jeff-engineers/dustgate/docs/tool-sensing-rfc.md

# Tool sensing & collector switching — design doc

**Status:** decided 2026-09-03, **nothing bench-tested.** Sensor plugs ordered;
everything else is reasoning from datasheets and product pages, not from a meter
in this shop. Revised the same day, twice: the collector's switching hardware was
going to be a contactor we built and isn't (§4.2, §13), and the remote's band,
encoder, address and button count are now known rather than assumed (§4.2).
**Covers:** how the firmware learns a tool is running, and how the collector is
switched, now that a smart plug can do neither for a large machine.
**Companion docs:** [`outlet-discovery-provisioning.md`](outlet-discovery-provisioning.md)
(the Shelly discovery/claim path this extends), [`shop-schema-rfc.md`](shop-schema-rfc.md)
§7 (collector health), [`architecture-rfc.md`](architecture-rfc.md) (the node contract).
Any API/model surface added here goes through the canonical-model + conformance
discipline in [`../shared/device-model/README.md`](../shared/device-model/README.md).

---

## 1. Motivation

A 1HP 120V dust collector trips the overpower protection on a Shelly Plus Plug
US. That is not an edge case — it is the *first* real machine this system was
pointed at, and every other large tool in the shop will do the same. The plug
has been the only sensor and the only switch since v1, so a plug that cannot
hold a motor invalidates both halves of the design at once.

## 2. What actually broke

Worth being precise, because the obvious diagnosis leads to the wrong fix.

The Plus Plug US is rated 15A / 1800W. **MEASURED 2026-09-09 with an inrush
clamp meter: 10 A running, ~50 A inrush.** (This section said "roughly 13A" until
then — a guess, and pessimistic.)

So 10 A continuous is comfortably inside the plug's rating, not the marginal
figure the guess implied. What trips it is **inrush**: 50 A is 5× the running
current and **3.3× the plug's entire rating**, for a few hundred milliseconds at
startup. That is locked-rotor current, and it is textbook for an induction
motor.

The overpower protection that catches this exists to protect **the relay
contacts**. Contacts are the fragile part of a smart plug: they arc on make,
they erode, and making into locked-rotor current welds them. The trip is the
device defending its own weakest component.

Two consequences follow, and both are load-bearing for everything below:

- **Disabling the protection in the app is not a fix.** It silences the
  complaint and leaves the contacts making into inrush anyway. It trades a
  visible failure for a slow invisible one.
- **A bigger plug is not the fix either.** Any relay in the sense path has the
  same problem in a larger size. The relay is the problem, not its rating.

## 3. The central decision: sensing is not switching

A tool has its own switch. DustGate never needed to turn a tool on — it only
ever needed to know *"is this drawing power."* The collector is the opposite: it
must actually be commanded, and nobody needs to sense it to decide routing.

**And for a tool, not switching is a SAFETY rule, not a convenience** (added
2026-09-09; the paragraph above was the whole argument until then, and it is the
weak version). A tool switched off at the OUTLET with its own switch left ON is
armed. Energise that outlet — remotely, on a schedule, by tapping the wrong row
in an app — and a table saw spins up with nobody's hand on it, possibly mid
blade-change. No-volt-release switches and magnetic starters exist precisely to
prevent that, and a switchable smart outlet hands it back.

So the preference for a no-relay plug is not only about inrush and cost. **It
structurally cannot start a tool** — not "will not", cannot — and that is the
property worth buying. It also cannot weld its contacts shut on a stalled tool
drawing locked-rotor current continuously, which is the failure inrush ratings
do not cover.

These were fused only because a smart plug happened to do both. Separating them
costs nothing and dissolves the problem:

| Role | Needs | Relay in the load path? |
|---|---|---|
| Tool | sense only | **no** |
| Collector | switch, plus confirmation it started | yes — but not one we own |

The canonical model already anticipated this. A tool carries `sensor.outlet`
and a collector carries `control.outlet`
([`topology.js:325`](../shared/device-model/topology.js), read by `outletFor()`
at `:333`). The split described here needs **no schema change** — only a second
kind of thing that can sit in `sensor`.

## 4. Hardware

### 4.1 Tools

| Tool | Device | ~Cost | Why |
|---|---|---|---|
| Small, corded (<10A) | Shelly Plus Plug US | $25 | Unchanged. Works today, already discovered and claimed. |
| Large, corded 120V | **Athom "No Relay Power Monitoring US Plug", Tasmota build** | **$13** | Pass-through only. 16A, 100–240V, HLW8032 metering, ESP8285. No contacts, so nothing to arc, weld, or trip. |
| 240V, or hardwired | **Split-core CT into our own ESP32, at the tool** | ~$15 | See §5. |

**Take the Tasmota build, not the ESPHome one.** Tasmota answers
`GET /cm?cmnd=Status%208` with plain JSON (`StatusSNS.ENERGY.Power`), which the
firmware can poll with the same machinery it already points at Shelly. ESPHome's
native API is protobuf and would have to be hand-rolled on the ESP32 for no gain.

Known limits of the Athom plug, stated plainly:

- **16A is its global rating; the US body is a NEMA 5-15**, a 15A device. A 13A
  continuous draw is inside spec and will run warm. This is not a licence to
  hang a 3HP collector off one.
- **Cord-connected only** — no help for a hardwired machine.
- **Certification is an open question.** Athom is a small vendor. Fine for this
  shop; a real question if DustGate ever *recommends* hardware to strangers
  running 13A through it continuously.

### 4.2 The collector — the switch already exists

**The contactor build described in the first draft of this document is not
happening, and that is the most valuable outcome of the day.** A commercial dust
collector remote is exactly the object we were about to fabricate: a mains-rated
relay in a listed enclosure, with a wireless input and someone else owning the
liability. There is already one in the shop.

[Rockler Dust Collector Remote Switch](https://www.rockler.com/rockler-dust-collector-remote-switch):

| | |
|---|---|
| Rating | **15A, 110V, up to 1.5HP** — measured collector: 10 A running, 50 A inrush, so it fits with room |
| Install | Plug-in pass-through, 6' grounded cord |
| Remote | 12V "23A" battery, ~50 ft, through walls |
| Pairing | **8-position DIP switch** in both fob and receiver |

This deletes roughly $105 of parts and an afternoon of mains wiring.

**It is RF, not IR.** Shop dust collector remotes are near-universally
315/433MHz; the IR assumption that opened this line of thinking was wrong.
Convenient, since RF needs no line of sight to a receiver bolted behind a
collector.

#### Driving it

Eight DIP positions in *both* halves means a fixed-code encoder. Read off the
hardware 2026-09-03, so none of this is inference any more:

| | |
|---|---|
| Band | **315 MHz** — FCC ID `VFWPD5T`, JYH CHENG ELECTRONICS, Part 15.231, grant reads 315.0–315.0 |
| Encoder | **HT12E** — 12 bits, 8 address (A0–A7) + 4 data (AD8–AD11) |
| Address DIP | rockers **1, 6, 8 on**, rest off |
| Buttons | **one** |

**KEYED ON THE BENCH 2026-09-06 — the first verified thing in this document.**
An HT12E of our own, address strapped to match, switched a lamp through the
Rockler receiver. What that settles, and the two things that were not obvious:

| | |
|---|---|
| Rosc | **1.0 MΩ at 3.3 V → ~3.5 kHz measured**, and it works. Holtek's ~3 kHz is a *reference point*, not a requirement — the HT12D's capture window is wider than the datasheet's example implies. An earlier draft of this section treated 2.4–3.6 kHz as pass/fail; it is not. |
| Data word | **`data 14`** (`0b1110`) — **AD8 low; AD9, AD10 and AD11 are all don't-cares.** A full 16-value sweep keys on every EVEN value (0,2,4,6,8,10,12,14) and nothing odd, which is exactly "bit 0 clear". One button, one pin. 14 leaves the other three open, so it is what the fob actually sends. <br><br>One guess died here properly: that the receiver toggled on VT and ignored the data bits entirely. `data 15` does nothing, so it does not. (An intermediate reading suggested AD8 **and** AD9 were both needed; the operator thinks that was a mistype, and the full sweep does not support it. Recorded only so the number is not re-derived from a half-remembered result.) |
| **TE hold** | **≥ ~500 ms. This is the one that bites.** 120 ms keyed the receiver only intermittently while the fob was rock solid. Four words is the HT12E's documented *minimum* transmission because the decoder validates by seeing the same frame more than once — so a truncated group produces **no output rather than a wrong one**, which is indistinguishable from a range problem. Default is now 400 ms; 500 is proven. |
| Antenna | **Not needed at bench range** — an unfitted module radiates plenty across a bench, which is its own trap in the other direction. Fit the 23.8 cm quarter-wave at install. |

### 4.2a How we press the button: a servo, not electronics (2026-09-10)

**Preferred, not exclusive. HT12E injection below stays a LIVE option.** For a
shipped product the collector's fob gets pressed by a **servo arm on a printed
fixture** — the same PWM servo this project already drives for every gate.

The argument that settles it is not elegance, and not cost. It is that **every
electronic option ends at "open the fob and solder across the button"**, and
**woodworkers are not likely to know how to solder.** That is true of the HT12E
injection path, and equally true of the tidy $11.83 alternative
([Athom 1CH Inching/Self-lock Relay](https://www.athom.tech/blank-1/1ch-inching-self-lock-relay)
— dry contact, Tasmota pre-flashed, sold for exactly this job). A servo ends at
*clip the fob into the holder, plug the servo into the labelled port*.

**This is the same constraint that already killed panel-side CTs (§5), and it
should be stated once rather than rediscovered per subsystem:**

> **An install step the owner cannot perform is not a cheaper option, it is a
> different product.** Panel work fails it because it needs an electrician and
> voids insurance; soldering inside a fob fails it because most woodworkers do
> not solder. Cost and elegance are ranked BELOW this, not against it.

What the servo buys beyond that:

- **No new device.** A tapper is one more channel on hardware already shipping.
  The relay would be another Tasmota to discover, claim, power and keep on WiFi
  — the whole §12 apparatus, for one button.
- **The fob is untouched.** Not opened, not modified, fully reversible, and it
  stays a certified transmitter operated exactly as designed. That also retires
  the 315 MHz emissions problem §11 raises for shipping a product with our own
  transmitter, rather than working around it.
- **It is legible.** You can watch it press the button. A user can diagnose it by
  looking, which nothing else on the control path offers.

**Where it lives: the collector node, and it has to.** `SERVO_COUNT` is 4, so a
tapper consumes a gate channel — and a slider board has NO PWM channels at all,
because PWM and the serial bus never share a board (CLAUDE.md). So it cannot go
on whichever board happens to be nearest. It belongs on the board already beside
the collector: the one carrying the bin sensor, which CLAUDE.md already frames as
*a capability, not a node type*. The fob-tapper is a second capability on that
same board.

**What it does NOT fix, and must not be read as fixing:**

- **A press is still a TOGGLE.** Mechanically pressing a button is exactly as
  stateless as transmitting a frame. The firmware still cannot know the
  collector's state from what it sent, so **feedback remains mandatory** — this
  changes the sending end only.
- **The fob battery becomes a system dependency.** True of the relay too, but now
  a dead battery presents as a dead servo. The collector's own wattage feedback
  is what tells them apart, which is another thing the loop buys.

**New failure mode:** an arm that drifts, or a fob that shifts in its fixture,
misses the press — and a missed press on a toggle inverts our belief
permanently. Wants a printed fixture holding fob and servo rigidly against each
other, which this project already builds parts of that kind. Feedback catches
the inversion; the fixture is what stops it happening.

**Why HT12E stays live (Jeff, 2026-09-10).** The no-soldering rule is about what
a CUSTOMER must do, and it does not rule the electronics out — it rules out
making the customer do the work:

- **Jeff's own shop is not the product.** Soldering is no obstacle here, and the
  RF path is already proven end to end — address, data word, hold, oscillator,
  range, all measured in `firmware/bench/ht12e_bench.cpp`. Holding back a working
  path on a constraint that binds someone else would be a strange trade.
- **A factory can solder.** Shipping a pre-modified fob, or a small harness that
  plugs into one, satisfies §4.2a's rule completely — the install step becomes
  "plug this in". That converts the whole objection into a BOM decision rather
  than a design one.
- **Some collectors have no fob to press.** A servo needs a button and a place to
  clamp. RF needs neither, and a collector whose receiver we can address but
  whose remote is lost, integrated or absent has no mechanical option at all.
- **The two fail differently.** A servo misses a press when its arm drifts or the
  fob shifts; an RF frame misses when it is out of range or stepped on. Neither
  failure implies the other, so having both is genuine redundancy rather than
  duplication.

So: build the servo path first because it is what ships, and keep the RF driver
(§8) on the list rather than striking it. Both drive the same seam — whatever
sends the toggle is behind one interface — and the feedback loop is identical
either way, since both are stateless.

### 4.2c Skip the remote: actuate the collector's OWN switch (2026-09-11)

Jeff's, and it is better than the fob for the case that matters — a servo on the
dust collector's own paddle or toggle, instead of on a handheld remote.

**It is allowed.** §3's hard line is *never a tool's own power switch*. The
collector is the one thing DustGate is permitted to command, so its switch is
fair game in a way a table saw's never is. (That distinction is the whole reason
the line is drawn where it is; see §4.2b's "where it does NOT go".)

**Where it wins outright is a MAINTAINED switch** — a paddle, a toggle, a rocker.
That is the best row in §4.2b's table: a servo sets a POSITION, not an edge. It
is idempotent, a missed command self-corrects, and the switch's own physical
position becomes a truthful, human-readable display of what the system believes.

And it removes three dependencies at once that the fob path carries:

- **No fob battery.** §4.2a records that the battery becomes a system
  dependency, and that a flat one presents as a dead servo. Gone.
- **No RF at all** — no address, no DIP-matching screen (`docs/mockups/
  rf-address.html`), and none of §11's 315 MHz certification question.
- **No Rockler box.** Which is the sharpest consequence, so state it plainly:
  **a servo on the collector's switch and a receiver in the cord are mutually
  exclusive.** If the receiver is plugged between wall and machine, the
  collector's own switch has to stay ON for the receiver to control anything. It
  is one or the other, never both — and choosing this one deletes a $40 device
  from the chain.

#### What decides whether it works on a given machine

**FORCE, and this breaks an assumption made yesterday.** §6.2 and the collector
board's pin notes assume **9 g servos** for the fob-presser, on the reasoning
that a fob button is a light spring and a press is not a stall. A collector's
paddle is not a fob button: it is a real mechanical switch with a detent, and a
magnetic starter's button is deliberately firm. **That is metal-gear territory,
the same servo class the gates use** — which changes the current budget in
`firmware/WIRING.md#9-bin-sensor` §6 and may change which isolated converter
that section recommends. **Unmeasured.** Measure the switch before choosing a
servo, not after.

**SWITCH TYPE.** Three cases, and they are not equally good:

| | |
|---|---|
| **Paddle / toggle** (maintained) | The good case. Absolute, self-correcting, legible |
| **Magnetic starter, momentary start/stop** | Two servos, discrete buttons — still idempotent, still good (§4.2b) |
| **A single momentary toggle** | Same stateless problem as the fob. No better than RF |

**NO-VOLT RELEASE.** An NVR switch is designed so the machine stays off after a
power cut until a person presses start. A servo pressing it defeats that by
design. Arguably we already do — automatic collector start IS the product, and
the Rockler receiver defeats it the same way — but it should be recorded rather
than discovered. A collector is a far milder hazard than the tools NVR was
invented for, which is the reason this is acceptable here and would not be on a
saw. It is also a reason the STOP button matters: whatever presses start must be
able to press stop.

**REACH.** Plenty of collectors put the switch under the motor or around the
back, where a bracket cannot easily bolt to anything rigid. §4.2b's warning
applies doubly: fixture and switch must be rigid *relative to each other*, and a
shop vibrates.

#### Where this leaves the three paths

Nothing is retired. They answer different machines:

| Path | Best for |
|---|---|
| **Servo on the collector's own switch** | A maintained paddle or toggle within reach. The best case available |
| **Servo on the fob** (§4.2a) | A switch that cannot be reached or moved, but a remote that can |
| **RF injection** (§4.2) | No fob to press, no switch to reach, or a shop where the receiver is already the install |

The first is now the one to aim at, and the one that needs a torque measurement
before anything else.

### 4.2b Mechanical actuation, as a general technique (2026-09-10)

The fob-tapper is one instance of something broader, and it is worth stating on
its own because the next "how do we command a device we did not build" question
should start here rather than at a soldering iron.

**When you need to operate equipment you do not own the electronics of, moving
its existing control is often better than interfacing with its circuitry.**

#### Why it keeps winning

- **Nothing is modified.** No opening, no soldering, no cut traces. The device
  stays certified, stays under warranty, stays insurable, and the whole
  installation is reversible by unclipping a bracket. Every electrical approach
  gives up all four.
- **No reverse engineering.** The HT12E path needed the encoder identified, the
  address rockers read, the data word found by sweep, the hold time measured and
  the oscillator characterised — and got the data word wrong twice on the way.
  A servo needs to know where the button is.
- **It works on the inaccessible.** Potted assemblies, proprietary boards, sealed
  remotes, anything with no exposed contact to reach. A physical control is
  exposed by definition — that is what makes it a control.
- **The install is mechanical, and so is the audience.** A woodworker cannot
  reasonably be asked to solder (§4.2a) but can absolutely be asked to bolt a
  bracket square to a switch. This project already ships printed mechanical
  parts and a rack-and-pinion drive; brackets are the house competency, not a
  new one.
- **It is inspectable.** You can watch it work, and see afterwards whether it
  did. Nothing on an electrical control path offers that.
- **It costs a servo channel**, on boards that already drive servos.

#### The property that actually matters: maintained vs momentary

**This is the part that generalises furthest, and it is easy to miss.**

A servo can only be as stateful as the control it moves:

| The control | What a servo gives you | State |
|---|---|---|
| **Momentary TOGGLE** — one button that alternates | A press | **Stateless, and the worst case.** Same as an RF frame: you know what you sent, never what resulted. A missed or doubled press inverts our belief permanently, so feedback is mandatory |
| **Momentary DISCRETE** — separate ON and OFF buttons | A press, to a **known destination** | **Idempotent.** Pressing ON twice leaves it on. Stateless to SEND, absolute in MEANING — a missed press is self-correcting on the next one |
| **Maintained** — a paddle, rocker, lever | A POSITION | **Absolute, and legible.** Same idempotence, plus the control's own position is a truthful display of what the system believes |

**The Rockler fob is the worst row.** One button, alternating — which is why the
collector's loop needs feedback at all. That is a property of the fob, not of
this technique, and the other two rows escape it.

Rows 2 and 3 reach a better position than any electrical option available to us.
A collector with a paddle switch, or a remote with separate on/off buttons, has
**no toggle problem**: the firmware commands a state rather than an edge, and a
missed or doubled command corrects itself. Feedback becomes confirmation rather
than the only source of truth.

So when there is a choice of control to actuate, **prefer a discrete or
maintained one**, even if the toggle is easier to reach.

#### Multi-button fobs, and what they open up

Jeff, 2026-09-10: plenty of shop equipment ships a remote with **separate on/off
and several power settings** — a
[WEN 3410 air filtration system](https://wenproducts.com/collections/dust-management/products/air-filtration-system-item-3410)
has power, three fan speeds (300/350/400 CFM) and a timer, all from one fob.

That is row 2, and it changes what mechanical actuation is FOR. It stops being
"a way to press the button we already press by hand" and becomes **a general
control surface for shop equipment DustGate does not otherwise speak to.**

Costs and shapes, unresolved:

- **A button per servo, or a servo that travels.** One servo per button is
  simple and eats channels fast — `SERVO_COUNT` is 4, and power + three speeds is
  already four. A single arm that moves between buttons is one channel and a
  harder mechanism, and it has to know where it is (the same datum problem the
  slider has, at a much smaller scale).
- **An air cleaner is not a dust collector**, and the model has no room for it.
  It belongs to no gate, routes no air we switch, and its useful behaviour is
  different in kind: run while anything is cutting, and **keep running long
  after** — airborne dust settles over tens of minutes, where a duct clears in
  seconds. That is a coast measured against a different clock than
  `offDelayMs`.
- **Speeds are a policy question we have not asked.** Low while one tool runs,
  high after a sanding session? Nothing in the shop model expresses "how dirty
  is the air", and the honest first version is probably one speed, chosen once.

**Not scoped, and not blocking anything.** Recorded because it is the first
sign that the fob-tapper is a platform rather than a fix, and because the
discrete-button property in row 2 is worth having found before designing around
the Rockler's toggle.

#### Where it does NOT go, and this is a hard line

**Never on a tool's own power switch.** §3's safety rule is about the hazard of a
tool being energised with nobody's hand on it, and a servo that can throw a table
saw's start switch IS that hazard, built deliberately. The fact that it is
mechanical rather than electrical makes it worse, not better: it defeats the
no-volt-release behaviour a switch may have been chosen to provide.

Mechanical actuation is scoped to **the collector, and equipment of that kind** —
things DustGate is allowed to command at all. It is not a loophole in "sensing is
not switching"; it is another way of doing the one bit of switching that was
always permitted.

#### The honest costs

- **A bracket is per-device.** A fob holder does not fit a paddle switch, and one
  brand's remote does not fit another's. This does not produce one SKU; it
  produces a family, or a parametric model and a printer.
- **Force.** A hobby servo has limited torque, and an industrial paddle switch or
  a stiff magnetic starter may exceed it. Measure before committing to a servo
  class.
- **Alignment is now a failure mode.** An arm that drifts, or a device that shifts
  under vibration — and a woodworking shop vibrates — misses the actuation. On a
  momentary control that inverts the system's belief; on a maintained one it just
  fails to arrive, which is another argument for the maintained kind.
- **It is visible and reachable, which means it is also bumpable.** A human can
  move a maintained switch the servo is holding. That is a feature (manual
  override with no UI at all) and a hazard (the system's model goes stale), and
  it is a third reason the collector's state must be sensed rather than assumed.

### The encoder comes out (2026-09-06)

**An RMT-generated frame keys the receiver, with no HT12E in the circuit.** The
ESP32 clocks the waveform out of hardware straight into the transmitter's data
pin. That drops the encoder, the address DIP and the oscillator resistor from the
BOM, and — the actual prize — **makes the address a software value**, so one
board works with any receiver without a jumper to set or document.

RMT is what makes it viable. Option B was rejected earlier because bit-banging
270 µs pulses on a primary running WiFi means FreeRTOS stretches one and the
command is silently lost. RMT clocks the train out in hardware; nothing the CPU
does afterwards can disturb it.

**The tick turns out to be nearly a free parameter, and that was a surprise.** A
sweep found **85 µs to at least 400 µs all work** — a 5:1 window. The reason is
that an HT12D does *ratio* detection: each bit is 1:2 or 2:1 within itself, so
the decoder compares the two halves of a symbol and never needs to know the rate.
The 50:1 fOSC rule is an oversampling requirement, not a matched-frequency one.

That retires a whole thread of anxiety. It is why 1.0 MΩ giving 3.5 kHz instead
of Holtek's nominal 3.0 never caused trouble, and why copying the fob's resistor
would have been solving a non-problem.

**Settled values: tick 270 µs, 24 repeats.** 270 is the middle of the proven
range and is what real HT12E parts produce; 24 repeats is ~473 ms of airtime,
which lands on the 500 ms that was independently proven with the encoder. Those
two numbers agreeing from opposite directions is the useful part — **reliability
is about total airtime, not tick length.** The decoder needs to see the same code
several times, and that is the only timing constraint that ever mattered.

The receiver is genuinely decoding, not detecting carrier: `data 15` and every
odd value still fail. A receiver that toggled on any 315 MHz energy would be a
hazard, and this one is not.

**Range is solved, and more cheaply than expected (2026-09-06).** ~40 ft through
several interior walls, at **3.3 V, with nothing in the ANT pad** — near the
50 ft Rockler claims for the fob, which runs at 12 V.

So the 12 V supply and the quarter-wave wire recommended earlier are **headroom,
not requirements**, and this document previously said otherwise. The breakout
drops to **three pins: 3.3 V, GND, DATA** — one rail, no level shifting, no
antenna.

There is a case for leaving it that way rather than banking the headroom. At
315 MHz with an 8-bit fixed code, extra range is extra opportunity to key a
neighbour's gear or be keyed by theirs, and 40 ft already covers the shop.

**Still to check:** a house is a kinder RF environment than a shop. The receiver
will sit beside a large grounded steel collector, and a universal motor's brushes
are a broadband noise source. The test that counts is at the install location
with the collector running.

**Design consequence: do not block for 500 ms.** `setSwitch()` on a primary
cannot sit in a busy wait that long — it would stall the web server and the
servo update pass for half a second on every collector change. Assert TE, record
the time, release it on a later loop pass. The hold is a duration to *schedule*,
not to *wait out*, and that is a nicer shape anyway: it composes with the
read-compare-pulse loop the toggle already forces on us.

No rolling code, no pairing handshake — the fob sends the same word every time.
Two paths:

- **A — tap the fob.** Two wires across the button, driven from a GPIO through
  an optocoupler. No RF knowledge required; guaranteed to work. Leaves a coin
  cell in the control loop forever.
- **B — transmit the code ourselves.** A ~$2 315MHz module on the primary plus
  `RCSwitch`; capture the code once with the matching receiver. No fob, no
  battery, nothing soldered into a thing we might destroy.

  **HT12E is `RCSwitch` protocol 11** — `{ 270, { 36, 1 }, { 1, 2 }, { 2, 1 },
  true }`. So `setProtocol(11)` and both capture and transmit are library calls;
  this is not a reverse-engineering project. HT12E emits a 4-word burst while TE
  is held low, so keep the default repeat rather than sending once.

  **The DIP setting is a free correctness check.** The DIP grounds an address
  pin to set it, and Holtek's documented usage is "set to VSS or left open", so
  ON = 0 and rockers 1/6/8 should decode as `0,1,1,1,1,0,1,0`. A capture whose top 8 bits disagree was decoded with the
  wrong protocol, whatever else it looks like. That check is worth more than the
  capture.

  **Brute force is a real fallback, not a threat.** A word is ~20 ms and a burst
  ~80 ms, so the entire 12-bit space is 4096 x 80 ms — **under six minutes** of
  listening for the relay to click. Knowing the address cuts it to ~64 tries.
  There is no way to get stuck here.

- **C — use the same chip.** An HT12E of our own ($1, DIP-18) driving a 315MHz
  module, with its address pins strapped to match the fob. The ESP32 then does
  nothing but pull TE low for ~100 ms.

**C is preferred.** B looked best while the argument was "RCSwitch makes it
trivial", and it does — but two things outweigh that:

- **Timing.** RCSwitch bit-bangs 270µs pulses with `delayMicroseconds()`, and
  the transmitter would be **the primary** — running WiFi, the web server,
  NodeLink and Shelly polling. The WiFi stack and FreeRTOS will preempt that
  loop, and a stretched pulse is a dropped command: a well-known ESP32 failure
  mode, and an intermittent one, which is the expensive kind. With a real HT12E
  the entire timing obligation is holding a pin low, which nothing can jitter.
- **It deletes a whole unknown.** §10 lists "does protocol 11 match *this*
  HT12E's timing" as unverified. Using the same part makes the question
  meaningless. We are not reimplementing the protocol; we are using the chip
  that defines it. There is no capture step either — the receiver module drops
  to optional debugging kit.

Two things C needs that B does not:

- **The oscillator resistor.** HT12E sets its data rate from an external R
  across OSC1/OSC2, and the HT12D in the receiver has its own; the datasheet's
  recommendation is `fOSC(D) ≈ 50 × fOSC(E)`. Wrong value, silent failure.
  **Target the frequency, not the fob's resistor** — the fob runs on a 12V cell
  and fOSC depends on VDD, so copying its resistor while running at 5V lands
  ~15–20% low (see the Oscillator Frequency vs. Supply Voltage curve, datasheet
  p9). Holtek's reference point is **ROSC = 1.1 MΩ at VDD = 5V → 3 kHz**,
  which with the 50× rule is the standard 3k/150k pairing the receiver was
  almost certainly designed around. **But run the chip at 3.3V, not 5V** (next
  bullet), where the curve puts **1.0 MΩ** at roughly that same 3 kHz — and
  1.0 M is E12, so it is in any kit. That is an eyeball off a small graph;
  measure fOSC on OSC2 and adjust, which is what the bench meter's frequency
  counter is for. The part is spec'd to need "only a 5% resistor", so the window
  is forgiving. Datasheet at `~/code/Datasheets/ht12e-holtek.pdf`; p9 carries
  both the curve and Holtek's HT12E application circuit, which is this build
  drawn out.
- **Supply voltage, and why it is 3.3V.** At 5V the HT12E's VIH is 0.8 × VDD =
  **4.0V**, so a C5 GPIO driving TE high at 3.3V is not a valid logic high. The
  failure looks like intermittent or continuous transmission, and the RF gets
  blamed for it. At 3.3V, VIH is 2.64V and nothing needs level shifting.
  (Open-drain works too — drive low to send, set the pin to input and let the
  internal 1.5 MΩ pull-up idle it high — but 3.3V is simpler.) The chip is rated
  2.4–12V. Power the **TX module** at 5V for range and feed it 3.3V data;
  standard wiring, and it works. The fob itself runs at 12V, which is the other
  half of why its resistor is not ours.
- **Which data pin.** One button means the fob asserts one of AD8–AD11. Trace it
  on the fob, or try all four.

Address straps want an **8-position SPST DIP switch** (DIP-16 body, 2.54 mm
pitch — the same part the fob uses), one side commoned to GND. **Closed = VSS =
0, open = 1** — note that on the HT12E these pins have *no* internal pull-up
(that is the HT12A; on the HT12E, A0–A7 and AD8–AD11 are transmission gates with
protection diodes only), but "set to VSS or left open" is Holtek's own documented
usage, so floating is by design and not sloppiness. `TE` *does* have a pull-high
(~1.5 MΩ), so it idles high and needs no external resistor — the ESP32 only ever
pulls it down. A 4-position DIP for the data pins is worth having beside it.

Keep A alive rather than treating it as a fallback: it is the only variant that
transmits from a **certified** device, which matters if this is ever more than
one shop (§11). Note the Rockler replacement fob is $29.99, so sacrificing a
spare is not the cheap move it sounds like.

If it ever needs to be one board with no through-hole part, the middle path is
the ESP32's **RMT peripheral** — hardware-generated pulse trains, immune to
preemption, no extra chip, at the cost of reimplementing HT12E's encoding after
all. That is the productised version; C is the right answer for the bench.

The collector's switching hardware is then **about $4 of parts on a board we
already have.**

#### The feedback is no longer optional

**Confirmed: one button.** Absolute state cannot be commanded, only flipped, and
drift is not cosmetic here. Under the never-dead-head rule, gates move on the
assumption that the collector is in a known state. Believing it is off while it
runs is a real hazard.

An Athom no-relay plug **upstream of the receiver box** closes the loop:

```
want ON → read watts → already running? done. → not running? pulse.
```

Toggle-only plus feedback gives absolute control. Toggle-only alone is
unusable. So the monitor moves from "nice to have" to **required**, and it is
the only thing that has to be bought for the collector.

**And that makes the sense plug load-bearing for the control path, not just for
health reporting.** With the plug offline, the firmware cannot know which way a
pulse will flip the collector, so it cannot safely send one — a fault case that
deserves handling deliberately rather than discovering. Contrast the Shelly
collector plug, where an unreachable plug degrades reporting to `'unknown'` but
leaves commanding intact.

**Upstream, not on the load side.** `COLLECTOR_SPINUP_GRACE_MS` is 4000 ms; a
plug downstream of the receiver only gets power when the collector is commanded
on, and would spend 2–5 s of that budget booting and joining WiFi before it
could report anything. Upstream it is permanently powered and still reads the
motor, because it is in series with everything below it. The receiver's own
draw plus the plug's is well under `COLLECTOR_RUNNING_W` (50 W), so idle reads
as off.

#### The ceiling

15A / 1.5HP. That covers the current collector with margin. **Above 1.5HP this
box is out and the contactor build comes back** — it is preserved in §13 rather
than deleted for exactly that reason.

### 4.3 Direction: Shelly for collectors, Tasmota for tools (2026-09-09)

Jeff, leaning: **stop allowing Shelly on tools entirely**, keep it for collectors
where switching is the job — a small or medium collector with a relay big enough
for its inrush is a legitimate use, and §3's safety argument does not apply to a
blower the way it applies to a table saw.

The schema already encodes half of this: a `tasmota` under a collector's
`control.outlet` is a validation error, because a plug with no relay cannot
switch. **The mirror rule is `shelly` under a tool's `sensor.outlet`**, and it
can become a hard error the same way — but not yet, because every layout written
so far has Shellys on tools and there is no migration path. Deprecate first,
enforce after.

**Not before Tasmota is proven.** Jeff has one plug and wants confidence before
buying a shop's worth. What "proven" means, concretely:

| | |
|---|---|
| **Polling load** | **The one to watch.** See below — it is the risk this whole direction rests on |
| A real session | Drives a real tool for a full session without dropping out or missing a start |
| Threshold behaviour | No false trips on standby, no missed starts. The measured plug reports 26 W idle on a massager — a real tool's standby is what matters |
| Power cycle | Survives one, and reconnects to WiFi without help |
| The claim persists | `Mem1` still holds our hostname afterwards |
| Thermal | Warm, not hot, at the tool's actual current over a long cut |

#### The polling load, which §6 did not account for

**A Shelly pushes. A Tasmota cannot.** `Ws.SetConfig` points a Shelly at us and it
reports itself — that is why `readPushConfig()` is the ownership authority in the
first place. Tasmota has no equivalent, so every Tasmota is **polled at
`OUTLET_POLL_INTERVAL_MS` (500 ms), permanently**.

At `SMART_OUTLET_COUNT` = 7 that is **14 requests/second** leaving the ESP32, and
**2 req/s arriving at each ESP8285**, forever, for the life of the shop.

§6 argued for one driver rather than two and that argument still holds — but it
was about the DRIVER, and losing push changes the TRAFFIC PROFILE, which is a
different thing entirely. Unmeasured. If it does not hold up, the fix is a
slower cadence for `kind: tasmota` specifically: a tool starting is not a
500 ms-latency event, and the collector's own spin-up grace is already 4 s.

That would make the poll interval kind-dependent, which is a small change and an
honest one — the two device types have genuinely different economics.

## 5. The 240V / hardwired sensor

240V single-phase in the US is two hots and no neutral, with the motor in series
between them — so the same current flows in both legs and **one CT on one leg
reads the whole machine.** No summing, no second channel.

**At the tool, never at the panel.** Panel-side CTs are cheaper per circuit
(an Emporia Vue at ~$12/circuit, ESPHome-flashable for local operation) and were
considered and rejected: touching the panel at all, even non-intrusively, is an
insurance question this project will not create for its users. That is settled,
and it is not a cost decision. Clamp inside the tool's own motor wiring
compartment, or the receptacle box behind it — premises wiring stays untouched.

### 5.1 Keep the enclosure low-voltage

A NEMA 6-20/6-30 has no neutral, so there is no 120V at the tool. The tempting
move is an AC-DC module (HLK-PM01 takes 100–265VAC) inside the box. **Don't.**

Power the ESP32 from a USB brick in a nearby 120V outlet instead. A CT is
galvanically isolated by design, so the enclosure then holds a sensor lead, an
ESP32, and 5V — **nothing we build touches mains at all.** That is a materially
different object, for certification, for insurance, and for a user opening it.

This stays the PRODUCT rule, and **§5.6 knowingly departs from it** for the bench
build in Jeff's own shop — tapping the tool's own supply buys properties a USB
brick cannot, and it is a listed supply doing what it is listed for. Read §5.6
before citing this paragraph as settled for every case. One correction to the
reasoning above, though, which stands on its own: the "no neutral" part is a
non-problem. It constrains non-isolated droppers, which reference N; an isolated
module wants two points 240 V apart, and L1–L2 is two points 240 V apart.

### 5.2 Parts

- **SCT-013-030 specifically, not the SCT-013-000.** The -030 has its burden
  resistor and a TVS built in, so an accidentally unplugged connector cannot
  develop dangerous voltage on the secondary. The -000 can. That safety margin
  is worth more than the convenience of choosing our own burden. 30A covers up
  to roughly a 5HP 240V tool.
- Confirm the listing says **30A/1V** — the 30A/1A variants are the
  burden-less ones and defeat the point above.
- The jaw is 13 mm. Fine for a 12AWG conductor or a 14/3 cord, not for anything
  fatter.
- It ships with a 3.5 mm plug. Cut it off and use the bare leads.
- Bias network: **2× 1k** from 3.3V/GND for a midpoint, a bulk cap to ground, a
  **100nF ceramic at the ADC pin**, CT across the midpoint and the ADC pin.

  **1k, not the 10k this said until 2026-09-14**, and that is §5.5's own
  diagnosis finally applied: 10k/10k presents 5 kΩ at the pin, the SAR's
  sampling capacitor does not settle against it, and that is the floor. 1k/1k
  drops the source impedance to 500 Ω for 3.3 mA, which is nothing on a
  mains-powered node. Still unvalidated — §5.6's node is the board to prove it
  on, since it has no screen and so removes the other variable at the same time.

  **The bulk value is not critical, but the SETTLING TIME is.** R_thev = R/2,
  tau = R_thev x C, and the midpoint needs ~5 tau before any reading means
  anything:

  | | 10 µF | 100 µF |
  |---|---|---|
  | **10k/10k** (5 kΩ) | 250 ms | **2.5 s** |
  | **1k/1k** (500 Ω) | 25 ms | 250 ms |

  Nothing about 60 Hz cares — both caps are far above the corner, and more
  capacitance holds the midpoint stiffer if anything. What cares is §5.4b, which
  makes the board's own floor the thing a tool is judged against and learns it at
  boot: a floor measured mid-charge is wrong for the whole session, and wrong
  HIGH, so a running tool reads as idle. `CtSensor::kBiasSettleMs` is 3 s, sized
  for the slowest combination anyone might build rather than the one in front of
  us — and `isRailed()` cannot catch it, because a midpoint on its way up passes
  straight through the healthy band.

  A large Class II ceramic also derates hard with DC bias — a 100 µF X5R at 1.65 V
  may deliver 40–60% of its marking — so treat the number on the part as an upper
  bound, and remember those dielectrics are piezoelectric, which is a real
  consideration for a board bolted near a running machine.

### 5.3 Do not fight the clipping

The C3/C5 ADC tops out near 2.5V and a 1V-RMS CT on a mid-rail bias will clip
its peaks. **It does not matter.** `DEFAULT_THRESHOLD_W` is 5 — the question is
"is this a hundred times the noise floor", not "how many watts". Sample RMS over
a couple of line cycles, learn the idle baseline at boot, trip on a multiple. No
calibration constant, no user-facing amps, no accuracy claim to defend. A
clipped waveform still reads as unambiguously on.

### 5.4 CLOSED — clamping the whole cord does NOT work (2026-09-09)

Everything above assumes the CT goes around exactly one conductor, because hot
and neutral in an intact cord carry equal and opposite current and their fields
cancel. **That is true for measuring current and may be false for detecting
one.**

iVAC's Pro Tool Plus is a shipping product that determines whether a tool is on
"by sensing the magnetic field surrounding the cord," clamped onto an intact
cord. The residual field of an imperfectly balanced pair is evidently enough for
a threshold decision — which is all this system has ever needed.

If it held, the whole §5 install story would have collapsed to *clip it onto the
cord and open nothing*, and the 240V and hardwired cases would have stopped being
the awkward ones. That was a large enough prize to test before committing to the
split-core path.

**It does not hold. Tested 2026-09-09 (jeff): nothing discernible above noise on
an intact cord, and NOT ONLY with our rig — a bench multimeter could not see it
either.** That second half is what makes this an answer rather than another
noise-floor complaint: our own board's floor is under suspicion (§5.5), so a
null result from it alone would have proved nothing. An instrument we trust
failing the same way moves the cause from our electronics to the physics.

The residual field of a balanced pair is evidently smaller than iVAC's product
implies, or they are doing something other than a plain clamp — a specific
geometry, a much more sensitive front end, or a sensor that is not a CT at all.
Worth knowing if a cheap clip-on ever matters again; not worth chasing now.

**So the split-core path stands, and §5's install story stays as written**: a
line splitter, or one conductor exposed. The 240V and hardwired cases stay the
awkward ones.

### 5.4a What the CT actually has to achieve (2026-09-09)

Sharpened by Jeff, and it is a smaller target than §5.3 and §5.5 have been
aiming at: **"this tool is running, beyond standby" is the entire question.**
Not watts, not amps, not accuracy — one bit.

That matters because it moves the CT off the hook for the thing it is worst at.
A CT measures CURRENT; watts need voltage and power factor, which it cannot
give (the Athom reports all three, which is exactly what makes it the better
reference — see the note at the top of TasmotaOutlet.h). Absolute calibration
against an unresolved noise floor is a hard problem. **Separating a running
motor from standby is not**: even the noisy screen-on measurement had ~80×
between the two.

The consequence for the model, which §5.5 raised and this answers:
**`DEFAULT_THRESHOLD_W` is the wrong shape for a CT-sensed tool.** It is in
watts, typed by a user, and a CT cannot honour either half. The likely answer is
a **learned per-tool baseline** — measure standby once at pairing, trip at some
multiple of it — which sidesteps calibration entirely, because a ratio against
the tool's own quiet state does not care what the absolute numbers mean or what
the board's floor is.

**Jeff is gathering the data that decides it**: every tool in the shop, standby
vs running. Until that exists, the multiple is a guess, and no threshold shape
should be committed to the schema.

Note this does NOT excuse the noise in §5.5. A floor that moves with whether the
screen is drawing makes even a ratio unreliable, because the baseline learned at
pairing may be measured under different conditions than the trip.

**Superseded by §5.4b (2026-09-14)** — the survey above was never run, because
the premise it rests on turned out to be false. Read §5.4b for the answer; this
section is kept for the reasoning that got there.

### 5.4b CLOSED — there is nothing to measure at standby (2026-09-14)

§5.4a proposed a learned per-tool baseline: measure standby once at pairing,
trip at some multiple of it. **That is dead, and the survey it was waiting on is
not worth running.**

**Jeff's result: on the only tool in the shop that HAS a standby mode, standby
sits below the noise ceiling — and the same is expected of comparable tools.**
A woodworking machine's standby is a contactor coil or a DRO, and it is not a
motor. There is no ratio to learn against a quantity the instrument cannot see.

That sounds like a loss and is the opposite. It means the baseline was never the
tool's standby draw — it is **the board's own floor**, and the trip is "current,
meaningfully above that floor". One number, in firmware, the same for every tool.

The consequence for the schema is that there is no consequence: a CT-sensed tool
carries **no threshold field at all**.

> **⚠️ NARROWED BY §5.4d (2026-09-16).** True for every tool measured, and NOT
> general: a CNC router idles at stall current with a PC attached, so its "off"
> is a substantial continuous draw rather than something under the floor. The
> field comes back as an OPTIONAL `thresholdA` — absent keeping everything
> below — rather than the mandatory `thresholdW` this section rightly killed. `thresholdW` stays exactly as it is for
plug-sensed tools, where a metering plug reports genuine watts and a user-typed
number means something. §5.4a's open question does not get answered in the
schema, it gets DELETED from it. If some future tool's standby ever does poke
above the floor, that tool earns a per-tool override at that point and not
before — speculative fields are how `thresholdW` came to be the wrong shape here
in the first place.

#### 5.4c The scale REGRESSION passed, and power factor makes the case (2026-09-16)

Re-measured on the rebuilt divider, same collector, same Tasmota:

| | 2026-09-13 | 2026-09-16 |
|---|---|---|
| This CT | 10.71 A | **11.310 A** (mean of 20) |
| Tasmota | 10.610 A | **11.143 A** |
| CT reads high by | +0.94% | **+1.50%** |

**The rebuild did not move the scale.** Same direction, half a percent apart,
comfortably inside two ~1% instruments disagreeing. The collector genuinely drew
more that day — the TASMOTA moved +5% too — which is exactly why a reference
reading beside it was worth insisting on.

`rms/amps` also held at **33.7 across all twenty reads**, and amps varied only
±0.7%. That retires the one-sample scale bug ("13.100 A falling to 8.889 A on a
steady load") as a live concern: it cannot hide behind a stable rms any more.

**And the Tasmota handed over the strongest argument §5.4a has.** On that same
running collector:

    115 V · 11.143 A · 852 W active · 1286 VA apparent · PF 0.66

11.143 A x 115 V is 1281 VA, and the real power is 852 W. **A threshold in watts
against a CT-sensed motor would be 34% out on this load alone** — not as a
matter of principle but as a measured fact on the shop's own collector. A CT
reports current; watts need a voltage and a power factor it cannot give.

### 5.4d REOPENED — a tool that idles LOUDLY needs a threshold (2026-09-16)

§5.4b found that a woodworking tool's standby sits under the noise floor, so
there is nothing to threshold and the trip is "current, above the board's own
floor". **That holds for every tool measured and does not generalise.**

The counterexample, from a friend of jeff's: **a CNC router.** It holds servos at
stall current and may be powering a PC, so it draws real, continuous current
while doing nothing at all. That is not standby beneath a noise floor — it is a
substantial steady load, and a gate that opens for it leaves the collector
running all day. **The interesting signal is the step UP when it starts cutting**,
not the difference from zero.

So the shape §5.4b deleted has to come back, in a narrower form:

- **OPTIONAL, and absent stays the default.** Most tools are off or on, and the
  floor-relative trip is right for them. A threshold that every tool must carry
  would be the `thresholdW` mistake again.
- **IN AMPS, never watts** — §5.4c measured why. `sensor.ct.thresholdA`.
- **It rides CONFIG to the node**, because the node owns the decision and cannot
  see the document. That does NOT breach the invariant in `nodelink.js`: a trip
  current is a resolved NUMBER, the same kind of thing a SET's angle is, and the
  node compares rather than interprets. What would breach it is sending a state
  name or a rule.

Two things this does not settle. A per-tool figure has to come from somewhere,
and asking a woodworker for amps is a poor screen — a **learn-while-idling**
button that records the current draw and sets the trip above it is the likelier
answer. And the CNC case wants hysteresis, since a cut is not continuous;
whatever coast-down already exists on the collector may cover it, or may not.

**Not built, and DEFERRED 2026-09-16** — jeff's call, the same day it was raised:
no tool in this shop idles loudly, so nothing here blocks getting the shop
running, and a threshold is better built against a real machine than imagined.
Recorded so the next person does not read §5.4b as settled when it is settled
only for the tools in this shop.

Two things about the planer node (§5.6) make its floor better than anything
§5.5 measured, and both are accidents of the wiring rather than design:

- **Its PSU sits upstream of the tool's own switch and its clamp downstream**, so
  the board always boots with the motor off BY CONSTRUCTION. What it learns at
  boot is its own floor, in place, at temperature, in the RF environment it will
  actually trip in — which is the exact objection §5.4a raised against a baseline
  learned at pairing. Re-learning on every power-up is a feature here.
- **It has no screen**, so the one thing §5.5 observed moving the floor is not
  present on the board that most needs a stable one.

Neither of those retires §5.5. A primary with a screen still has the problem,
and this section only says the CT-sensed TOOL path stopped depending on it.

### 5.5b CLOSED — the floor is the ADC, and 1k/1k was never the problem (2026-09-16)

**§5.5 is answered, and the answer inverts how it looked at the start of the
session.** Measured on the rebuilt soldered perfboard (1k/1k + 100uF + 100nF),
collector build, laptop on battery throughout:

| Condition | Floor, rmsCounts | Floor, A |
|---|---|---|
| Primary build, screen ON | 6.68 | 0.195 |
| Primary build, screen OFF | 6.03 | 0.179 |
| Bench build — **no WiFi at all** | 5.80 | 0.173 |
| **CT shorted out** (jumper midpoint -> D0) | no discernible change | |

**Every external suspect is excluded by measurement, not argument:**

- **Mains earth** — the laptop had been on battery the whole time, so no reading
  today ever had a mains reference in the chain.
- **The radio** — the bench build has no WiFi, no web server, no mDNS, and
  measures the same floor as the full primary.
- **The screen** — 11%, where it used to be ~80% of the floor. **1k/1k DID fix
  the charge-pump coupling**, which was §5.5's other prediction.
- **The clamp, its cable and the braid** — shorting the CT out with a jumper,
  leaving D0 biased from the midpoint directly, changed nothing.

With the CT shorted, D0 sits on a hard-bypassed 500-ohm node. There is nothing
left for ~6 counts to be but **the C5's SAR ADC measuring its own noise**, which
is ordinary: effective resolution on these parts is 9-10 bits, so 4-8 LSB of RMS
noise is what the datasheet's ENOB implies.

**The 6.5 kHz "frequency" was an artifact and cost an hour of suspicion.** It
tracked the SAMPLE RATE, not the room:

| Build | Reported Hz | kSPS | Ratio |
|---|---|---|---|
| Primary, screen off | ~7250 | 29.0 | **0.250** |
| Bench | ~6450 | 25.5 | **0.253** |

A zero-crossing counter fed BROADBAND NOISE reports a fraction of Fs, not a
tone — and Fs/4 rather than Fs/2 says adjacent samples are mildly correlated,
exactly what wideband noise through the input RC looks like. There was never a
switcher to find. **Anyone reading a suspicious `Hz` on this console should
divide it by the sample rate before believing it.**

**So the old 1.8-count floor was probably the artifact, not this one.** §5.5
already half-suspected it, calling that reading "quantization-limited rather
than measured". 1k/1k did not make anything worse — it removed the screen
coupling and exposed the floor that was underneath all along.

#### What this means for the product

**No wiring change improves this**, so stop spending bench time on it. The
remaining lever is signal processing: the signal is one frequency and the noise
is spread over 12.75 kHz, so demodulating at 60 Hz (multiply by sin and cos,
average, take the magnitude) with a ~5 Hz effective bandwidth is a theoretical
50x and a realistic 10-20x after windowing and mains drift.

**Deliberately NOT built (jeff, 2026-09-16): "if we can sense a desk fan we can
sense anything cutting wood."** The numbers back that. A running 1 HP collector
measured 380.7 counts against a 6.0 floor — **63x** — and §5.4b only ever needed
one bit. The demodulator buys margin and small loads, not basic function, and it
can be written the day something needs it.

One consequence worth carrying: **a 0.5 A load is 17 counts, only 2.6x this
floor**, which is under the 4x trip ratio. A desk fan as a standing bench load
therefore needs its lead looped 3 turns through the jaw (N turns = N x apparent
current) — which needs a separated conductor, since a molded cord's fields
cancel (§5.4).

### 5.5a The SCALE is confirmed — the clamp was never the problem (2026-09-13)

**Three instruments on a running 1 HP collector, same moment:** a handheld clamp
meter at 10–11 A, a Tasmota metering plug at **10.610 A**, and this CT at
**10.71 A**. Within ~1%. `kAmpsPerVolt = 30.0f`, the bias network and the
rectifier-free RMS are all correct.

What was wrong was software: `CtSensor::read()` derived its mV-per-count from a
**single** ADC sample, which scales every amp figure linearly. On a steady load
it printed 13.100 A falling to 8.889 A while the raw `rmsCounts` held 371–375.
Fixed by averaging 64 samples, and `rmsCounts` is now a printed column so a
scale fault is visibly distinct from a changing load. **Log that column.**

Two results that bear directly on the sections around this one:

- **The noise floor is ELECTRONIC.** The `Hz` column added on 2026-09-07 to
  settle exactly this had never been read; with the load off it reads **~1055 Hz**,
  and the rule already written down says >500 Hz is electronics, not ambient
  magnetic pickup. So §5.5's line of attack is the right one and shielding is
  not. **It is NOT the screen**, which was briefly assumed and is wrong: every
  reading was taken with no OLED connected. A bench with no OLED measured under
  0.03 A on 2026-09-06 and this is ~2.2 A, so the difference came with the
  location or the setup. ~1 kHz is a **switching supply's** signature — too high
  for 60 Hz magnetic pickup, too low for RF. The laptop feeding USB is on
  battery, so there is no mains path through the ground; what is left is the
  laptop's own rails, the 12 V supply sitting beside the CT, or our front end.
- **The floor is a fixed pedestal** — ~76 counts RMS, ~2.2 A at this location —
  which is why the on-reading is stable to 1%, and RMS adds in quadrature so it
  subtracts. 2.2 A against 10.4 A is ~13 dB: enough for §5.4a's *running beyond
  standby*, not enough to tell standby from idle. **§5.4a's threshold question
  stays open**, and §5.5's complaint stands undiminished.

**Measured loads, 2026-09-13.** A 1.75 HP SawStop draws 0.043 A in standby —
**invisible to the CT, which is the right answer**, since the hazard is a false
POSITIVE and a standby 50x under the floor cannot produce one — and 4.99 A
running, ~2.3x the best floor. The collector sits at 4.6x. A **2 HP 220 V
planer, the one tool here that actually needs a CT, draws 7 A no-load: 3.1x.**

That last number briefly looked like ~2.5 A, from scaling the saw's current by
voltage at equal horsepower, which would have put it at 1:1 with the floor and
made the noise work blocking. It is a different motor, and no-load current is
magnetizing current — **it does not scale with supply voltage.** Measure, do not
extrapolate. The floor is headroom, not a blocker.

**Inrush is 4.5x to 15.6x run current** — 90 A on both the jointer and the
planer, 78 A on the saw, 45–50 A on the collector — so every tool here passes a
30 A clamp by 1.5x to 3x. **Sizing decided: protect the 30 A clamp, do not
upsize to 100 A.** A 100 A clamp gives 25 mV for a 2.5 A load where the 30 A
gives 83 mV, spending resolution at the low end to buy headroom in a region
where the reading is worthless anyway — nothing measures current during inrush,
it only has to survive it. Series R plus a Schottky clamp to the rails.

**And inrush saturates the clamp.** The collector draws **45–50 A** starting,
through a 30 A CT — clipping both ends and putting ~4 V on a 3.6 V-max pin.
`isRailed()` tests the DC mean and clipping is symmetric, so **a saturated
reading passes as healthy**; the only guard there is blind to the one failure a
motor start produces. It also supplies the missing mechanism for the Shelly Plus
Plug US trip on 2026-09-03: a 16 A relay meeting 45–50 A.

Full write-up, including the line-splitter dead end and why today's numbers came
off a hardwired install rather than a shippable one:
[`firmware/WIRING.md#8-ct-clamp`](../firmware/WIRING.md#8-ct-clamp).

### 5.5 The screen is a noise source, and every board has one

> **⚠️ ANSWERED BY §5.5b (2026-09-16), and the answer is half a vindication.**
> The 1k/1k fix below was right about the SCREEN — its share of the floor fell
> from ~80% to 11%. It was wrong that the divider was the floor: underneath sits
> the C5 ADC's own noise at ~6 counts, unchanged by shorting the CT out
> entirely. Read §5.5b before acting on anything here.

**Measured 2026-09-06, on the bench rig in `firmware/bench/ct_bench.cpp`:**

| | Apparent current on a DEAD wire |
|---|---|
| OLED connected | **~0.4 A** (≈13 mV RMS) |
| OLED unplugged | **under 1 mV RMS**, i.e. below 0.03 A — under the instrument's resolution |

`SSD1306_SWITCHCAPVCC` means the panel generates its own ~7–9 V from 3.3 V with a
switching charge pump, sharing the rail with the ADC's bias divider. `DISPLAYOFF`
stops the pump, not just the pixels, so the bench console has a `screen` toggle
and `zero` now warns when it is measuring with the panel live.

**This is structural, not a bench artifact.** Every DustGate env assumes a screen
(CLAUDE.md), the panel sits on D4/D5, and the CT's analog pad is D0 on the same
board and the same rail. A shipping board that senses current AND has a display
hits this by construction. It is the same shape of problem as the strapping-pin
error in §7.5 of the schema RFC: a pad that looked free, and was not.

**The divider I specified made it worse.** 10 kΩ/10 kΩ presents **5 kΩ** to the
ADC pin — high enough that the sampling capacitor does not fully settle, and a
fine antenna besides. The fix, unvalidated:

- **1 kΩ / 1 kΩ**, dropping the source impedance to 500 Ω. Costs 3.3 mA, which is
  nothing on USB power.
- **100 nF ceramic** at the pin alongside the bulk cap. A big bulk cap does
  nothing above a few kHz, which is exactly where a charge pump lives.

**Both are now written into §5.2 as the build, and §5.6's node is where they get
validated (2026-09-14).** That board is the right place: it has no screen, so it
removes the other half of the variable in the same change. Note that the bulk cap
is NOT the lever here — swapping 10 µF for 100 µF changes neither the source
impedance nor the floor, only the settling time (§5.2's table). The resistors are
the fix.

**Validate with the screen ON.** That is the condition that breaks it, so a quiet
reading with the panel unplugged proves nothing about a shipping board.

#### What this does to the threshold question

Unsettled, and the direction moved twice. The first measurement — screen on —
gave a 0.053 A floor and the tool declared `DEFAULT_THRESHOLD_W` (5 W = 0.042 A)
unreachable. Screen off it is under 0.03 A and 5 W is back in play, but the
number is quantization-limited rather than measured: `analogReadMilliVolts()`
returns whole millivolts, so a genuinely quiet input reads *exactly* zero and
hides everything below 0.03 A. The console now samples raw counts (~0.61 mV/LSB)
to see past that.

So the honest state: **a running tool is never in doubt** — the peak against the
floor was ~80× even on the noisy measurement — and **the low-end threshold is
still unknown**. What it settles into decides whether a CT-sensed tool can share
`DEFAULT_THRESHOLD_W` with a plug-sensed one or needs its own, which is a model
question, not just a tuning one.

### 5.6 The planer node — the first CT-sensed tool (2026-09-14; software BUILT 2026-09-15, hardware unproven)

The concrete build §5 has been circling. **Nothing here has run.**

A board at the planer with no actuators at all: a C5, one SCT-013-030 on one hot,
an indicator LED, and a Mean Well **RS-25-5** (88–264 VAC, isolated, listed).
The supply is tapped **upstream of the planer's own switch** and the clamp sits
**downstream** of it, which is the whole design in one sentence and buys three
things at once:

- **Conductor separation for free.** §5.4 killed clamping an intact cord, so the
  CT has to go where the conductors are already apart — and inside the switch
  compartment they are. No line splitter, no adapter box.
- **The node's presence tracks the tool's power.** The planer is not energised
  all the time, so the board comes and goes with it. See below.
- **A guaranteed-valid floor at boot** — §5.4b.

No neutral is needed and never was: that only constrains non-isolated droppers,
which reference N. An isolated module wants two points 240 V apart, and L1–L2 is
two points 240 V apart.

**This knowingly departs from §5.1, and §5.1 still stands as the PRODUCT rule.**
§5.1 says keep mains out of the enclosure entirely and feed the board from a USB
brick in a nearby 120 V outlet, because an object that does not touch mains is a
materially different object for certification and insurance. That is still the
right answer for anything shipped. This build takes the other road deliberately,
in Jeff's own shop, with a listed supply doing exactly what it is listed for —
and in exchange gets the tool-tracking and boot-floor properties above, which the
USB-brick version cannot have at any price. A shipped version would either find a
120 V outlet or pay for the certification; it would not pretend this is the same
object.

**One physical gotcha: RF.** A C5 inside a grounded steel switch enclosure bolted
to a cast-iron planer is a Faraday cage. The board goes in a plastic box away
from the motor, with mains and the CT lead run into it.

Inrush is not readable — it saturates the 30 A clamp and `isRailed()` cannot see
it. Irrelevant to a one-bit answer; do not build anything on starting current.

#### 5.6a Absent means off

The planer loses power regularly, so **a node that is not reporting means the
tool is off.** That is the correct default because of which way it fails: a tool
wrongly believed off means the gate does not open and the shop gets dusty, where
the opposite default runs the collector forever. Nothing about it can dead-head
anything either — idle leaves the gate where it is, so a vanished node simply
stops participating in most-recent-tool-wins.

The cost is that absent-is-off is **also what a crashed board, a dead PSU, a WiFi
dropout and a router reboot look like**, and the symptom is the tool running with
no collection and nothing saying why. The fix is not to change the default but to
make the expectation explicit: a per-controller "comes and goes" flag in the
topology. A board carrying it going quiet is normal and silent; a board without
it going quiet is still a fault the UI shows. Without that flag the existing
node-offline treatment fires every time the planer is switched off at the wall,
which is how a real fault gets trained away.

The one genuine edge: flipping the planer's switch within a couple of seconds of
energising the circuit, before the node has joined, loses the first moments of
collection. Known, accepted.

#### 5.6c BUILT, and what is still not proven (2026-09-15)

**Everything in §5.6b now exists**, on both sides, in software. What has NOT
happened is any of it running on a board.

Built and covered by tests:

- **`CONFIG` (P->S) and `SENSE` (S->P)** in `nodelink.js` and
  `control/NodeLink.h`, with no `NODELINK_VERSION` bump — both ends ignore a
  frame type they do not know, so every old/new combination degrades safely and
  a bump would force a flash of every board in the shop to buy nothing.
- **`sensor.ct` on a tool** in topology.js, validated. It is a SIBLING of
  `sensor.outlet` rather than a field on it, because a clamp is addressed by
  `controllerId` and a plug by IP. §5.4b is enforced by SHAPE here:
  `thresholdW` lives on `sensor.outlet`, so a CT-sensed tool has nowhere to put
  one.
- **The primary pushes and consumes.** `TopologyRuntime` builds a CONFIG per
  board on adopt, and turns each reported bit into a SYNTHETIC WATTAGE — exactly
  as `setMachineManual()` does, so the routing brain keeps one notion of
  "active" and CT tools take part in most-recent-wins, coast-down and the
  dead-head rule without any of it being taught twice.
- **`RemoteActuatorBus` caches the CONFIG** and re-sends it on every accepted
  WELCOME. Load-bearing for this board specifically: it is powered from the tool
  it watches, so it reboots every time the planer is switched off at the wall,
  and a config sent once at adopt would be forgotten on the first power cut.
- **The node decides the bit** — floor learnt once the bias has settled, trip at
  `max(floor x 4, 8 counts)`, reported on change and every `kSenseRepeatMs`.
- **`mock-node.js` speaks both frames**, and the NodeLink conformance suite
  drives a real socket through configure -> report -> clear -> refuse-a-non-owner.

**THE SENSOR ID IS THE ELEMENT ID**, which is why there is no lookup table
anywhere: CONFIG carries it out, SENSE echoes it back, and what comes home is
already the machine id to act on.

Two bugs the tests caught, both of the silent-failure kind this whole design is
trying to avoid:

- A board answers to BOTH `""` and its own controllerId, so the config push
  configured the local bus twice and the empty second push erased the first.
- `syncControllerAliases()` runs AFTER `adopt()`, so the first push could not
  resolve a remote board. A CT on the primary would have worked and a CT on a
  node would have been silent forever — exactly the asymmetry that reads as a
  flaky board rather than a bug.

**Not proven, and none of it is small:**

- **Nothing has run on hardware.** No board has ever sent a SENSE.
- **`kTripRatio` (4x) and `kMinTripCounts` (8) are guesses.** The clamp's SCALE
  is confirmed to ~1% (§5.5a); its FLOOR is not, and the perfboard rigs were
  just rebuilt from 10k/10k to 1k/1k with nothing re-measured on them. Re-derive
  both before trusting this on a tool that matters.
- **Stale is treated as off.** A board still answering PINGs but no longer
  reporting is a FAULT, and there is nowhere to show it yet — see §5.6a.
- **`intermittent` is validated and unused.** Nothing reads it, so a node
  powered from its tool still raises the ordinary offline warning every time the
  planer is switched off.

One thing that did NOT happen, and is worth recording because the variant count
is a live worry: **this added no build target.** `PIN_CT` is in the C5 board
header, so the plain `xiao_c5` node compiles the sensing path too — which
incidentally makes the "single-servo + CT board" in the TODO a layout choice
rather than a tenth env.

#### 5.6b What this needs that does not exist

The hardware is the easy half. Three gaps, in the protocol and the model:

1. **NodeLink has no inbound sensor direction.** The frames are HELLO / WELCOME /
   SET / ACK / STATE / PING / PONG, and `STATE` means "a selector reached a
   state". Nothing carries a reading or an event from node to primary. Bin
   sensing never exposed this because it runs on the primary.
2. **A node is given no topology, by design** (the header of `nodelink.js`), so
   it has nowhere to be told it has a CT, on which pad, or what to do about it.
   `WELCOME` needs a small **node-scoped config block** — explicitly not
   topology: no elements, no routing, no vocabulary the primary could change
   underneath it. That one addition absorbs this node, a bin sensor on a node,
   and whatever the next sensor is, instead of each inventing a bespoke frame.
3. **A tool's `sensor` is `{ outlet }` only**, IP-addressed and HTTP-polled. A CT
   is addressed by `controllerId`, not an IP. The shape to copy already exists
   and is already validated: `bin.sensor: { kind, controllerId, invert }`, where
   an absent `controllerId` means "this board".

(1) and (2) are one change and should be designed together, with the §5.6a flag
folded in. Both sides get pairs — `nodelink.test.js` ↔ `test_nodebus.cpp`.

A controller with zero selectors should already validate, since controllers are
only referenced *by* selectors and the per-host limits are counts. Worth a spec
case to pin it down rather than assuming it.

**Where the decision happens matters.** If the node ships raw RMS, the primary
pays a round trip per sample for a question that is one bit. If the node trips
and sends an edge, the wire is cheap and the latency is good. Take the second —
and note that this makes the CT node the **second node with a brain**, for the
slider's reason at a different time constant. That is the rule in `nodelink.js`'s
header working as intended, not an erosion of it.

## 6. One seam, not two: emulate Tasmota

### 6.0 …or don't build the sensor at all (2026-09-10)

**This section was written assuming we build a CT sensor board that impersonates
a Tasmota. Athom already sells one, and it inverts the argument.**

[Athom 2CH Energy Meter (EM2)](https://www.athom.tech/blank-1/2-ch-energy-meter-made-for-tasmota),
**$29.40** (list $42), pre-flashed with Tasmota:

| | |
|---|---|
| Chip | ESP32-C3, 4 MB — the same family as our own boards |
| Input | **100–250 V** 50/60 Hz, so 240 V is native rather than a special case |
| Channels | 1 voltage + **2 current**, 0.1–97 A, split-core clamps on 100 cm leads |
| Also | A 6CH version, if a bank of 240 V tools is ever worth ganging |

**It is already the thing §6 argued we should emulate**, so `TasmotaOutlet`
drives it with no new driver, no new protocol, and no new node type. It turns up
in the sweep like any other Tasmota, claims through `Mem1`, and pairs in the UI
that already exists.

Three things make this better than the board we were going to build, not merely
cheaper:

- **It measures VOLTAGE and POWER FACTOR.** Our CT measures current and cannot
  convert to watts without them (see the note at the top of TasmotaOutlet.h).
  That means it reports real watts and can share `DEFAULT_THRESHOLD_W` with a
  plug-sensed tool — which retires the learned-baseline problem of §5.4a for
  this path entirely.
- **It is powered from the same mains it measures.** The standalone-CT-node plan
  existed to avoid USB and 12 V cables running from wall-mounted gates to mobile
  tools; this needs no separate supply at all. It also sidesteps a hazard that
  plan had and had not yet noticed — **a node powered off the tool must tap
  UPSTREAM of the tool's own switch**, or it dies exactly when the tool is off,
  and a sensor that is unreachable whenever the answer is "not running" cannot
  be told from a dead board.
- **It confirms §5.4 independently.** Athom's own manual: *"CT clamps can only be
  clipped onto single-phase wires (L line or N line)."* A shipping product with
  the same restriction we measured for ourselves.

At ~$15 per monitored channel it also undercuts the $13 plug per tool when both
channels are used, while covering the 240 V case the plug cannot. **There is no
1CH version** — 2CH is the floor.

#### The gap this opens, and it is a real one

**A multi-channel meter is ONE IP serving N sensors, and nothing in the model
allows that.** `machineForOutlet(host, ip)` maps an address to exactly one
machine, and `sensor.outlet` carries an `ip` and no channel. Two 240 V tools on
one EM2 cannot be expressed.

Worse, it fails silently. On a multi-channel device Tasmota reports
`StatusSNS.ENERGY.Power` as an **array**, and `TasmotaOutlet::doPoll()` does
`p.as<float>()` on it — which yields **0.0** for a JSON array. That is a
confident "zero watts" for a working meter: a tool that is never on, forever,
which is the precise failure the ENERGY-absent guard beside it was written to
prevent. The guard checks for a MISSING value and an array is present.

So the minimum before an EM2 is usable at all:

1. `doPoll()` must detect an array and either take a configured index or refuse
   loudly. **Refusing loudly is the right first step** — a wrong channel silently
   watching the wrong tool is worse than a plug that says it cannot cope.
2. `sensor.outlet` needs an optional `channel`, defaulting to absent = scalar,
   so every layout written before this keeps meaning what it meant.
3. Claiming needs thought: `Mem1` holds one owner for the whole device, but two
   channels may belong to two machines under the same brain. Fine for us today
   (same owner either way); not fine if two DustGate primaries ever share a
   meter, which is already outside what `decideMarker()` can express.

**Buy one and confirm it answers `Status 8` with an ENERGY block first.** If it
does, the DIY sensor below stops being the plan and becomes the fallback, and
the CT branch of the `PowerSensor` seam may never need an implementation of
ours.

### 6.1 The original argument, for a sensor we build

The homemade 240V sensor **serves the same endpoint as the Athom plug** —
`GET /cm?cmnd=Status%208`, same JSON, same `StatusSNS.ENERGY.Power` field.

This is the most valuable decision in the document, because of what it avoids:

- **One new driver in the firmware, not two.**
- **No new NodeLink frame**, and specifically no new *direction* of travel in a
  protocol where nodes have only ever received already-resolved numbers.
- **No new JS↔C++ constant pair** to register in the anti-drift table.
- The DIY sensor and the $13 plug are indistinguishable to the primary,
  discovered the same way, and exercised by the same conformance path.

Cost on the sensor board: a few hundred bytes of `WebServer` handler on top of
the ADC loop.

### 6.2 The collector gets its own hardware (2026-09-10)

**Decided.** A collector board is a board at the collector, doing only collector
things: bin level, a CT clamp, the RF transmitter, lamps. It does not drive
gates, and gate-driving boards do not do these jobs.

The alternative — hang each capability off whichever node is nearest — was the
working assumption until a pin budget killed it. **On a four-gate primary with a
screen there is exactly ONE ordinary pad left.** D3 is a strapping pin and D0 is
the only analog pad on the edge (spoken for by a CT), which leaves D6, and the
bin sensor already had it. So bin-level and RF-transmit could not coexist —
while wanting, obviously, to be in the same corner of the shop, because the bin
and the collector's receiver are three feet apart.

A board that drives no gates has the whole D7..D10 PWM block free, and the
question evaporates. Nothing is being squeezed.

**It is not a new firmware target.** Same node build, same NodeLink, same
`BOARD_NAME`. What differs is what the LAYOUT asks of it — `bin.sensor.
controllerId`, `control.rf` — which is a topology fact, exactly as CLAUDE.md
already says of the bin sensor ("a CAPABILITY not a node type"). The refinement
is that the capabilities cluster: they are all *collector* capabilities, they
all want the same location, and together they need more pads than a gate board
can spare. So they get a board, and it stays a plain node.

Consequences worth stating:

- **Range stops being a worry for the transmitter.** It sits beside the receiver
  rather than wherever the routing brain happens to live.
- **A CT at the collector is now easy**, and it is the one place a CT is
  clearly worth having even with §5.4 closed and §5.4a's threshold question
  open: a blower is a single large motor with an unambiguous running draw, which
  is the easiest possible signal to separate from noise.
- **It is the natural home for the servo fob-presser too** (§4.2a), which needs
  a PWM channel — and now there are four spare ones.
- **It costs a board per collector.** That is the honest price, and it buys a
  clean pin budget and a sane install: one box at the collector, one cable run
  to it, rather than three capabilities threaded back to boards chosen for
  where the gates are.

## 7. One node per tool?

Since the CT already forces a powered, WiFi-connected box at each tool, the gate
servo is one more GPIO and a ~$2 increment. **The marginal cost runs backwards
from the intuition:** we are paying for the sensor and getting the actuator
nearly free.

It also serves an existing goal. [`architecture-rfc.md`](architecture-rfc.md) §1
wants gates "spread over multiple ESP32 nodes (no long cable runs)"; four servos
on one shared node means four three-conductor runs across the shop, against one
short servo lead per tool. And the failure mode is more coherent — a dead node
takes out one tool's gate *and* its sensing together, rather than four unrelated
tools' gates.

**But it is a deployment shape, not a schema.** Two standing counterexamples:

- **The slider.** One ST3215 node drives 4 gates on a rack serving 4 different
  tools. One node, many tools, and it is a shipping configuration.
- **A trunk gate belongs to no tool at all.**

So actuator addressing and sensor addressing stay **independent host+channel
pairs**. "One node per tool" is then simply the case where both channels land on
the same host, and nothing in the model needs to know that happened.

**It does add a direction to NodeLink** — a node pushing a reading upstream,
which none has done. That is a real protocol addition, but not a violation of
the node contract: the node ships a raw number and the **primary** judges it
against `thresholdW`. "Already-resolved numbers, never state names" survives
intact, and this is a smaller departure than the slider's local homing loop
already was.

**The cost is fleet management.** Fifteen boards to flash, provision and OTA
instead of four, which lands directly on the open question in
`productizing-open-questions` about telling boards apart as a non-technical
user. That question gets harder here, not easier.

## 8. Firmware work

| Work | Notes |
|---|---|
| `TasmotaOutlet : SmartOutlet` | `poll()` hits `/cm?cmnd=Status%208`; `setSwitch()` unsupported; new `generation()` value. Structurally simpler than `ShellyGen2Outlet`. |
| Discovery | **Built 2026-09-09, and it will usually find nothing.** The ownership half is solved (`Mem1`, §11). The mDNS half is worse than this row assumed: Tasmota does not advertise a service of its own, so discovery asks `_http._tcp` — every HTTP responder on the LAN — and keeps only hits carrying a `devicetype=tasmota` TXT key. That key makes a hit unambiguous, which is the job `_shelly._tcp` does for Shelly. **But Tasmota's mDNS needs `USE_DISCOVERY` compiled in and is not in the precompiled builds**, upstream having left it out because "mDNS generates more problems than it solves". A stock Athom plug is very likely silent. Zero hits means *none advertised*, never *none present*, and the fallback — a hand-entered IP — works today. A subnet sweep would find them regardless; it is 254 blocking HTTP requests and wants chunking across `loop()` passes, so it is not built. |
| RF collector control | A `SmartOutlet` whose `setSwitch()` **pulses a GPIO** (HT12E `TE`) rather than making an HTTP call, and whose `poll()` is **not its own** — the reading comes from the upstream Athom plug. The driver is nearly nothing; the interesting part is the pairing, which is new: a control device and a sense device describing the same collector. |
| Toggle reconciliation | The fob is a single toggle, so `setSwitch(on)` is **not idempotent** and must be *read, compare, pulse if different*. The collector's sense plug is therefore a hard dependency of its control path: **plug unreachable → refuse to command**, because the direction of a pulse is unknowable. Needs a distinct fault state; `'unknown'` currently means "we can't report", not "we can't act". |
| Sense-only capability | `setToolManual()` — and its `* 3` / `manualWattsFor()` constant pair — cannot turn on a tool with no relay. Manual override for such a tool must mean "open the gate, run the collector", not "run the tool". |
| Model | No `sensor`/`control` schema change (§3). A `generation`-like discriminator on the outlet is enough. |

## 9. Bench plan

Ordered so each test unblocks the next. The C5s and the Rockler receiver are
already on hand; the Athom plugs are ordered.

| # | Test | Needs | Answers |
|---|---|---|---|
| 1 | ~~Read the fob~~ | — | **Done 2026-09-03.** One button; HT12E; 315 MHz per FCC ID `VFWPD5T`; address DIP 1/6/8. |
| 2 | Athom holds the collector | nothing | Does a pass-through plug survive what a relay plug wouldn't? Watch case temperature after 20 min. |
| 3 | Collector ground truth | clamp meter | Actual FLA and actual inrush — the numbers §2 and §4.1 are currently guessing at. |
| 4 | RF replay | 315MHz TX/RX kit | Can the primary drive the receiver with a $2 module, on protocol 11, with the address cross-check passing? |
| 5 | Fob tap | optocoupler | Fallback if 4 is fiddly. |
| 6 | CT threshold | SCT-013-030 | Is baseline-and-multiple solid with no calibration? |
| ~~7~~ | ~~Whole cord vs one conductor~~ | — | **DONE 2026-09-09 — it does not work.** §5.4. Nothing above noise on an intact cord, on our rig or a bench multimeter. |
| 8 | Closed loop | 2 + 4 | Toggle remote + Athom feedback → absolute state. |

Parts for the above, beyond what is on hand: an **HT12E** (~$1), a **315MHz** TX
module (~$3), an 8-position and a 4-position DIP switch (~$8 as an assortment),
a 315MHz RX module (~$2, optional now that option C needs no capture),
2× SCT-013-030 (~$14), an AC line splitter with **1X and 10X** loops (~$25 — the
1X loop is the one test 7 needs), a clamp meter with a true **INRUSH** mode
(~$50), 4N35 optocouplers (~$8). **Do not buy the RXB6** that an earlier draft
of this section hedged on: it is 433-only and the band is now known.

Run the RF receiver module at **3.3V**: its data pin outputs at VCC and 5V into
a C5 GPIO costs a pin. The transmitter is the reverse — feed it 5V for range,
its data input takes 3.3V logic happily. Quarter-wave antenna at 315 MHz is
**23.8 cm** of solid core wire (not the 17.3 cm that 433 wants).

## 10. What is unverified

Everything. Specifically:

- No Athom plug has held the collector's 10 A continuously. One has been talked
  to over HTTP (§4.1) but nothing has been plugged into it.
- §5.4 is ANSWERED as of 2026-09-09 and the answer is no. What follows was
  written while it was still open:
- No CT has been clamped on anything, and §5.4 is a hypothesis with one piece of
  commercial evidence behind it.
- Nothing has been transmitted to the Rockler receiver. Band, encoder, address
  and button count are now **known** (§4.2); what remains unproven is that a $4
  transmitter actually keys it — which under option C reduces to matching the
  fob's oscillator resistor and picking the right data pin.
- The claim that a pass-through plug solves the trip is **reasoning from why the
  protection exists**, not an observation.
- Thermal behaviour of a 15A-body plug at **10 A** continuous in a dusty shop is
  exactly the kind of thing that looks fine on a bench and fails in year two.
  Less marginal than the 13 A guess made it, but still the failure that would
  take two years to find.

## 11. Open questions

- ~~**Ownership without `Ws.SetConfig`.**~~ **ANSWERED 2026-09-09: Tasmota's
  `Mem1`.** It is free text, persists across reboot, and is read and written over
  the same `/cm?cmnd=` endpoint as everything else — so it is the same shape of
  thing a Shelly's push target is: device state we set and can verify, rather
  than a name a user might edit. We write our hostname into it.

  The claim model gained the "second, weaker mode" this bullet anticipated:
  `claimOfMarker()` / `plugclaim::decideMarker()`, same four states, paired
  across both engines. **It is weaker in two specific ways and both are
  load-bearing:**

  1. **It is advisory, not enforced.** A Shelly can push to exactly one place, so
     writing that config *is* the claim; Mem1 is a note we agree to read. Two
     brains can poll the same Tasmota plug and neither will notice.
  2. **There is no `foreign` state, and cannot be.** `foreign` is visible on a
     Shelly only because Home Assistant had to write the push config to receive
     anything. HA *polling* a Tasmota writes nothing, so a plug reading
     `unclaimed` may well be in use and we cannot tell.

  The compensation: the marker is a hostname rather than a dialable address, so
  it does not go stale when DHCP moves us, and the whole `stale`/repair branch
  `claimOf()` needs has no counterpart.

  This unblocks discovery, which is still not built — the mDNS half (Tasmota
  advertises differently from Shelly) is untouched.
- **A collector described by two devices.** Control is an RF code; sense is a
  plug at a different address. The model has never had a system whose
  `control.outlet` and health reading come from different places. §8 lists it as
  work; the schema question is whether that is a `control` variant or something
  new.
- **Certification**, if hardware is ever recommended rather than merely
  supported (§4.1). The RF path adds a second flavour of this: the fob is
  certified under Part 15.231 and a bare $2 module on our board is not. A brief
  burst that replays an existing remote's word is squarely what 15.231
  contemplates and is a non-issue for one shop, but *shipping* a product with an
  uncertified 315MHz transmitter is not — that would want a pre-certified
  module, or option A (tapping a fob that is already certified), which is one
  more reason to keep A alive rather than treat it as a mere fallback.
- **Whether the DIY sensor should ever be a real NodeLink node** rather than a
  Tasmota impersonator (§6). Emulation is right for now; it may stop being right
  if sensors need anything push-shaped or anything the Tasmota JSON cannot say.
- **Whether DustGate should bring its own network** rather than live on the
  user's (raised 2026-09-09, deliberately not pursued yet). It would dissolve
  §12 rather than work around it: on a network we own, nothing is blocked, DHCP
  is ours, and mDNS either works or is unnecessary. The C5 can run AP and
  station at once, so it is not obviously infeasible. The costs are the reason
  it needs real thought rather than a paragraph — a plug on our AP has no route
  to the internet (which is fine for a sense-only plug and fatal for one wanting
  OTA updates), and the woodworker's phone would have to leave the house WiFi to
  reach the UI, which is a worse daily experience than any of the problems §12
  describes. Routing between the two interfaces is the thing that would decide
  it, and none of it is understood yet.

  The adjacent question is **whether the radio should be WiFi at all**. ESP-NOW
  is the interesting one for our own hardware, because it is the same radio with
  no AP, no DHCP and no addresses to go stale — every §12 problem gone by
  construction. It only reaches devices we build (§6's CT board), never a
  Tasmota, so it is a second path rather than a replacement. Zigbee and
  Thread/Matter are the standards-shaped answers and each want a coordinator and
  a certification story. **Explicitly parked**: the near-term job is working
  reliably on one shop's guest network, and none of this helps with that.

## 12. Staying reachable

Three questions asked together on 2026-09-09 — how a paired plug survives an IP
change, whether to push instead of poll, and whether to write our own Tasmota
firmware — turn out to be one question with one governing rule.

**The rule, and it is now a design constraint: never make a working shop depend
on something a network is allowed to block.** Multicast is the specific hazard.
mDNS is off by default on plenty of guest networks, most IoT VLANs, and a fair
number of mesh routers, and the woodworker whose shop stops working has no way
to know that is why. A feature may *use* mDNS as a fast path; nothing may
*require* it.

### 12.1 Where we lean on mDNS today

| Path | What mDNS does | If multicast is blocked |
|---|---|---|
| Shelly discovery (`_shelly._tcp`) | the only way to find them | wizard finds nothing → hand-typed IP |
| Tasmota discovery (`_http._tcp` + `devicetype`) | known to usually fail anyway | covered — the IP sweep finds them |
| Node discovery (`_dustgate._tcp`) | the only way to find nodes | hand-typed IP |
| `RemoteActuatorBus::resolveAndDial()` | **runtime**, on every reconnect | a node paired by *hostname* never comes back; one paired by IP is fine (`_hostIsIp`) |
| `ShellyGen2Outlet::reresolve()` | DHCP-change recovery | stale IP is unreachable, permanently |

Every *discovery* path degrades to a hand-typed IP, which is tedious but not
broken. Both *recovery* paths degrade to nothing — and recovery is the one that
fails months later, in a shop nobody is watching, on a router reboot.

**SETTLED ON HARDWARE, 2026-09-09.** Two questions that had been reasoned about
rather than tested, both answered against the Athom plug and the shop network:

- **Tasmota's mDNS is genuinely absent, not merely switched off.**
  `SetOption55 1` answers `{"SetOption55":"ON"}` — which looks like success and
  is not. Tasmota stores and echoes any SetOption in the valid range whether or
  not compiled code reads it, so **a set bit is not a feature**. After a
  confirmed restart (`UptimeSec` 131) the plug appears in neither
  `dns-sd -B _http._tcp local.` nor `_arduino._tcp`. `USE_DISCOVERY` is not in
  the build, there is no command that adds it, and the subnet sweep is therefore
  the only first-contact route. This is also why `TasmotaOutlet::reresolve()`
  stays deleted: there is no name to resolve.

- **Multicast is NOT blocked on this network.** The same browse showed
  `dustgate` immediately. Shelly discovery and `ShellyGen2Outlet::reresolve()`
  are on solid ground here — which is the opposite of what the contaminated test
  below suggested, and the reason it is kept as a warning.

**A NETWORK TEST THAT PROVED NOTHING, recorded so it is not repeated.** On
2026-09-09 `dustgate.local` failed to resolve from the Mac, and that was read as
evidence multicast was blocked on the shop network. The board was simply powered
off. There is still **no evidence either way** about mDNS on that network; the
valid test is `mdnsprobe` on a running ESP32, which asks the querier that
actually matters rather than the Mac's.

### 12.2 Tasmota recovery: re-sweep, identify by Mem1

> **BUILT 2026-10-03, with one change to the plan below: the identifier is the
> plug's MAC, not Mem1.** `Mem1` holds OUR name, so it says "ours" and cannot say
> *which* plug — two plugs of ours look identical. The MAC is unique, survives a
> new lease, is on the label, and Status 5 reports it. It is stored as
> `sensor.outlet.mac` when a plug is paired, and backfilled by the brain for plugs
> paired before that. A plug silent for 5 minutes triggers one background sweep
> (at most every 15 minutes), matched by MAC, and the layout's address is rewritten
> and logged `[RELOCATE]`. With no MAC on file a plug is paired by ELIMINATION only
> when exactly one unclaimed plug and one lost plug exist; anything less certain is
> left alone. `firmware/control/OutletRelocate.h` has the rules and the tests.
> **Not built: the mDNS tier.** If Tasmotas are flashed to advertise, resolving the
> plug's own name becomes the fast path and the sweep the fallback; the MAC check
> stays, to confirm the answer. Limits: the sweep covers the brain's own /24 only.

`TasmotaOutlet::reresolve()` was a verbatim copy of the Shelly one and could
never have worked: Tasmota does not advertise over mDNS in a stock build, and
`_host` is never populated for a Tasmota because the sweep finds these by
address. It returned false on its first line every time. **Removed 2026-09-09** —
a dead branch that reads like recovery is worse than no recovery, because it
answers "what happens when the address changes?" wrongly and stops anyone
asking again.

The replacement uses what pairing already writes. **`Mem1` is a durable
identifier**: it holds our hostname, it survives reboots and lease changes, and
it is exactly the thing an IP is not. So a plug that goes missing is found again
by sweeping the subnet and reading `Mem1` for the one that says it is ours.

This is a strictly better answer than the alternatives, and it is better
*because of* §12's rule:

| Option | Why not |
|---|---|
| DHCP reservation | Router-side, per-user, and not something the product can do. The right advice for an advanced user; not a mechanism. |
| Static IP on the plug at pairing (`IPAddress1`) | We would be choosing an address on someone else's subnet with no way to know what is free. A collision is worse than a lease change, and harder to explain. |
| mDNS | The thing this section exists to stop relying on. |

Shape of the work, none of it built:

- It is **~60s of blocking HTTP over 254 addresses**, so it must never run from
  the poll task on a failed read. That is why `poll()` now simply fails.
- It is a **deliberate, user-visible action** with a progress report — the same
  machinery the layout-page discovery sweep needs (see the two-phase scan
  mockup), which is the argument for building that first and getting this second
  nearly free.
- A sweep may find a plug whose `Mem1` names a *different* brain. That is
  `plugclaim::decideMarker()`'s existing job and it needs no new policy.
- **Unresolved:** two plugs claiming the same owner name, after a plug is
  swapped without being released. The claim identifies the *brain*, not the
  *tool*, so it cannot tell two of our own plugs apart. Writing `Mem2` with the
  tool id at pairing time would fix it and costs nothing — worth doing when this
  is built.

### 12.3 Push instead of poll — yes, and as configuration

The polling load recorded in §4.3 is real: every Tasmota is polled at
`OUTLET_POLL_INTERVAL_MS` (500 ms), permanently, and at seven plugs that is 14
requests/second the primary is making forever.

Tasmota can push, with no custom firmware, via a rule:

```
Rule1 ON Energy#Power DO WebSend [<primary-ip>] /push?w=%value% ENDON
Rule1 1
```

`WebSend` sends a Tasmota *command* by default and does a raw HTTP GET when the
argument starts with `/`. **`WebQuery` is the better fit** — same idea, shaped
for non-Tasmota targets, which is what we are. Either way this is *setup*, not
code: it is written once at pairing over the same `/cm?cmnd=` endpoint that
already writes `Mem1`, `PowerOnState` and `PowerLock`.

**Push the wattage, not the verdict.** The tempting alternative is to put the
threshold in the plug so it only calls when a tool actually starts. Rejected:
`thresholdW` is a topology value the user edits, so every edit would mean
rewriting a device's rule, and the judgement would move out of the primary.
`TopologyRuntime`'s contract is that a plug *reports* and never *judges*, and
that is what makes one brain possible. The plug sends a number; we decide.

(`PowerLow`/`PowerHigh` looked like the elegant version of this and are not:
they emit **MQTT telemetry only** and raise no rule trigger, so with no broker
they do nothing. Corrected here because the first version of this section said
otherwise.)

What it costs:

- **Latency.** `Energy#Power` fires roughly every 2s, against a 500ms poll.
  Acceptable — a gate takes ~2s to move and the collector's spin-up grace is 4s,
  so the sensing is no longer the slow part of the chain.
- **Reliability.** Tasmota's own docs are blunt that `WebSend` error handling is
  poor and MQTT is the reliable transport. A dropped push is a tool that looks
  idle while it runs, which is the wrong way to fail.

So push does not *replace* polling — it lowers its rate. Keep a slow poll as the
floor (a few seconds), let push carry the fast path, and the 14 req/s becomes a
fraction of that without inventing a new failure mode. **And it changes the IP
problem's shape:** a plug that calls us does not need us to know where it is, so
a push arriving from an unexpected address is itself a re-resolve — free, if the
handler reads `Mem1` to confirm who it is before believing it.

### 12.4 Custom Tasmota firmware — no, and the reason is not difficulty

It is entirely possible. Athom's plugs are not locked down: they are documented
as compatible with the official Tasmota OTA server, people have flashed custom
builds (mensi.ch documents the process), and the constraints are ordinary —
`tasmota-minimal.bin` first if flash space is tight, DOUT flash mode on the
ESP8285.

Rejected anyway. The two things custom firmware would buy are **mDNS**
(`USE_DISCOVERY`, confirmed absent from the Athom build on 2026-09-09 — see
§12.1) and **push** — and push is available above as configuration. That leaves mDNS, which §12's own rule says we
must not depend on, so building our own way to depend on it is backwards.

Against that: it trades Tasmota's mature OTA, WiFi reconnection, energy
calibration and setup UI for a maintenance burden on a **mains device that has
to be opened to be recovered** if a bad flash bricks it. That is a bad trade for
a feature we have decided not to rely on.

**What would reopen it:** needing something the Tasmota JSON genuinely cannot
say. §6 already contemplates the reverse direction — our own CT board
*impersonating* Tasmota — and the day emulation stops being expressive enough is
the day both questions get asked again together.

## 13. Rejected

| Option | Why not |
|---|---|
| Disable the plug's overpower protection | Hides the failure, keeps making into inrush. §2. |
| A larger smart plug / the [Ogemray 25A relay](https://us.shelly.com/products/ogemray-25a-smart-relay) | 25A/6000W is a **general-use** rating with no published motor or HP rating and no inrush spec. Probably fine at 1HP; not *rated*. And it still puts a relay we own in the load path. |
| **Building the contactor box** — Shelly 1 Mini dry contact driving a 30A definite-purpose contactor (120V coil), snubber across the coil, manual bypass toggle in parallel, in a NEMA 1 enclosure | Correct engineering, ~$105 and an afternoon of mains wiring, and **entirely redundant with a $40 listed appliance already in the shop** (§4.2). **Kept here deliberately:** it is the answer again above 1.5HP, where the Rockler box runs out. If it ever gets built, note that a contactor is not overload protection — a motor without an internal thermal cutout wants a magnetic starter instead — and that this is licensed-electrician territory in many jurisdictions. |
| Converting the collector to 240V | Halves the current and would make everything easier, but needs a 240V circuit run — panel work, which §5 rules out on the same grounds. |
| Shelly EM Gen3 + CT per tool | Works, and its contactor-control output was genuinely well-matched to the build above. But ~$30/tool, and it buys nothing the $13 Athom plug does not for the common corded case. |
| Panel-side CTs (Emporia Vue, IoTaWatt) | Cheapest per circuit and the only thing that covers hardwired tools — but it means panel work. Rejected on insurance grounds; see §5. Also ambiguous when two tools share a circuit. |
| Stick-on accelerometer / vibration sensing | The genuinely cheap idea: ~$5, no mains contact, no enclosure, no electrician, works on hardwired and 240V tools, installs by peeling a sticker. Rejected **for now** only because of cross-talk: once the collector runs the whole shop shakes, and the tool's own gate and duct are physically coupled to it. Very likely separable by magnitude and spectrum; entirely unproven. **§5.4 did not pan out (2026-09-09)**, so this is no longer moot — a clip-on CT needs the cord opened, which is the cost this idea avoids entirely. It is now the cheapest route to a 240V or hardwired tool, and the strongest reason to revisit it. |
| HLK-PM01 mains supply inside the DIY sensor | Turns a low-voltage gadget into a homemade mains device for the sake of avoiding a USB brick. §5.1. |
