jeff-engineers/dustgate/docs/carrier-wiring.html

# DustGate carrier wiring

The one PWM board — gate, CT-sensing node or collector by what's fitted — drawn twice: the perfboard as it runs in the shop today, CT network included, and the PCB, V1, with the sourced parts. Both tabs use the V1 board's reference designators (R6, D3, J2 …), so a part here is the part on the board. Pad numbers come from firmware/boards/xiao_c5.h; the old reasoning (history) in docs/archive/WIRING.md, the part numbers in docs/BOM.md.

Perfboard PCB

## Before soldering — check these on the bench

#### The jack and the clamp

- Nothing inserted: tip contact (Left / pin 2) to the switch (LSw / pin 10) beeps; insert a plug and it opens.
- SCT-013-030 plug: tip to sleeve reads tens of ohms. If tip to ring reads it instead, move the bias wire to Ring / pin 3.
- Diode mode, XIAO out: red on D0, black on 3V3 reads ~0.2–0.4 V (D3 forward); red on GND, black on D0 the same (D4). The other way round both read open. A backwards one holds D0 near ground and drags 3V3 down (two boards, 2026-10-11).

#### The rails

- Trim the servo buck to ~6 V before a servo is plugged in. Check each servo's maximum before going higher.
- USB unplugged, 12 V on: the USB-C connector's VBUS reads 0 V (the Schottky is doing its job).
- CT bias node to GND reads ~1.65 V.

#### The modules

- OLED: VCC/GND order differs between modules — read yours. It runs from 3V3; at 5 V its pull-ups put 5 V on D4/D5.
- The MPM3610 breakout's pins follow the LM1117 TO-220 order plus EN — go by the silkscreen.

#### After it's built

- Read the CT floor on the Boards page with servos idle and moving: the cyclone board reads 0.04 A with the network fitted.
- Unplug the clamp: the board should report "No clamp plugged in" (the jack switch pulls D0 to 3V3), not read zero.

Drawn 2026-10-08; the PCB tab redrawn for V1 and both tabs given V1's designators on 2026-10-29. Not to scale: the XIAO's pads are spaced to fit what hangs off them. The perfboard column is the reference — it works, CT network included — and nothing in the PCB column has been on a board yet.
