jeff-engineers/dustgate/docs/images/actuator-assembly.png

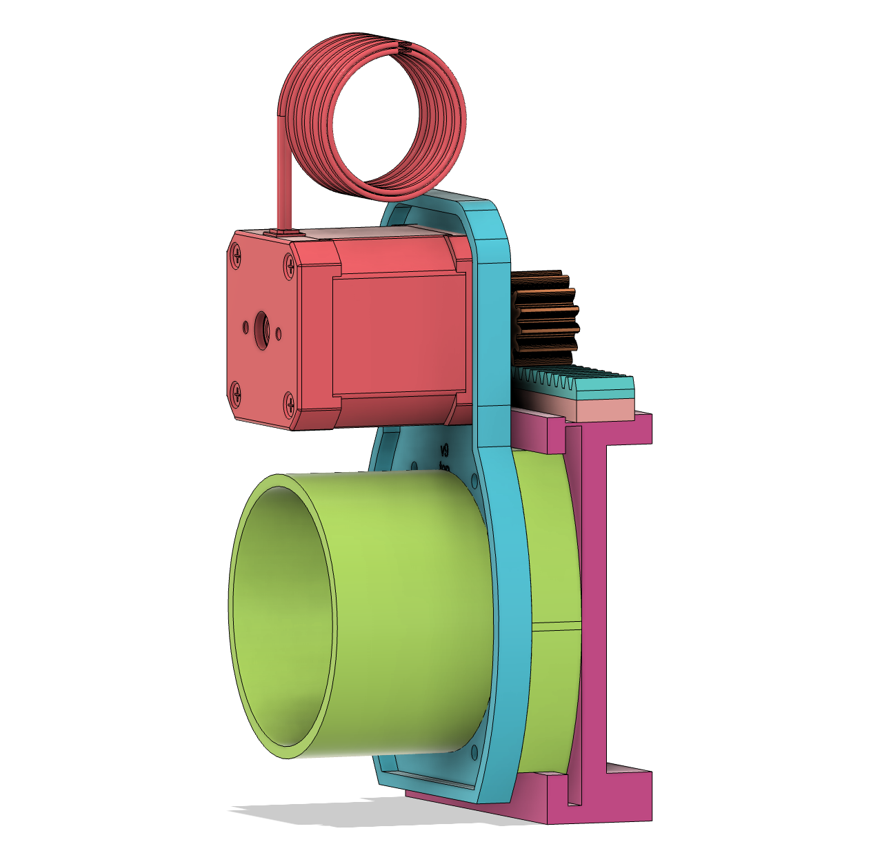
docs/images/actuator-assembly.png
