jeff-engineers/dustgate/TODO/TODO.md

# TODO

Jeff's parking lot. Add anything here rather than derailing whatever is in
flight — a line is enough, context can come later.

Anything with a plan behind it lives in `docs/` and is linked from here rather
than restated. When an item lands, either delete it — the git history is the
record — or move it to [`DONE.md`](DONE.md), which is for the ones whose
reasoning was contested, or that a still-open item above leans on.

**Finished items go to `DONE.md`, not to the bottom of this file.** They lived
here until 2026-09-17 and had grown to 144 lines — longer than most of the
active sections above them, which is how a parked item stops being read.

## Pi bring-up (started 2026-10-06; the Pi runs the shop since 2026-10-11)

Goal for now: **run the shop without the Mac**, with no fixed address anywhere. **Steps 1-4 done 2026-10-06** (Pi Zero 2 W, Trixie, `dustgate.local`): the brain runs on the Pi with the shop's layout and plugs, and all six nodes found it by beacon with nobody touching them. Steps 5-7 need someone in the shop. Steps, in order; each says
what to report back. Full commands are in [`native/pi/README.md`](../native/pi/README.md).

1. **Flash the Pi** (Pi Zero 2 W, or any 64-bit Pi) with Raspberry Pi OS Lite (64-bit) in the Imager: hostname (not `dustgate` while an
   ESP32 brain with that name is on), your user, SSH with your Mac's public key, the shop WiFi and country. **No DHCP reservation.**
   Report: can you `ssh <user>@<hostname>.local`? If not, what address does the router show?
2. **Run `setup.sh` on it** (compiler, Boost, the `dustgate` service user, WiFi power-save off, hardware watchdog, persistent journal,
   the systemd unit). Report: any step that fails, and its output.
3. **Deploy from the Mac** with `deploy.sh`. **A Zero 2 W cannot compile `main.cpp`** (cc1plus killed at 415 MB, and a swapfile on the SD card thrashed it until the watchdog rebooted the Pi), so the brain is CROSS-BUILT on the Mac with zig (`brew install zig`, `make -C native arm64`, ~1 min, 4 MB stripped) and only the binary is installed. `--on-pi` still builds there. Done.
4. **Stop the Mac brain, bring the state over** (`--state`), start the Pi's. Report: do the nodes find it (Boards screen) without anyone
   touching them? They should, by the beacon.
5. **Move the address.** Force the Pi onto a different address (`sudo ip addr`, or restart its WiFi/router lease) with a tool running.
   Pass: the log shows `[NET] address changed`, the nodes relink, and the plugs read again (by polling for a few seconds, then pushing).
6. **Pull the power** on the Pi mid-save and boot it. Pass: it comes back with its layout (the state files are written atomically).
7. **Run a normal shop day on it**; keep the journal (`journalctl -u dustgate-brain`).

Open design work behind this, in the order it will be needed: mDNS advertising from the brain itself (the Pi relies on avahi today),
first-boot WiFi setup for a customer, a read-only root, and the `--git` update path. None of it blocks the steps above.

## Next: failure states and status lights (decided 2026-10-19, D-85 and D-86)

- **Fail closed (D-85).** The plan, one piece at a time, each with its matched JS/C++ test where the model has a twin:
  1. **BUILT 2026-10-20 — the delay, a shop setting.** `failsafe.closeAfterMs` in the layout (shop.js `failsafeCloseMs`,
     `TopologyRuntime::failsafeCloseMs`), bounds 10 s–10 min, a field in Settings ("If a board loses the brain").
  2. **BUILT 2026-10-20 — the node closes.** CONFIG carries `failsafe` (the delay and each gate's resolved close command,
     `parseFailsafe`/`FailsafeTimer` in NodeLink.h, matched tests F1–F13); the node closes once after `closeAfterMs` with no
     frame from its brain, a link back sooner cancels it, an unhomed slider is left where it is. Host-tested and compiled
     only. **Do not flash nodes with it until piece 4 lands:** with the brain itself gone, every node closes its gates
     and nothing yet stops the collector — a dead-head. (Before this, a dead brain left the gates open.)
  3. **BUILT 2026-10-20 — the brain's half.** `TopologyRuntime::trackLostBoards` / `keepAVisiblePath`: a lost board's
     gates stop counting as visible at once and are believed closed `kPongTimeoutMs` before the node closes them; a
     running or wanted blower with no visible gate gets one opened on a live board; the last visible gate of a running
     system is never closed; a failed make no longer holds the blower off when a visible gate is open; nothing starts
     into a sealed system and a running blower with no open gate stops; a board that comes back has its gates re-sent;
     the status shows where such gates really are. Host-tested (test_nodebus.cpp FC0–FC15) and end to end on the native
     brain with fake nodes (`native/test/e2e_failclosed.sh`). Not mirrored in topology-device.js: the JS simulation has
     no board links to lose.
  4. **BUILT 2026-10-20 — the collector stops with the brain gone.** The collector's board (its transmitter and the
     blower's clamp both on it) is sent `failsafe.stopCollector` in CONFIG; when its timer fires it presses the remote
     OFF if the clamp says the blower runs, re-checks after `kPressCooldownOffMs` and tries up to `kMaxPressAttempts`
     (CollectorPress.h, the brain's own numbers), and never presses without a clamp reading (control/FailsafeStop.h,
     test_failsafestop.cpp; F14–F20 matched). A plug-switched collector: every ON carries a dead-man
     (`outletDeadmanSec()`: the gates' delay less 10 s, never under 5 s — 20 s for the 30 s default, so the blower stops
     before any gate closes; it was a fixed 60 s, up to 30 s of a blower against closed gates), renewed three times a period
     by the native poller (`native/test/e2e_deadman.sh`). Not covered: an RF collector whose running reading comes from a plug the brain
     polls (the board cannot judge its own press) — it gets no stop; and the frozen ESP32 brain sends no dead-man.
  5. **BUILT 2026-10-20 — the problem says what happens.** board-offline now reads "its gates close on their own after
     N s … the rest of the shop keeps collecting".
- **The Shelly dead-man renews: tried 2026-10-20 (jeff).** On a Shelly Plug US Gen4, `toggle_after=30` sent twice ~20 s
  apart switched off ~50 s in, 30 s after the second call — a renewal restarts the countdown, as the brain assumes. Still to
  bench after flashing the nodes: unplug a node mid-cut, and stop the brain with the collector running.

- **Status lights (D-86) — BUILT 2026-10-20, NOT YET RUN ON HARDWARE.** ALERT carries `bin`, `suction` and the shop
  light's resolved colour + blink (matched tests); `TopologyRuntime::boardLight()` decides (L0–L8), the native brain sends
  it on change, the node shows it. Every board drives a 12-pixel RGBW ring (Adafruit 2851) behind its own pixel, always (jeff: on a board
  with no strip the data clocks into nothing), as one RMT chain written only on a change (StatusLed.h `_writeChain`).
  **Ran 2026-10-22:** the board pixel (dim white idle) and the cyclone's ring (solid amber) through it — the ring is 12
  RGBW (Adafruit 2851), and RGB data for 16 had scrambled it. Still to see: green suction, the blinking forms, bin red.
  The screen (jeff, 2026-10-20): BIN FULL "Empty the dust bin"; NO BRAIN "WiFi ok, brain silent", "gates close in Ns" then
  "gates closed" (and on the collector's board what it did about the blower); SUCTION "gate open", "collector running";
  READY "waiting for a tool". No WiFi is blue blinking. Fault, then a full bin, outrank motion on pixel and screen. The
  frozen ESP32 brain's own pixel now reads dim white when ready.

## Bugs

- **A slider's endstops both read triggered after a jam, until the whole slider is power-cycled (jeff, 2026-10-07).** A latched
  supply on the driver side is the guess, unconfirmed. Seen once in the shop; the failure itself now reaches the brain
  (DONE.md, 2026-10-16), so the next time it happens the slider page will say "finding home, the datum endstop reads
  TRIGGERED and will not clear". Meter the endstop supply when it does.

### Left from the bug search of 2026-10-06

Everything else that search found is fixed (DONE.md). These two remain, found by reading, not seen to fail:

- **SECURITY: DNS rebinding reaches both brains.** `GET /api/info` hands out the API key unauthenticated, by design (the app
  bootstraps from it). The CORS header that let ANY page read it is gone (fixed 2026-10-06), but a hostile page can still
  re-point its own name at 192.168.x.x and then be same-origin with the brain. A `Host` check closes it: accept an IP
  literal, a single-label name and the local suffixes (`.local`, `.lan`, `.home.arpa`...), refuse a public domain. Needs a
  decision on which local names a router may hand out (Google Wifi gives `.lan`), so not done blind. Matters little in
  Jeff's shop today; it is a must before anyone else runs one.

- **Smaller ones still open:**
  - The native beacon goes to `x.y.z.255` (it assumes a /24, as the sweep does), and `guessIp()` needs a default route (it
    "connects" to 8.8.8.8): a shop network with no gateway leaves the brain announcing 127.0.0.1.

### Earlier

- **"Update all" on the Boards page (jeff, 2026-10-10).** One button that updates every board whose firmware differs
  from the staged image, ONE AT A TIME (each waits for the previous board to come back on the new build, ~25 s), and
  stops on the first failure. `POST /api/nodes/update` already does one board; the loop is what
  a one-off script did by hand on 2026-10-08 and 2026-10-10. The brain refuses while a tool runs, so the
  button should say "with the shop quiet" and show which board it is on.

- **A smart contactor for the collector (jeff, 2026-10-10, planned hardware).** One box, one cord in, one outlet out: a
  contactor carries the motor current, so no plug or relay of ours ever does (the 1HP blower tripped a Shelly Plus Plug
  on 2026-09-03). Switching the collector is the one thing DustGate is allowed to do, so it does not touch "never switch a
  tool". The contactor is level-driven (coil on = blower on), which retires the RF toggle's inverted-belief problem, and
  it drops out on a power cut, so it behaves like a magnetic starter (no-volt release). Check the contactor's **AC-3
  (motor)** rating, not its resistive one.

  **v1 — a Shelly 1 Gen4 switches the coil. No firmware.** Mains in → Shelly 1 (on L/N; dry contacts) → the contactor's
  110 V coil; the contactor switches the outlet. The collector's board sits in the same box on a 120 V → 12 V supply
  (e.g. Mean Well IRM-10-12), doing the bin beam, the lamps and a CT around ONE motor conductor. Layout: the collector's
  `control.outlet` is the Shelly and its `sensor.ct` is the board's clamp — **checked 2026-10-10: that pair validates**
  (topology.js only refuses `sensor.outlet` + `sensor.ct`), and both brains switch the outlet while the clamp's reading
  stands as the feedback (native `feedPlugs()`), so a start the clamp never sees is `collector-no-start`. A plain Shelly 1
  reports no `apower` (reads 0 W); that is fine, because the clamp wins. Set on the Shelly: **power-on default OFF** (it
  stays off after a power cut) and optionally an **auto-off** backstop, because a Shelly holds its last state if the
  brain dies (the board-driven relay below would drop out instead). The cost is one more WiFi device in the control path.

  **v2 — the collector's board drives the coil directly (notes, not built).** Reuse the radio header: **5 V, GND and
  D10** (`PIN_RF_TX`); a contactor box has no remote to transmit to, so the pad is free and the pin map does not change.
  **Not D3**: it is GPIO7, a C5 strap, and a relay input on it can change how the chip boots.
  - **Driver:** Jeff has a HiLetgo 5 V relay module (hiletgo.com/ProductDetail/1958599.html). It does not switch
    reliably from 3.3 V, because its opto LED is fed from 5 V, so a 3.3 V high leaves ~1.7 V across it and the relay may
    never fully release. Put an NPN in front of it: D10 → 1 kΩ → base of a **2N3904** (or PN2222A/2N2222), emitter to GND,
    collector to IN, the module jumpered to **low-level trigger**, and **10 kΩ base → GND** so it stays off through reset
    and while flashing. A **2N7000** works the same way (100 Ω to the gate, 10 kΩ pull-down). The pin then never sees
    5 V. Do NOT drive IN open-drain straight from the pin: floating, it sits near 4 V, above the C5's limit.
  - **Not an SSR:** a triac SSR leaks a few mA when off, which can make a small contactor coil hum or hold in, and the
    cheap "Fotek" ones are often counterfeit.
  - **Relay contact rating:** at least 3 A at 120 VAC. The coil pulls ~0.5–1 A for a moment at pull-in, and ~0.1 A holding.
  - **An RC snubber across the coil** (0.1 µF X2 + 100 Ω "Quencharc", or the contactor's own plug-in suppressor), or
    the coil's kickback arcs the relay contacts every time it opens.
  - **A 1 A slow-blow fuse** on the branch that feeds the supply and the coil.
  - **An alternative:** a contactor with a 12 VDC coil keeps mains off the low-voltage side entirely (logic-level MOSFET
    plus a flyback diode, and no relay or snubber).
  - **Firmware:** a `control.contactor` kind on the collector (topology.js ↔ Shop.h), a cap in the WELCOME (from the pin
    map), and a level frame rather than PRESS: held while the brain wants the blower on, and dropped when the link or the
    brain goes away. That makes a reboot or an OTA mid-cut stop the blower, which is the intended failure. Firmware drives
    the pin LOW first thing at boot. The CT stays the feedback; an aux contact on a GPIO would be a stronger one if the
    contactor has one.
  - **Mains build:** a grounded enclosure, strain reliefs, and low voltage physically separated from mains. For anyone
    but Jeff this ships as a finished box, under the "an install step the owner cannot perform" rule.

- **The Live screen has no way to switch the collector by hand (found 2026-10-06, bench test 16).** `POST /api/collector` works
  (both brains, `ApiService.setCollectorManual()`), but nothing in the app calls it: the collector card shows state and has no
  button, so the only way to start a blower from the app is to switch a tool on. My test list said "tap the collector" and
  there is nothing to tap. A control on the card ("Run it" / "Stop it"), with the wording a hand-started blower needs, wants
  a mockup first (docs/mockups, the standing UI rule) — and it should say plainly when the brain will NOT turn it off for you
  (a blower started by hand stays on).

- **Collector slow to start for a tool used for seconds (jeff, 2026-10-06, bench test 10).** The miter saw was "a bit slow" to
  bring the collector on, which matters: a miter saw runs for a few seconds at a time, so a collector that arrives late
  never helps. Find where the time goes before changing anything — add timestamps for the whole chain and read them off a
  run: plug reading crosses the threshold (a Tasmota is POLLED every 500 ms, no push; a Shelly pushes) -> the tool is
  active -> the 1 s ON debounce -> the make-before-break move (a servo on a 1 W adapter is slow) -> the PRESS goes out ->
  the RF transmit (several frames) -> the receiver relay -> the plug sees the draw. Candidates: Tasmota polling and its slow
  power reading, the debounce, the gate move, and a first-switch-on re-assert of all five gates running ahead of the
  collector's press (it should not: the blower waits only for MAKES, but confirm). Also decide whether a short tool
  should leave the collector running for its coast-down so the next cut finds it already on.
  **Software part measured 2026-10-06** (native brain, two fake nodes, `/api/dev/power` standing in for the plug): power in ->
  the gate's SET reaches its node in ~0.12 s, and the collector's PRESS in ~0.32 s. So the brain's own share is a third of a
  second; the "bit slow" is everything outside it. Known contributions, in the order the chain meets them: the plug reading
  (Tasmota polled every 500 ms, ~1.5 s to show a rising draw; a Shelly pushes), `OUTLET_ON_DEBOUNCE_MS` = 1000 on the ESP32
  (the native brain applies none), the servo move on a weak supply, the RF transmit, the receiver's relay and the plug seeing
  the blower draw. Not yet measured: the hardware half. A timestamped run on the bench (plug sample -> SET -> STATE -> PRESS ->
  plug confirms) would say which of those is the big one.
  **2026-10-08 (branch `servo-range`, host-tested, not seen in the shop):** the biggest software wait is gone — the blower used
  to wait for the new gate to LAND (a 90° sweep is 2 s, then a 1 s hold before the board reports arrival); it now starts at once
  when its system already has an open gate, and every system settles with one gate open at boot so it usually does. Gates on
  different boards now move together. And a `[TOOL] <name> on (812 W)` line marks the start of the chain in the brain's log, so
  one miter-saw cut on the Pi now times the rest: `[TOOL]` → `[NODE→] … SET` → `[NODE←] PRESS ok`. Next: read one off the shop.
- **Bench test 20: rename a plug and release it (jeff, 2026-10-06).** Rename a Shelly from the app and confirm the new name in the
  Shelly app; release one and confirm it stops pushing and the previous push target comes back. Not run yet.
- **Bench: the collector's CT option (jeff, 2026-10-06).** The collector can be sensed by a current clamp on the cyclone board
  instead of the Tasmota (`sensor.ct` on the collector). Wire one, point the layout at it, and check that a blower started by
  the RF remote reads as running from the clamp alone, and that the press policy sees the same Running/Off the plug gave it.
  Compare its response time with the Tasmota's, which lags ~13 s falling to zero on a small load.
- **Bench: a dedicated optional node for the planer's sensor (jeff, 2026-10-06).** A board whose only job is to sense the planer
  (its clamp, or a plug the board polls) with no gates, optional in the layout. Check it pairs, reports SENSE, drives the planer's
  gate on another board, and that the layout needs no gate on it. The extra unpaired `dustgate-sensor` (192.168.86.60) may be this.
- **Bench: the slider node (jeff, 2026-10-06).** Out of 12 V supplies tonight, so it was not tested with the shop. Run it:
  boot, join, home (on the first SET or the one-second button hold), take a SET, move to each stop. Through the Pi brain it has
  now homed, swept and moved (2026-10-17/18); left: the one-second button hold, DEFERRED until a
  slider board has a button (the prototype has none).

- **PUT THE COLLECTOR "RUNNING" THRESHOLD BACK TO 50 W (jeff, 2026-10-06 — TEMPORARY).** **HELD 2026-10-16 (jeff): leaning towards making it
  user-configurable again (per collector) rather than restoring a fixed 50 W.** The bench collector is a desk fan
  that draws ~38 W, so `kCollectorRunningW` (control/CollectorPlugState.h) and `COLLECTOR_RUNNING_W`
  (topology-device.js) are 25 for now. Restore both to 50, and the literal in `test_collector_plug.cpp` ("kCollectorRunningW is
  ..."), and REBUILD THE APP (`npm run build` in dustgate-ui) — the Live screen judges the draw itself from the same constant, compiled in, so a brain-only change leaves it saying "Not starting" (found 2026-10-06) — the moment a real blower is on that plug — at 25 W a blower that is merely plugged in and idling could read as running.

- **Nodes find the brain, so a link stops costing the brain a task (jeff, 2026-10-04 —
  scoped, not started).** The full-shop test put nine paired nodes at 22 KB free internal
  RAM and a UI that refused to load; the nine link tasks alone are ~45 KB of stacks. The
  design (jeff's shape): pair from the brain as now, the steady-state link is
  node-initiated (an inbound socket on the brain, measured at 2.4–2.8 KB), and when a link
  drops both ends seek, with the brain's seeker limited to two attempts in flight. No router
  settings asked of anyone. Headroom estimate: ~9 nodes with the app on the brain, ~14–15 with
  it hosted off-board; `SMART_OUTLET_COUNT` (7) must rise to ~16 before the shop can pair.
  Full plan, memory table and open questions:
  [`docs/archive/nodes-dial-the-brain-plan.md`](../docs/archive/nodes-dial-the-brain-plan.md).

- **Native brain: what is left before a Pi is a product (2026-10-05).** Built and tested against fakes (`make -C native test`): node links, layout routing, the collector press loop, plug polling with the ESP32's own drivers, the app, and — since the API step — manual tool/collector switches, servo jog, pairing/pausing/discovery (a board nobody paired announces itself with a JOIN), node image staging and `/api/nodes/update` (images live on disk, so the full-filesystem problem does not exist here), the console and link log, the plug screens (ping, rename, release, sweep) and the board/plug problems. The app loads against it and its Boards and Shop screens render a real layout. **Not done:** (1) DONE 2026-10-05 against the five real nodes (no servos attached): gate moves (SET → ACK → STATE moving/arrived), the RF press and a bin sensor all work from the Mac brain; a firmware update pulled from the Mac brain's own disk installed on a real node (needs the brain on port 80); 10 restarts of the Mac brain brought all five nodes back in 1–20 s with no flaps; (2) DONE 2026-10-06: Shelly push (`/shelly-rpc`), claim/provisioning and takeover (`outlets/Provision.h`, `e2e_push.sh`) — against a fake Shelly only; not yet against a real plug, and the ESP32 still has its own copy of the provisioning loop; (3) the brain must listen on port 80 for node OTA (the node builds `http://<ip><path>`, no port) — done and verified; the Mac brain also holds idle sleep off with `caffeinate`; (4) mDNS advertising — on a Pi, set the hostname to `dustgate` and avahi does it; on a Mac use `dns-sd -P`; (5) packaging — image, first-boot WiFi, read-only root, watchdog; (6) the ESP32 still has its own copies of the routes in `api/ApiCore.h` — parked with the frozen ESP32 brain (below).

- **A node-owned plug's on/off threshold is compared twice.** The node polls the plug, compares
  watts to the `thresholdW` it was sent and sets SENSE `on`; the brain ignores that bit and
  compares the watts itself (`TopologyRuntime::pollSensors` → `setMachinePower`). Harmless, but two
  copies of one rule. Fix: drop `thresholdW` from the `plug` sensor in CONFIG (and `on` from plug
  SENSE) so the node only reports watts — a protocol change, so `nodelink.js` ↔ `NodeLink.h` ↔
  `test_nodebus.cpp` and the CLAUDE.md pair-table row move together, and it needs a node flash.
  Deferred 2026-10-04 so it does not ride along with the native build.

- **Bench the collector's jobs on a node — only (4), no replay, is left (2026-10-17).** (1)–(3) ran: PRESS from a node 2026-10-05, a real receiver keyed from a node 2026-10-06, the beam seen FULL from a node with the shop-wide alert 2026-10-11 (CLAUDE.md has each). The original list follows.
  node can now key the RF transmitter (a `PRESS` frame) and watch the dust-bin beam (a
  `bin` sensor in CONFIG, reported as a SENSE bit); the retry policy stays on the primary.
  Host-tested only. To do on a bench with a collector board flashed as a NODE: (1) pair it,
  point the layout's `control.rf.controllerId` and `bin.sensor.controllerId` at it, and
  check the board's WELCOME says `caps.rf`/`caps.bin`; (2) `[RF] press ... sent` on the
  node's console when the brain presses, and the real Rockler receiver actually keyed from
  a node (the timing is the same RMT code, but it has never run beside NodeLink's tasks);
  (3) cover the beam and check `[BIN] FULL` after ~2 s and `systems[].bin.full` in
  `/api/status`, then uncover it; (4) pull the node's power mid-press and check no press
  is replayed on reconnect (a PRESS is an edge against a toggle — the bus drops a queued
  one on a link drop, and a test says so, but nobody has watched it); (5) DONE 2026-10-05: the collector sheet now offers a board for the transmitter (the bin and clamp already had one).

- **Prove node-owned plug polling under a real load (jeff, 2026-10-04 — deferred).**
  Verified on the bench so far: a Tasmota paired to a tool whose gate is on
  dustgate-node-1 is handed to that node once the layout is SAVED (the node logs
  `[PLUG] polling 1 plug(s) for the primary`; before the save its CONFIG said
  "nothing to watch"), the plug answers (`Power 0`, 117 V), and the brain reads the
  tool as `watts 0, active false` with no problem raised. NOT yet seen: a load.
  To do: plug something over the tool's threshold (50 W) into the Tasmota — a
  hair dryer or heater — and check the node logs `[PLUG] <tool> ON <W>`, the brain's
  `/api/status` shows the watts and `active: true` (and the node's servo opens the
  gate), and it goes back to off when the load goes. Then pull the plug from the
  wall: `plug-unreachable` should reach "Needs attention" after about a minute and
  the node should log `UNREACHABLE`. Also still to watch: the node's poll cadence
  with 3-4 plugs and whether the CT's sampling suffers (see the entry below).

- **A tool switched on and then off by hand stays green for several seconds
  (jeff, 2026-10-04).** Suspected to be the collector's coast-down (the blower is
  held on for `offDelayMs` after the last tool stops, so the system treats it as
  still running), but the screen says nothing about it — the tool just looks
  stuck on. It should be reflected to the user: the tool's own state goes off
  immediately, and what is still running (the collector, coasting for N more
  seconds) is shown as such. Check first that it IS coast-down and not a status
  push or poll lag: `collectorCoasting` / `coastUntilMs` are already in the status
  document, so the data may be there and only the Live view missing it.

- **A plug that changes address is lost for good (jeff, 2026-10-03).** The layout
  stores an IP and nothing else; Tasmota has no mDNS. Plan: store the plug's MAC
  at pairing (Mem2 holds the tool id), and have the brain re-find an unreachable
  plug by MAC in a background sweep, update the layout IP, and say so in the log.
  The app now SAYS a plug is unreachable (`plug-unreachable` in `problems`), which
  is the half that was missing. The sweep only covers the brain's own /24, so a
  plug on another network is not found. Also: an outlet saved with no `kind`
  defaults to Shelly and polls a Tasmota wrongly forever — the sweep should set it.
- **ESP-NOW for primary↔node? (jeff, 2026-09-27 — THINKING, not decided.)**
  Every link failure so far is the same shape: two boards talking TCP *through
  the AP*, and the AP being allowed to break that — band split (09-18), flaky
  mDNS, and on 09-27 the primary cut off from the node (probe: `TCP :80 NO ROUTE
  (3002ms)` while a laptop reached the node in 10 ms), cleared only by the
  primary rejoining WiFi, and starting the moment a 254-address plug sweep ran
  (suspected: the guest network penalising a scanning client — UNCONFIRMED).
  That is CLAUDE.md's "never require anything a network is allowed to block",
  broken by the node link itself. ESP-NOW goes radio to radio; the AP only sets
  the channel.
  - Fits the existing seams: `link.transport: "esp-now"` is already valid in the
    schema, and routing only sees `ActuatorBus` — a new bus beside
    `RemoteActuatorBus`, not a rewrite. NodeLink's seq/ACK/STATE/PING carry over.
  - Costs: one shared channel (keep nodes associated to the AP so they follow its
    channel changes — also keeps HTTP OTA); 250-byte ESP-NOW v1 frames vs a
    ~420-byte CONFIG (ESP-NOW v2, ~1470 B, should be on IDF 5.5 — CHECK on the
    C5); discovery by broadcast beacon instead of mDNS (a gain).
  - Plugs stay on WiFi for now: custom ESP-NOW firmware via Tasmota's OTA is
    possible, but means per-model metering calibration and an unrecoverable
    brick on a sealed mains plug if an OTA goes wrong. CT-sensed tools are
    already on our boards and would ride ESP-NOW for free.
  - First step if we go: a one-day spike on two C5s on GenericGuest — v2 frames,
    channel follow, an hour's delivery count, one deliberate sweep. Keep
    `wifi-ws` as the fallback transport.

- **The first servo move after every boot snaps; everything else is already
  ramped. (jeff, 2026-09-30; corrected 2026-10-02.)** This entry first asked for
  a ramp, which `ServoActuator` has had since Phase 2: an eased (smoothstep)
  sweep at `SERVO_MS_PER_DEG` = 22 ms/° (~45°/s, far below the servo's native
  speed), clamped to 80 ms–2 s, with the detach timer started after the LAST
  step. The one unramped move is the first of each boot: the start angle is
  unknown (`_curAngle = -1`), so it writes the target at once. That is the
  worst-placed spike there is — a board that just reset on a power dip snaps on
  its next move, which is exactly the move most likely to dip it again.
  Candidate fix: persist the last settled angle (NVS, once per move, a few
  writes a day) and ramp from it. It is only as good as the gate not being
  turned by hand while de-energised, which is still better than a guaranteed
  snap. Context: the drum-sander board reset with `nodeRst: pwr_glitch` under a
  FORCED stall on 2026-09-30 — a 6 V/2 A rail feeding the servo and an
  MPM3610, which needs ~5.9–6.25 V in for 5 V out. No ramp fixes a stall or a
  sticky gate's breakaway; that is the supply, being rebuilt as 12 V in with a
  separate servo buck.

- **Router-table/jointer board: fix the bulk cap at the servo connector (jeff,
  2026-10-16).** Its 470 µF cap is installed with both legs on the positive rail,
  so it does nothing. The board resets (`nodeRst:
  poweron`) on rapid 0↔180 swings of an UNLOADED servo, a few seconds into a
  full swing, on the 12 V / two-regulator rig. Move its negative leg (the
  striped side) to ground, across the servo connector, first; if it still resets, test with the servo on a
  separate bench supply. The other suspect is the shared ground: the board is an
  ElectroCookie breadboard-layout perfboard with 22 AWG jumpers and every ground
  on the one rail strip back to the DC jack. If that is it, run the servo's
  ground on its own wire to the jack and/or solder 18 AWG along the rail.

- **Manual control at the machine — "give me suction here and turn it on".
  (jeff, 2026-09-17. Designed, not built.)** The BEHAVIOUR already exists:
  `setMachineManual(machineId, on)` synthesises watts, joins most-recent-wins,
  opens the path before starting the blower and obeys never-dead-head. It is only
  reachable from the Live view. This is a control-surface question.

  **Not a switch**, and jeff's reason is the right one: a switch's position is a
  claim about the world that the world can contradict — manual tool A, then go use
  tool B, and the switch still says A. A button has the opposite problem, no state
  at all, and what resolves that is the WS2812 already on every board: the
  indicator sits on the same object as the control, which is what a wall switch
  structurally cannot do.

  **One rule, not two.** The button cycles through what this board can offer, plus
  off — one gate is two presses, a two-way manifold is three (left / right / off),
  an eight-stop slider is nine, which is absurd. So it is one rule with a cap, and
  "sliders just don't have that" falls out rather than being a special case.

  **The node must report the EVENT, not the meaning.** A `BUTTON` frame carrying
  *pressed* or *held* and nothing else; the primary owns the cycle, because only
  the primary knows what that board drives. That keeps a node free of document
  interpretation — the invariant — and makes the slider opt-out a primary-side
  decision with no node code at all.

  ⚠️ **The real gap is the OFF-RAMP, and it is there today whatever the control
  surface.** `_manual` is a set that nothing clears except an explicit off, and a
  manually-run machine ignores its plug while it is in there. So manual claims
  accumulate silently: tool B takes the gate on most-recent-wins, but A never
  releases. Needs a timeout or an auto-clear. **Fix this before adding any new way
  to set it.**

  **D9 is free for a second button as of 2026-09-17** (see the pin table). Jeff:
  "I'm not convinced we need a second button, but it's trivial to add on
  perfboard, so we can try it and see." The wake button's gestures are already
  full — short press works the screen, one-second hold runs the servo self-test —
  and `oled-status.html`'s log records that the SECOND gesture was already
  contentious. A dedicated button also survives gloves and sawdust.

  Precedent worth copying: that existing hold **refuses outright while the
  collector is running**, because sweeping gates shut against a pulling collector
  is the dead-head. A manual gesture wants the same kind of refusal.

- **UI AUDIT 2026-09-17 — the same question is asked by two components, in two
  vocabularies.** Scanned every component for this; the findings are below,
  worst first. The pattern to copy is `selector-config`, which the canvas AND
  gate-list both open — one sheet, two entry points, no second copy.

  1. **A TOOL'S SENSING IS CONFIGURED IN TWO SHEETS, and only one of them knows
     clamps exist.** `tool-setup.component.ts` (Tools screen) asks it properly as
     a three-way — Metering plug / Current clamp / Nothing — with a board picker.
     `element-outlet-config.component.ts` (from the build canvas) asks Yes/No and
     can only ever write a plug. Both write the same `machine.sensor`. That is
     the root of the unanswerable-question bug above: the canvas sheet was
     reworded to cover clamps it structurally cannot offer. Merging these two is
     the single highest-value cleanup in the UI.

  2. **HALF OF `element-outlet-config` IS UNREACHABLE.** Its `mode` input takes
     'sensor' | 'switch', but build.component.html routes `outletMode ===
     'switch'` to `app-collector-setup` — so `isSwitch` is permanently false and
     every collector branch in that component is dead, the broken label
     included. Deleting the switch role would shrink it by roughly half before
     anyone tries to merge it with anything.

  3. **`tool-setup` REIMPLEMENTS the outlet picker** instead of using
     `app-outlet-picker`, which `element-outlet-config` and `collector-setup`
     both share. Its own scan button, empty state and "Scanning…" strings
     (:401, :406) are a hand-rolled second copy — and it owns a second set of
     scan flags to drive them.

  4. **`thresholdW` is edited in two sheets** (`element-outlet-config`,
     `tool-setup`) — the same split as (1), and it disappears with it.

  5. **A clamp can be paired from three surfaces**: dragged on the canvas
     (build.component), the Tools sheet, and the collector sheet. The canvas
     drag is the one the boards-dock rework is expected to retire; worth
     deciding that before adding a fourth.

  Not duplicated, and worth keeping that way: `paired-outlet-row` (shared by
  four), `outlet-picker` (two), `selector-config` (two), `servo-calibration` /
  `linear-calibration` (both owned solely by selector-config).

- **Wake on button push isn't working on nodes**

- **Brains seem to be keeping the screen alive full time.**

- **Dust collector - deadheaded - running with nothing open, stop it** 
  this state shouldn't exist, when the last tool is turned off it's gate should remain open
  there should be no way outside of manual user invervention to dead-head a system                      

- **Can the collector node run on ONE brick? (2026-09-11, decides a purchase.)**

  The collector node is being built as power topology **A** first —
  `docs/archive/WIRING.md#9-bin-sensor` §6 — two supplies, grounds genuinely
  separate. Not because A is better (it is two bricks at one machine, the worse
  install) but because it is the **baseline**: that board already carries three
  unvalidated changes in its CT section, and a shared ground underneath them
  would give any failure four candidate causes and nothing to compare against.

  **The real question is whether B works**, since B is the install anyone would
  want: one 12 V supply, a plain buck to 5 V, grounds common through the
  regulator. Once A gives a CT reading that cleanly separates a running blower
  from a quiet one, try B — same board, same clamp, same firmware, one thing
  different. If it matches, the install gets simpler for free.

  **If B is worse**, that is a real answer about shared grounds and the fix is
  topology C, which keeps one brick: an isolated DC-DC. Traco TMR 6-1211 (6 W,
  5 V/1.2 A) for a build with a fob servo, TMR 3-1211 (3 W, 600 mA) for RF-only;
  Mornsun URB1205S is the cheaper equivalent. Buy REGULATED — the 1–2 W
  unregulated parts sag under load, which is the failure mode a lumpy load
  produces. Acceptance test is one second with a meter: continuity between input
  and output GND reads open on an isolated module, ~0 Ω on a plain buck.

  **Buy nothing until B has actually been tried and failed.** A first, B second,
  C only with evidence.

- **DEFERRED 2026-09-16 (jeff): "we'll deal with CNC stuff when it comes down to
  it. I want to deal with getting my shop online, and my CNC isn't part of that."**
  Not a disagreement with anything below — the analysis stands and the design is
  written. It is a priority call: no tool in THIS shop idles loudly, so nothing
  here blocks a working shop, and it is the kind of feature that is better built
  against a real machine than imagined. Leave §5.4d as the record and come back
  when a CNC exists to test with.

- **A tool that idles LOUDLY needs a threshold, and the schema has nowhere to put
  one (jeff's friend, via jeff, 2026-09-16).** §5.4b concluded there is nothing
  to threshold, because every tool measured has a standby under the noise floor.
  **A CNC router breaks that**: servos at stall current plus a PC, drawing real
  continuous current while cutting nothing. The gate must not open for that, and
  the signal of interest is the step UP when it starts cutting.

  The shape, from §5.4d: **optional** `sensor.ct.thresholdA`, absent keeping
  today's floor-relative trip, **in amps and never watts** (§5.4c measured a PF
  of 0.66 on the collector — a watt threshold would be 34% out). It rides CONFIG
  to the node as a resolved number, which does not breach `nodelink.js`'s
  invariant: the node compares, it does not interpret.

  Two open bits beyond the field itself. **Where the number comes from** — asking
  a woodworker for amps is a poor screen, so a "learn while idling" button that
  records the draw and trips above it is likelier. And **hysteresis**, since a cut
  is not continuous; the collector's coast-down may already cover it.

  The work this displaces: `collector-doc.spec.ts` currently ASSERTS a CT-sensed
  element carries no threshold anywhere, and `test_nodebus.cpp` asserts the CONFIG
  sensor spec is exactly id+kind+channel. Both were right for §5.4b and both have
  to change.

- **Pick a CHANNEL on a multi-channel Tasmota meter (2026-09-10; half done
  2026-09-14).** `TasmotaOutlet::doPoll()` now DETECTS `Power` as an array and
  refuses the plug loudly — unreachable, with a log line naming the EM2/EM6 and
  saying it will not guess a channel — instead of `as<float>()`ing an array to
  0.0 and reporting a working meter as a tool that is never on, forever.

  What is left is the actual feature: `sensor.outlet.channel` (absent = scalar),
  a UI to choose it, and the model/firmware pair to carry it. §6.0 of
  `docs/archive/tool-sensing-rfc.md` lists what else it drags in.

  Still true, and the reason this is not a nice-to-have: **it bites on the FIRST
  EM2, not on the first ganged pair.** The device has two channels in hardware
  whether or not both are clamped, so it answers with an array either way. Until
  the channel work lands, an EM2 is a plug DustGate can see and cannot use — which
  is now at least a visible refusal rather than a silent zero.

- **Documentation: how to set up and use DustGate (jeff, 2026-10-08).** At some point the system needs a guide a woodworker can
  follow — choosing parts, wiring a board, pairing, laying out the shop, calibrating gates, tuning trip points. Start a running
  list of what it must say, as things are learnt. So far:
  - **Choosing a sensor per tool.** A Tasmota (no relay, sense-only) is the slow sensor: it is polled, and its energy chip takes
    over a second to show a rising draw. For a tool used in short bursts (a miter saw), use a Shelly, which pushes its reading on
    change, or a current clamp on the board. Keep Tasmotas for tools that run for minutes (planer, drum sander, table saw).
  - **Servo range is shop-wide** (Settings → Servos): buy the gate servos as one multipack, and recalibrate every gate after
    changing the range.
  - **Optional boards**: a board that only senses a tool can be powered with that tool; the shop does not complain when it is off.

## UI

- **Replace drag-to-branch on a duct with "move this run here" (2026-09-07,
  jeff).** Today, dragging a branch dot tees in a passive leg. The more useful
  gesture is moving the RUN — put it where I want it and keep it there, the way
  moving a tee already works. That is also the honest answer to a run the router
  has drawn somewhere ugly: let the person say where it goes, rather than adding
  another rule to argue with. Needs a story for what "keep it there" means when
  something later moves under it.

- **No way to move a system, so the shop cannot be given breathing room.** Found
  2026-09-07 while rearranging the demo layout by hand: a system owns a contiguous
  row band, and there is no gesture for "push this system down" or for reordering
  two systems. Everything inside the band would have to travel with it. Related to
  the delete-a-system item below — both are missing verbs on a system rather than
  on the pieces in it.

  **Half the machinery now exists** (2026-09-08): `openRows()` in
  build.component.ts does the push, and D-71 drives it from a piece being dropped
  on the seam. What is missing is a way to ASK for it with no piece involved —
  dragging the seam itself, or a menu on the grey ground. Jeff called this
  not critical. It is also the only route to the UPWARD case D-71 deliberately
  left out: a piece dragged up into the seam is itself what closes the gap, so
  reopening one means moving the system above.

- **Move all the setup buttons on the bottom of /shop to a dropdown menu** on the top
  right of the page

- **Moving the whole shop to a new WiFi is a per-board errand nobody is told about**
  aSettings → Forget WiFi resets the PRIMARY only. Each node holds its own
  credentials and has no way to be re-pointed from the app, so a router swap means
  visiting every board in the shop.

  It is not as bad as it looks — a node runs the same `WiFiProvisioner` as the
  primary, so a board that can't join within 12 s **at boot** raises its own
  captive portal and can be re-pointed from a phone. No re-flash needed. Two sharp
  edges make that unusable as-is:

  - **Only at boot.** `maintain()` nudges `WiFi.reconnect()` forever while down and
    never falls back to the portal, so a node that was already running when the AP
    changed sits there retrying a network that no longer exists. You have to know
    to power-cycle it.
  - **Nothing tells you.** The primary can't see a node on a different network, so
    the shop just shows boards "not answering" — the same symptom as a dead board,
    a bad flash, or a hostname collision. Nothing says "these three are on the old
    SSID, go press reset."

  So the cheap version is probably not a fleet-wide push at all: it is `/boards`
  knowing an SSID change just happened and saying which boards haven't reappeared
  and what to do about each. A real push (primary stages new credentials over
  NodeLink before anything moves) is the ambitious version, and has an ordering
  problem — the primary can only reach the nodes on the OLD network, so anything
  that misses the message needs a defined fallback.

- **Finish the collector barrel (2026-08-25).** The glyph itself LANDED — the
  canvas draws a 76x76 violet barrel carrying its own name and its own plug row,
  the impeller is gone, and the router's footprint grew with it
  (`COLLECTOR_HALF`, geometry.ts). Two loose ends:
  - `docs/mockups/canvas.html` was never updated, so the canonical mockup still
    describes the circle. Update it IN PLACE and add a decision-log row. (The
    exploration, `collector-glyph.html`, was archived 2026-10-18.)
  - The collector's live plug row is UNVERIFIED. `systemWatts`/`systemIdOf()` in
    build.component.ts feed it from `status.systems[].plug`, and nothing has ever
    had a plug paired to a collector while the blower drew current — so the green
    "412 W" state has been reasoned about, not seen.

- **Hover tooltips on the canvas glyphs.** Primary vs secondary port, the 1–4
  numbered outlet icons, probably others. Low priority — and hover can't be the
  only way in (see the mockup rules), so whatever this becomes needs a tap path too.

## Parked: the frozen ESP32 brain

**Frozen 2026-10-18 (jeff): the Pi is the brain** — root `CLAUDE.md`. Nothing here is to be worked on unless the ESP32 brain is
revived; if it is, its routes should be rebuilt as a thin shell around `api/ApiCore.h` rather than these copies moved one by
one. `tools/check-brain-parity.js` lists what the frozen brain lacks.

- **Move the ESP32's plug provisioning loop onto `outlets/Provision.h` (2026-10-06).** `SmartOutletControl::provisionPushOutlets()` and
  `outletops::provisionPlug()` are the same rule written twice (probe, read the claim, refuse a plug someone else owns unless a
  takeover was approved, name first, then the push target). The native brain uses the shared one; the ESP still has its own. Move it
  with a bench run (a Shelly paired, a foreign plug left alone, a takeover) because it writes to real plugs.
- **ESP32 routes onto `api/ApiCore.h` (2026-10-18, from the two-brain drift sweep).** The native brain serves ~20 routes through
  `ApiCore.h` (manual switches, jog, pairing, pause, discover, update, the slider-on-a-node routes), tested by
  `test_apicore.cpp`. The ESP32's `HttpApiServer.cpp` still has its own copy of every one, so they can drift with nothing
  failing. `tools/check-brain-parity.js` lists it as KNOWN_DRIFT. Move them a route at a time, each with a bench run on an
  ESP32 brain; or, if the ESP32 brain is retired in favour of the Pi, delete its copies instead. Also from the sweep, ESP32-only
  and fine as long as it is: its subnet sweep has no longer knock or second try for the layout's own plugs (native `Sweep.h` has).
- **The ESP32 primary with the cleanup branch.** Flash it (`./dev.sh flash --fw`, layout backup first) and confirm: the app loads,
  a layout saves and reads back, a **v1 document is refused with a 400**, tool switch-on still opens the gate and starts the
  collector, and the legacy routes are gone without anything the app uses going with them. Only the compile and the host tests have
  seen the firmware changes.
- **Conformance against a real ESP32 primary.** `node shared/device-model/conformance.js http://<primary> <key> --force` and
  `topology-conformance.js http://<primary>`: the cases that drove the deleted legacy routes are gone, and a schemaVersion-1 PUT
  must answer 400.

## Carried debt

- **Two native API e2e checks are timing-sensitive (2026-10-18).** "an unpaired board that dials in is listed by discovery" and
  "telling a node to update sends it the OTA order" (`native/test/e2e_api.sh`) failed once in a full `make -C native test` and
  passed on every rerun. Widen their waits or find what they race.

- **Draw the slider board and the RF transmitter on `docs/carrier-wiring.html` (2026-10-18).** `firmware/WIRING.md` was
  archived as history (`docs/archive/WIRING.md`); the wiring page now covers the PWM carrier only. Two wirings still live
  only in the archive: the slider board (ST3215 half-duplex bus and its logic level, the two NC endstops — archive §7)
  and the 315 MHz HT12E transmitter (archive §10). Draw them with the `wiring-diagram` skill, then nothing current
  points into the archive for a wiring fact.

### Small fixes carried from the 2026-09-08 code review

Moved here 2026-10-18 when the review was archived (`docs/archive/review-2026-09-08.md`, which has the full write-ups
by these numbers). Each was re-checked against the code that day; 1.5, 2.3 and 5.1/7.1 had gone (the link code it named
is gone, the sweep now waits for the release, and the topology backup runs again). Severity as the review gave it.

- **[M] 1.4 — A jog can throw away a routed move.** `NodeSession::jog()` overwrites the single `_txFrame` slot that a
  routed `setState()` may still be holding, so the SET is lost while `_moveOutstanding` stays set and the shop's move
  queue waits out `kMoveTimeoutMs` (210 s). Reachable: jogging a gate in setup while a tool starts elsewhere. Refuse a
  jog while a routed frame is pending, or clear `_moveOutstanding` when its frame is overwritten.
- **[M] 3.2 — Two unpaired constants in the mock.** `tools/mock-api.js` refuses a fourth board with a bare
  `pairedNodes.length >= 3` (the device's is `kMaxPairedNodes`, NodeRegistry.h) and range-checks `/api/servo/jog` with
  `ch >= 4` (the budget is `MAX_SERVOS_PER_HOST` / `SERVO_COUNT`, **2** now). Read both from the model.
- **[M] 5.3 — `spec-runner.js` keeps a hand-maintained suite list.** A new `*.spec.ts` never runs until someone adds it
  (and to `tsconfig.spec.json`). Glob `.spec-test/**/*.spec.js` instead.
- **[L] 2.6 — `LimitSwitchDistance::updateHoming()` has a `delay(20)`** inside a state machine that must never block.
- **[L] 2.7 — Two `kMoveTimeoutMs`.** The driver's (120 s, one bus command) shares a name with NodeLink's (210 s, the
  primary giving up on a node). Rename the driver's to `kCommandTimeoutMs`.
- **[L] 7.4 — `LimitSwitchDistance`'s vestigial state.** `_releaseStart` is a "have we started" flag with a dodge for its
  own zero (make it a bool), and `Phase::BACKING_OFF` is never assigned (the parallel `_backingOff` bool is the state).
- **[L] 3.3 — `mock-api.js` wraps some routes in `runModel()` and not others** (`/api/config/*`,
  `/api/dustcollector/switch`): a model throw there is a dead socket, not a 400.
- **[L] 3.4 — Mock tidiness:** `outletPut`/`outletDel` compile the same regex twice; `mock-node.js`'s `holdAtRest` is a
  `let` never reassigned.
- **[L] 4.6 — `separateLanes()` (build/routing/router.ts) judges later lane groups against geometry an earlier group
  already moved.** Order-dependent; no repro was built.
- **[L] 4.8 — Repeated work in hot paths:** `outletTakenByAnotherMachine()` calls `machineIdOfPort()` per row
  (O(rows² × elements) per keystroke), `healMachineNames()` rebuilds `portsByMachine` per machine, Live calls
  `collectorChip(g)` twice in a row, and Live's `refresh()` has no in-flight guard, so two slow status replies can land
  out of order.
- **[L] 5.4 — The conformance CI scripts clean up three ways:** two use a bare `kill $MOCK_PID`, one
  `kill $NODE_PID 2>/dev/null`.
- **[L] 5.5 — `.gitignore` still lists `.pio/`**; builds live in `.pio.nosync/`.

- **Take NodeLink off the customer's network entirely (jeff, 2026-09-18). "Do we
  need to look at bluetooth or something else that we control, isolated from the
  user's network? this is getting absurd."**

  **THE EVIDENCE IS IN AND IT IS NOT OUR FIRMWARE.** `probe` from the primary to
  the same two node addresses, minutes apart:

  ```
  1. TCP :80   NO ROUTE / refused  (3002ms)
  1. TCP :80   connected  (10ms)     ← then HTTP 404, which is CORRECT:
                                        a node serves only /nodelink
  ```

  Two boards that are up, listening, at -30 dBm, on one subnet. A TCP connect
  cannot become intermittently unroutable because of anything we wrote.

  **THIS IS CLAUDE.md's OWN RULE COLLECTING ITS DEBT.** "Never require anything a
  network is allowed to block." That was written about mDNS and applied to
  DISCOVERY, which degrades to a typed IP. NodeLink itself was never held to it —
  and NodeLink is the part that must work for a gate to open. A guest network is
  allowed to block client-to-client unicast, and this one apparently does so
  sometimes.

  **NOT BLUETOOTH.** BLE is connection-oriented (the same class of state that
  gave us client slots and reconnect storms), short-range in a shop full of
  metal, and coexisting BLE with WiFi on one C5 radio is a known headache. It
  solves the ownership problem and keeps every other problem.

  **ESP-NOW is the candidate.** Connectionless, MAC-addressed, no IP, no DHCP, no
  mDNS, no AP in the path, no client slots to exhaust, no reconnect storm
  possible. NodeLink frames are ~100 bytes of JSON a few times a minute, which is
  exactly what it is for. Everything that failed tonight is a consequence of
  running a connection-oriented IP stack over someone else's network to deliver a
  command smaller than this paragraph.

  What it buys beyond reliability, and this is the part that makes it worth the
  work: **nodes stop joining WiFi at all.** No credentials on a node, no
  provisioning chicken-and-egg, no hostname collisions, no DHCP lease that moves,
  no `_lastIp` cache to go stale, no per-node mDNS resolve taking a shop-wide
  lock. Only the primary is on the customer's network, which is where jeff wanted
  to end up anyway: "I only have to maintain the primary once this is in the real
  shop."

  ⚠️ **The catch, and it is real:** ESP-NOW peers must share a WiFi CHANNEL, and a
  primary joined to an AP has its channel chosen by that AP. So the primary has
  to tell its nodes which channel it is on, and they have to follow when the AP
  moves. That is the whole design problem — everything else is plumbing.

  ⚠️ **And it makes node OTA worse, not better.** 250-byte frames is the wrong
  shape for a 1.35 MB image. Either node OTA stays a WiFi/USB operation, or a
  node briefly joins WiFi to take an update. Decide this BEFORE building, because
  "flash once, maintain the primary" is the other half of the same goal.

  **THE ALTERNATIVE THAT KEEPS THE PROTOCOL: the primary runs softAP+STA and the
  nodes join the PRIMARY's access point.** NodeLink is unchanged — still
  WebSocket, still TCP, still the same frames and tests — and the network is ours
  end to end. Cost is one radio doing two jobs on one channel, which halves
  throughput and puts the UI and the nodes on the same airtime. Cheaper to build,
  more load on the primary, and it keeps the connection-oriented failure modes we
  just spent a night on.

  ⚠️ **BEFORE ANY OF THIS, ONE CHEAP TEST.** Both boards log `channel` and `BSSID`
  at boot as of 2026-09-18. If the primary and a node are on DIFFERENT BSSIDs —
  different bands on a dual-band board, or different mesh radios — then "same
  SSID" was never "same network path", and forcing one band may fix the whole
  thing for the cost of a config line. Isolation normally blocks CONSISTENTLY;
  intermittent points at a path that changes.

- **Stop making serial the primary way to see what a board is doing (jeff,
  2026-09-18).** "It's clunky." It is worse than clunky: roles are pinned one per
  name, so a bench with two nodes cannot even address the second one, and
  watching a primary and a node at once needs two terminals and two USB cables to
  boards that are supposed to be mounted on machinery. A shop board will have no
  cable at all.

  **THE ONE HOOK IS ALREADY THERE.** `DEBUG_PRINT`/`DEBUG_PRINTLN` in config.h are
  macros that currently expand to `Serial.print`. Everything in the tree logs
  through them, so a ring buffer costs one macro change rather than an audit of
  every call site.

  Shape, and the order matters because each step is useful alone:

  1. **A ring buffer on every board**, fed by the macros. Even with no transport
     this is worth having — it is the difference between "what did it say before
     it rebooted" and nothing.
  2. **The primary serves its own** at `/api/logs`, rendered in the app. That
     alone removes the cable for the board that is hardest to reach.
  3. **Nodes ship theirs to the primary**, as an opaque LOG frame on NodeLink.
     Strings only, never interpreted — the node/primary boundary is untouched,
     the same way `sensorId` rides SENSE without meaning anything to the node.
     **Flushed on RECONNECT, not just live**, which is the part that makes it
     replace serial rather than supplement it.

  ⚠️ **THE CASE IT CANNOT COVER IS THE ONE THAT COST AN ENTIRE NIGHT.** When the
  link is down is exactly when a node's log matters, and exactly when it cannot
  reach the primary to send it. 2026-09-17/18 was precisely that bug. So:

  - the ring buffer + flush-on-reconnect is not a nicety, it is the whole point:
    you get the history of WHY the link dropped once it comes back
  - and a second, connectionless path is worth considering — a UDP syslog
    broadcast has no connection state, no client slots to exhaust, and keeps
    working while the WebSocket does not. It is also the only thing that would
    have helped while the node was refusing connections.

  **SERIAL DOES NOT GO AWAY, and pretending otherwise is how this gets built
  wrong.** Provisioning is the chicken-and-egg: a board with no WiFi credentials
  cannot be reached over WiFi, so `pollSerialProvision()` stays permanently. The
  goal is that serial becomes the BOOTSTRAP path and the last resort, not the
  daily one.

  Related and already done: `dev.sh monitor --port /dev/cu.X` (2026-09-18) works
  around the two-role ceiling for now.

- **Should a node stream RAW clamp readings and let the primary decide?
  (jeff asked 2026-09-17 — answered NO for now, with the reasoning, because it
  will be asked again.)** *"Can we have the nodes send raw data back to the
  primary, and let it figure out the threshold? Or is that too much
  communication?"*

  **Bandwidth was never the objection, and it is worth saying so plainly so the
  idea is not dismissed for the wrong reason.** One float at the 4 Hz sample
  cadence is ~100 bytes of JSON per clamp per report: ~400 B/s per sensor, ~4 KB/s
  for a ten-board shop with a clamp on every one. That is nothing on WiFi, and it
  is nowhere near the PING traffic already flowing.

  The real reasons it stayed on the node:

  - **The 60 Hz RMS window cannot move.** It is a busy-wait over ~3.5 mains
    cycles and it is the part that genuinely cannot round-trip — CLAUDE.md's node
    rule ("any control loop faster than a WiFi round trip") puts it on the board
    and that does not change under any of these designs.
  - **So the only thing actually in question is the COMPARISON**, which runs at
    4 Hz — slower than a WiFi round trip, and therefore legitimately the
    primary's by that same rule. The idea is *sound*; it is just that sending the
    three numbers DOWN buys most of the same benefit for a fraction of the
    change, and that is what landed instead.
  - What raw streaming buys over that is real but narrower: the primary could
    change the RULE, not just the numbers — add a debounce, go adaptive — without
    touching a node. Worth revisiting **if the trip rule itself turns out to be
    wrong**, as opposed to its constants.
  - What it costs: the SENSE frame stops being "one bit decided on the node"
    (RFC §5.4b), the floor-learning still has to stay on the board anyway, and
    the primary grows per-sensor state it does not have today.

  **A cheap middle step exists and is probably the right next move if this comes
  back:** SENSE already carries `level` (the reading as a multiple of the trip
  point, diagnostic only). Surfacing that in the GUI gives a live number to tune
  against — which is what was actually missing on 2026-09-16, when there was no
  way to see how close the back massager came — without changing the protocol at
  all.

- **OTA for nodes, so the shop is flashed once — and the numbers say it is nearly
  free. (jeff's goal, 2026-09-17.)** "I'd love to get to a point where the nodes
  can all be flashed, and I only have to maintain the primary once this is in the
  real shop." Measured today rather than estimated:

  | | image | slot it has | what OTA needs |
  |---|---|---|---|
  | node (`huge_app.csv`) | 1.35 MB | ONE 3 MB `app0`, plus 896 KB of spiffs it never mounts | two 1.6 MB slots — **fits the same 4 MB with room to spare** |
  | primary (`partitions-xiao-c5-primary.csv`) | 1.88 MB | one 2.62 MB `app0` + 1.44 MB `ffat` | 2×2.62 + 1.44 = 6.7 MB — needs the flash size raised to **8 MB, which the chip already has** |

  So a NODE can have dual-slot OTA today for the cost of a partition CSV. The
  table it has now spends its whole budget on one oversized slot and a filesystem
  nothing mounts. The primary needs `board_upload.flash_size = 8MB` as well —
  also free: `partitions-xiao-c5-primary.csv` fills 4 MB exactly and the board
  reports 8.

  `otadata` is already in BOTH tables, which is the rollback half and the reason
  a bad push does not brick a board.

  Delivery, in the order that costs least:
  1. New partition tables. Nothing else changes; boards keep working.
  2. The node PULLS over HTTP (`HTTPUpdate`) from the primary, rather than the
     primary pushing over NodeLink. A pull is a plain GET the ESP32 core already
     implements and can verify; a push means chunking a 1.35 MB image through a
     WebSocket we would have to write and get right.
  3. The primary serves it from its filesystem partition — the node image ships
     alongside the Angular bundle, so `dev.sh flash` updates both.
  4. Trigger over NodeLink, and only when it is needed: a node already reports
     its `fw` in WELCOME, so the primary compares and stays quiet when they
     match. That is what makes it "flashed once" rather than "reflashed on every
     boot".

  ⚠️ The node image must be built by the SAME commit as the primary serving it,
  or a shop drifts into two firmwares that disagree about NodeLink. Whatever
  ships the image should stamp it with the git sha the UI already reports.

  **BUILT 2026-10-03. NODE UPDATES ARE PROVEN** (from the Mac brain 2026-10-05, and from the Pi brain for the whole shop
  since 2026-10-11, the slider included on 2026-10-17). The ESP32 primary's own OTA and the rollback paths are not. What exists: both partition tables
  with a second slot (primary 2×2.25 MiB + 3.44 MiB ffat on the 8 MB the chip has;
  node 2×1.9 MiB inside 4 MB); `POST /api/ota` + `dev.sh ota` for the primary,
  with probation/rollback (`utils/OtaGuard`: valid after 30 s healthy, rolled back
  at 3 min if never healthy); `POST /api/node-image` stages node images in ffat;
  the OTA / OTASTATE NodeLink frames (paired, tested); the node pulls with
  `HTTPClient`+`Update` (not `HTTPUpdate`, so the MD5 comes from the frame, not a
  header the static file handler would never set); `POST /api/nodes/update` and an
  Update button on the Boards screen. Manual and one node at a time by decision —
  refused while any collector runs.
  **To prove on hardware:** the one cable pass per board (new partition tables —
  the primary's layout is lost with it, restore from a saved copy); an OTA of the
  primary; a node update; and the unproven rollback paths — flash a deliberately
  bad image and confirm the primary AND a node come back. **Known gap:** an image
  that boots, reaches the primary and then misbehaves is not rolled back (needs the
  cable). Automatic update-when-idle is deliberately not built.

- **Delete the three bench envs? (jeff, 2026-09-17 — deferred, not rejected.)**
  `xiao_c5_bus_bench`, `xiao_c5_ht12e_bench`, `xiao_c5_ct_bench`. Jeff's point,
  and it is the decisive one: **they run the same physical hardware as the
  normal builds.** They are not a different rig — they are a different *program*
  on the same board, and the thing that justified them was that the ordinary
  build could not reach the pad. That stopped being true on 2026-09-16: one pin
  map means every build has `PIN_CT` and `PIN_RF_TX`, and the serial console
  already carries `ct`, `press`, `rfscan`, `stroke` and `servo`.

  So the remaining argument for keeping them is narrow but real: `ct_bench` runs
  with **no WiFi**, which is how the noise floor was measured on 2026-09-15
  (5.80 counts against 6.03 with the radio up — see docs/archive/WIRING.md §8). A bench build
  that removes a known noise source is a measuring instrument, not a duplicate.
  `st3215_bench` sets servo IDs on a new ST3215, which is a real setup task with
  no other home.

  Deferred rather than done because the shop is half-commissioned and the node
  CT path is still unproven; deleting the instrument you would use to debug it
  is the wrong order. Revisit once a clamp has been trusted on hardware. Three
  envs, three `bench/*.cpp` files, and nothing else depends on them — the wiring
  docs were already merged (2026-09-17) without touching the code.

- **Six builds and counting — is the primary/node split worth it? (jeff,
  2026-09-11.)** There are now three primaries and three nodes (servo, slider,
  collector), and the pairs differ only by `-DDUSTGATE_SECONDARY` plus a
  `build_src_filter` that compiles a different sketch. Jeff's question: at what
  point is it simpler to make **everything a primary** and let a build flag say
  "this one is really a node"?

  It is a good question and the answer is not obviously no. The user-facing cost
  is real — six things to pick between, and the difference between them is a
  thing about OUR code rather than about their shop.

  What is actually load-bearing, so a future decision does not rediscover it:

  - **Partitions differ.** A primary carries the Angular bundle in `ffat`
    (`partitions-xiao-c5-primary.csv`); a node uses `huge_app.csv` and has no
    filesystem. Merging means every node ships a web UI it never serves, or the
    partition table stops being a property of the build.
  - **They are different sketches**, not different flags: `firmware.ino` vs
    `node/dustgate_node.cpp`. That was deliberate — see the rationale at the top
    of the node sketch — and a merged build would compile the routing brain,
    topology, plug polling and HTTP server onto boards that use none of it.
  - **8 MB of flash makes the size argument weaker than it was** (see the
    partition item above): the old "a node cannot afford the primary's code" may
    simply not be true any more, and nobody has re-measured it.

  A middle path nobody has costed: keep one BUILD per carrier (servo, slider,
  collector) and make primary-vs-node a **runtime** decision — NVS, or the ID
  resistor below — which would take six envs to three and let a board change
  role without a reflash.

- **Carrier capabilities at runtime — sensed, not tagged (jeff, 2026-09-11; settled 2026-10-29).**
  One firmware, no `-D` flags, no picking the wrong env and chasing a dead servo.
  **No ID resistor, EEPROM or other tag on the board** (jeff, 2026-10-29): a board
  senses what it has or assumes it. The CT by its jack's plug-detect (no plug reads
  railed), the OLED by answering on I²C, and the shop light ring is driven whether
  or not one is plugged in. The one optional part nothing detects is the Banner bin
  sensor, and that stays a setting in the app. (Dropped with it: an ADC ID resistor,
  which D0's CT bias swamps, and a 24C02 or DS2431 tag.)

  **DECIDED 2026-09-15 (jeff): buy nothing, and do this in two stages.**

  The framing that settled it is his: separate **what a board HAS** (servo count,
  bus servo, CT, RF, bin) from **what it IS** (primary or node). Those are
  different questions with different lifetimes and they were tangled together in
  nine `-D` flags.

  - **Stage 1 — capabilities become a RUNTIME STRUCT**, populated from the board
    header exactly as today. Nothing changes behaviourally; every `#if HAS_*`
    consumer stops asking the preprocessor. This is the stage that does the
    collapsing, it is pure software, and **it does not care where the data comes
    from** — which is precisely why no part needs buying to start it.
  - **Stage 2 — change the SOURCE**: from the board header to what the board senses,
    plus the app's bin setting. One function.

  **What collapses and what does not.** `ENABLE_SERVO`, `DUSTGATE_SERVO_BUS` and
  `DUSTGATE_COLLECTOR` are pins and drivers, so they all go runtime.
  `DUSTGATE_SECONDARY` does **not**, and should not: it inverts
  `build_src_filter` into a different program with a different partition table,
  and keeping role at flash time means a board cannot accidentally become a
  second brain. One-brain is an ARBITRATION constraint (CLAUDE.md), not a size
  one. Endgame is **2 shipping builds plus the bench consoles**, from 6 — not the
  1 the "one firmware" phrasing above implies.

  **Do it AFTER the CT path works end to end**, so there is a running system to
  regression-test the refactor against.

- **A single-servo + CT board for 240 V tools (jeff, 2026-09-11).** Jeff has
  already built several single-servo nodes for testing, to save wiring time and
  cost. That is a fourth carrier: one gate, one CT, and the pin budget is easy
  because three PWM channels come back.

  The variant worth thinking about alongside it is **CT-only, no servo** — for a
  240 V tool where the gate is elsewhere. The argument is not cost: it is that a
  CT lead running from the tool to a board that also drives a gate is **a cable
  across the floor**, and a shop floor with a trip hazard on it is a worse
  product than one without. A CT-only board sits at the tool and talks over
  WiFi, so the only wire is its own supply.

  **The CT-only variant is now the live one (2026-09-14).** It has a name and a
  build: §5.6, the planer node — RS-25-5 off the unswitched side of the tool's own
  switch, clamp on the switched side, no actuators. What unblocked it was not the
  noise floor being solved but the question getting smaller: §5.4b closes the
  standby problem by finding there is nothing to measure, so a CT-sensed tool
  carries no threshold field at all and the baseline is the board's own floor.

  What it is waiting on is no longer measurement, it is PROTOCOL — NodeLink has
  no inbound sensor direction and a node is handed no config to describe a CT
  with. §5.6b has the three gaps.

  The single-servo + CT carrier above is unaffected and still undecided.

- **Every C5 partition table assumes 4 MB. The chip is 8 MB (2026-09-09).**
  `esptool flash_id` on the bench primary: `Detected flash size: 8MB`, on an
  ESP32-C5 rev v1.0. Both tables we ship stop at `0x400000` —
  `partitions-xiao-c5-primary.csv` says so in its closing line ("Fills 4 MB
  exactly"), and the nodes' `huge_app.csv` lays out the same 4 MB. **Half the
  flash on every board is unaddressed.**

  Worth more than the free space. That file carries a long comment weighing
  whether the slack should go to the app or to the LittleFS bundle, and reasons
  carefully to "the slack goes to the app" — against a total that was wrong by
  4 MB. The decision is not wrong, but it was never as tight as it reads, and
  the next person to size a partition will trust that comment. Fix the comment
  with the table.

  The bootloader already knows: the board JSON declares `flash_size: 8MB`, so
  only our CSVs are holding the line at 4.

- **OTA updates for our own boards — tabled 2026-09-09, jeff.** (The NODE half
  of this was measured on 2026-09-17 and has its own entry above; this one is
  the PRIMARY's, where the 8 MB claim and the upload UI live. Kept separate
  because the node's is nearly free and the primary's is not.) Feasible and
  roomy once the 8 MB above is claimed: dual OTA slots at the *current* app0
  size (2.62 MB each, 64% used) plus the 1.44 MB bundle is ~6.7 MB of 8, with no
  shrinking and no trimming the Angular bundle.

  Shape, if it gets built: `Update.h` behind a POST on our own `HttpApiServer`
  with an upload control in the UI — the same shape as Tasmota's firmware
  button. **Not `ArduinoOTA`/espota**, which advertises over mDNS and walks
  straight back into the constraint in CLAUDE.md ("never require anything a
  network is allowed to block"); our own HTTP endpoint works anywhere the UI is
  reachable, which is by definition the network it is on.

  Three things that are not incidental:

  - **A partition change cannot be delivered over the air.** Every board needs
    one wired flash to receive the new table. Free today — bench boards, shop
    not in service — and genuinely expensive once a node is mounted in a
    ceiling. That is the argument for doing it *before* the shop goes live, not
    when we happen to want it.
  - **Rollback is not free.** `Update.h` does not validate-and-revert by
    default, and without it a bad image on a node is a board that must come down
    and go on USB. That recovery cost is exactly what argued *against* writing
    custom Tasmota firmware (`docs/archive/tool-sensing-rfc.md` §12.4), so it would be
    dishonest to accept it here without the rollback flag on from the start.
  - **The primary must refuse an update while anything is moving** or the
    collector is running.

- **The C5 has an 802.15.4 radio (2026-09-09).** `esptool` reports `Wi-Fi 6
  (dual-band), BT 5 (LE), IEEE802.15.4` on the board we already ship. Noted
  because the Zigbee/Thread half of the "other smarthome protocols" question in
  `docs/archive/tool-sensing-rfc.md` §11 is not a hardware question — the radio is
  present. Still parked; the near-term job is one shop on one guest network.

- **No right-click menu on a duct.** Every other thing on the canvas has one now.
  A duct would want "add a fitting here" — which the branch dots already do, at the
  same point, so it may be redundant — and "delete this run", which has no
  primitive behind it: removing a duct means deciding what happens to everything
  downstream of it. Left out deliberately until that question has an answer.

- **The outlet picker exists TWICE, and they had already drifted (2026-09-09).**
  `tools/outlet-picker.component.ts` is used by the build canvas (through
  `element-outlet-config`); `tool-setup.component.ts` carries its own inline
  copy for the /tools list. Same interaction — identify-by-power, pick a plug —
  in two implementations, and they don't even agree on the words: "Scan again"
  vs "Rescan", "Which outlet is this one's?" vs "Turn X on — the outlet that
  jumps to green is the one."

  Found the honest way: adding the add-by-address field to the shared component
  changed nothing on /tools, because /tools does not use it. **It had to be
  written twice**, which is the whole argument for collapsing them. The next
  change to either one will hit the same wall, and there is no reason left for
  two — the inline version predates the extracted component.

  **2026-10-06: the /plugs page exists now** and is the intended single home ("Pair to…"); the work left is to replace `tool-setup`'s
  inline picker with a link to it, and then the extracted `OutletPickerComponent` can go too if the canvas tray no longer needs it.
  (Older plan, kept for the wording:) Fold `tool-setup`'s inline picker onto `OutletPickerComponent`. The extracted
  one is the keeper (it already has the `excludeIps`/`excludeReason` inputs);
  what needs porting into it is the plug-row styling and the "already assigned
  to another tool" wording that /tools uses.

- **Hostname collision is guarded in one direction only.** `run_flash_node`
  refuses a node hostname that matches the primary's (`dev.sh`), but a primary
  flash will happily take a name a node is already using, and then the two fight
  over the same mDNS record. The primary flash now confirms the hostname on every
  firmware flash, so this is a prompt away from being catchable.

- **Nothing stops two NODES sharing a hostname either**, which is the harder and
  more valuable half. `next_node_hostname` suggests the next free-looking name,
  but nothing verifies it: flash two boards accepting the default and both answer
  to the same `.local`, the primary reaches exactly one of them, and the symptom
  is a node that "works" while its twin is silently dead. Worth thinking about
  whether an mDNS probe before flashing, a check against the saved topology's
  `link.host` values, or a hostname derived from the chip's MAC is the right
  answer — a MAC-derived default would make collisions structurally impossible,
  at the cost of names nobody can read.

- **Nothing stops two tools or plugs from sharing names.** A tool and a plug may
  share one; two tools or two plugs should not. In general names need to be
  distinct, at least across systems.

  **Wants a brainstorm before code (2026-09-07, jeff).** The questions that have
  to be answered first: is uniqueness per-shop or per-system; which KINDS collide
  (tool vs tool, plug vs plug, gate vs gate, board vs board — and do a tool and a
  gate collide?); what happens to shops already saved with duplicates; and whether
  a duplicate blocks the rename, warns, or auto-suffixes. Names are typed in
  several places (the canvas rename, the tool sheet, the Boards screen), so
  wherever the rule lives it has to be one rule, not four.

## Testing

Nearly all of DustGate compiles and passes host tests without ever having run on
a board. This is the list of what a bench session should actually prove, roughly
cheapest-and-most-unblocking first. Flashing goes through `dev.sh` — see the
`flash` skill for the traps, especially that a filesystem flash erases the saved
shop unless `dev.sh` does the backup for you.

Delete an item once it has genuinely run. "It compiled" is not a pass.

**This list is the critical path now.** Phase 2 merged to `main` on 2026-08-22 —
222 files, and the only things in it proven on hardware are the C5 driving four
servos (bench 1) and the SSD1306 screen. Everything else compiles and passes host
tests, which is not the same claim. The newest arrival is the sharpest example:
running a blower BY HAND (D-59) opens a path through the ordinary move queue
before it starts the collector, so it exercises exactly the code a bench session
would reach first — and no gate has ever moved for it.

### Needs the shop (the real tools, real plugs and the real network)

Things that cannot be settled at a desk: they need the actual machines, the actual plugs on the shop's network, or the whole shop
running at once. Added 2026-10-06 from the cleanup and the features built after the bench session. Delete an item once it has run.

- **Plug identity and relocation on the Pi (2026-10-18).** Deploy the Pi brain, then: (1) the Table Saw's entry still points at
  .64, where the new Tasmota now is — the problems list should say "A different plug has Sawstop's address", the Plugs page show
  the Table Saw row with that note and the Tasmota free under Found, the canvas tray offer it, and the brain log say it is not
  polling or claiming it; (2) every plug paired without a MAC gets one written into the layout within a minute (`[RELOCATE]
  recording the MAC`), Shellys included; (3) switch the Sawstop Shelly on wherever it now is: a sweep finds it and the Table Saw
  is pointed at it by elimination (no MAC on file), and the problem clears; (4) with every plug's MAC recorded, swap two Tasmotas'
  DHCP reservations and reboot them: both are found again by MAC and neither reads the other's tool in between; (5) a sweep from
  the Plugs page lists the Miter Saw's Tasmota every time (the layout's own plugs get a longer knock and a second try).
  Host-tested (`test_relocate.cpp`) and end-to-end against a fake Shelly (`native/test/e2e_identity.sh`) only. The ESP32 brain
  runs the same policy and only compiles (frozen).

- **Set up the slider on its node from the app (2026-10-07).** `/gates` → the slider → pick the manifold → each outlet: the
  first move homes the gate (it runs to the end and back), then jog, capture, Test from the review and from the Gates list.
  Then switch on a tool on that slider and confirm the gate goes to its captured outlet. Host-tested only (`test_slider_setup.cpp`).
- **Save the layout while a tool runs (2026-10-07).** Change a trip point in Tools with the saw going: the blower stays on, no
  gate moves, and when the saw stops the blower coasts and the brain presses it OFF. Host- and e2e-tested only.
- **Pick the second collector's plug by its draw (2026-10-07).** Switch it on, tap Scan again in the collector sheet: its plug's
  watts should rise, and the Pi itself should not be in the list.
- **Clear shop and Delete system release real plugs.** Build a second system with a tool on a real Shelly, delete the system, SAVE,
  and confirm the plug stops pushing to the brain and its old push address is back (D-77). Also that Undo before Save leaves the
  plug alone.
- **The Plugs page against the real network.** `/plugs` with the shop's plugs: live draw matches the plug, a Tasmota that stops
  answering shows "Not answering", **Sweep network** finds a Tasmota on the real /24, add-by-address, rename a Shelly and read the
  new name in the Shelly app (this is also bench test 20), release one, and take over a plug another brain owns.
- **The per-board clamp switch with a real clamp.** Switch a board's clamp on, pair a tool to it, confirm SENSE arrives; switch it
  off with the tool paired (the confirm appears) and confirm the tool stops being sensed and the layout no longer names the clamp.
- **An interrupted gate move is sent again.** Brown out or reset a node mid-move (pull its power while the servo travels), let it
  relink, and confirm the gate is commanded again and ends where the layout says. Host-tested only (`test_deviceproblems.cpp`).
- **The collector sensed by a CT clamp** — still unproven (README's hardware list).
- **Find plugs on a real /24 takes how long, and does a request time out?** The sweep is about a minute; nothing has timed a whole
  run in the app against real hardware.

### Bench Testing (at a desk, USB and a few boards)

**Bench items from the 2026-10-06 cleanup** (before the older list below):
- **A node's move fault edge.** On a node with a servo, reset it mid-move and watch the brain log: one `move-failed` problem, one
  re-send, then it clears. A second reset after it cleared should re-send again.
- **A clamp board with the switch off.** Flash a node with a CT lead, leave the switch off, and confirm no clamp line shows and the
  clamp is not offered to a tool.
- **Pad D3 / D9.** The V1 PCB wires both: J6 puts D3 on a header, and SW2 (with J8 beside it) sits on D9. On the first V1 board, check boot with each line held both ways.

**2. NodeLink — the happy path passes, THE FAIL-SAFE HAS NEVER BEEN TRIED.**

The link itself: ✅ **passed 2026-08-23** on a C5 primary driving a C5 node —
paired, gate assigned to a node channel, and the node moves when the primary
resolves the angle. **Routing from a real tool passes too**: a tool drawing
power opens its gate, the first time the whole chain has run end to end.

**Still open, and it is the half that matters with a tool actually running:**
kill the primary mid-move. Pass = every servo **HOLDS** where it is. No timeout
closing gates, no homing on reconnect, no autonomous behaviour at all. A node
that tidies up after a lost primary can shut a gate under a running tool, which
is the dead-head the whole system exists to prevent.

Two minutes with both boards already on the bench, so there is no good reason
for this to keep waiting behind bigger items.

**3. Certify real firmware against the conformance suite.** This is the one that
tells you whether firmware has drifted from `shared/device-model/` — the whole
point of the suite. DESTRUCTIVE (it homes, moves and wipes), so it refuses a
non-localhost target without `--force`:
```bash
node shared/device-model/conformance.js http://dustgate.local <api-key> --force
```
Should be green. If it isn't, it has found real drift, which is a result, not a
failure of the test.

**4. The three resilience fixes, all compile-only since 2026-07-28.** Each has one
specific thing to try:
- *WiFi auto-recovery* — pull the AP, wait, bring it back. Pass: it rejoins with
  no power cycle (`WiFiProvisioner::maintain()` nudges `WiFi.reconnect()` every
  10 s while down).
- *Own-IP-change recovery* — force a DHCP lease change. Pass: Shelly push
  recovers instead of dialing a dead URL forever
  (`SmartOutletControl::checkLocalIpChange()`).
- *Main-loop watchdog* — induce a hang. Pass: `esp_task_wdt` reboots it inside
  ~10 s.

**4b. The layout backup survives a RENAME.** The backup read the hostname being
flashed TO rather than the one the board answers to, so renaming a board could
never back itself up — it aborted instead (correctly) and the deploy stopped.
Fixed 2026-08-20 by probing the old name first (`backup_candidates()` in
`deploy.sh`), and verified only against a fake HTTP board. Pass: flash a board
under a NEW hostname with a shop saved on it, and confirm the layout comes back
after the reboot.

**5. The multi-system shop on hardware.** Model, firmware and UI all shipped
without a hardware pass. Draw a two-collector shop, save it to a real device,
power-cycle, and confirm it comes back intact and routes per system.

**6. The 4" Rockler profile.** BLOCKED — needs a built 4" slider. `rockler-4`
(pitch 127 mm) is derived by the same method that validated 2.5" and has never
been measured. Also still open: pitch uniformity past 2 gates.

**It is NOT disabled in the UI, and this item said it was until 2026-09-08.** Two
different controls got conflated. What IS disabled is the **port size** dropdown
on /settings — `<option value="4in" disabled>4" (soon)</option>`. What is not is
the **manifold profile** picker in the linear calibrator, where `Rockler 4"
manifold — 127 mm between outlets` is a live, selectable option
(`MANIFOLDS` in gates/linear-calibration.component.ts) that will run a reference
sweep against an unmeasured pitch and place every gate from it. Nothing in the
code gates it. Decide which way that goes — grey it out to match /settings, or
leave it selectable and accept that the sweep is the measurement — but do not
re-read this item as a promise that the UI already refuses.

**8. The wake button — a press on D1 lights the panel.** What that leaves:
- **The toggle's off half.** Press-again-to-blank was written after that test and
  has never been pressed. `statusscreen::toggle()`; the pass is that a second
  press puts the panel out and the next real event still lights it.
- **A held button through reset.** D1 uses the internal pull-up and a plain
  momentary to GND. The pad is safe at reset (the C5's straps are 26/27/28),
  which is why D1 was chosen — worth confirming a held button doesn't stop it
  booting anyway.
- Pass: pressing it lights a blanked screen within a beat, and a button held down
  through reset does **not** light the screen at boot (`begin()` seeds from the
  pin for exactly that).

**9. What the screen work has and hasn't touched hardware.** Proven: the SSD1306
on D4/D5 at 0x3C, and the wake button on D1. Not proven: the toggle's off half,
and the pads nothing has been attached to — D0/D3, and D6 (ST3215 bus).
Everything the build actually drives is confirmed by a working signal.

**10. A XIAO C5 as a PRIMARY — BOOTED on hardware 2026-08-22.** First run of the
primary sketch with `HAS_LINEAR == 0`. What the boot log proved: it comes up,
`NullMotorDriver`/`NullFeedback` report clean (`linear=refused gates=ok
plugs=ok`), LittleFS mounts, the API server listens on port 80, servo bring-up is
ready. Two bugs it found, both fixed the same day — the FAULT indicator latching
on a board with no rack, and the pre-topology outlet→stop machinery running a
full move/arrive round trip against a carriage that doesn't exist.

**It serves the UI, and well** (2026-08-22) — the single-core worry did not
materialise: async web server, Shelly poll task and loop() together, and the page
is responsive. Servos move. That was the gate on retiring the other variants, and
it is passed; see [[c5-everywhere-architecture]] for the env cleanup that unlocks.

**Both scans work** (2026-08-23) — the setup wizard lists real Shelly plugs and
/boards lists the real node. Two bugs stood in the way and both are fixed: the
deferred-reply pattern 501s on the ESP32Async fork the C5 pulls in, and the mDNS
window (400ms plugs / 800ms nodes) was far too short for this network — 3000ms
finds everything first try. Details in the commit messages and MdnsQuery.h.

**NodeLink out to a secondary passes** (2026-08-23), which was the last untested
part of the primary role. See bench item 2.

Still open on this board:
- **The collector refusal on the self-test has not been exercised.** All four
  channels sweep on both a primary and a node (2026-08-22), which also confirms
  the `_deenergize()` fix — repeated moves on one channel is exactly what the
  sweep does. What nobody has tried is holding the button *while the collector
  runs* and confirming it refuses rather than moving anything.
- The API still advertises the linear vocabulary — position, homing, stops — to a
  UI on a board that has none. Now user-visible, since the UI loads.
- Routing a real gate end to end from a topology, rather than servo bring-up.

**11. The collector takes 5-10 seconds to notice a tool (2026-08-23).** Real
complaint from a real bench run, and it is a latency problem, not a correctness
one — the gate opens and the collector starts, just late enough to be annoying.

Our own budget only explains ~1.5s of it: one 500ms reconcile
(`OUTLET_POLL_INTERVAL_MS`) plus the 1000ms `OUTLET_ON_DEBOUNCE_MS`. The wake-on-
push already exists, so a reading is acted on the tick it lands.

The structural suspect is in `SmartOutletControl::doPoll()`:

```cpp
if (!o->isPushConnected()) o->poll();
```

A push-connected plug is **never** HTTP-polled, so once the WebSocket is up the
500ms poll stops and detection latency becomes whatever cadence the plug chooses
to report `apower` at. If a Gen4 plug reports power periodically rather than on
change, push is not a slower path than polling — it is the only path, and the
poll that would have caught it is switched off.

**Measure before touching either number.** `plugtrace` on the primary's console
timestamps every frame a plug sends; the gaps between `[PUSH]` lines are the
plug's cadence, and `[DEBOUNCE] committed after Xms` is our half. Then:
- *Plug slow to report* → poll a plug whose last push is stale, so push
  accelerates detection but never gates it. This is the likely fix.
- *Plug reports promptly* → the time is between `[PUSH]` and `[DEBOUNCE]`, and
  the debounce is the knob. Don't shrink it blind: it is there to stop motor
  inrush from false-triggering a gate.

Board-independent — nothing here is specific to the C5 or blocks it.

### GUI Testing

Everything here has run in the demo (`bash dev.sh demo`) and nowhere else. What
these need is the UI served off the device's LittleFS, against a real saved shop
— the demo can't catch a persistence or round-trip fault.

**1. Boards on the canvas round-trip.** New this session, and it changed the saved
shape: `ui.wiring.boards` went from `Record<id, number>` (a dead rail slot) to
`Record<id, Cell>`. Drag a board to a deliberate cell, Save, power-cycle the
device, reload. Pass: the board is where you put it. Also load a shop saved
BEFORE today — its boards carry numbers, which are dropped on purpose, so they
should land top-right of their system rather than stacking or vanishing.

**2. A board's cell is exclusive.** Try to drop a gate on a board, and a board on
a gate, and a board on a cell a duct runs through. Pass: all three refused, with
the thing in the way named in the guide bar. Then check a duct actually routes
around a board rather than through it.

**3. Gate setup saves each pane on its own.** The bug this fixed was `saved.emit()`
firing only from the calibration widget. Open a gate, change ONLY the board (or
only the name), Save that pane, close. Pass: the change survives — and confirm it
survives a device round-trip, not just the sheet closing.

**4. `pickBoard()` with a second board actually paired.** The defect was the fifth
gate drawn colliding on channel 0 while a second board sat idle. Pair two boards,
draw five gates, and confirm the fifth lands on the second board and the layout
saves. This one genuinely needs two boards paired on the device — the demo's
board list is simulated.

**5. Live view against real hardware.** `bash dev.sh live` (hot reload proxied to
the real device) and confirm the tool list, manual override, and gate state track
what the hardware is doing.

- **Node-owned plug polling: BUILT 2026-10-03, run on a bench node 2026-10-04 with no load** (see "Prove node-owned plug
  polling under a real load" above). Not in use in the shop as of 2026-10-17: no node polls a plug. The board
  that controls a tool polls that tool's plug (rule: `plugOwners`, jeff: "the brain
  polls boards until they're assigned to a tool"). CONFIG sensors gain kind `plug`
  (ip, shelly|tasmota, thresholdW); SENSE gains `watts` and `plug`; WELCOME gains
  `caps.plug`. The node runs a poll task on its own (`TasmotaOutlet` /
  `ShellyGen2Outlet` compiled into the node under `DUSTGATE_NODE_PLUG_POLL`) and
  reports on change + every 5 s; the brain stops polling those outlets, takes the
  watts through the same `setMachinePower`, and a node that is stale or cannot reach
  the plug reads as off + unreachable. Plugs beyond a node's 4 sensor slots, and any
  plug on a node that lacks `caps.plug`, stay brain-polled.
  **Unmeasured / to check on hardware:** the node's HTTP poll cadence with 3-4 plugs
  (one task, sequential, 400 ms timeout each — a dead plug delays the others by that
  much); whether the CT's 60 Hz window suffers (separate task, WiFi on the same
  core); the brain's heap saving; reachability text when the NODE is the one that
  is down (it says the plug is unreachable, and board-offline is raised beside it).
  **Gaps:** Shelly push-provisioning still runs from the brain for node-polled
  Shellys; `RemoteActuatorBus::configureSensors` copies only channel for a clamp
  (the CT tuning ratios are built by the runtime but never reach the wire — worth
  checking before anyone believes retuning from the primary works).
