jeff-engineers/dustgate/firmware/firmware.ino

// =============================================================================
// firmware.ino — the PRIMARY sketch. The routing brain.
//
// Target: XIAO ESP32C5, in either of its two personalities. Which one is a
// property of the BOARD, derived from the pin map, and the sketch is the same
// either way:
//
//   xiao_c5_primary         four PWM ball valves, HAS_LINEAR 0
//   xiao_c5_linear_primary  one ST3215 on a serial bus + two endstops,
//                           HAS_LINEAR 1
//
// Configuration is entirely in config.h; the pin map is boards/xiao_c5.h.
// Libraries come from platformio.ini, not the Arduino Library Manager — and
// AccelStepper/TMCStepper are deliberately ABSENT. Nothing here generates steps
// any more; the rack is a serial bus servo.
//
// (This header named an ESP32-S2 Feather and a TMC2209 breakout until
// 2026-08-28. Neither had been a target since the fleet was retired on
// 2026-08-23, and the stepper itself was deleted the same day.)
//
// State machine:
//   STARTUP → HOMING → IDLE → MOVING → AT_STOP
//                                  ↑___________|
// =============================================================================

#include <EEPROM.h>
#include "utils/OtaGuard.h"  // OTA probation + rollback
#include "utils/Watchdog.h"  // main-loop task watchdog (unattended-hang recovery)
#include "config.h"
#include "utils/MotionMath.h"
#include "utils/StatusLed.h"
#include "utils/StatusScreen.h"   // optional SSD1306; compiles to nothing unfitted
#include "utils/WakeButton.h"    // the button that lights it; ditto
#include "utils/BinSensor.h"     // dust-bin level: debounce + whose bin it is
#include "motor/ServoSelfTest.h"  // and, held for a second, sweeps every servo
#include "motor/MotorDriver.h"
#include "feedback/FeedbackSystem.h"
#include "control/ControlInput.h"
#include "control/OutletSweep.h"
#include "control/OutletRelocate.h"
#include "control/NodeLinkPlan.h"
#include "control/CollectorPress.h"        // the retry policy for a stateless press
#include "control/RfCollectorPresser.h"    // ...the presser that keys THIS board's pad
#include "control/RemoteRfPresser.h"        // ...and the one that asks a NODE to key its own
#include "control/RfAddressGuess.h"        // the four ways a DIP gets copied wrong
// UNCONDITIONAL since 2026-09-17, where these used to sit behind #ifdef PIN_CT.
// A primary with no clamp of its own still has to TELL its nodes what tuning to
// use, and sensing::TripParams is where those numbers live — gating the include
// on this board's pin map would mean a gate brain could not name the constants
// it ships to a collector node. Both are header-only and nothing here
// instantiates a CtSensor without a pad; the clamp itself is still #ifdef'd.
#include "sensing/CtSensor.h"     // `ct` — the clamp on this board's own pad
#include "sensing/CtTrip.h"       // ...and the one shared "is it running?"
#include "sensing/ClampJack.h"    // ...and whether one is plugged in at all
#include <driver/gpio.h>          // gpio_pullup_en, for D0
#include "control/FaultPolicy.h"   // which begin() failure costs which capability
#include "training/CalibrationStore.h"

// WiFi provisioning — included for any mode that needs network access.
// Handles first-boot captive portal and subsequent NVS credential lookup.
#if defined(CONTROL_SMART_OUTLET) || defined(ENABLE_HTTP_API)
  #include "utils/WiFiProvisioner.h"
#endif
// The link log — every node link up/down, WiFi join/drop, rejoin and boot, kept on
// flash so a shop can run for days with no laptop attached. See utils/LinkLog.h.
#include "utils/LinkLog.h"
#include "utils/SerialLog.h"
#include "utils/BuildStamp.h"   // what this board is running — banner, /api/info, link log
#include "esp_heap_caps.h"   // internal DRAM in the hourly link-log line

// HTTP API server — runs alongside any control mode when ENABLE_HTTP_API is set.
#ifdef ENABLE_HTTP_API
  #include "api/HttpApiServer.h"
  HttpApiServer apiServer;
#endif

// =============================================================================
// Runtime stop positions — single source of truth used by all feedback systems.
// Populated at startup from EEPROM (if valid) or STOP_DISTANCES_MM in config.h.
// =============================================================================
float g_stopPositionsMM[NUM_STOPS + 1];

// Highest stop index actually trained/saved — see MotionMath.h for why this
// is tracked separately from g_stopPositionsMM's raw values.
int g_numTrainedStops = 0;

// Runtime gate count — set by setup wizard via set_num_gates API, stored in NVS.
// MUST remain <= NUM_STOPS; array bounds are determined at compile time.
int g_numActiveStops = 0;   // 0 = unconfigured

// g_homeDirection is GONE (2026-08-28) — homing direction is now derived from
// g_homeIsMaxEndstop by homeDirection() in config.h. The auto-detect that used to
// maintain it existed for the stepper, where a swapped coil pair reverses
// rotation; a keyed serial-bus connector cannot be wired backwards. Read the
// HOME_DIRECTION block in config.h before reintroducing anything like it.

bool g_notHomedWarnShown = false; // suppress repeated "not homed" warnings

// Dual-endstop calibration + port roles (declared extern in MotionMath.h).
uint8_t g_stopRoles[NUM_STOPS + 1];
float   g_measuredStepsPerMM = 0.0f;   // 0 = not calibrated → status reports nominal
long    g_measuredSpanSteps  = 0;      // 0 = not calibrated
char    g_manifoldModel[16]  = "custom";
bool    g_homeIsMaxEndstop   = false;  // which endstop is the HOME datum = the user's
                                       // LEFT. false = PIN_ENDSTOP_HOME, true =
                                       // PIN_ENDSTOP_MAX. Chosen during first-home setup
                                       // so the carriage ALWAYS homes to the user's left;
                                       // gates are then numbered 1..N left→right from it.

// Default all roles: home at 0, unassigned elsewhere.
static void resetStopRoles() {
    for (int i = 0; i <= NUM_STOPS; i++) g_stopRoles[i] = (i == 0) ? ROLE_HOME : ROLE_UNASSIGNED;
}


void loadCalibration() {
    CalibrationData cal;
    if (CalibrationStore::load(cal)) {
        for (int i = 0; i <= NUM_STOPS; i++) {
            g_stopPositionsMM[i] = (i <= (int)cal.numStops) ? cal.stopMM[i]
                                                             : cal.stopMM[cal.numStops];
        }
        // Restore active gate count from cal (may be overridden by NVS below in setup)
        if (cal.numStops > 0 && (int)cal.numStops <= NUM_STOPS)
            g_numActiveStops = (int)cal.numStops;
        g_numTrainedStops = (int)cal.numStops;
        // Dual-endstop fields: roles, manifold model, measured span/steps-per-mm.
        for (int i = 0; i <= NUM_STOPS; i++) g_stopRoles[i] = cal.stopRole[i];
        strlcpy(g_manifoldModel, cal.manifoldModel, sizeof(g_manifoldModel));
        g_measuredStepsPerMM = cal.measuredStepsPerMM;
        g_measuredSpanSteps  = (long)(cal.maxTravelMM * cal.measuredStepsPerMM);
        g_homeIsMaxEndstop   = (cal.homeIsMaxEndstop != 0);
        DEBUG_PRINTLN(F("Loaded calibration from EEPROM."));
        CalibrationStore::print(cal);
    } else {
        // No calibration yet — zero all positions. Setup wizard will call
        // save_stop for each gate to populate them via the HTTP API.
        memset(g_stopPositionsMM, 0, sizeof(g_stopPositionsMM));
        g_numTrainedStops = 0;
        resetStopRoles();
        strlcpy(g_manifoldModel, "custom", sizeof(g_manifoldModel));
        g_measuredStepsPerMM = 0.0f;
        g_measuredSpanSteps  = 0;
        // Keep g_homeIsMaxEndstop as-is: the datum side is chosen during first-home
        // setup and persisted independently below.
        DEBUG_PRINTLN(F("No calibration data — awaiting setup wizard."));
    }
}


// Reference-sweep parameters, captured when a /api/calibrate request is consumed
// and used by the STATE_HOMING → STATE_CALIBRATING flow.
char  g_calModel[16] = "custom";
int   g_calGateCount = 0;
bool  g_calibratePending = false;   // calibrate requested → home, then sweep

// Physical gate-to-gate pitch (mm) for a manifold model, or 0 for custom/unknown.
static float manifoldPitchMm(const char* model) {
    if (strcmp(model, "rockler-2.5") == 0) return MANIFOLD_2_5_GATE_PITCH_MM;
    if (strcmp(model, "rockler-4")   == 0) return MANIFOLD_4_GATE_PITCH_MM;
    return 0.0f;
}

// A model string is "recognised" if it names a real profile or the explicit
// 'custom' fallback. Anything else (e.g. a typo like 'rockler2.5') still runs as
// custom — span recorded, no auto-placement — but the caller warns so the typo
// isn't silently swallowed.
static bool isKnownManifoldModel(const char* model) {
    return manifoldPitchMm(model) > 0.0f || strcmp(model, "custom") == 0;
}

// Rockler manifolds ship in 2-gate units → physical gate count is EVEN. Round an
// odd request up (the extra port is a spare the user caps/leaves unused). Gated on
// having a real pitch profile, so 'custom' (no fixed geometry) is left as entered.
// Mirrors shared/device-model physicalGateCount().
static int physicalGateCount(const char* model, int n) {
    if (manifoldPitchMm(model) > 0.0f && (n % 2) != 0) n += 1;
    // No clamp here any more (2026-09-05). Callers already refuse anything above
    // NUM_STOPS before they get here, and the round-up above cannot carry an
    // in-range count out of range because NUM_STOPS is even — asserted in
    // config.h. A clamp would silently hand back a different rack than the one
    // asked for, which is exactly the failure this change was made to remove.
    return n;
}

// Defined below, once `feedback` exists. Declared here because the calibration
// math above it needs the backoff the homing sweep actually used.
long homingBackoffSteps();

// Finish the reference sweep: given the measured far-endstop trigger position (in
// steps, from home datum 0), place all gates and persist. See the placement
// derivation in docs/archive/dual-endstop-calibration.md. Span-based: absorbs per-build
// steps/mm + endstop-location variance; pitch is the fixed manifold property.
static void finishCalibrationSweep(long farTriggerSteps) {
    long farSpanSteps     = farTriggerSteps < 0 ? -farTriggerSteps : farTriggerSteps; // home→far
    // The ACTUAL backoff, not the nominal one. The datum sits however far off the
    // near trigger point the switch needed to release, and homing extends the
    // backoff until it does — so using the HOME_BACKOFF_STEPS constant here would
    // under-measure the span by the extra and shift every gate (2026-08-28).
    long backoff          = homingBackoffSteps();
    long triggerSpanSteps = farSpanSteps + backoff;              // near→far triggers
    float spm = stepsPerMM();                                    // nominal (validated ~0.3%)

    // ── SANITY-CHECK THE SPAN BEFORE ANYTHING IS SAVED ──────────────────────
    //
    // A measured span has to be big enough to hold the gates that were asked
    // for. If it is not, the sweep did not measure the rail — and the numbers it
    // produces are not merely imprecise, they are actively dangerous: on
    // 2026-08-28 a far-trigger position that read as 0 gave span=1.4mm and put
    // gate 1 at -125mm, which was written to EEPROM and then drove the carriage
    // into an endstop on the next commanded move.
    //
    // Refusing here is the difference between a calibration you re-run and a
    // stored table that hurts the machine every time it is used. The board keeps
    // whatever calibration it already had.
    {
        float measuredMm = (float)triggerSpanSteps / spm;
        float pitch      = manifoldPitchMm(g_calModel);
        // The gates alone, with no margin at all — anything at or below this is
        // arithmetically impossible, never mind tight.
        float neededMm   = (pitch > 0.0f) ? (float)(g_calGateCount - 1) * pitch : 10.0f;
        if (measuredMm < neededMm) {
            Serial.println(F("[CAL] ✗ REFUSED — the measured span cannot hold the gates asked for."));
            Serial.print(F("      measured ")); Serial.print(measuredMm, 1);
            Serial.print(F("mm, need at least ")); Serial.print(neededMm, 1);
            Serial.print(F("mm for ")); Serial.print(g_calGateCount);
            Serial.println(F(" gates."));
            Serial.println(F("      The sweep did not measure the rail. Nothing has been saved;"));
            Serial.println(F("      the previous calibration is untouched. Check that both"));
            Serial.println(F("      endstops trigger ('e'), then home and calibrate again."));
            g_calibratePending = false;
            return;
        }
    }

    g_measuredSpanSteps  = triggerSpanSteps;
    g_measuredStepsPerMM = spm;
    g_numActiveStops     = g_calGateCount;
    strlcpy(g_manifoldModel, g_calModel, sizeof(g_manifoldModel));
    resetStopRoles();
    for (int i = 1; i <= NUM_STOPS; i++) g_stopPositionsMM[i] = 0.0f;

    float pitchMm = manifoldPitchMm(g_calModel);
    if (pitchMm > 0.0f) {
        // Center the (N-1)*pitch gate array in the measured trigger-to-trigger span.
        // Work in mm-from-home (positive = away from home). Near trigger sits
        // backoffMm toward home from the datum (negative); gate1 is slack/2 past it.
        float backoffMm = (float)backoff / spm;
        float slackMm   = ((float)triggerSpanSteps / spm) - (float)(g_calGateCount - 1) * pitchMm;
        float gate1Mm   = -backoffMm + slackMm / 2.0f;
        for (int i = 1; i <= g_calGateCount && i <= NUM_STOPS; i++) {
            g_stopPositionsMM[i] = gate1Mm + (float)(i - 1) * pitchMm;
        }
        g_numTrainedStops = g_calGateCount;
        // Gates are numbered from the home datum outward. Because home is always the
        // user's LEFT endstop, Gate 1 is always the leftmost gate — no reversal.
        DEBUG_PRINT(F("[CAL] placed gates: gate1=")); Serial.print(gate1Mm, 2);
        DEBUG_PRINT(F("mm pitch=")); Serial.print(pitchMm, 1);
        DEBUG_PRINT(F("mm span=")); Serial.print((float)triggerSpanSteps / spm, 1);
        DEBUG_PRINTLN(F("mm"));
    } else {
        // Custom manifold — record the span but leave gate positions for manual jog.
        g_numTrainedStops = 0;
        DEBUG_PRINTLN(F("[CAL] custom manifold — span recorded, gates via manual jog."));
    }

    CalibrationData cal;
    cal.magic   = CALIB_MAGIC;
    cal.version = CALIB_VERSION;
    cal.numStops = (uint8_t)g_calGateCount;
    cal.maxTravelMM = (float)triggerSpanSteps / spm;
    cal.measuredStepsPerMM = spm;
    for (int i = 0; i <= NUM_STOPS; i++) cal.stopMM[i]   = g_stopPositionsMM[i];
    for (int i = 0; i <= NUM_STOPS; i++) cal.stopRole[i] = g_stopRoles[i];
    cal.stopMM[0] = 0.0f;
    cal.homeIsMaxEndstop = g_homeIsMaxEndstop ? 1 : 0;
    strlcpy(cal.manifoldModel, g_calModel, sizeof(cal.manifoldModel));
    CalibrationStore::save(cal);
}

// Persist g_homeIsMaxEndstop (which endstop is the home datum) into CalibrationData,
// creating a minimal record if none exists yet so the choice survives a reboot even
// before calibration has run.
static void persistHomeDatum() {
    CalibrationData cal;
    if (!CalibrationStore::load(cal)) {
        cal.magic              = CALIB_MAGIC;
        cal.version            = CALIB_VERSION;
        cal.numStops           = (uint8_t)g_numActiveStops;
        cal.maxTravelMM        = 0.0f;
        cal.measuredStepsPerMM = stepsPerMM();
        memset(cal.stopMM, 0, sizeof(cal.stopMM));
        for (int i = 0; i <= NUM_STOPS; i++) cal.stopRole[i] = (i == 0) ? ROLE_HOME : ROLE_UNASSIGNED;
        strlcpy(cal.manifoldModel, g_manifoldModel, sizeof(cal.manifoldModel));
        for (int i = 0; i <= NUM_STOPS; i++) cal.stopMM[i] = g_stopPositionsMM[i];
        cal.stopMM[0] = 0.0f;
    }
    cal.homeIsMaxEndstop = g_homeIsMaxEndstop ? 1 : 0;
    CalibrationStore::save(cal);
}

// The two raw endstop pins, and the ONLY place they are read. Everything above
// them — the datum/far mapping, the debounced logging, the status JSON — goes
// through these, so a board with no endstop pins needs no #if of its own.
//
// A board without a rack reads both as FALSE, not "triggered". That is the
// opposite of the fail-safe convention on a real switch (NC, so open reads as
// triggered and a broken wire stops the motor) and deliberately so: there is no
// wire to break and no motor to stop, and "triggered" would put an unfitted
// board into the over-travel branch on its first pass of loop().
#if HAS_LINEAR
static inline bool readEndstopHome() { return digitalRead(PIN_ENDSTOP_HOME) == HIGH; }
static inline bool readEndstopMax()  { return digitalRead(PIN_ENDSTOP_MAX)  == HIGH; }
#else
static inline bool readEndstopHome() { return false; }
static inline bool readEndstopMax()  { return false; }
#endif

// Physical read of the endstop currently serving as the HOME datum (the user's left).
static inline bool datumSwitchTriggered() {
    return g_homeIsMaxEndstop ? readEndstopMax() : readEndstopHome();
}
// Physical read of the far endstop (opposite the datum).
static inline bool farSwitchTriggered() {
    return g_homeIsMaxEndstop ? readEndstopHome() : readEndstopMax();
}

// -- Motor driver --
// Which one is a property of the BOARD, not of the env: HAS_LINEAR comes from
// whether the pin map wires the serial-servo bus. See motor/NullMotorDriver.h.
#if HAS_LINEAR
  #include "motor/st3215/ST3215LinearDriver.h"
  ST3215LinearDriver motor;
#else
  #include "motor/NullMotorDriver.h"
  NullMotorDriver motor;
#endif

// -- servo bring-up (ball-valve gates) --
// Four positional servos on the reserved PWM pins (25/26/27/14 on DevKitC).
// Signal only — servos powered from an EXTERNAL 5–6V rail, grounds common.
#include "motor/ServoActuator.h"
#if defined(ENABLE_SERVO) && defined(SERVO_PWM_PIN_1)
ServoActuator g_servos[SERVO_COUNT];
static const int SERVO_PINS[SERVO_COUNT] = { SERVO_PWM_PIN_LIST };
#endif

// -- Feedback system --
// Same seam as the motor above, and the same board property decides it: a rack
// means two endstops, and no rack means nothing to home. The #error this used to
// carry is gone for good — "no feedback type" is a legitimate board, not a
// misconfiguration.
#if HAS_LINEAR
  #include "feedback/LimitSwitchDistance.h"
  LimitSwitchDistance feedback;
#else
  #include "feedback/NullFeedback.h"
  NullFeedback feedback;
#endif

// How far the last homing sweep backed off the datum switch. Wrapped rather than
// reached for directly so the calibration math above can be written before the
// feedback object exists.
long homingBackoffSteps() { return feedback.backoffSteps(); }

// -- Control input --
#ifdef CONTROL_SMART_OUTLET
  #include "control/SmartOutletControl.h"
  SmartOutletControl control;

  // Outlet discovery — used by the /api/outlets/discover handling in loop()
  // below. Must run on this (the main loop) task; see HttpApiServer.cpp's
  // /api/outlets/discover route comment for why.
  #include "utils/MdnsQuery.h"
  #include "outlets/ShellyGen2Outlet.h"
  #include "outlets/OutletFactory.h"  // kind -> driver, and the wire spelling
  #include "outlets/ShellyDeviceName.h"
  #include "outlets/PlugClaim.h"        // RFC §8 — who owns a plug (discovery reports it)
#elif defined(CONTROL_SERIAL_DEBUG)
  #include "control/SerialDebugControl.h"
  SerialDebugControl control;
#else
  #error "No control type defined in config.h"
#endif

// Supplemental serial command processor — active alongside any primary control
// mode when ENABLE_SERIAL_COMMANDS is set.  When CONTROL_SERIAL_DEBUG is the
// active mode the primary `control` object already handles serial input; no
// second instance is needed.
#if defined(ENABLE_SERIAL_COMMANDS) && !defined(CONTROL_SERIAL_DEBUG)
  #include "control/SerialDebugControl.h"
  SerialDebugControl _serialCmds;
#endif

// =============================================================================
// E-stop
// Software-only: set via the 'estop' serial command or HTTP API. No physical
// e-stop button — this hardware isn't powerful enough to need one.
// =============================================================================
volatile bool g_eStopTriggered = false;

// ── Faults are PER CAPABILITY ──────────────────────────────────────────────
//
// Three independent things can fail in begin(), and they disable different
// amounts of the shop. Collapsing them into one latch meant a board whose WiFi
// mutex failed to allocate also refused to home the rack — two subsystems that
// share no wire.
//
//   g_faultMotor     the drive itself failed to come up. On a slider board that
//                    is ST3215LinearDriver::begin() — the UART, the servo's
//                    answer to a ping, or the stepping-mode write. It prints the
//                    specific one on its own [ST3215] lines just above.
//   g_faultEndstops  limit switches. There IS a motor, but homing it without a
//                    reference is how you drive a carriage into its own end.
//   g_faultOutlets   WiFi / Shelly plugs. Nothing mechanical about it, and
//                    unlike the other two it can come back on its own —
//                    WiFiProvisioner::maintain() reconnects unattended.
//
// What each blocks:
//
//   linear motion (home, jog, move, calibrate)  motor OR endstops
//   servo gates + routing                        NEITHER — see below
//   the FAULT indicator                          motor OR endstops
//
// SERVO GATES ARE DELIBERATELY UNGATED BY ALL OF THIS. They are on their own
// rail with their own driver, and a shop whose stepper died still opens and
// closes every ball valve it has. Nothing in LocalActuatorBus / TopologyRuntime
// / NodeBus consults these flags, and nothing should start: on a bench board,
// stepper power comes and goes far more often than the shop is actually broken,
// and taking the gates down with it is the failure that costs an afternoon.
bool g_faultMotor    = false;
bool g_faultEndstops = false;
bool g_faultOutlets  = false;

// Derived: "do not command the stepper". Latched for the boot like the facts it
// is built from. Kept as its own variable rather than a function because every
// linear-motion entry point already reads it by this name, and the point of the
// split is to change WHICH failures set it — not to churn twenty call sites.
bool          g_hardwareFault  = false;

// Re-attempt whatever failed at boot, and clear what can be cleared.
//
// THE FAULT FLAGS ARE LATCHED FOR THE BOOT ON PURPOSE — the one-shot [INIT] line
// scrolls away long before anyone notices motion is refused, so a refusal has to
// be able to say why. But "latched for the boot" was the wrong lifetime for a
// SERIAL BUS SERVO, which is a device on a cable, not a chip soldered next to
// the MCU. Plugging USB into the board first and the servo lead in second is the
// ordinary bench order, and it left the board dead until someone power-cycled
// it and lost the log they were reading.
//
// So the latch stays, and this is the deliberate way out of it. Called by the
// `reset` command and automatically by `home`, because homing is the one
// operation that cannot proceed without a working drive and is always something
// a person asked for.
//
// Declared here, defined after the motor object exists.
bool retryDrive(const char* why);

// Which begin() stage failed, latched for the life of the boot. The one-shot
// [INIT] line at startup scrolls away long before anyone notices motion is
// refused, so every refusal repeats it: "motor" is the drive failing to start
// (the ST3215 bus on a slider board), "endstops" the limit switches, "outlets"
// WiFi/Shelly.
char          g_faultStages[40] = "";

// =============================================================================
// State machine
// =============================================================================
enum State {
    STATE_STARTUP,
    STATE_HOMING,
    STATE_IDLE,
    STATE_MOVING,
    STATE_AT_STOP,
    STATE_CALIBRATING,   // dual-endstop reference sweep (home already done)
    STATE_DISABLED,
    STATE_ERROR
};

State currentState = STATE_STARTUP;
int   currentStop  = -1;

// Defined here rather than at the declaration above so it sits below `motor`,
// `feedback` and the fault globals it touches.
bool retryDrive(const char* why) {
    Serial.print(F("[RETRY] re-attempting the drive ("));
    Serial.print(why);
    Serial.println(F(")..."));

    faults::Stages stages;
    stages.outlets = g_faultOutlets;   // WiFi recovers on its own; don't disturb it

    // The drive first: on a bus board this re-opens the UART, re-pings the
    // servo, re-asserts stepping mode and cycles torque (which is what clears a
    // latched overload after a carriage has been driven into a hard stop).
    const bool okMotor = motor.reconnect();
    stages.motor = !okMotor;

    // Then the endstops. Cheap, and a loom reseated at the same time as the
    // servo lead is exactly the case worth re-reading.
    const bool okFeedback = feedback.begin(&motor);
    stages.endstops = !okFeedback;

#if !HAS_LINEAR
    const bool kRackFitted = false;
    stages.motor = false;
#else
    const bool kRackFitted = true;
#endif
    const faults::Policy policy = faults::decide(stages, kRackFitted);

    g_faultMotor    = stages.motor;
    g_faultEndstops = stages.endstops;
    g_hardwareFault = policy.linearMotion;

    g_faultStages[0] = '\0';
    if (stages.motor || stages.endstops || stages.outlets) {
        snprintf(g_faultStages, sizeof(g_faultStages), "%s%s%s",
                 stages.motor    ? (HAS_LINEAR ? "motor(ST3215 bus) " : "motor ") : "",
                 stages.endstops ? "endstops " : "",
                 stages.outlets  ? "outlets(WiFi/Shelly) " : "");
    }

    // The position is gone either way — reconnect() drops it, because a servo
    // that was unplugged or overloaded is a servo whose count stopped being true
    // at a moment nobody observed. Say so, and put the state machine back where
    // an unhomed board belongs so nothing moves on a stale datum.
    currentStop      = -1;
    g_eStopTriggered = false;
    feedback.resetHoming();
    if (currentState != STATE_HOMING) currentState = STATE_STARTUP;

    if (!g_hardwareFault) {
        Serial.println(F("[RETRY] drive is up. NOT HOMED — type 'home' to find the datum."));
    } else {
        Serial.print(F("[RETRY] still faulted: "));
        Serial.println(g_faultStages);
    }
    return !g_hardwareFault;
}

int   targetStop   = 0;

// =============================================================================
// Idle power-off — see HttpApiServer::idleTimeoutSec(). Reset on every real
// move/home command; if it goes unrefreshed past the configured timeout while
// otherwise idle, the driver is fully disabled and the position marked
// unknown, forcing a rehome (reuses the existing "not homed" gating below)
// before the next move rather than sitting energized indefinitely.
// =============================================================================
unsigned long g_lastActivityMs = 0;
bool          g_driverAsleep   = false;

// Forward declarations
void issueMove(int stop);

// Whether this board has a carriage to move at all. A compile-time constant
// rather than #if at each site, for the same reason NullMotorDriver is a null
// object: the state machine stays readable and the compiler folds the branches
// away. HAS_LINEAR comes from the pin map — see config.h.
//
// NullMotorDriver already makes the MOVE harmless; this is about the STATE
// machine around it. Without it a rackless board announces "Moving to stop 0",
// drops into STATE_MOVING, is told by NullFeedback that it has arrived, and logs
// "Arrived at stop 0" — a complete round trip through machinery for hardware it
// hasn't got, once per outlet event. Seen on a XIAO C5 primary, 2026-08-22.
static const bool kRackPresent = (HAS_LINEAR != 0);
void startHoming();
#ifdef ENABLE_HTTP_API
static void startNodeUpdate(const char* id);
static void resetEverything();
#endif
void setHomedLeft(bool homedLeft);

// Was the FAR switch already triggered when this sweep began?
//
// A carriage parked at the far end of the rail — where the last session left it —
// starts homing with that switch already made, and calling that a fault would
// fail a home that is about to work perfectly well. Until the switch has RELEASED
// at least once, a far reading is just where we started.
static bool g_farMadeAtHomeStart = false;

// How long the far switch has read triggered, IN MILLISECONDS.
//
// It was a count of consecutive loops, which is not a debounce at all: loop()
// runs thousands of times a second, so "3 loops" is under a millisecond. A
// carriage sweeping 0.7mm off a switch it was parked on chattered once at the
// release edge and that was enough to trip the check (2026-08-28). Time is the
// unit that means something here; 40ms matches the endstop transition logger.
static uint32_t g_farSinceMs = 0;
static const uint32_t kFarConfirmMs = 40;

// Where the sweep started, and how far the carriage must get from there before a
// far-switch reading is believed.
//
// The parked-on-the-switch flag alone is not enough, because it clears the
// instant the contact opens — and a switch sitting at its release edge on a rig
// with a millimetre of slop opens and closes repeatedly. Distance is the honest
// discriminator: a sweep genuinely running the wrong way reaches the far switch
// after real travel, while a release-edge chatter happens within a millimetre of
// where it started.
static long g_homeSweepStartPos = 0;
static const float kFarConfirmMinTravelMm = 10.0f;


// =============================================================================
// Topology runtime — the routing brain wired to actual hardware.
//
// Until now the routing engine (TopologyRouter/Sequencer/Controller) existed
// only for the host conformance tests: nothing in the sketch included it, and
// GET /api/status served an idle stub. This is the wiring that makes a
// stored topology actually move valves.
//
//   SmartOutletControl (plug watts)
//        → TopologyRuntime (brain + move queue)
//            → NodeBus (which board drives this selector?)
//                → LocalActuatorBus → g_servos[] / the rack
//
// NodeBus registers no remotes yet, so every selector resolves to the local bus.
// Adding a secondary board later registers a RemoteActuatorBus and changes
// nothing above this line — that's the whole point of the seam.
// =============================================================================
#include "control/LocalActuatorBus.h"
#include "control/SenseReport.h"   // addSenseArray() — why it is not in this file is in that one
#include "control/NodeBus.h"
#include "control/RemoteActuatorBus.h"
#include "control/NodeStatus.h"
#include "control/DeviceProblems.h"
#include "control/CollectorDriver.h"
#include "outlets/OutletOps.h"
#include "control/TopologyRuntime.h"
#include "control/NodeRegistry.h"
#include "control/TopologyStore.h"

// The rack, as LocalActuatorBus needs to see it. Deliberately does NOT reuse
// issueMove()/STATE_MOVING: those are the stop-index path, and a topology
// linear state is an absolute mm position with no stop index behind it. The
// always-on endstop over-travel supervisor at the top of loop() still protects
// this move, and stop-following is suppressed while a topology is loaded
// (see STATE_IDLE / STATE_AT_STOP) so the two can never fight over the motor.
class SketchLinearDrive : public topo::LinearDrive {
public:
    bool moveToMm(float mm) override {
        if (g_hardwareFault || g_eStopTriggered) return false;
        if (currentStop == -1) return false;      // not homed — mm has no datum yet
        g_lastActivityMs = millis();
        g_driverAsleep   = false;
        motor.moveTo((long)(mm * stepsPerMM() * -HOME_DIRECTION));
        return true;
    }
    bool isMoving() const override { return motor.isMoving(); }
};

static SketchLinearDrive      g_linearDrive;
static topo::LocalActuatorBus g_localBus;
static topo::NodeBus          g_nodeBus;
#if HAS_BIN
// One bin per board, because it is one pin. A shop with two collectors and one
// board between them is a wiring problem before it is a schema one.
static topo::BinDebounce       g_binDebounce;
#endif
#ifdef PIN_CT
// File scope, not a function-local static in the console handler, and the reason
// is the settle clock: CtSensor::begin() has to run at BOOT so the 3 s bias
// window is measured from power-up. A static inside the `ct` command would start
// it at the first time a human typed `ct`, which is always long after the bias
// has arrived — the clock would be permanently, invisibly correct and would
// never do its job on the path that needs it.
static CtSensor g_ct(PIN_CT);

// The decision on top of that measurement, and the SAME copy the node runs —
// see sensing/CtTrip.h for why this is not a second implementation. A clamp on
// the primary's own board is the ordinary collector case: the board at the
// cyclone watches the blower it also commands.
static sensing::CtTrip g_ctTrip;
// Is a clamp plugged into THIS board's jack (sensing/ClampJack.h) — the brain's own row on the Boards screen, and the
// clamp-unplugged problem when the layout uses it. Probed whether or not a clamp is configured, as a node does.
static sensing::ClampJack g_jack;
#endif
static topo::TopologyRuntime  g_topoRuntime;
static topo::TopologyStore    g_topoStoreSketch;   // read-only view; the API server owns writes

// Secondary links. A fixed pool rather than dynamic allocation: each one owns a
// FreeRTOS task and a socket.
//
// TEN since 2026-09-16, up from three. Three came from the RFC's "2–4 nodes",
// which assumed a board per WALL driving four gates each. The shop that actually
// got drawn puts a board on each MACHINE — six secondaries plus a sense-only
// board on the planer — and the old cap did not complain: syncPairedNodes just
// stopped at three and the rest of the shop reported un-commandable gates.
// Whatever the ceiling is, it must be a number a real layout cannot quietly
// exceed. Ten costs ~40 KB of task stack if every slot is filled
// (kNodeLinkTaskStack, RemoteActuatorBus.cpp) plus a socket each; only slots
// that DIAL cost anything, so an empty slot is the array entry alone.
#define MAX_SECONDARY_NODES 10
// The pool is ALLOCATED, in PSRAM, on first use — it was a static array of ten, 18.8 KB
// of the board's scarce internal RAM held whether or not ten nodes exist. A link task
// reaches its bus only by pointer, and the object holds a mutex handle and a socket
// client, nothing a task needs in internal RAM (its stack still is). Falls back to
// internal RAM if there is no PSRAM; if even that fails there are simply no links.
static topo::RemoteActuatorBus* g_remoteBuses = nullptr;
static bool ensureRemotePool() {
    if (g_remoteBuses) return true;
    const size_t bytes = sizeof(topo::RemoteActuatorBus) * MAX_SECONDARY_NODES;
    void* mem = heap_caps_aligned_alloc(16, bytes, MALLOC_CAP_SPIRAM | MALLOC_CAP_8BIT);
    if (!mem) mem = heap_caps_aligned_alloc(16, bytes, MALLOC_CAP_INTERNAL | MALLOC_CAP_8BIT);
    if (!mem) { DEBUG_PRINTLN(F("[NODE] No memory for the link pool — no node will link.")); return false; }
    g_remoteBuses = static_cast<topo::RemoteActuatorBus*>(mem);
    for (int i = 0; i < MAX_SECONDARY_NODES; i++) new (&g_remoteBuses[i]) topo::RemoteActuatorBus();
    return true;
}
// HIGH-WATER MARK of the pool, not a count: a node removed from the middle leaves a
// free slot (see syncPairedNodes). Anything walking the pool asks remoteLive(i).
static int                     g_remoteCount = 0;
static inline bool remoteLive(int i) { return g_remoteBuses[i].live(); }
static int remoteLiveCount() { int n = 0; for (int i = 0; i < g_remoteCount; i++) if (remoteLive(i)) n++; return n; }

// Which boards this primary is paired with. Persisted in NVS, independent of any
// topology — see NodeRegistry.h.
static topo::NodeRegistry      g_nodeRegistry;

// Dial every PAIRED node. Driven by NodeRegistry (NVS), not by the topology —
// see NodeRegistry.h for why the two were separated. Called once at boot and
// again whenever the pairing set changes, NOT on topology adopt: a layout edit
// must never tear down a healthy link.
//
// Keyed by host throughout. The link neither knows nor cares what a layout calls
// this board; NodeBus maps controllerId → host when a topology is adopted.
// Host with a user-confirmed takeover waiting to be sent, or "" for none.
// Consumed by syncPairedNodes BEFORE the bus dials, because the HELLO that
// carries the claim goes out on connect — arming after begin() would be a race
// against the socket, and losing it would silently drop the one thing the user
// explicitly asked for.
static String g_pendingTakeoverHost;
// Links paused from the API (POST /api/nodes/pause): syncPairedNodes() then wants NO
// links, so every one is stopped while the pairings stay in the registry. Resets on boot.
static bool g_linksPaused = false;


static void syncPairedNodes() {
    const String ownId = WiFiProvisioner::getHostname();   // the brain's own id: what every node is paired to
    const char* primaryId = ownId.c_str();
    if (!ensureRemotePool()) return;
    // INCREMENTAL, since 2026-10-03. This used to stop every link and dial them all
    // again on any change to pairing: adding a 3rd and 4th node dropped every linked
    // node each time, took the heap to ~2 KB while tasks and sockets were rebuilt,
    // and left no gate commandable meanwhile. Now only the link that changed moves
    // (control/NodeLinkPlan.h). A link task is never moved in memory — it holds a
    // pointer to its bus — so removal leaves a FREE SLOT that the next pairing reuses.
    std::vector<std::string> live, wanted;
    for (int i = 0; i < g_remoteCount; i++) if (remoteLive(i)) live.push_back(g_remoteBuses[i].host());
    for (int i = 0; i < g_nodeRegistry.count(); i++) {
        const char* host = g_nodeRegistry.host(i);
        if (host && *host) wanted.push_back(host);
    }
    if (g_linksPaused) wanted.clear();
    const nodelinks::Plan plan = nodelinks::plan(live, wanted, std::string(g_pendingTakeoverHost.c_str()));

    // ASK ALL, THEN WAIT FOR EACH. end() waits for its link task to leave on its
    // own, which can be seconds for a node that is dark; asking every task first
    // means those seconds overlap instead of adding up.
    std::vector<int> stopping;
    for (int i = 0; i < g_remoteCount; i++) {
        if (!remoteLive(i) || !nodelinks::has(plan.stop, g_remoteBuses[i].host())) continue;
        g_remoteBuses[i].requestStop();
        stopping.push_back(i);
    }
    for (int i : stopping) {
        DEBUG_PRINT(F("[NODE] Unlinking ")); DEBUG_PRINTLN(g_remoteBuses[i].host());
        g_remoteBuses[i].end();
    }

    uint32_t startOffsetMs = 0;
    for (const std::string& host : plan.start) {
        int slot = -1;
        for (int j = 0; j < MAX_SECONDARY_NODES; j++) if (!remoteLive(j)) { slot = j; break; }
        if (slot < 0) { DEBUG_PRINT(F("[NODE] No free link slot for ")); DEBUG_PRINTLN(host.c_str()); continue; }
        if (slot >= g_remoteCount) g_remoteCount = slot + 1;
        topo::RemoteActuatorBus* bus = &g_remoteBuses[slot];
        if (g_pendingTakeoverHost.length() && g_pendingTakeoverHost == host.c_str()) {
            bus->requestTakeover();          // one-shot; cleared as the HELLO is built
            g_pendingTakeoverHost = "";
            DEBUG_PRINT(F("[NODE] TAKEOVER armed for ")); DEBUG_PRINTLN(host.c_str());
        }
        // Seed the fallback BEFORE begin(): the link task's first resolve reads
        // it, and at boot, with a querier that has often only just come up, the
        // cached address is frequently the only thing that answers.
        for (int i = 0; i < g_nodeRegistry.count(); i++)
            if (host == g_nodeRegistry.host(i)) { bus->setLastIp(g_nodeRegistry.lastIp(i)); break; }
        // One link every 1.2 s: all of them at once peaked the heap at 3.7 KB.
        bus->setStartDelay(startOffsetMs);
        startOffsetMs += 1200;
        // Just after boot, give every node 10 s to dial in before dialling it ourselves — see
        // setBootGrace. A board the user pairs later is dialled at once.
        if (millis() < 30000UL) bus->setBootGrace(10000);
        bus->begin(host.c_str(), primaryId, host.c_str(), 80);
    }

    // The NodeBus map is rebuilt from the live set: plain bookkeeping, no link is
    // touched by it.
    g_nodeBus.clearRemotes();
    for (int i = 0; i < g_remoteCount; i++)
        if (remoteLive(i)) g_nodeBus.registerRemote(std::string(g_remoteBuses[i].host()), &g_remoteBuses[i]);

    DEBUG_PRINT(F("[NODE] Paired nodes: ")); DEBUG_PRINT(remoteLiveCount());
    DEBUG_PRINT(F(" linked-or-dialling (kept ")); DEBUG_PRINT((int)plan.keep.size());
    DEBUG_PRINT(F(", started ")); DEBUG_PRINT((int)plan.start.size());
    DEBUG_PRINT(F(", stopped ")); DEBUG_PRINT((int)plan.stop.size()); DEBUG_PRINTLN(F(")"));
}

// ── NODE-INITIATED LINKS (2026-10-04) ───────────────────────────────────────
// A node that has lost us dials this primary's /nodelink listener, says JOIN, and
// is bound to the bus that pairs it. No task and no per-node address on this side:
// it is one socket on the async_tcp task. See RemoteActuatorBus::attachInbound and
// docs/archive/nodes-dial-the-brain-plan.md.
// Below this much free INTERNAL RAM a JOIN is answered 'busy'. The app floor is 28 KB (the page guard);
// a node costs ~3.5 KB, so leave room for that plus the page.
static const size_t kJoinMinFreeBytes = 24000;

static topo::RemoteActuatorBus* busForNode(const char* nodeId) {
    if (!g_remoteBuses || !nodeId || !*nodeId) return nullptr;
    const std::string want = topo::bareHost(nodeId);
    for (int i = 0; i < g_remoteCount; i++)
        if (remoteLive(i) && topo::bareHost(g_remoteBuses[i].host()) == want) return &g_remoteBuses[i];
    return nullptr;
}

static void sendRefuse(AsyncWebSocketClient* c, const char* reason) {
    StaticJsonDocument<64> d;
    topo::nodelink::buildRefuse(d.to<JsonObject>(), reason);
    String s; serializeJson(d, s);
    c->text(s);
    c->close();
}

static bool nodeEventHook(AsyncWebSocketClient* c, AwsEventType type, void* arg, uint8_t* data, size_t len) {
    if (!g_remoteBuses || !c) return false;
    if (type == WS_EVT_DISCONNECT || type == WS_EVT_ERROR) {
        for (int i = 0; i < g_remoteCount; i++)
            if (g_remoteBuses[i].ownsInbound(c->id())) { g_remoteBuses[i].detachInbound(c->id()); return true; }
        return false;
    }
    if (type == WS_EVT_PONG) {
        for (int i = 0; i < g_remoteCount; i++)
            if (g_remoteBuses[i].ownsInbound(c->id())) { g_remoteBuses[i].onInboundPong(); return true; }
        return false;
    }
    if (type != WS_EVT_DATA) return false;

    // Already a node's socket: every frame on it belongs to its bus.
    for (int i = 0; i < g_remoteCount; i++) {
        if (!g_remoteBuses[i].ownsInbound(c->id())) continue;
        AwsFrameInfo* info = (AwsFrameInfo*)arg;
        if (info->final && info->index == 0 && info->len == len && info->opcode == WS_TEXT)
            g_remoteBuses[i].onInboundFrame(reinterpret_cast<const char*>(data), len);
        return true;
    }

    // Not yet: is this a JOIN?
    AwsFrameInfo* info = (AwsFrameInfo*)arg;
    if (!(info->final && info->index == 0 && info->len == len) || info->opcode != WS_TEXT) return false;
    StaticJsonDocument<192> d;
    if (deserializeJson(d, data, len)) return false;
    if (strcmp(d["t"] | "", "JOIN") != 0) return false;
    if ((d["v"] | 0) != topo::nodelink::kVersion) { sendRefuse(c, "busy"); return true; }
    // A CAP ON HANDSHAKES WE WILL TAKE WHEN MEMORY IS SHORT. After a primary reboot every
    // node redials within a second or two; if the heap is already thin, taking the whole
    // herd at once is what turns a reboot into a 503 page. Turning one away costs it
    // nothing — it backs off and tries again — and "busy" says why.
    if (heap_caps_get_free_size(MALLOC_CAP_INTERNAL) < kJoinMinFreeBytes) {
        DEBUG_PRINT(F("[NODE] JOIN from ")); DEBUG_PRINT(d["nodeId"] | "?"); DEBUG_PRINTLN(F(" — low on memory, told to retry"));
        sendRefuse(c, "busy");
        return true;
    }
    topo::RemoteActuatorBus* bus = busForNode(d["nodeId"] | "");
    if (!bus) {
        DEBUG_PRINT(F("[NODE] JOIN from ")); DEBUG_PRINT(d["nodeId"] | "?"); DEBUG_PRINTLN(F(" — not paired, refused"));
        sendRefuse(c, "not-paired");
        return true;
    }
    String hello;
    if (!bus->attachInbound(c, hello)) {
        DEBUG_PRINT(F("[NODE] JOIN from ")); DEBUG_PRINT(bus->nodeId()); DEBUG_PRINTLN(F(" — already linked, refused as a duplicate"));
        sendRefuse(c, "duplicate");
        return true;
    }
    c->text(hello);
    return true;
}

// The beacon: "DGB1|<primaryId>|<ip>|<port>" to the subnet's broadcast address, so a
// node that has lost us can find us without mDNS, a cached address, or anyone's
// router settings. Quick while any paired node is down, a slow heartbeat otherwise
// (a node that joins the network later, or reboots, still learns where we are).
static WiFiUDP  g_beaconUdp;
static uint32_t g_beaconAtMs = 0;
static void tickBeacon() {
    if (!g_remoteBuses || WiFi.status() != WL_CONNECTED) return;
    bool any = false, anyDown = false;
    for (int i = 0; i < g_remoteCount; i++) {
        if (!remoteLive(i)) continue;
        any = true;
        // Only a REQUIRED board hurries the beacon: an optional one (a planer's sensor board, powered with the planer) is
        // off for days at a time, and would otherwise keep it at 5 s forever (docs/archive/optional-nodes-plan.md).
        if (!g_remoteBuses[i].health().linked &&
            !(g_topoRuntime.loaded() &&
              topo::isOptionalBoard(g_topoRuntime.topology(), topo::controllerIdForHost(g_topoRuntime.topology(), g_remoteBuses[i].host()))))
            anyDown = true;
    }
    if (!any) return;
    const uint32_t now = millis();
    if (now - g_beaconAtMs < (anyDown ? 5000UL : 60000UL)) return;
    g_beaconAtMs = now;
    char buf[96];
    const IPAddress ip = WiFi.localIP();
    snprintf(buf, sizeof(buf), "DGB1|%s|%u.%u.%u.%u|80", WiFiProvisioner::getHostname().c_str(), ip[0], ip[1], ip[2], ip[3]);
    if (g_beaconUdp.beginPacket(WiFi.broadcastIP(), topo::nodelink::kBeaconPort)) {
        g_beaconUdp.write((const uint8_t*)buf, strlen(buf));
        g_beaconUdp.endPacket();
    }
}

// ── REJOIN WIFI WHEN THE NETWORK, NOT THE NODE, IS THE PROBLEM ──────────────
//
// A STOPGAP FOR A NETWORK WE DO NOT CONTROL, added 2026-09-27 and not yet seen
// firing on hardware. Twice that evening the shop's guest network stopped
// forwarding from the primary to a node that was plainly alive (a laptop reached
// it in 10 ms; the primary's TCP timed out), and only a RESET — the primary
// rejoining WiFi — cleared it. This does the rejoin without the RESET.
//
// Only when the node is EVIDENTLY ALIVE (RemoteActuatorBus::LinkHealth): down a
// full minute, and either its mDNS name answered in that minute or sockets to it
// keep opening and dying before the upgrade. A node that is merely switched off
// with its tool shows neither, and is left alone — rejoining for it would drop
// every plug's connection for nothing, every few minutes, all day.
//
// Rate-limited shop-wide, because a rejoin is a few seconds with no network for
// ANYTHING on this board, and because if it does not help, doing it faster will
// not either. If a rejoin turns out not to clear it, the next step is a restart
// — deliberately not taken here: a restart drops routing state mid-run, and
// nobody has yet seen whether the cheaper fix works.
static const uint32_t kRejoinAfterDownMs   = 60000;
static const uint32_t kRejoinMdnsFreshMs   = 60000;
static const uint16_t kRejoinHollowDrops   = 3;
static const uint32_t kRejoinMinIntervalMs = 300000;

static void rejoinWifiIfNetworkBlocksNodes() {
    static uint32_t lastRejoinMs = 0;
    static uint32_t rejoins      = 0;
    static uint32_t lastCheckMs  = 0;
    const uint32_t now = millis();
    if (now - lastCheckMs < 2000) return;          // cheap, but no need every pass
    lastCheckMs = now;
    if (WiFi.status() != WL_CONNECTED) return;     // maintain() owns a real outage
    if (lastRejoinMs && (now - lastRejoinMs) < kRejoinMinIntervalMs) return;

    // A LINKED NODE IS PROOF THE NETWORK PATH WORKS. This rule exists for a network
    // that stops forwarding between boards — and such a network stops forwarding to
    // EVERY board, so one healthy link says the problem is the dark node, not the
    // network. Without this, any shop with a node switched off or flashing on a
    // bench (its cached address answering as "alive" through hollow connections)
    // rejoined WiFi every minute and tore down every healthy link with it —
    // seen 2026-10-04 with nine nodes paired and three linked (wifi_down reason 8
    // at 63 s, then link_down on all three). Only when NOTHING is linked is "the
    // network is isolating us" a live hypothesis.
    for (int i = 0; i < g_remoteCount; i++) {
        if (remoteLive(i) && g_remoteBuses[i].health().linked) return;
    }

    for (int i = 0; i < g_remoteCount; i++) {
        if (!remoteLive(i)) continue;
        const topo::RemoteActuatorBus::LinkHealth h = g_remoteBuses[i].health();
        if (h.linked || h.refused || h.downForMs < kRejoinAfterDownMs) continue;
        const bool mdnsAlive   = h.mdnsAgeMs  <= kRejoinMdnsFreshMs;
        const bool hollowAlive = h.hollowDrops >= kRejoinHollowDrops;
        if (!mdnsAlive && !hollowAlive) continue;  // most likely just switched off

        lastRejoinMs = now;
        rejoins++;
        DEBUG_PRINT(F("[WiFi] REJOINING (#")); DEBUG_PRINT(rejoins);
        DEBUG_PRINT(F(") — ")); DEBUG_PRINT(g_remoteBuses[i].host());
        DEBUG_PRINT(F(" has been unreachable ")); DEBUG_PRINT(h.downForMs / 1000);
        DEBUG_PRINT(F("s but is alive ("));
        if (mdnsAlive) { DEBUG_PRINT(F("mDNS answered ")); DEBUG_PRINT(h.mdnsAgeMs / 1000); DEBUG_PRINT(F("s ago")); }
        if (mdnsAlive && hollowAlive) DEBUG_PRINT(F(", "));
        if (hollowAlive) { DEBUG_PRINT(h.hollowDrops); DEBUG_PRINT(F(" hollow connections")); }
        DEBUG_PRINTLN(F(") — the network is likely isolating us."));
        {
            char extra[96];
            snprintf(extra, sizeof(extra), "\"n\":%lu,\"downMs\":%lu,\"mdnsAgeMs\":%ld,\"hollow\":%u",
                     (unsigned long)rejoins, (unsigned long)h.downForMs,
                     h.mdnsAgeMs == UINT32_MAX ? -1L : (long)h.mdnsAgeMs, (unsigned)h.hollowDrops);
            linklog::event("rejoin", g_remoteBuses[i].host(), extra);
        }
        WiFi.reconnect();
        return;                                    // one rejoin covers every node
    }
}

// Problems the status reports (control/TopologyRuntime.h raiseProblem). Raised
// every pass and refreshed in place, cleared the moment the cause is gone — a
// problem that outlives its cause is as bad as one that never appeared.
// Boards and plugs only: the RF press raises its own where it happens.

// Memory watch. The internal heap is the board's scarce resource: it ran down to
// 3.5 KB while a browser loaded the app and the board then aborted creating a
// lock (2026-10-03). Sampled fast, because the dip lasts a second or two — the
// 15 s provisioning line saw it only by luck. The LOWEST value since the last
// report is what is logged, with the largest free block, because a heap can be
// 20 KB free and still unable to give 2 KB.
static void watchHeap() {
    static uint32_t lastSample = 0, lastReport = 0;
    static size_t   lowFree = SIZE_MAX, lowBlock = SIZE_MAX;
    const uint32_t now = millis();
    if (now - lastSample < 250) return;
    lastSample = now;
    const size_t f = heap_caps_get_free_size(MALLOC_CAP_INTERNAL);
    const size_t b = heap_caps_get_largest_free_block(MALLOC_CAP_INTERNAL);
    if (f < lowFree)  lowFree  = f;
    if (b < lowBlock) lowBlock = b;
    if (lowFree < 20000 && now - lastReport >= 2000) {
        lastReport = now;
        DEBUG_PRINT(F("[HEAP] LOW — free ")); DEBUG_PRINT((unsigned long)lowFree);
        DEBUG_PRINT(F(" B, largest block ")); DEBUG_PRINT((unsigned long)lowBlock);
        DEBUG_PRINT(F(" B (now ")); DEBUG_PRINT((unsigned long)f); DEBUG_PRINTLN(F(")"));
        lowFree = SIZE_MAX; lowBlock = SIZE_MAX;
    }
}

static void raiseDeviceProblems() {
    static uint32_t lastMs = 0;
    static topo::DeviceProblems problems;     // control/DeviceProblems.h: the rules, shared with the native brain
    const uint32_t now = millis();
    if (now - lastMs < 2000) return;
    lastMs = now;

    std::vector<topo::BoardView> boards;
    for (int i = 0; i < g_remoteCount; i++) {
        if (!remoteLive(i)) continue;
        const topo::RemoteActuatorBus::LinkHealth h = g_remoteBuses[i].health();
        topo::BoardView b;
        b.host = g_remoteBuses[i].host(); b.linked = h.linked; b.refused = h.refused;
        b.downForMs = h.downForMs; b.moveFault = h.moveFault;
        b.optional = g_topoRuntime.loaded() &&
            topo::isOptionalBoard(g_topoRuntime.topology(), topo::controllerIdForHost(g_topoRuntime.topology(), b.host));
        b.clampIn = g_remoteBuses[i].info().clampIn;
        boards.push_back(b);
    }
#ifdef PIN_CT
    {   // this board's own jack: a clamp at the collector is most often on the brain's board
        topo::BoardView self;
        self.host = WiFiProvisioner::getHostname().c_str(); self.linked = true; self.self = true;
        self.clampIn = g_jack.known() ? (g_jack.plugged() ? 1 : 0) : -1;
        boards.push_back(self);
    }
#endif
    std::vector<topo::PlugView> plugs;
#ifdef CONTROL_SMART_OUTLET
    for (int i = 0; i < control.outletCount() && i < SMART_OUTLET_COUNT; i++) {
        SmartOutlet* o = control.outlet(i);
        if (!o) continue;
        topo::PlugView p;
        p.key = "plug:" + std::to_string(i); p.name = o->name() ? o->name() : ""; p.ip = o->ip(); p.reachable = o->isReachable();
        plugs.push_back(p);
    }
#endif
    problems.update(g_topoRuntime, boards, plugs, now);

    // THE BIN ALERT (2026-10-10): every board serving a system whose bin is full blinks red — the nodes by an ALERT frame,
    // this board on its own pixel. Shop.h boardServesSystem() decides who; NodeSession sends only on a change.
    if (g_topoRuntime.loaded()) {
        const auto systems = topo::systemsOf(g_topoRuntime.topology());
        const std::string own = g_nodeBus.ownControllerId();
        auto alerted = [&](const std::string& board) {
            for (const topo::SystemView& sys : systems)
                if (sys.id && g_topoRuntime.binFull(sys.id) && topo::boardServesSystem(sys, board, own)) return true;
            return false;
        };
        for (int i = 0; i < g_remoteCount; i++)
            if (remoteLive(i))
                g_remoteBuses[i].setBinAlert(alerted(topo::controllerIdForHost(g_topoRuntime.topology(), g_remoteBuses[i].host())));
        statusled::setBinAlert(alerted(""));
    } else statusled::setBinAlert(false);
}

// The link log's main-loop half: write what the other tasks queued, and once an
// hour say "still here" with every node's state — so a quiet stretch in the log
// reads as a quiet shop, not as a board that stopped writing.
static void linkLogTick() {
    linklog::flush();
    static uint32_t lastHourlyMs = 0;          // first one an hour after boot
    const uint32_t now = millis();
    if (now - lastHourlyMs < 3600000UL) return;
    lastHourlyMs = now;
    char nodes[120] = "";
    size_t n = 0;
    for (int i = 0; i < g_remoteCount && n < sizeof(nodes) - 24; i++) {
        if (!remoteLive(i)) continue;
        const topo::RemoteActuatorBus::LinkHealth h = g_remoteBuses[i].health();
        n += snprintf(nodes + n, sizeof(nodes) - n, "%s%s:%s", n ? " " : "",
                      g_remoteBuses[i].host(), h.linked ? "up" : "down");
    }
    char extra[200];
    snprintf(extra, sizeof(extra), "\"rssi\":%d,\"bssid\":\"%s\",\"heap\":%u,\"nodes\":\"%s\"",
             (int)WiFi.RSSI(), WiFi.BSSIDstr().c_str(),
             (unsigned)heap_caps_get_free_size(MALLOC_CAP_INTERNAL), nodes);
    linklog::event("hourly", nullptr, extra);
}

// Map the topology's controllerIds onto paired hosts. This is ALL a layout now
// contributes to off-board routing: which board drives which gate. A controller
// naming a host nobody paired stays unresolved, and NodeBus reports its gates as
// un-commandable rather than pretending a move landed.
static void syncControllerAliases() {
    g_nodeBus.clearAliases();
    for (JsonObjectConst c : g_topoRuntime.topology()["controllers"].as<JsonArrayConst>()) {
        if (!topo::_eq(c["role"], "secondary")) continue;
        JsonObjectConst link = c["link"];
        // Only wifi-ws is implemented. An esp-now node is valid in the schema but
        // has no transport yet, so leave it unaliased.
        if (!topo::_eq(link["transport"], "wifi-ws")) continue;
        const char* id   = c["id"].as<const char*>();
        const char* host = link["host"].as<const char*>();
        if (!id || !host || !*host) continue;
        g_nodeBus.setAlias(std::string(id), std::string(host));
        if (!g_nodeRegistry.has(host)) {
            // Worth saying out loud: the layout references a board that was never
            // paired, so its gates won't move and the reason isn't visible on the
            // canvas. Pair it from /boards.
            DEBUG_PRINT(F("[NODE] Topology names an UNPAIRED board: ")); DEBUG_PRINTLN(host);
        }
    }
    // Sensors are addressed by controllerId too, so they can only be pushed
    // once the aliases above exist. adopt() pushes as well, but that runs before
    // this — so without this line a CT on a NODE is configured on nothing and
    // the tool is silent forever, while a CT on the primary works fine. Exactly
    // the kind of asymmetry that reads as a flaky board.
    g_topoRuntime.reconfigureSensors();
}

#ifdef CONTROL_SMART_OUTLET
// Register the layout's plugs with the poller.
//
// The canvas writes plugs into the topology (`tool.sensor.outlet`,
// `collector.control.outlet`), but SmartOutletControl only ever polls the slots
// stored in its own NVS slots — so a tool paired on the canvas was watched by
// nothing, and the blower was still switched by whatever plug happened to be
// stored there. Under a topology, the LAYOUT is the source of truth
// for both; this is what makes that true on the device.
//
// Tool slots are RAM-only on purpose (configureOutlet doesn't touch NVS; only
// saveSlot does). They're rebuilt from the layout on every adopt — including at
// boot — so persisting them would just be a second copy to keep in sync. The
// stopIndex is 0 throughout: it belongs to the stop-index gate mapping, whose
// automation is already inert while a topology is loaded.
// Last state pushed to each collector plug, so loop() only commands one on
// change instead of every pass. Cleared whenever a layout is adopted — slot i
// may then be a different system's blower, and a stale "already asserted" would
// be an answer about the wrong one.
// ── Pressing the collector's own remote ──────────────────────────────────────
//
// A collector with `control.rf` has no switchable plug: we transmit its
// remote's frame instead (docs/archive/tool-sensing-rfc.md §4.2). That is an EDGE
// against a TOGGLE, so it cannot be commanded, only nudged — and whether the
// nudge landed is answered by the collector's sensor plug, not by us.
// control/CollectorPress.h holds the policy; this holds the hardware and the
// per-system bookkeeping it needs.
//
// Rebuilt on every adopt rather than reconfigured: a layout may move the
// transmitter to another pin or name a different fob's address, and there is no
// state in a presser worth preserving across that.
// What the shared collector loop is lent: the serial console and the watchdog.
struct SketchDriverHooks : topo::DriverHooks {
    void say(const std::string& l) override { DEBUG_PRINTLN(l.c_str()); }
    void pet() override { watchdog::pet(); }
};
static topo::CollectorPresser* g_pressers[COLLECTOR_COUNT] = {nullptr};
// The same objects, when they are THIS board's own transmitter — the bench console wants
// pressWithRepeats(), which a presser on a node does not have. Not owning: g_pressers is.
static RfCollectorPresser*     g_localRf[COLLECTOR_COUNT]  = {nullptr};
static topo::PressState    g_pressState[COLLECTOR_COUNT];
// Which blower and which transmitter each slot's press state belongs to ("<system>|<board or pin>|<address>|<data>"), so
// a layout save can keep it for the same remote — see syncTopologyOutlets().
static std::string         g_pressKey[COLLECTOR_COUNT];

static void clearPressers() {
    for (int i = 0; i < COLLECTOR_COUNT; i++) {
        delete g_pressers[i];
        g_pressers[i]   = nullptr;
        g_localRf[i]    = nullptr;
        g_pressState[i] = topo::PressState();
        g_pressKey[i].clear();
    }
}

static bool g_dcAsserted[COLLECTOR_COUNT] = {false};
static bool g_dcHave[COLLECTOR_COUNT]     = {false};

static void syncTopologyOutlets() {
    JsonObjectConst doc = g_topoRuntime.topology();
    for (int i = 0; i < COLLECTOR_COUNT; i++) g_dcHave[i] = false;
    // Pressers are rebuilt below from whatever the new layout names. A SAVE IS NOT A REBOOT (TopologyRuntime::adopt): the
    // press bookkeeping says whether WE started a blower, and a fresh one reads every running blower as started by a
    // person, which nothing then presses off. It is kept for the same system pressed by the same transmitter.
    std::map<std::string, topo::PressState> keptPress;
    for (int i = 0; i < COLLECTOR_COUNT; i++) if (!g_pressKey[i].empty()) keptPress[g_pressKey[i]] = g_pressState[i];
    clearPressers();

    // Walk MACHINES, not tool elements. A machine owns the plug, and a machine
    // with two ports (cabinet + overarm on a table saw) is still one plug — so
    // iterating ports here would try to register the same outlet twice and burn
    // a slot doing it.
    int slot = 0;
    for (const std::string& mid : topo::machineIds(doc)) {
        JsonObjectConst m = topo::machineDoc(doc, mid);
        JsonObjectConst o = m["sensor"]["outlet"];
        const char* ip = o["ip"].as<const char*>();
        if (!ip || !*ip) continue;                       // manual machine — nothing to poll
        if (slot >= SMART_OUTLET_COUNT) {
            DEBUG_PRINTLN(F("[Outlets] More paired machines than outlet slots — extras ignored."));
            break;
        }
        // ABSENT `kind` MEANS SHELLY. Every layout written before 2026-09-09
        // has a Shelly in it and no field to say so, and outletKindFromName()
        // maps an unknown string the same way — a document from a newer UI
        // naming a kind this build has never heard of gets the old behaviour
        // rather than a plug that silently reads nothing.
        control.configureOutlet(slot++,
                                outletKindFromName(o["kind"] | "shelly"),
                                o["gen"] | 2, ip,
                                m["name"] | mid.c_str(),
                                /*stopIndex=*/0,
                                o["thresholdW"] | (float)OUTLET_DEFAULT_THRESHOLD_W,
                                o["host"] | "");
    }
    // Drop any slot the layout no longer names, so an unpaired machine stops
    // being polled without waiting for a reboot.
    for (int i = slot; i < SMART_OUTLET_COUNT; i++) control.removeOutlet(i);
    DEBUG_PRINT(F("[Outlets] Layout plugs registered: ")); DEBUG_PRINTLN(slot);

    // One blower switch per system, in the same order systemIds() reports, so
    // slot i belongs to system i throughout (see the collector assert in loop()).
    //
    // A system with no plug means "I start that collector by hand" — or, now, by
    // RF or a servo on the fob, watched by a clamp. Either way the LAYOUT is the
    // answer, and slot 0 is cleared like every other slot.
    //
    // It used to keep whatever plug slot 0 had stored "rather than silently
    // un-configuring a working blower" — a rule from before layouts, when the
    // stored plug WAS the configuration. Under a layout it is a stale IP with
    // authority: on 2026-10-03 a brain kept polling a collector plug at
    // 192.168.86.57 (a plug that had since moved), fed its "unreachable" into the
    // collector's reading over the top of the clamp the layout actually names,
    // and the press policy — which rightly never presses blind — then refused to
    // press the RF remote at all. The blower simply never started.
    std::vector<std::string> sysIds = g_topoRuntime.systemIds();
    for (size_t i = 0; i < sysIds.size(); i++) {
        if (i >= COLLECTOR_COUNT) {
            DEBUG_PRINTLN(F("[Outlets] More systems than collector slots — extras ignored."));
            break;
        }
        JsonObjectConst o = g_topoRuntime.collectorOutlet(sysIds[i]);
        const char* ip = o["ip"].as<const char*>();
        if (ip && *ip) {
            if (!control.collectorIs((int)i, ip))
                control.configureCollector((int)i, o["gen"] | 2, ip, o["host"] | "");
        } else {
            if (control.collectorConfigured((int)i))
                Serial.printf("[Outlets] Collector %d: the layout names no plug — dropping the stored one.\n", (int)i);
            control.removeCollector((int)i);
        }

        // The transmitter that presses this blower's remote, if it has one.
        JsonObjectConst rf = g_topoRuntime.collectorRf(sysIds[i]);
        if (!rf.isNull()) {
            // AN ABSENT `pin` MEANS THIS BOARD'S OWN PAD, since 2026-09-16, and
            // that is now the normal case — no screen asks for a GPIO, because
            // which pad keys the transmitter is a fact about how the BOARD is
            // built, not about the shop.
            //
            // It used to be required, so the UI had to supply the number and
            // every layout ever written baked it in. That made DEFAULT_RF_PIN
            // (collector-doc.ts) a cross-language pair with PIN_RF_TX and meant
            // moving the pad silently stranded every existing layout on the old
            // GPIO — which is exactly what moving it from D9 to D10 would have
            // done. Falling back here deletes the pair and the migration at once.
            //
            // An EXPLICIT pin still wins, for a board wired by hand.
#if HAS_RF
            const int pin = rf["pin"] | (int)PIN_RF_TX;
#else
            const int pin = rf["pin"] | -1;
#endif
            const uint8_t  rfAddr = (uint8_t)(rf["address"] | (int)topo::rf::kRocklerAddress);
            const uint8_t  rfData = (uint8_t)(rf["data"]    | (int)topo::rf::kRocklerData);
            const uint32_t rfTick = (uint32_t)(rf["tickUs"] | (int)topo::rf::kDefaultTickUs);
            const uint32_t rfReps = (uint32_t)(rf["repeats"]| (int)topo::rf::kDefaultRepeats);
            // WHICH BOARD KEYS THE TRANSMITTER (2026-10-04). Absent, or this board's own id,
            // means this board's pad as it always was. A paired node's id means ask THAT
            // board to key ITS pad (PRESS) — which is what lets the board at the collector be
            // an ordinary node. The policy stays here either way.
            const std::string rfBoard = g_topoRuntime.collectorBoard(sysIds[i]);   // the collector's board
            const std::string tail = "|" + std::to_string((int)rfAddr) + "|" + std::to_string((int)rfData);
            // Said when a layout loads, so it must not read like an event: nothing is pressed here.
            if (!topo::isOwnBoard(rfBoard, g_nodeBus.ownControllerId())) {
                g_pressers[i] = new topo::RemoteRfPresser(&g_nodeBus, rfBoard, rfAddr, rfData, rfTick, rfReps);
                g_pressKey[i] = sysIds[i] + "|" + rfBoard + tail;
                DEBUG_PRINT(F("[RF] Collector ")); DEBUG_PRINT((int)i);
                DEBUG_PRINT(F(": its remote is keyed through board ")); DEBUG_PRINTLN(rfBoard.c_str());
            } else if (pin >= 0) {
                RfCollectorPresser* local = new RfCollectorPresser(pin, rfAddr, rfData, rfTick, (uint16_t)rfReps);
                g_pressers[i] = local;
                g_localRf[i]  = local;
                g_pressKey[i] = sysIds[i] + "|pin" + std::to_string(pin) + tail;
                DEBUG_PRINT(F("[RF] Collector ")); DEBUG_PRINT((int)i);
                DEBUG_PRINT(F(": its remote is keyed on pin ")); DEBUG_PRINTLN(pin);
            }
            auto kept = keptPress.find(g_pressKey[i]);
            if (!g_pressKey[i].empty() && kept != keptPress.end()) g_pressState[i] = kept->second;
        }

        // The SENSE-ONLY plug watching this blower, which is a different device
        // from the one switching it. A collector pressed by a servo or by RF has
        // no switchable plug at all, and every one of those presses is stateless
        // — so this is the only thing that can say whether it landed.
        JsonObjectConst so = g_topoRuntime.collectorSensorOutlet(sysIds[i]);
        const char* sip = so["ip"].as<const char*>();
        if (sip && *sip) {
            if (!control.collectorSensorIs((int)i, sip))
                control.configureCollectorSensor((int)i,
                                                 outletKindFromName(so["kind"] | "shelly"),
                                                 sip, so["host"] | "");
        } else {
            control.removeCollectorSensor((int)i);
        }
    }
    for (size_t i = sysIds.size(); i < COLLECTOR_COUNT; i++) {
        control.removeCollector((int)i);
        control.removeCollectorSensor((int)i);
    }
}
#endif

// WHY THE STORED LAYOUT WAS REFUSED, or empty when it was not.
//
// A rejected topology used to be visible ONLY as one serial line at boot and a
// blue LED afterwards — and blue already meant "no layout drawn yet", which is
// the normal state of a fresh board. So a shop whose saved layout had become
// invalid (a budget lowered under it, an element the validator now refuses) was
// indistinguishable from a shop nobody had drawn yet, to anyone without a USB
// cable. Held here so the LED, the screen and /api/status can all say it.
static std::string g_topoRejectReason;

// THE ONE SENTENCE about why this board cannot do its job, when the cause is a
// startup failure rather than a layout. Surfaced on the screen (Facts::bootFault)
// because a shop board has no serial cable attached and a colour alone cannot
// say which subsystem is missing.
//
// FIRST ONE WINS. A failed drive takes the endstops with it, and a person needs
// the most upstream cause plus a next action, not an inventory — the panel is 21
// columns wide.
//
// ONLY FOR FAILURES THAT WILL NOT RECOVER ON THEIR OWN. WiFi is the counterexample
// and the reason this rule is written down: it drops and returns constantly, it
// already has its own colour and its own screen, and a sticky "wifi failed" note
// from boot would still be there an hour after it came back.
static std::string g_bootFault;
static void noteBootFault(const char* what) {
    if (g_bootFault.empty() && what && *what) g_bootFault = what;
}

static void adoptStoredTopology() {
    // NOTE: no topology no longer means no links. Pairing is persisted separately
    // (NodeRegistry.h) precisely so a wiped or absent layout can't silently
    // un-pair the shop — only the controllerId→host aliases go away, which is all
    // a layout ever owned.
    if (!g_topoStoreSketch.exists()) {
        // NO layout is not a refused layout — leave the reason empty so the
        // board reports "NO SHOP" rather than accusing a document that does not
        // exist.
        g_topoRejectReason.clear();
        g_nodeBus.clearAliases(); g_topoRuntime.clear(); return;
    }
    String raw = g_topoStoreSketch.load();
    std::string err;
    const bool fromNothing = !g_topoRuntime.loaded();   // boot, or a first layout: settle it (TopologyRuntime::settleAtBoot)
    if (g_topoRuntime.adopt(raw.c_str(), raw.length(), err)) {
        g_topoRejectReason.clear();
        if (fromNothing) g_topoRuntime.settleAtBoot();
        // Learn which controller id this board answers to. Stage 1 is
        // single-board, so that's the topology's primary by definition
        // (validateMinimal guarantees exactly one). When secondary builds land,
        // this becomes a build-flag/NVS decision rather than an assumption.
        for (JsonObjectConst c : g_topoRuntime.topology()["controllers"].as<JsonArrayConst>()) {
            if (topo::_eq(c["role"], "primary")) {
                g_nodeBus.setLocal(&g_localBus, c["id"] | "primary");
                break;
            }
        }
        DEBUG_PRINT(F("[V2] Topology adopted — routing is live. This board = "));
        DEBUG_PRINTLN(g_nodeBus.ownControllerId().c_str());
        syncControllerAliases();
#ifdef CONTROL_SMART_OUTLET
        syncTopologyOutlets();
#endif
    } else {
        DEBUG_PRINT(F("[V2] Topology REJECTED: ")); DEBUG_PRINTLN(err.c_str());
        // Kept, not just printed. This is the only description of the fault that
        // exists, and the board is about to sit there showing a colour.
        g_topoRejectReason = err.empty() ? std::string("unreadable layout") : err;
        g_nodeBus.clearAliases();
        g_topoRuntime.clear();
    }
}

// =============================================================================
// setup()
// =============================================================================
// ⚠️ 16 KB, RAISED FROM THE ARDUINO DEFAULT OF 8 KB ON 2026-09-12.
//
// A stack protection fault in loopTask, on a collector board at boot:
//
//   Guru Meditation Error: Core 0 panic'ed (Stack protection fault)
//   Stack pointer: 0x4085d060   bounds: 0x4085d068 - 0x4085f060
//
// SP eight bytes BELOW the lower bound, with the 0xabba1234 canary sitting on
// it. The stack held a half-built status JSON, which is the clue: loop() is ONE
// enormous function, and every StaticJsonDocument declared anywhere inside it
// reserves space in the SAME FRAME whether or not that branch ever runs.
//
// Four of them live in there (2x512, 2x256) and I added two of those in the
// week before the crash — the sweep's row builder and the widened ping reply —
// on top of the deferred-reply handlers that were already there. Nothing was
// individually unreasonable; the frame simply is not a place to keep
// kilobytes.
//
// THE REAL FIX IS SMALLER FUNCTIONS. The sweep block was extracted first, and
// on 2026-09-14 the three deferred-reply handlers followed — ping, rename and
// release, which between them kept a 512 and two 256s permanently on the frame
// to serve requests that arrive a handful of times in a shop's life.
//
// This macro is the belt: loop() will keep growing, nobody notices a frame
// getting bigger, and the failure mode is a reboot loop on a board in a shop
// rather than a compile error. 8 KB more RAM against 320 KB is not a trade
// worth agonising over.
//
// And the HIGH-WATER LINE at the end of setup() is the warning that did not
// exist when this happened: a number that shrinks release over release is the
// only early notice anyone gets.
SET_LOOP_TASK_STACK_SIZE(16 * 1024);

void setup() {
    seriallog::begin();   // before the first print, so GET /api/serial has the whole boot
    Serial.begin(SERIAL_BAUD);
#if BOARD_HAS_NATIVE_USB
    // Native USB-CDC (S2/S3): Serial isn't ready until the host enumerates it —
    // wait for the monitor to connect, up to 5s, so boot logs aren't lost.
    // Open Serial Monitor before or immediately after flashing to catch them.
    unsigned long t0 = millis();
    while (!Serial && (millis() - t0) < 5000) { delay(10); }
#endif
    delay(100); // brief settle after connection
    DEBUG_PRINTLN(F("=== DustGate ==="));
    DEBUG_PRINT(F("Build: ")); DEBUG_PRINTLN(buildstamp::fw());
#ifdef DUSTGATE_EXTMEM_MALLOC_LIMIT
    // EXPERIMENT (dev.sh ota --extmem N): send every ordinary malloc/new above N bytes to
    // PSRAM. The SDK already does it above 4096 (CONFIG_SPIRAM_MALLOC_ALWAYSINTERNAL), so
    // this only moves the small-to-medium buffers: Strings, vectors, JSON documents, the
    // WebSocket client's. WiFi and lwIP ask for internal RAM explicitly and are unaffected.
    // Not a default: PSRAM is slower and stalls while flash is written (OTA, NVS).
    heap_caps_malloc_extmem_enable(DUSTGATE_EXTMEM_MALLOC_LIMIT);
    DEBUG_PRINT(F("[HEAP] extmem malloc limit = ")); DEBUG_PRINTLN((int)DUSTGATE_EXTMEM_MALLOC_LIMIT);
#endif
    // Name the build, not the wiring diagram. This said "ESP32 + TMC2209" on
    // every target — including boards with no stepper — so the first line of
    // every boot log was wrong about what you were looking at.
    DEBUG_PRINT(F("Target: ")); DEBUG_PRINT(F(BOARD_NAME));
#if HAS_LINEAR
    DEBUG_PRINTLN(F(" + slider"));
#else
    DEBUG_PRINTLN(F(" (servo only)"));
#endif

    // ADC: 12-bit (0-4095), 3.3V reference
    analogReadResolution(12);

    // Before WiFi, so the pixel is already saying something during the blocking
    // connect below — the DevKitC has no other sign it got past reset unless a
    // serial monitor happens to be attached.
    statusled::begin();
    statusled::set(statusled::BOOTING);
    statusled::update();

    // The screen, where one is plugged in. Reports itself either way: every
    // build carries the driver now, so "no panel on the bus" is an ordinary
    // outcome and worth one line on serial rather than a dark rectangle.
    if (statusscreen::begin()) {
        DEBUG_PRINTLN(F("[SCREEN] panel answered at 0x3C — drawing"));
    } else {
#if defined(PIN_OLED_SDA) && defined(PIN_OLED_SCL)
        DEBUG_PRINTLN(F("[SCREEN] declared, but nothing answered — run 'i2c' to see what is on the bus; disabled"));
#endif
    }

    // The button that wakes it back up after the two-minute blank. Nothing on a
    // board without one, and it never does anything but light the glass.
    wakebutton::begin();
#if HAS_BIN
    // INPUT_PULLUP so an unwired board reads HIGH, which with the optocoupler's
    // inversion means "bin OK". A board with nothing connected must not scream —
    // and topology gates it anyway, since nothing reports unless a collector
    // names this board (boards/xiao_c5.h, docs/archive/shop-schema-rfc.md §7.5).
    pinMode(PIN_BIN_SENSOR, INPUT_PULLUP);
#endif

    // WiFi provisioning — must run before any WiFi-dependent control mode.
    // If WIFI_STA_SSID is hardcoded in config.h it is used directly.
    // Otherwise stored NVS credentials are tried; if none exist or connection
    // fails, a captive portal AP ("DustGate-Setup") is started and this call
    // blocks until the user provides credentials (then reboots).
#if defined(CONTROL_SMART_OUTLET) || defined(ENABLE_HTTP_API)
    // The portal's loop never returns, so without this tick the pixel would sit
    // frozen on BOOTING for as long as the board waits to be told which WiFi to
    // join — the one state that definitely needs a human to walk over.
    WiFiProvisioner::setPortalTick([]() {
        statusled::set(statusled::PORTAL);
        statusled::update();
        // The portal loop never returns, and this is the one screen a stranger
        // has to follow — "join DustGate-Setup, then open 192.168.4.1". Without
        // a tick here it would sit blank for exactly as long as that matters.
        statusscreen::Facts f;
        f.status   = statusled::PORTAL;
        f.apName   = WIFI_PORTAL_SSID;
        f.portalIp = "192.168.4.1";
        statusscreen::update(f);
    });
    // WiFi joins and drops go in the link log, WITH the access point: on
    // 2026-09-27 which mesh radio each board was on was the first question every
    // time, and the answer existed only on a serial cable. Registered before
    // begin() so the first join is caught; lines queue until the log is ready.
    seriallog::reportCrash();   // [CRASH] lines, if the last boot panicked — readable over WiFi
    linklog::start();   // boot number first, so the lines below are stamped with it
    WiFi.onEvent([](arduino_event_id_t e, arduino_event_info_t info) {
        if (e == ARDUINO_EVENT_WIFI_STA_GOT_IP) {
            char extra[96];
            snprintf(extra, sizeof(extra), "\"bssid\":\"%s\",\"ch\":%d,\"rssi\":%d",
                     WiFi.BSSIDstr().c_str(), (int)WiFi.channel(), (int)WiFi.RSSI());
            linklog::event("wifi_up", nullptr, extra);
        } else if (e == ARDUINO_EVENT_WIFI_STA_DISCONNECTED) {
            char extra[40];
            snprintf(extra, sizeof(extra), "\"reason\":%d",
                     (int)info.wifi_sta_disconnected.reason);
            linklog::event("wifi_down", nullptr, extra);
        }
    });
    WiFiProvisioner::begin();
    WiFiProvisioner::setPortalTick(nullptr);
    // Wall-clock time for the link log, if the network lets NTP out. Harmless if
    // it does not: lines then carry ts:0 and read by boot + uptime instead.
    configTime(0, 0, "pool.ntp.org", "time.google.com");
#endif

    // Load calibration before feedback system initialises
    CalibrationStore::begin(); // Required on ESP32: allocates EEPROM flash region
    loadCalibration();

    // Load runtime config from NVS — takes priority over cal defaults above.
    // Uses the same namespace ("api_cfg") as HttpApiServer to avoid opening
    // multiple Preferences namespaces for the same flash partition.
    {
        Preferences prefs;
        prefs.begin("api_cfg", true);
        // "home_dir" is DELIBERATELY NOT READ any more. Direction is derived from
        // the datum now (config.h), so a value left in NVS by an older build is
        // stale rather than useful — and reading it back would resurrect exactly
        // the state the auto-detect used to corrupt. Left in flash rather than
        // erased: it costs four bytes and deleting it buys nothing.
        int nvsGates     = prefs.getInt("num_gates", 0); // 0 = not saved yet
        prefs.end();
        if (nvsGates >= 1 && nvsGates <= NUM_STOPS) g_numActiveStops = nvsGates;
    }
    DEBUG_PRINT(F("[CFG] homeDirection=")); Serial.print(HOME_DIRECTION);
    DEBUG_PRINT(F(" (from the datum)  numActiveStops="));   Serial.println(g_numActiveStops);

    // Report each stage separately: a bare "INIT FAILED" can't tell a drive
    // problem (the ST3215 bus) from an endstop or a WiFi/outlet one, which are
    // three very different pieces of wiring to go stare at.
    const bool okMotor    = motor.begin();
    const bool okFeedback = feedback.begin(&motor);
    const bool okControl  = control.begin();

    // What each failure COSTS is FaultPolicy.h's decision, not this function's —
    // it is a table with a truth table's worth of cases, and the sketch is the
    // one file that can't be host-tested. Here we only record what happened.
    faults::Stages stages;
    stages.motor    = !okMotor;
    stages.endstops = !okFeedback;
    stages.outlets  = !okControl;
#if !HAS_LINEAR
    // The board's pin map wires no slider, so `motor` is NullMotorDriver and
    // begin() returned true because nothing failed. Clearing the stage before
    // anything reports on it is what keeps a servo-only board from announcing a
    // motor failure that is the build working as designed.
    const bool kRackFitted = false;
    stages.motor = false;
#else
    const bool kRackFitted = true;
#endif
    const faults::Policy policy = faults::decide(stages, kRackFitted);

    g_faultMotor    = stages.motor;
    g_faultEndstops = stages.endstops;
    g_faultOutlets  = stages.outlets;

    // ON THE GLASS, not just the console. These were recorded, weighed by
    // FaultPolicy and used to refuse motion, and then reported to a person as the
    // bare word "FAULT". Outlets are deliberately NOT here: that stage is WiFi
    // and plugs, which recover on their own and have their own indicator.
    if (stages.motor)    noteBootFault("drive did not start");
    if (stages.endstops) noteBootFault("endstops not found");

    const bool ok = !stages.motor && !stages.endstops && !stages.outlets;
    if (!ok) {
        DEBUG_PRINT(F("[INIT] motor="));      Serial.print(okMotor    ? "ok" : "FAIL");
        DEBUG_PRINT(F("  feedback="));        Serial.print(okFeedback ? "ok" : "FAIL");
        DEBUG_PRINT(F("  control="));         Serial.println(okControl ? "ok" : "FAIL");
        // Name the drive this board actually has. This said "TMC2209 UART"
        // until 2026-08-28, which sent anyone reading it to check a stepper
        // driver that was retired on 2026-08-23 and deleted on 2026-08-28 — on a board whose
        // only motor is a servo on a serial bus.
        snprintf(g_faultStages, sizeof(g_faultStages), "%s%s%s",
                 okMotor    ? "" : (HAS_LINEAR ? "motor(ST3215 bus) " : "motor "),
                 okFeedback ? "" : "endstops ",
                 okControl  ? "" : "outlets(WiFi/Shelly) ");
    }
#if defined(ENABLE_SERIAL_COMMANDS) && !defined(CONTROL_SERIAL_DEBUG)
    _serialCmds.begin();   // supplemental serial processor (non-fatal if begin() returns false)
#endif
#if defined(ENABLE_SERVO) && defined(SERVO_PWM_PIN_1)
    for (int i = 0; i < SERVO_COUNT; i++) g_servos[i].begin(SERVO_PINS[i]);  // bind pins; attach on first move
    servoselftest::begin(g_servos, SERVO_COUNT);
    // The button's long press needs to know whether the collector is pulling
    // before it sweeps every gate. A lambda rather than a stored flag: the
    // answer has to be true AT THE MOMENT OF THE HOLD, not whenever setup ran.
    wakebutton::setCollectorQuery([]() { return g_topoRuntime.collectorOn(); });
    DEBUG_PRINTLN(F("[SERVO] Bring-up ready — 'servo <1-4> <angle>' (external 5-6V rail, common GND)."));
    DEBUG_PRINTLN(F("[SERVO] Hold the wake button 1s to sweep every channel."));
#endif

    // A hardware fault disables ONE CAPABILITY, not the whole device. Do NOT
    // return here: loop() unconditionally pumps the API server and the routing
    // runtime, and returning early left HttpApiServer::_mutex uncreated — the
    // first consumeXxx() then asserted inside xQueueSemaphoreTake and the board
    // sat in a reboot loop, which is also what made the serial prompt
    // unreachable for debugging the very wiring that faulted.
    //
    // Continuing is safe because every LINEAR motion entry point checks
    // g_hardwareFault (issueMove(), SketchLinearDrive::moveToMm()). Servos are on
    // an independent rail and check nothing, so a servo topology still routes on
    // a board whose stepper or endstops are broken.
    //
    // The two latches below are SEPARATE FACTS, which is the whole point of the
    // policy: "do not command the stepper" and "something is wrong here" used to
    // be set together, so a rackless board pulsed red forever over hardware it
    // was never built with, and a WiFi failure refused to home a healthy rack.
    g_hardwareFault = policy.linearMotion;
    currentState    = policy.errorState ? STATE_ERROR : STATE_IDLE;

    if (policy.errorState) {
        DEBUG_PRINTLN(F("INIT: linear motion FAILED — check wiring and config.h"));
        DEBUG_PRINTLN(F("Linear moves are disabled. Servo gates and routing still run."));
    } else {
        DEBUG_PRINTLN(F("Init OK. Type 'enable' to home and start."));
    }
    if (g_faultOutlets) {
        // Neither latch. The plugs are a network problem: WiFiProvisioner::
        // maintain() reconnects unattended, so a boot-time latch would outlive
        // the fault it describes. The pixel's NO_WIFI state already says it.
        DEBUG_PRINTLN(F("[INIT] Outlets (WiFi/Shelly) failed — plugs are offline."));
        DEBUG_PRINTLN(F("       Motion and gates are unaffected; the link may recover on its own."));
    }

    // Say what the board can still DO, not just what failed. A stage name tells
    // you where to point a multimeter; this tells you whether the shop works —
    // and it is the line that makes "the stepper is dead but my gates still
    // move" visible at boot instead of something you have to infer.
    DEBUG_PRINT(F("[INIT] capabilities: linear="));
    Serial.print(g_hardwareFault ? "refused" : "ok");
    DEBUG_PRINT(F("  gates=ok  plugs="));
    Serial.println(g_faultOutlets ? "offline" : "ok");

#if !HAS_LINEAR
    // policy.linearMotion is already true here — no rack means every motion
    // entry point must keep refusing, and reusing the existing latch is what
    // keeps that small: issueMove() and SketchLinearDrive::moveToMm() check it
    // by name, so nothing new has to be threaded through the homing, jog,
    // calibration and sweep paths.
    //
    // Several serial/API handlers report the latch as "Hardware fault at boot —
    // failed: <stages>". With nothing genuinely broken that string is empty and
    // the message reads like a bug, so name the real reason. Only when empty:
    // a true failure above owns this field and must not be overwritten.
    if (g_faultStages[0] == '\0')
        snprintf(g_faultStages, sizeof(g_faultStages), "no slider on this board");
    DEBUG_PRINTLN(F("[INIT] No slider on this board — motion disabled by design; "
                    "servos and routing are live."));
#endif

#ifdef ENABLE_HTTP_API
    if (!apiServer.begin()) {
        DEBUG_PRINTLN(F("[API] HTTP server failed to start."));
        // THE SCREEN IS THE ONLY CHANNEL LEFT when this fails — the app, the
        // Boards page and every diagnostic endpoint are served by this server,
        // so its failure is exactly the one that cannot report itself any other
        // way. It does not stop gates routing, so it is a note rather than a
        // FAULT colour.
        noteBootFault("web UI is down");
    } else {
        DEBUG_PRINT(F("[API] Listening on port 80.  Key: "));
        Serial.println(apiServer.apiKey());
    }
    // LittleFS is mounted by apiServer.begin() — the log can write from here on.
    linklog::begin();
    apiServer.setNodeEventHook(nodeEventHook);
#endif

    // -- routing runtime -------------------------------------------
    // After the API server, which mounts LittleFS (where the topology lives).
#if defined(ENABLE_SERVO) && defined(SERVO_PWM_PIN_1)
    for (int i = 0; i < SERVO_COUNT; i++) g_localBus.bindServo(i, &g_servos[i]);
#endif
    g_localBus.bindLinear(&g_linearDrive);
    // This board answers to the topology's primary controller. Selectors with no
    // controllerId (every single-board topology) also land here.
    g_nodeBus.setLocal(&g_localBus, "primary");
    g_topoRuntime.begin(&g_nodeBus);
    g_topoRuntime.setSay([](const std::string& l) { Serial.println(l.c_str()); });   // the [TOOL] line
    g_topoStoreSketch.begin();

    // Pairing FIRST, and independent of whether a layout exists: a paired board
    // should come up linked (green at the node) on a primary that has never been
    // told what the shop looks like. That ordering is the whole point of the
    // split — see NodeRegistry.h.
    g_nodeRegistry.begin();
    syncPairedNodes();

    adoptStoredTopology();

    // Arm the task watchdog on the main loop LAST — after all the blocking init
    // above (WiFi connect can block up to ~12s, calibration load, etc.), so none
    // of it trips a spurious reset. From here loop() must pet it each pass.
    watchdog::begin();   // watches this task (the Arduino loopTask)

#ifdef PIN_CT
    // Start the CT's bias-settle clock. Placed HERE rather than earlier on
    // purpose: it is measured from the moment the board is actually running, and
    // everything above this line blocks (a WiFi connect alone can take ~12 s) —
    // which means on a normal boot the 3 s has already elapsed by the time
    // anything asks, and the check costs nothing. It only bites on the path it
    // exists for: a fast boot that reaches a reading before the rail is up.
    g_ct.begin();
    // D0's own pull-up, so a pad with nothing on it reads as no clamp — see the node's setup() for the reasoning and
    // the one thing a bench must confirm.
    (void)analogReadMilliVolts(PIN_CT);
    gpio_pullup_en((gpio_num_t)PIN_CT);
#endif

    // Hand the runtime this board's CT tuning so every node gets the SAME
    // numbers this board judges its own clamp by. Unconditional — not inside
    // PIN_CT — because a primary with no clamp of its own still configures nodes
    // that have one, and gating it on this board's pin map would make a gate
    // brain silently ship stale numbers while a collector brain shipped fresh
    // ones. Retuning the shop is sensing/CtTrip.h plus a reflash of THIS board.
    {
        const sensing::TripParams p;
        g_topoRuntime.setSensorTuning(p.tripRatio, p.minCounts, p.clearRatio);
    }

    // ── How close did that come to the edge? ─────────────────────────────
    //
    // The stack protection fault that raised this task's size to 16 KB gave no
    // warning at all: it worked, and then a board would not boot. This is the
    // warning. uxTaskGetStackHighWaterMark() reports the SMALLEST amount of
    // free stack this task has ever had. ESP-IDF returns BYTES here, unlike
    // vanilla FreeRTOS which returns words — confirmed on hardware rather than
    // from the docs: the first run reported 8604 against a 16384-byte stack, and
    // 8604 WORDS would be 34 KB of a 16 KB stack. Do not "fix" this by scaling.
    // The number to watch is the one that keeps getting smaller between
    // releases, long before it reaches zero and takes a board in a shop.
    //
    // ONCE, at the end of setup(), and that is the entire point of where it
    // sits. The first cut of this landed at the tail of updateStatusLed() by
    // matching the wrong closing brace, so a board printed it 115,754 times in
    // one bench session — a diagnostic that buries the log it is meant to be
    // found in. If this ever needs to be read again later, that is what a
    // console command is for, not a line in a hot path.
    //
    // setup() is itself among the deepest things this task ever runs, so a
    // figure taken here already accounts for it. It is a floor, not a live
    // gauge: loop()'s own worst pass will push it lower.
    DEBUG_PRINT(F("[STACK] loop task free after setup: "));
    DEBUG_PRINT((unsigned)uxTaskGetStackHighWaterMark(NULL));
    DEBUG_PRINT(F(" bytes of "));
    DEBUG_PRINT((unsigned)(16 * 1024));
    DEBUG_PRINTLN(F(" — watch this SHRINK across releases."));
}

// =============================================================================
// loop()
// =============================================================================
// =============================================================================
// updateStatusLed() — translate the state machine into the shared colour
// vocabulary (utils/StatusLed.h). Called once per loop() pass.
//
// Motion outranks status, matching the node: while something is physically
// moving, THAT is what the person standing at the gate needs to see. Underneath
// it the ranking is worst-first — a fault hides a WiFi problem hides "no layout
// yet" — because the top item is always the one to go deal with.
//
// "Ready" here means routing is live, not merely that the board booted. A
// primary with no topology stored has nothing to route, so it sits on blue: it
// is working, it just has no shop yet. That distinction is exactly what the old
// single LED could not express — it was dark for both.
//
// It also means every PAIRED board is answering — see allNodesLinked() below.
// =============================================================================

// True when every board this primary is paired with is currently linked.
//
// Green is reserved for "everything works" (StatusLed.h), and on a multi-board
// shop this primary working is only half of that: if a node is dark, the gates
// on it will not move, and the failure shows up as a tool that doesn't pull —
// long after you walked away from the board that could have told you.
//
// Keyed on PAIRING, not on the topology. The registry is what this board "knows
// about": a node paired but not yet given any gates is still a board that is
// supposed to be there, and a node that has silently dropped off WiFi is the
// case this exists to catch.
//
// A missing node is BLUE, not red — "on WiFi, not ready to work", the same as
// having no layout yet. It is usually a node still booting or a router
// hiccuping, both of which resolve themselves, and red is reserved for what the
// board cannot fix. The link retries on its own, so the colour comes back.
//
// No nodes paired = trivially true, which keeps a single-board shop on exactly
// the behaviour it had before.
//
// SAMPLED, not polled every pass. info() takes the bus mutex and copies strings,
// and it contends with that node's own NodeLink task; loop() runs thousands of
// times a second and an indicator does not need to. Same cadence as the node
// status publish, which is already the fastest anything reads this.
static bool allNodesLinked() {
    static bool          cached     = true;
    static unsigned long lastCheck  = 0;
    static int           lastDarkId = -1;   // which node we last reported dark

    if (lastCheck != 0 && millis() - lastCheck < V2_STATUS_PUBLISH_MS) return cached;
    lastCheck = millis();

    int dark = -1;
    for (int i = 0; i < g_remoteCount; i++) {
        if (remoteLive(i) && !g_remoteBuses[i].info().connected) { dark = i; break; }
    }

    // Log the TRANSITION, both directions. A node dropping out is otherwise
    // silent on the primary — the only evidence is a gate that stops moving,
    // which sends you looking at the gate.
    if (dark != lastDarkId) {
        if (dark >= 0) {
            DEBUG_PRINT(F("[NODE] dark: "));
            DEBUG_PRINT(g_remoteBuses[dark].host());
            DEBUG_PRINTLN(F(" — indicator holds blue until it answers"));
        } else {
            DEBUG_PRINT(F("[NODE] all paired boards linked ("));
            DEBUG_PRINT(remoteLiveCount());
            DEBUG_PRINTLN(F(")"));
        }
        lastDarkId = dark;
    }

    cached = (dark < 0);
    return cached;
}

// -----------------------------------------------------------------------------
// The optional status screen. Everything it knows comes from here, and it knows
// nothing the pixel doesn't — the state word IS statusled::state(), spelled.
//
// A panel has run on a C5 (D4/D5, CLAUDE.md); what it shows of a full shop on a primary is less exercised. Compiles to
// nothing on a build without one, so this function costs an unfitted board a call to an empty inline.
//
// The gaps, stated rather than faked: the runtime publishes THAT the shop is
// transitioning, not WHICH selector is in flight, so the make-before-break
// screen in docs/mockups/archived/oled-status.html can name the tool but not yet its two
// gates. Naming a plausible gate would be worse than leaving the line out.
// -----------------------------------------------------------------------------
static void updateStatusScreen() {
    if (!statusscreen::present()) return;

    statusscreen::Facts f;
    f.role   = statusscreen::Role::PRIMARY;
    f.selfTestCh      = servoselftest::channel();
    f.selfTestOf      = SERVO_COUNT;
    f.selfTestAngle   = servoselftest::angle();
    if (!servoselftest::active()) f.selfTestRefused = servoselftest::refusal();
    f.status = statusled::state();
    f.motion = statusled::motion();
    if (!g_topoRejectReason.empty()) f.layoutError = g_topoRejectReason.c_str();
    if (!g_bootFault.empty())        f.bootFault  = g_bootFault.c_str();

#if defined(CONTROL_SMART_OUTLET) || defined(ENABLE_HTTP_API)
    static String host;
    if (!host.length()) host = WiFiProvisioner::getHostname();
    f.hostname = host.c_str();
    // A static, not the String WiFi.SSID() returns: that temporary dies at the
    // end of this statement and Facts holds a bare pointer into it.
    static String ssid;
    ssid = WiFi.SSID();
    f.ssid = ssid.length() ? ssid.c_str() : nullptr;
    if (WiFi.status() == WL_CONNECTED) {
        // Four bars from RSSI. The thresholds are the usual ones and not worth
        // agonising over: this glyph answers "is the wifi ok", not "what is my
        // link margin".
        const int rssi = WiFi.RSSI();
        f.wifiBars = rssi >= -60 ? 4 : rssi >= -70 ? 3 : rssi >= -80 ? 2 : rssi >= -90 ? 1 : 0;
    } else {
        // Half of all WiFi faults are the wrong SSID, so the NO_WIFI screen
        // says which network it is looking for — the core keeps the configured
        // one here even while disconnected.
        f.wifiBars = 0;
    }
#endif

    // Gates: how many of the shop's selectors can actually be driven right now.
    // "ready" is onlineFor(), not "configured" — a gate on a node that stopped
    // answering is exactly the one you want counted as missing.
    if (g_topoRuntime.loaded()) {
        int total = 0, ready = 0;
        for (const topo::SystemView& sys : topo::systemsOf(g_topoRuntime.topology())) {
            for (JsonObjectConst el : sys.elements) {
                if (!el["type"].is<const char*>()) continue;
                if (strcmp(el["type"].as<const char*>(), "selector") != 0) continue;
                total++;
                if (g_nodeBus.onlineFor(el)) ready++;
            }
        }
        f.gatesTotal = total;
        f.gatesReady = ready;
        f.collectorOn = g_topoRuntime.collectorOn();

        // The tool by ITS name, never a port or machine id — that is what the
        // woodworker recognises, and it is the same rule the canvas follows.
        static std::string toolName;
        toolName.clear();
        std::vector<std::string> active = g_topoRuntime.activeMachines();
        if (!active.empty()) {
            JsonObjectConst m = topo::machineDoc(g_topoRuntime.topology(), active.front());
            const char* n = m["name"].as<const char*>();
            toolName = (n && *n) ? n : active.front();
            f.toolName = toolName.c_str();
        }
    }

    // Nodes: linked / paired. Zero paired nodes leaves the line off entirely
    // rather than printing "nodes 0/0", which reads like a fault on a shop that
    // simply has one board.
    if (remoteLiveCount() > 0) {
        int linked = 0;
        for (int i = 0; i < g_remoteCount; i++)
            if (remoteLive(i) && g_remoteBuses[i].info().connected) linked++;
        f.nodesTotal  = remoteLiveCount();
        f.nodesLinked = linked;

        // A dark board is the fault worth naming: which one, and for how long.
        static std::string darkHost;
        for (int i = 0; i < g_remoteCount; i++) {
            if (!remoteLive(i)) continue;
            topo::RemoteActuatorBus::NodeInfo n = g_remoteBuses[i].info();
            if (n.connected) continue;
            darkHost = g_remoteBuses[i].host();
            f.darkNode = darkHost.c_str();
            // "last seen 42s ago" is the number that says whether this is a
            // board that just rebooted or one that has been off all morning.
            // Zero means it has never answered since boot, which is a different
            // sentence, so the line is left off rather than reading "0s ago".
            if (n.lastSeenMs) f.darkForSec = (int)((millis() - n.lastSeenMs) / 1000);
            break;
        }
    }

    statusscreen::update(f);
}

static void updateStatusLed() {
    switch (currentState) {
        case STATE_HOMING:      statusled::setMotion(statusled::HOMING);      break;
        case STATE_CALIBRATING: statusled::setMotion(statusled::CALIBRATING); break;
        case STATE_MOVING:      statusled::setMotion(statusled::MOVING);      break;
        default:
            // Servo sweeps don't touch currentState (they're not rack moves), so
            // ask the bank directly or a ball-valve-only shop would never show
            // motion at all.
            {
                bool servoMoving = false;
#if defined(ENABLE_SERVO) && defined(SERVO_PWM_PIN_1)
                for (int i = 0; i < SERVO_COUNT; i++)
                    if (g_servos[i].isMoving()) { servoMoving = true; break; }
#endif
                statusled::setMotion(servoMoving ? statusled::MOVING : statusled::STILL);
            }
            break;
    }

#if !HAS_LINEAR
    // g_hardwareFault is set unconditionally on these builds to keep motion
    // refused (see setup(): FaultPolicy returns linearMotion = true whenever
    // there is no rack, which is the correct answer to "may I move?" and the
    // wrong answer to "is anything broken?"). So it can no longer speak for the
    // indicator — STATE_ERROR does. A real failure of the endstops or the
    // outlets still reaches this branch, because that path sets STATE_ERROR too.
    //
    // The latch answers "may I move?", not "is anything broken?" — and the
    // indicator wants the second question. Getting that wrong sat a rackless
    // board in FAULT from boot over a stepper it was never built with.
    if (currentState == STATE_ERROR) {
#else
    if (g_hardwareFault || currentState == STATE_ERROR) {
#endif
        statusled::set(statusled::FAULT);
    }
#if defined(CONTROL_SMART_OUTLET) || defined(ENABLE_HTTP_API)
    else if (WiFi.status() != WL_CONNECTED) {
        statusled::set(statusled::NO_WIFI);
    }
#endif
    // A REFUSED LAYOUT IS ITS OWN STATE, ahead of ONLINE: the board is healthy
    // and on the network, but it will never start routing on its own, and solid
    // blue would say "nothing drawn yet" about a shop that IS drawn.
    else if (!g_topoRejectReason.empty()) {
        statusled::set(statusled::LAYOUT_BAD);
    }
    else if (!g_topoRuntime.loaded() || !allNodesLinked()) {
        statusled::set(statusled::ONLINE);
    } else {
        statusled::set(statusled::READY);
    }

    statusled::update();
    // Before the screen decides whether to be lit, so a press shows up on this
    // pass rather than the next one.
    wakebutton::update();
    servoselftest::update();   // after the button, so a hold starts on this pass
    updateStatusScreen();

}

#ifdef CONTROL_SMART_OUTLET
static OutletSweep g_sweep;

#if defined(CONTROL_SMART_OUTLET)
// One address of a sweep. EXTRACTED FROM loop() ON 2026-09-12, after a stack
// protection fault: the StaticJsonDocument below reserved space in loop()'s
// single enormous frame even on the passes where no sweep was running. Here it
// costs a frame only while it is actually probing.
// TWO PHASES, BECAUSE ONE TIMEOUT WAS SERVING TWO OPPOSITE JOBS (2026-09-13).
//
// This used to be a single full HTTP GET with a 250 ms budget, and that budget
// is right for exactly one of the two things a sweep does:
//
//   - ~250 addresses have NOTHING at them. Each costs the whole timeout, and
//     that product IS the sweep's runtime. The budget must be small.
//   - ~1 address has the plug we are looking for, and answering takes a TCP
//     handshake, a request, and a CHUNKED response. Tasmota ships with
//     `Sleep 50`, so an ESP8285 can add up to 50 ms of latency PER ROUND TRIP —
//     four to six of them here, which lands at 200-300 ms. Right at or past the
//     budget. The budget must be generous.
//
// One number cannot be both, and the old code resolved it in favour of the 250
// empty addresses — so a healthy, present plug could be missed while the sweep
// reported a clean "found nothing", which is the worst answer available. The
// header comment already named this as the first thing to suspect; it was right.
//
// So: phase 1 asks only "is anything listening on port 80" with the tight
// budget, and phase 2 runs the real probe with a generous one on the handful
// that said yes. Runtime barely moves — the expensive half now runs a few times
// instead of 254 — and a slow plug stops being invisible.
//
// THE COST, stated plainly: every device on the subnet that serves HTTP and is
// NOT a Tasmota (a router, a printer, another DustGate board) now costs the
// phase-2 timeout instead of the phase-1 one. Ten of those adds ~12 s to a ~60 s
// sweep. That is the right trade against silently missing the plug.
static const uint32_t kSweepConnectMs = 250;   // phase 1 — is anything there?
static const uint32_t kSweepProbeMs   = 1200;  // phase 2 — let a slow plug answer

static void sweepProbeOne(const char* ip) {
    // PHASE 1 — a bare TCP connect, opened and dropped. No HTTP, no parse.
    // An empty address fails this in well under the budget, which is what keeps
    // the whole pass near a minute.
    {
        IPAddress addr;
        if (!addr.fromString(ip)) return;      // cannot happen; cheap to prove
        WiFiClient knock;
        if (!knock.connect(addr, 80, kSweepConnectMs)) return;
        knock.stop();
    }

    // PHASE 2 — the real thing, now that we know someone is home. The extra
    // handshake this costs is paid only on addresses that already answered.
    TasmotaOutlet probe(ip, "sweep");
    if (!probe.probe(kSweepProbeMs)) return;

    StaticJsonDocument<768> row;
    JsonObject o = row.to<JsonObject>();
    describeOutletInto(o, ip, nullptr,
                       /*kindKnown=*/true, OUTLET_TASMOTA, /*mdnsGen=*/0);
    String s; serializeJson(row, s);
    g_sweep.record(s);
    DEBUG_PRINT(F("[SWEEP] found ")); DEBUG_PRINTLN(ip);
}
#endif

// -----------------------------------------------------------------------------
// describeOutletInto — probe one plug and write the row the picker reads.
//
// ONE ROUTINE, TWO CALLERS, and that is the point. Discovery fills this from an
// mDNS answer (kind and hostname already known); manual entry fills it from an
// IP a person typed and nothing else. Those used to be separate code — the ping
// endpoint probed Shelly ONLY and reported no claim at all — so a plug added by
// hand arrived at the picker looking unlike the same plug found by scanning,
// and a Tasmota added by hand could not arrive at all.
//
// WHEN THE KIND IS UNKNOWN, TRY BOTH. The two protocols share no endpoint — a
// Shelly answers /rpc/Switch.GetStatus, a Tasmota answers /cm?cmnd=Status%208 —
// so probing with the wrong driver reports a live plug as unreachable, and
// there is nothing in an IP address to say which it is. Shelly first, because
// it is the default kind everywhere else (see outletKindFromName()); a Tasmota
// costs one failed Shelly probe before it is found, which is a timeout nobody
// is waiting on but the person who typed the address.
static void describeOutletInto(JsonObject o, const char* ip, const char* mdnsHost,
                               bool kindKnown, OutletKind knownKind, int mdnsGen) {
    // The probe and the row are outlets/OutletOps.h, shared with the native brain.
    outletops::Self self{control.ourHost() ? control.ourHost() : "", control.ourName() ? control.ourName() : ""};
    outletops::describe(o, ip, mdnsHost, kindKnown, knownKind, mdnsGen, self);
}

#endif  // CONTROL_SMART_OUTLET

// -----------------------------------------------------------------------------
// relocateTasmotas — find a tool's plug again after its address changed.
// The reasoning, and the matching rules, are in control/OutletRelocate.h.
//
// Runs on the main loop, like the sweep it borrows (blocking HTTP, one address
// per pass). Three jobs, in order, one per call at most:
//   1. BACKFILL a plug's MAC into the layout while it is still answering, so a
//      layout paired before MACs were stored can still be found later.
//   2. START a sweep when a plug has been silent long enough and none has run
//      lately. Rate-limited: a sweep is a minute of probing on a network that
//      once seemed to object to it (TODO, ESP-NOW).
//   3. APPLY a finished sweep: rewrite the layout for every plug it located.
// -----------------------------------------------------------------------------
#ifdef CONTROL_SMART_OUTLET
static const uint32_t kRelocateAfterMs    = 300000;    // silent this long before we go looking
static const uint32_t kRelocateMinGapMs   = 900000;    // and never sweep more often than this
static const uint32_t kBackfillGapMs      = 30000;

static void relocateTasmotas() {
    static uint32_t lastTick = 0, lastSweepMs = 0, lastBackfillMs = 0;
    static bool     ownSweep = false;
    static uint32_t downSince[SMART_OUTLET_COUNT] = {0};
    const uint32_t now = millis();
    if (now - lastTick < 5000) return;
    lastTick = now;
    if (WiFi.status() != WL_CONNECTED || !g_topoRuntime.loaded()) return;

    // The plugs the layout names, in the same order syncTopologyOutlets() gave
    // them slots — slot i is the i-th machine with an address.
    struct Slot { std::string id; relocate::Outlet o; bool tasmotaOrUnsaid; bool kindUnsaid; };   // 'worth a sweep'
    std::vector<Slot> slots;
    for (const std::string& mid : topo::machineIds(g_topoRuntime.topology())) {
        JsonObjectConst o = topo::machineDoc(g_topoRuntime.topology(), mid)["sensor"]["outlet"];
        const char* ip = o["ip"].as<const char*>();
        if (!ip || !*ip) continue;
        const char* kind = o["kind"] | "";
        slots.push_back({mid, {mid, ip, relocate::normMac(o["mac"] | "")},
                         // Only a plug KNOWN to be a Tasmota is worth a sweep: an unsaid
                         // kind is a Shelly that may simply be switched off, and
                         // sweeping a network every 15 minutes for it is not free.
                         strcmp(kind, "tasmota") == 0 || !relocate::normMac(o["mac"] | "").empty(),
                         !*kind});
    }
    for (size_t i = 0; i < slots.size() && i < (size_t)SMART_OUTLET_COUNT; i++) {
        SmartOutlet* so = control.outlet((int)i);
        if (!so || so->isReachable()) { downSince[i] = 0; continue; }
        if (!downSince[i]) downSince[i] = now ? now : 1;
    }

    // 3. a finished sweep of ours
    if (ownSweep && !g_sweep.running()) {
        ownSweep = false;
        std::vector<relocate::Outlet> lost, all;
        for (size_t i = 0; i < slots.size(); i++) {
            all.push_back(slots[i].o);
            if (i < (size_t)SMART_OUTLET_COUNT && downSince[i] && now - downSince[i] >= kRelocateAfterMs &&
                slots[i].tasmotaOrUnsaid)
                lost.push_back(slots[i].o);
        }
        std::vector<relocate::Found> found;
        for (const String& row : g_sweep.rows()) {
            StaticJsonDocument<768> d;
            if (deserializeJson(d, row)) continue;
            found.push_back({d["ip"] | "", relocate::normMac(d["mac"] | ""), d["pickable"] | false});
        }
        const std::vector<relocate::Result> res = relocate::match(lost, all, found);
        for (const relocate::Result& r : res) {
            DEBUG_PRINT(F("[RELOCATE] ")); DEBUG_PRINT(r.id.c_str());
            DEBUG_PRINT(F(" found at ")); DEBUG_PRINT(r.ip.c_str());
            DEBUG_PRINT(F(" (MAC ")); DEBUG_PRINT(r.mac.c_str());
            DEBUG_PRINTLN(r.byElimination ? F(") — the only unclaimed plug, so it must be this one; layout updated.")
                                          : F(") — matched by MAC; layout updated."));
            linklog::event("relocate", r.id.c_str(), "");
            apiServer.setMachineOutlet(r.id.c_str(), r.ip.c_str(), "tasmota", r.mac.c_str());
        }
        if (res.empty() && !lost.empty()) {
            DEBUG_PRINT(F("[RELOCATE] swept the subnet, found ")); DEBUG_PRINT((int)found.size());
            DEBUG_PRINTLN(F(" plug(s) and could not tell which is the lost one — leaving the layout alone."));
        }
        return;
    }
    if (g_sweep.running()) return;

    // 0. A plug the layout calls a Shelly (no `kind`) that has not answered for a
    //    minute may be a Tasmota the layout was saved wrong about — three screens
    //    used to drop `kind` (2026-10-03), and a Shelly poll of a Tasmota never
    //    answers. Ask the same address as a Tasmota; if it does, correct the layout.
    if (now - lastBackfillMs >= kBackfillGapMs) {
        for (size_t i = 0; i < slots.size() && i < (size_t)SMART_OUTLET_COUNT; i++) {
            if (!slots[i].kindUnsaid || !downSince[i] || now - downSince[i] < 60000) continue;
            lastBackfillMs = now;
            TasmotaOutlet t(slots[i].o.ip.c_str(), "kind");
            if (!t.probe(1200)) break;
            std::string mac; t.readMac(mac, 1200);
            const std::string n = relocate::normMac(mac.c_str());
            DEBUG_PRINT(F("[RELOCATE] ")); DEBUG_PRINT(slots[i].id.c_str());
            DEBUG_PRINT(F(" at ")); DEBUG_PRINT(slots[i].o.ip.c_str());
            DEBUG_PRINTLN(F(" answers as a Tasmota — the layout had it as a Shelly; correcting it."));
            apiServer.setMachineOutlet(slots[i].id.c_str(), slots[i].o.ip.c_str(), "tasmota", n.c_str());
            return;
        }
    }

    // 1. backfill one MAC
    if (now - lastBackfillMs >= kBackfillGapMs) {
        lastBackfillMs = now;
        for (size_t i = 0; i < slots.size() && i < (size_t)SMART_OUTLET_COUNT; i++) {
            SmartOutlet* so = control.outlet((int)i);
            if (!so || !so->isReachable() || !slots[i].o.mac.empty() || so->kind() != OUTLET_TASMOTA) continue;
            TasmotaOutlet t(so->ip(), "mac");
            std::string mac;
            if (!t.readMac(mac, 1200)) continue;
            const std::string n = relocate::normMac(mac.c_str());
            if (n.empty()) continue;
            DEBUG_PRINT(F("[RELOCATE] recording the MAC of ")); DEBUG_PRINT(slots[i].id.c_str());
            DEBUG_PRINT(F(" (")); DEBUG_PRINT(n.c_str()); DEBUG_PRINTLN(F(") so it can be found if its address changes."));
            apiServer.setMachineOutlet(slots[i].id.c_str(), so->ip(), "", n.c_str());
            return;
        }
    }

    // 2. start a sweep
    if (lastSweepMs && now - lastSweepMs < kRelocateMinGapMs) return;
    for (size_t i = 0; i < slots.size() && i < (size_t)SMART_OUTLET_COUNT; i++) {
        if (!slots[i].tasmotaOrUnsaid || !downSince[i] || now - downSince[i] < kRelocateAfterMs) continue;
        if (g_sweep.begin(WiFi.localIP())) {
            ownSweep = true; lastSweepMs = now;
            DEBUG_PRINT(F("[RELOCATE] ")); DEBUG_PRINT(slots[i].id.c_str());
            DEBUG_PRINT(F(" at ")); DEBUG_PRINT(slots[i].o.ip.c_str());
            DEBUG_PRINTLN(F(" has not answered for 5 min — sweeping the subnet for it."));
        }
        return;
    }
}
#endif
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
