jeff-engineers/dustgate/firmware/motor/ServoActuator.h

// =============================================================================
// ServoActuator.h — positional-servo driver (ball-valve gates).
//
// A thin wrapper over ESP32Servo. Instead of snapping to the target, it SWEEPS
// there smoothly (a gentle eased motion, not a slam) over a duration proportional to
// how far it actually has to travel — a full quarter-turn takes the deliberate
// SERVO_SWEEP_MS, a few degrees land almost at once, which is what makes the setup
// jog control usable. It then
// HOLDS the servo energized for SERVO_HOLD_MS so an analog servo has time to
// catch up to the commanded angle, and finally auto-DETACHES so the coil
// de-energizes — the ball valve holds position by hard-stop friction / optional
// detent (see docs/archive/topology-schema.md). Detaching is essential for ANALOG
// servos (e.g. Power HD 3001HB), which hunt/groan continuously while holding.
// Set holdAtRest(true) only for a build that would back-drive when de-energized.
//
// Non-blocking: moveTo() sets up the sweep; update() (called every loop) steps
// the angle, then performs the deferred detach. This is the muscle behind the
// branch-selector HAL: a servo state is state → angle.
//
// POWER: servos run off an EXTERNAL 5–6V rail, NOT the ESP32 pins — only the PWM
// signal wire goes to the GPIO, and grounds must be common.
//
// DE-ENERGIZING IS NOT DETACHING, on Arduino core 3.x. See _deenergize() below:
// the obvious Servo::detach() is a one-way door on that core and kills the
// channel for the rest of the boot. Everything else here is unchanged.
// =============================================================================

#pragma once
#include <Arduino.h>
#include "../config.h"

#if defined(ENABLE_SERVO) && defined(SERVO_PWM_PIN_1)

#if defined(ESP_ARDUINO_VERSION_MAJOR) && ESP_ARDUINO_VERSION_MAJOR >= 3
#define DG_SERVO_LEDC 1             // core 3.x: the channel is ours, no library (see _attach())
#else
#define DG_SERVO_LEDC 0
#include <ESP32Servo.h>
#endif
#include "../control/NodeLink.h"   // the shop's default pulse range and its bounds (kDefaultServoMinUs)

class ServoActuator {
public:
    // Bind to a GPIO (does not attach/energize yet — attach happens on first move).
    void begin(int pin) { _pin = pin; }

    // Keep the servo energized after moving (default false = move-then-detach).
    void setHoldAtRest(bool hold) { _holdAtRest = hold; }

    // THE PULSE RANGE angle 0..180 maps to, for EVERY servo on this board (2026-10-07). It was a fixed 500–2500 µs, and
    // ESP32Servo clamps to exactly that whatever it is asked, so the MG995s in the shop never reached their full swing.
    // Now the shop sets it (Settings, the layout's `servo` block, kDefaultServoMinUs in NodeLink.h) and the pulse is
    // written to the PWM channel directly — and on core 3.x the channel is attached directly too (_attach()).
    // A range wider than a servo can turn drives it into its own stop on the way to an end: harmless only because
    // calibration finds the ends and nothing afterwards asks for more than it saved.
    static void setPulseRange(int minUs, int maxUs) {
        if (!topo::nodelink::servoRangeOk(minUs, maxUs)) return;
        minRef() = minUs; maxRef() = maxUs;
    }
    static int  pulseMinUs() { return minRef(); }
    static int  pulseMaxUs() { return maxRef(); }

    // Move to an angle (0–180°). Attaches on demand and starts a smooth eased
    // sweep from the current angle over SERVO_SWEEP_MS; update() drives it. The
    // very first move (position unknown) goes directly. Pulse range: setPulseRange().
    void moveTo(int angleDeg) {
        if (_pin < 0) return;
        angleDeg = constrain(angleDeg, 0, 180);
        if (!attached()) _attach();
        if (_curAngle < 0) {                     // first move: unknown start → snap
            _curAngle = angleDeg;
            _write(angleDeg);
            _sweeping    = false;
            _detachAtMs  = millis() + SERVO_HOLD_MS;
            _detachArmed = !_holdAtRest;
            return;
        }
        _fromAngle    = _curAngle;
        _toAngle      = angleDeg;
        _sweepMs      = sweepMsFor(_toAngle - _fromAngle);
        _sweepStartMs = millis();
        _sweeping     = (_fromAngle != _toAngle);
        _detachArmed  = false;                   // re-armed when the sweep finishes
        if (!_sweeping) {                        // no movement → just (re)hold then detach
            _detachAtMs  = millis() + SERVO_HOLD_MS;
            _detachArmed = !_holdAtRest;
        }
    }

    // Call every loop(): advances the eased sweep, then performs the deferred
    // detach once the post-move hold has elapsed.
    void update() {
        const unsigned long now = millis();
        if (_sweeping) {
            const unsigned long el = now - _sweepStartMs;
            if (el >= _sweepMs) {
                _curAngle    = _toAngle;
                _write(_toAngle);
                _sweeping    = false;
                _detachAtMs  = now + SERVO_HOLD_MS;   // hold powered so it can catch up
                _detachArmed = !_holdAtRest;
            } else {
                float t = (float)el / (float)_sweepMs;        // 0..1
                t = t * t * (3.0f - 2.0f * t);                // smoothstep ease-in-out
                _curAngle = _fromAngle + (int)lroundf((_toAngle - _fromAngle) * t);
                _write(_curAngle);
            }
            return;                                  // never detach mid-sweep
        }
        if (_detachArmed && attached() && (long)(now - _detachAtMs) >= 0) {
            _deenergize();
            _detachArmed = false;
        }
    }

    // Immediately de-energize (stop pulses; ball holds by friction/detent).
    void detach() { _deenergize(); _detachArmed = false; _sweeping = false; }

#if DG_SERVO_LEDC
    bool attached() const { return _attached; }
#else
    bool attached() { return _servo.attached(); }
#endif
    int  pin() const { return _pin; }

    // True while this servo is drawing move current: the eased sweep is running,
    // OR the post-move hold is still energizing the coil so an analog servo can
    // catch up. LocalActuatorBus gates on this to guarantee only one servo is
    // ever driven at a time — the 5V rail can't take two (see
    // docs/archive/architecture-rfc.md §7). A holdAtRest servo reports false once the
    // sweep ends: it draws holding current indefinitely, so blocking on it would
    // deadlock the move queue.
    bool isMoving() const {
        if (_sweeping) return true;
        return _detachArmed && (long)(millis() - _detachAtMs) < 0;
    }

private:
    // Take the pin's PWM channel: 50 Hz, 10-bit.
    //
    // ON CORE 3.x THIS NO LONGER GOES THROUGH ESP32Servo (2026-10-08). The library's attachPin(pin, freq, bits) calls
    // setup(), which already does ledcAttachChannel(pin, ...), then attachPin(pin), which does it again — so the core
    // refused the second one and printed, on the first move of every boot,
    //
    //   ledcAttachChannel(): Pin 12 is already attached to LEDC (channel 0, resolution 10)
    //   attachPin(): [ESP32PWM] ERROR PWM channel failed to configure on pin 12!
    //
    // harmlessly (the first attach had worked), but indistinguishable on sight from the real failure below. Once the
    // pulse was being written straight to the channel (_write()), the library was doing nothing but that double attach,
    // so it went. A failure to attach now says so once, in our own words.
    void _attach() {
#if DG_SERVO_LEDC
        _attached = ledcAttach(_pin, 50, kLedcBits);
        if (!_attached) { Serial.print(F("[SERVO] could not take a PWM channel for pin ")); Serial.println(_pin); }
#else
        _servo.setPeriodHertz(50);
        _servo.attach(_pin, 500, 2500);      // the library's own bounds; core 2.x writes through it, clamped
#endif
    }

    // Stop driving the servo, WITHOUT giving up the LEDC channel. (The history below is ESP32Servo's; on core 3.x the
    // library is gone (_attach()), but the rule stands: ledcDetach and re-attach is exactly the path that failed.)
    //
    // What we want physically is "no pulse train", so an analog servo goes limp
    // instead of hunting and groaning against its hard stop. Servo::detach() is
    // the obvious way to get that and it is a trap on Arduino core 3.x:
    //
    //   Servo::detach() -> ESP32PWM::detachPin() -> ledcDetach(pin) + deallocate()
    //
    // On the ESP32-C5 (core 3.x, ESP32Servo 3.2.1) the ledcDetach() half does not
    // clear the core's per-pin binding, while deallocate() clears the library's
    // own bookkeeping regardless. The two then disagree permanently: attached()
    // reports false, so the next moveTo() re-attaches, and the core refuses —
    //
    //   ledcAttachChannel(): Pin 12 is already attached to LEDC (channel 0, ...)
    //   attachPin(): [ESP32PWM] ERROR PWM channel failed to configure on pin 12!
    //
    // — and attachPin() returns WITHOUT setting attachedState, so the channel is
    // gone for the rest of the boot. Symptom: a gate moves exactly once after a
    // reboot and is then dead, silently, while the UI still looks like it is
    // working. Found on a C5 primary 2026-08-22 from the jog slider; the fix is
    // confirmed on hardware the same day, on a primary and a node, by the wake
    // button's self-test sweeping all four channels repeatedly.
    //
    // ⚠️ THE SAME TWO LINES ALSO PRINT, HARMLESSLY, ON THE FIRST MOVE OF EVERY
    // BOOT (seen on a node 2026-09-27). ESP32Servo's attachPin(pin, freq, bits)
    // calls setup(), which on core 3.x already does ledcAttachChannel(pin, ...),
    // and then attachPin(pin), which does it again — the core refuses the second
    // one, but the pin IS attached (channel 0, 10-bit, exactly what the error
    // names) and attachedState was set before the attempt. So the servo moves.
    // Tell the two apart by WHEN: once, on a boot's first move, is this; on a
    // move AFTER the servo has de-energised, with the gate then dead, is the bug.
    //
    // So on core 3.x we attach once and never let go: duty 0 is a constant LOW,
    // which is the same "no pulses" the servo needs, and the next write() picks
    // the channel straight back up. On core 2.0.x — the DevKitC, the QT Py node —
    // detach/attach cycles correctly and there is no reason to change it, so it
    // keeps the behaviour it has been running with.
    void _deenergize() {
        if (_pin < 0) return;
#if DG_SERVO_LEDC
        if (_attached) ledcWrite(_pin, 0);
#else
        _servo.detach();
#endif
    }

    // Sweep duration for a move of this many degrees. Proportional to travel so a
    // full quarter-turn still eases over the deliberate SERVO_SWEEP_MS while a small
    // setup nudge lands immediately — see the SERVO_MS_PER_DEG note in config.h.
    static unsigned long sweepMsFor(int deltaDeg) {
        const unsigned long want = (unsigned long)abs(deltaDeg) * SERVO_MS_PER_DEG;
        if (want < SERVO_SWEEP_MIN_MS) return SERVO_SWEEP_MIN_MS;
        if (want > SERVO_SWEEP_MS)     return SERVO_SWEEP_MS;
        return want;
    }

    // Angle → this board's pulse range → PWM ticks, written straight to the channel: Servo::write() would clamp to
    // 500–2500 µs. Core 2.x (no pin-addressed ledcWrite) keeps the library's clamped write.
    void _write(int angleDeg) {
        if (_pin < 0 || !attached()) return;
        const long us = minRef() + (long)(maxRef() - minRef()) * angleDeg / 180;
#if DG_SERVO_LEDC
        const uint32_t ticks = (uint32_t)((us * (1UL << kLedcBits) + 10000) / 20000);   // 50 Hz frame = 20000 µs
        ledcWrite(_pin, ticks);
#else
        _servo.writeMicroseconds((int)us);
#endif
    }

    // One range per board, shared by every servo on it; the default until a layout or a SET says otherwise.
    static int& minRef() { static int v = topo::nodelink::kDefaultServoMinUs; return v; }
    static int& maxRef() { static int v = topo::nodelink::kDefaultServoMaxUs; return v; }
#if DG_SERVO_LEDC
    static const uint8_t kLedcBits = 10;   // 1024 ticks a frame: ~19.5 µs a tick, ~0.2° on a 2200 µs range
    bool          _attached    = false;
#else
    Servo         _servo;
#endif
    int           _pin         = -1;
    bool          _holdAtRest  = false;   // default: move then detach (analog-friendly)
    int           _curAngle    = -1;      // last commanded angle (-1 = unknown until first move)
    int           _fromAngle   = 0;
    int           _toAngle     = 0;
    bool          _sweeping    = false;
    unsigned long _sweepStartMs = 0;
    unsigned long _sweepMs     = SERVO_SWEEP_MS;   // this move's duration (travel-scaled)
    bool          _detachArmed = false;
    unsigned long _detachAtMs  = 0;
};

#endif // ENABLE_SERVO && SERVO_PWM_PIN_1
