jeff-engineers/dustgate/(commit log)

2026-07-12 Rework wizards and UI
    [HttpApiServer.cpp, HttpApiServer.h, SmartOutletControl.cpp, SmartOutletControl.h, config.h]
2026-07-13 Flashing wizard and firmware fixes
    [HttpApiServer.cpp, MotionMath.h, SerialDebugControl.cpp, SerialDebugControl.h, SmartOutletControl.cpp, SmartOutletControl.h, WiFiProvisioner.h, config.h]
2026-07-22 2 endstop firmware
2026-07-23 auto-calibration wizard
2026-08-22 Phase 2: one brain, N systems, drawn on a canvas (#1)
    * Push based outlet monitoring, not tested on hardware
    * Phase 2 start
    * phase 2 - mock topology
    * Phase 2 - servo control
    * Phase 2 ui
    * GUI routing improvements
    * Routing ducts
    * Fix demo mode
    * Gate configurator
    * Multinode setup
    * A* routing
    * Deprecate v1
    * boards gui cleanup
    * Routing
    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
    [partitions-devkitc-noota.csv]
2026-08-28 Cleanup (#2)
    * Park the two things phase 2 left behind
    Both were noticed while landing the manual blower run and neither belongs
    in that change.
    The dead endpoint is the sharper one: /api/dustcollector/switch still
    answers 200 and still does nothing under a shop, because the loop
    re-asserts the plug from the routing runtime a moment later. An endpoint
    that fails silently while reporting success is worth deleting rather than
    leaving for the next person to debug.
    The bench note is a re-framing, not a new item: with phase 2 on main, the
    testing list stops being a backlog and becomes the only thing standing
    between "compiles" and "works".
    * One board, either role: a XIAO C5 can be the primar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
    [partitions-devkitc-noota.csv, partitions-xiao-c5-primary.csv]
2026-08-28 Serial servo (#3)
    * A console for the first five minutes with a bus servo
    First contact with an ST3215 needs to answer five questions — is anything
    there, at what id and baud, does it move, does it stop, can I turn it by
    hand — and none of them are about DustGate. So this is its own program on
    its own env: no WiFi, no topology, no gate, nothing that has to be set up
    before a shaft turns.
    ST3215Bus is the hand-rolled protocol (FF FF ID LEN INSTR .. CHKSUM), with
    the half-duplex echo drained in software rather than trusting the IDF's
    RS485 mode on this part. Its register map is the piece most likely to be
    wrong for a given servo, so the console can read raw addresses and flip
    16-bit endi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
    [ST3215Bus.cpp, ST3215Bus.h, st3215_bench.cpp, xiao_c5.h]
2026-09-02 St3215 slider (#4)
    * The slider drives a real rack, and a board has four ports or one
    The ST3215 slider works end to end as a primary: a 4-gate rockler-2.5 rack
    homes, releases its datum, runs the reference sweep and moves to every gate.
    Measured span 252.0mm against 250.7mm predicted from the manifold pitch —
    0.53%, and a real check on the geometry, because counts/mm is derived from
    module 1.7592 / 30T and fitted to nothing.
    Getting there found four bugs, each of which had to be seen on hardware:
    - No step command cancels a move in flight. Zero steps does nothing (it
    drove a carriage into its endstop until the servo's overload tripped) and
    neither does a one-step supersede. T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
    [CalibrationStore.cpp, CalibrationStore.h, FaultPolicy.h, FeedbackSystem.h, HttpApiServer.cpp, HttpApiServer.h, LimitSwitchDistance.cpp, LimitSwitchDistance.h]
2026-09-04 Sensing/switching RFC, on-demand slider homing, build stamp (#5)
    Three independent bodies of work that were sharing a working tree.
    1. Tool sensing & collector switching (docs/tool-sensing-rfc.md, new)
    A 1HP collector trips the overpower protection on a Shelly Plus Plug US.
    The protection exists to guard the RELAY CONTACTS, so neither disabling
    it nor buying a bigger plug is a fix — the relay is the problem.
    Sensing and switching separate. Tools are only ever sensed, so they get a
    no-relay pass-through metering plug (Athom/Tasmota, $13) or our own CT;
    the collector is commanded by the RF dust-collector remote already in the
    shop (Rockler, 315MHz, HT12E, FCC ID VFWPD5T), driven by an HT1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
    [WakeButton.h, dustgate_node.cpp]
2026-09-06 Gate cap and homing (#6)
    * Dust-bin sensing on the primary, as a capability
    A bin sensor is one input pin, so it needs no env of its own. RFC §7.5
    supersedes §7.4's "new node type": PIN_BIN_SENSOR in the board header,
    HAS_BIN derived like HAS_LINEAR, and a primary gets it on the same terms
    as a node. That honours §7.2's bin.sensor.controllerId, which always
    pointed at *a* controller rather than a special one.
    NOTHING HAS BEEN WIRED. Every hardware number here is from a datasheet.
    Firmware
    utils/BinSensor.h BinDebounce + localBinSystemId(), pure, host-tested
    TopologyRuntime binKnown/binFull, setBinFull(), binSensorFor(),
    systems[].bin in writeStatus
    fir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
2026-09-07 Two lines never share a lane, and a board can be unpaired where it stands
    Three faults reported from the shop, and two of them are the same rule
    missing in two layers.
    **A splice that would overlap ducts is refused.** Adding a ball valve on a
    branch dot above another one drew runs on top of each other. The router
    already refuses to share a lane — and then gives the rule up rather than
    fail, relaxing in three steps and finally returning the overlapping picture
    anyway. That fallback is right for a shop dragged into a corner: the canvas
    has to draw something. It is wrong as the answer to "add a ball valve here",
    where nothing is lost by declining. So the splice is dry-run and rolled back
    whe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
2026-09-07 Overlap is what you can SEE, not what the lattice recorded
    Jeff dragged the Planer's ball valve up beside the Cyclone and got two runs
    drawn as one line. The splice guard added an hour earlier did not fire, and
    neither did anything else, because the router's idea of "these two share a
    lane" is its own lattice edges — and two shapes reach the screen without ever
    claiming one:
    * A sub-cell stub. Two glyphs in adjacent cells are joined by a line
    shorter than a lattice edge, so the run traverses no edge and claims
    nothing. That is exactly the drag reported.
    * A shared origin. Two ducts off one outlet, both leaving in the same
    direction, are one line until they separate. Not tw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
2026-09-07 Two runs never leave a device by the same port
    Jeff asked whether we used to offset ducts to keep them apart, the way wires
    still do. We did: laneOffset staggered collinear runs by signed column
    distance, and it was deleted in the A* rewrite as one of five local guesses
    that fought each other. The note that introduced it is the interesting part —
    it ends by admitting it left "only a tiny shared stub" near the source, and
    that stub is exactly what has been surviving ever since.
    So this is a port choice rather than a geometry fudge. A junction offers all
    four sides; the leg heading west should leave westward instead of trailing the
    leg going south and turning a moment later. The two cost th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
2026-09-07 Say out loud that the auxiliary run is an ordinary duct
    It already gets the overlap treatment — routePass branches on nothing, so
    PORT_REUSE and the drawn-overlap check apply to a supplemental port's run
    exactly as to a trunk. But that is easy to doubt: the auxiliary run is drawn
    grey, dashed and thinner, and it is the one run allowed to cross a system
    seam, which makes "it is routed differently too" a reasonable thing to assume
    — and it was the run in both of the overlaps reported today.
    R17 asserts it instead, so the day someone special-cases the secondary run,
    this says what that costs. Checked in the browser too: the demo's dashed run
    is one of 22 and shares a lane with nothing.
2026-09-07 shared means "drawn over another run", and the tidiest attempt wins
    Two corrections to this morning's overlap work, both found by moving the demo's
    drum sander down one cell.
    `shared` was the union of two different claims. One is "this duct is drawn over
    another" — the fact worth reporting. The other, from the pass, is "this duct
    could not be routed under the no-shared-lane rule, so the rule was relaxed for
    it", which is weaker: the relaxed route often lands somewhere clean anyway.
    Reporting both named runs that were perfectly fine. The pass still reports the
    weaker fact and the retry still reorders on it — a duct that could not get an
    exclusive lane is the one worth routing first next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
2026-09-07 Route below the collector, nest shared lanes, and tune against several layouts
    Three changes to how a duct is drawn, and one to how the numbers behind them
    get chosen.
    THE CEILING. The router had no opinion about height, and the empty band across
    the top of a board is the cheapest part of the lattice — so it was where every
    squeezed run went, drawn as pipe going up only to come back. The topmost
    collector's outlet is now a wall for the first two routing attempts, with a
    per-step cost behind it for boards where the wall has to yield. It must yield:
    a machine parked above the collector still needs reaching, and a hard filter
    would either strand it or push the search out through the margin t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
2026-09-07 A ceiling per system, and two things that came adrift
    CEILINGS, PLURAL. The global one is the topmost collector's outlet — the top of
    the page, which nothing crosses, an auxiliary run included. Each system below
    the first also gets its own, at its own collector, so its ducting stays inside
    its band instead of climbing into the shop above it. The auxiliary run is
    exempt from that second one and only that one: reaching a machine in the system
    above is the entire job it exists for, and it is already the only run allowed
    to cross the seam. The router had no notion of a system, so SceneNode carries
    systemId now, read for nothing else. R18c asserts both halves.
    MOVING A MACHINE LEFT ITS SECOND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
2026-09-07 Press a piece to trace its run back to the collector
    Following a grey line across three screens with a finger was how you answered
    "where does this actually go", and the canvas knew the answer the whole time.
    Pressing a machine, a valve or a length of pipe now lights every run between it
    and its collector, plus the cable of every gate on the way — a tool has no cable
    of its own, so what drives it is the gate upstream of it.
    TWO LAYERS, the shape a selected box already wears: a brighter line, and the
    ground lifted around it. A duct is already stroked twice (a fat casing in the
    canvas colour, then the pipe), so its lit state is those same two strokes at
    different values and costs no new geo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
2026-09-07 Hold to move a piece, and stop the phone deciding what a press means
    The canvas had been treating a finger like a mouse. A press on a glyph armed a
    drag on contact, which won every ambiguous gesture: scrolling a shop meant
    hunting for a gap between pieces, and missing the gap moved a machine you never
    asked to move. On touch the press now waits ~320ms — travel first and it is a
    scroll (the pan takes the gesture from the first pixel, so nothing stutters),
    lift first and it is a tap, hold still and the piece comes up, with a short buzz
    for the moment the gesture changes meaning. A MOUSE keeps the instant drag: it
    has a cursor and a button, so its press was aimed.
    EVERY canvas gesture takes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
2026-09-07 Solve the trunk first, and stop seating a tee inside a manifold
    Teeing a branch off the demo shop's trunk and dragging it down beside the
    manifold produced a board nobody would build: the trunk drawn as three separate
    lines at three different heights, and the manifold's feed climbing to the
    collector's own line to cross the entire shop and come back down. Reported from
    the shop with screenshots; three faults, all reachable from that one gesture.
    THE SOLVE ORDER WAS ALPHABETICAL BY CHILD ID, which is deterministic and nothing
    else. On this shop that puts every sel* and tool* ahead of every wye*, so the
    MAIN TRUNK was the last thing routed — and until it was, the band along the top
    of the b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
2026-09-07 The decision register has been rendering nothing since D-69
    One apostrophe. `<b>And the platform's own long-press MENU...` sits inside a
    single-quoted JS string in the DECISIONS array, so it closed the string and the
    rest of D-69's `why` parsed as code. The array never evaluated, the page threw
    before it rendered a single card, and the register — the thing CLAUDE.md points
    at as the place decisions live — has shown an empty shell since the commit that
    added it.
    Nothing catches this. The register is a hand-maintained array in a page nobody
    loads in CI, and every entry is a paragraph of prose full of apostrophes, so it
    is a matter of time rather than of care. Worth a parse check on the mo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
2026-09-07 Record the routing-order and branch-dot rules on the canvas page
    Three rules from the routing fix, written where the canvas decisions live rather
    than only in the router's own comments.
    Section 2b gains the two routing rules: the TRUNK IS DRAWN FIRST, because an
    unclaimed lane is free and while the trunk was solved last the empty band along
    the top of the board looked to every other run like open highway; and SHARING A
    LANE IS PRICED, NEVER FORBIDDEN, because a ban cannot weigh two pictures against
    each other and will buy a clean lane at any price at all. It also states, as its
    own rule, that no duct is ever drawn underneath a machine, gate, board or
    collector — and says plainly that the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
2026-09-08 Put the calibrator back on the /gates page
    SelectorConfigComponent grew a second pane — 'board' for the wiring (name,
    board, channel) and 'travel' for the calibration itself — and 'board' is the
    default. The canvas asks for the pane it wants from its two menu rows; /gates
    never did, so every Calibrate / Recalibrate / Run setup again button on that
    screen opened the wiring half, which has nothing to calibrate on it.
    The entry point did not move. The component grew a pane underneath it and this
    caller was not told.
    /gates is the wrench-in-hand errand by its own design note, so it asks for
    'travel'. Picking a board is a layout decision the canvas owns, and every gate
    already gets one at c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
2026-09-08 Sort the TODO into what landed and what did not
    A Done section at the bottom, holding the seven items that have landed and
    whose reasoning is worth not re-deriving — the overlap and lane work, the
    grid pitch, the problem halo, the selection trace, and the first bench item.
    Everything with an open half stayed put: bench 2 and 10 both still carry
    things nobody has tried on a board.
    Three cross-references broke in the move and are repaired rather than left
    dangling: "the trace above", "the prevention work below", and the file header,
    which now says what Done is for instead of only saying to delete landed items.
    Hover-to-trace is deleted, not moved (jeff) — selection is the whole gesture.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
2026-09-08 Stop the gate sheet offering ports no board has
    A one-port slider node advertised "4 of 4 free" to a manifold, and let itself be
    picked. Two faults behind it, both in the same picker:
    boardLabel() asked the GATE what it wanted instead of asking the BOARD what it
    has, so every board was described as a four-channel PWM bank. It now resolves
    each board's `drives` the way the canvas and the Boards list already do — live
    report first, saved cache second, 'servo' last — and a slider board says it
    drives one rack.
    And nothing enforced canHost(), which has existed for this since 2026-09-02 and
    had one caller: the canvas's pickBoard(). A board that cannot run this gate is
    now disabled in the li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
2026-09-08 Say when the shop is out of ports, instead of only when a gate collides
    Running out of somewhere to plug a gate in showed up as a schema failure about
    a duplicated servo channel, which names the collision and not the cause. The
    guide bar now says it plainly, above "still needs setting up" — a gate with no
    port cannot BE set up, so sending someone to tap its orange dot first is sending
    them to finish something with nowhere to finish.
    Counted PER KIND, which is the whole point: a spare servo channel cannot take a
    rack, so a single total would report a shop with three free channels and a
    second sliding gate as having room. Counted off every paired controller rather
    than off boards(), which s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
2026-09-08 Explore what dropping a piece in the seam should do
    Not built, and deliberately not: this changes the "What can stop a drag" table
    in canvas.html, which is the page that arbitrates a new canvas marking, so it
    goes up for review first.
    The bug, in jeff's words: the gap between two systems is a CONSUMABLE. Drop a
    piece into it and the band simply grows to swallow the row, so the second drop
    is refused — the bands now touch — and nothing puts the row back. A shop can
    only ever get tighter. Half of this was already found and fixed in the DRAWING,
    which is why systemSeparators() exists ("a rule can't be dragged shut"); the
    row itself never came back.
    The proposal is that a drop on the seam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
2026-09-08 Dropping a piece on the seam opens a row instead of spending one
    The gap between two systems was a consumable and nobody had noticed it was
    being spent. A piece dropped into the empty row simply grew its own band over
    it — a band is derived from where its pieces stand — so the first drop worked
    and every one after was refused with "that row belongs to Shop Vacuum", because
    the bands now touched. Nothing put the row back, so a shop could only ever get
    tighter (jeff: "the extra row vanishes once you do that, meaning that you can't
    keep moving things down").
    Half of this had already been met in the DRAWING, which is why
    systemSeparators() exists — a labelled rule so the seam survives bei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
2026-09-08 Archive the seam exploration and tick it off the TODO
    D-71 is built and folded into canvas.html, so the exploration goes where every
    superseded mockup goes, with the banner this folder's README insists on: a page
    that still looks current is the trap the archive exists to avoid. Its demo runs
    the real rule rather than illustrating it, so it is still worth clicking — the
    README row says so.
    The TODO item moves to Done keeping the diagnosis, which is the half worth not
    re-deriving: the gap was a consumable and nobody had noticed it was being spent.
    It also keeps what was deliberately NOT built — the push is downward only.
    And the "no way to move a system" item now says half its machinery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
2026-09-09 Reset torque state when the slider's bus servo reconnects
    reconnect() resets everything begin() would have set — online, moving, homing,
    position, target, both chunk bounds — but not _torque. That one omission is the
    difference between a servo that comes back and one that only looks like it did.
    A servo that has been unplugged, power-cycled or overloaded comes back holding
    nothing; the header says so in capitals as fact 3, and it is why begin() enables
    torque explicitly rather than assuming. But enable() is idempotent against
    _torque, and _torque was still true from before the servo went away. So the
    guard fired, the torque write never went out, and begin() returned success on a
    de-ener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
    [ST3215LinearDriver.cpp]
2026-09-09 Scope the slider's zero-travel fault counter to one move
    _zeroTravelRetires counts commands that retired without shifting the carriage,
    and two in a row is treated as a fault — jammed, unpowered, or in the wrong
    mode. That is the right call, but "in a row" was never scoped to anything: the
    counter is cleared only by a retire that DID travel, so it persisted across
    moves and across a whole session.
    A single zero-travel retire is ordinary. It is what happens when a move ends
    with a residual too small to overcome static friction — the case kArrivalSlack's
    own comment describes as normal and expected. So one of those at the tail of a
    move left the tally at 1, and the first such retire of th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
    [ST3215LinearDriver.cpp]
2026-09-09 Record the burndown process in the review, and tick off what has landed
    The three fixes so far — the torque reset, the zero-travel counter, and the
    build artifacts — were made before the tick-off rule existed, so they are
    caught up here in one go. Everything after this ticks off in the same commit as
    its fix, which is what stops the list and the tree disagreeing.
    Headings keep their numbers on purpose. Findings cross-reference each other
    (§5.2 folds into §7.2, §5.1 points at §7.1), so a landed fix keeps its heading
    and gains a FIXED line rather than being deleted and everything renumbered.
2026-09-09 Stop retrying a slider drive that is already answering
    retryDriveIfNeeded() exists to bring back a servo that never came up or went
    away. Its guard read `motor.online() && g_homing == HOME_NEEDED`, which meant a
    HOME_FAILED state with a perfectly healthy servo fell through to the reconnect
    below — every 15 seconds, forever.
    Both things that happened then were bad. reconnect() sets HOME_NEEDED and
    g_homeAsked stays set by design, so loop() started another sweep on the next
    tick: the "reached the FAR endstop" fault, whose own message says it needs a
    person and is explicitly not fixed by driving the other way, drove the carriage
    at the far end four times a minute, unattended. And reconnect()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
    [dustgate_node.cpp]
2026-09-09 Stop a malformed layout from crashing the board on every boot
    TopologyStore::validateMinimal deliberately checks very little — the UI's
    validateShop() is the authority and the device's gate is a cheap structural
    one. So a document whose element has no `id`, or whose duct has no
    `parent`/`child`, reaches the router intact. Ten places then built a
    std::string straight from ArduinoJson's null const char*, which is undefined
    behaviour and on the ESP32 a panic.
    The bad part is the ordering. The document is PERSISTED to LittleFS and only
    then adopted, so the board does not just crash once — it comes up, re-reads the
    stored layout, and crashes again on every boot after that, with nothing to do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
    [TopologyController.h, TopologyRouter.h, TopologyRuntime.h, TopologySequencer.h, test_topology_router.cpp]
2026-09-09 Refuse a duct onto a capped or unknown branch
    routing.js has said `if (!branch || branch.role === 'blocked') return null`
    since it was written. TopologyRouter.h had neither check: a duct naming a branch
    that does not exist walked on with no hop recorded, and a duct on a capped
    branch was walked as though it were a tool branch.
    The capped case is the one with teeth. The selector stays at its closed state
    because nothing committed it, but the tool is reported reachable — so no make
    fails, nothing holds the blower back, and it starts into a sealed system. That
    is the one rule this project says it will not break, and the two engines
    disagreed about the same document.
    Narrower than it first l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
    [TopologyRouter.h, test_topology_router.cpp, topology.test.js]
2026-09-09 Bound positionMm on the wire, as the JS validator already does
    nodelink.js has bounded a linear SET to a real number in -10000..10000 since it
    was written. parseSetFrame() clamped the servo angle to 0..180 and then took
    positionMm entirely on trust — the one field on the wire with no check at all.
    The node multiplies it by counts/mm and casts to long, so a NaN is undefined
    behaviour in the conversion and a wild value becomes a command clamped to
    kMaxStepsPerCommand and re-issued chunk after chunk until the runaway guard
    stops the carriage. A node's whole safety story is that it moves only when told
    exactly where, and an unchecked number is not that.
    Writing the test turned up a worse cas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
    [NodeLink.h, test_nodebus.cpp]
2026-09-09 Report the node's slider position the way every other conversion does
    The status screen divided the raw step count by counts/mm and stopped there,
    but moveTo() multiplies by -HOME_DIRECTION on the way in. So with the node's
    default datum the screen showed the negation of the commanded position: a gate
    at 250mm read -250.
    Display only, but the screen is a node's entire user interface, and this is the
    number someone reads while deciding whether the homing sweep actually worked —
    which is the moment a minus sign is least welcome.
    Every other steps→mm conversion in the tree already divides by -HOME_DIRECTION
    (firmware.ino in two places, HttpApiServer, SerialDebugControl). This was the
    one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
2026-09-09 Give the demo the same manual-wattage floor as the firmware and the mock
    CLAUDE.md's twin-pair table names three implementations of the synthetic
    wattage a hand-switched tool reports: manualWattsFor() in TopologyRuntime.h,
    setToolManual() in mock-api.js, and setToolManual() here. Two of them read
    `trip > 0 ? trip * 3 : 15`. This one read `trip * 3`.
    The floor is the whole point of that expression. toolThreshold() returns an
    explicit thresholdW of 0 as 0 — the default only applies when the field is
    absent — so a machine configured that way multiplied out to zero, and the demo
    showed a tool switched on by hand as drawing nothing. Nothing routed, and the
    canvas drew 0 W on a tool the user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
2026-09-09 Keep the Live view polling when the layout isn't there yet
    ngOnInit wrapped the topology fetch in a try whose catch set an empty tool list
    and returned — before the line that starts the poll. So a single failed fetch
    was permanent: a device still booting, a transient 404, a dropped request, and
    the screen sat empty forever with nothing retrying. The only way back was a
    manual page reload, on the one screen someone is most likely to be standing in
    front of with their hands full.
    The poll now starts whatever happened, and each tick re-reads the layout while
    there still isn't one, so a device that comes up late is picked up on its own.
    build.component.ts has always polled unconditionally; th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
2026-09-09 Bind the status socket's handlers to the socket they belong to
    connectWebSocket() assigned this.ws and then wrote handlers that read the FIELD
    rather than the socket they were installed on. The field moves on every
    reconnect and these handlers outlive their socket, so both of the interesting
    ones acted on the wrong object.
    onerror did `this.ws?.close()`. A late error from a socket we had already
    replaced therefore closed the live connection — which reconnected, and could
    error again. A reconnect loop assembled entirely out of the recovery path.
    onclose scheduled a reconnect unconditionally, so a superseded socket closing
    started a second chain running alongside the first, each with its o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
2026-09-09 Show the gate-overlap message the guard already writes
    checkStopConflict() composes the most useful error in the calibration flow —
    "This looks too close to Gate 3's saved position (125.4 mm) — jog further away
    before saving" — and throws it as a plain Error before any HTTP happens.
    The one caller read `e.error.error`, the shape an HttpErrorResponse has. A
    plain Error has no `.error`, so it fell straight through to the generic
    fallback: "it may be too close to another outlet". The gate number and the
    distance, which are the entire reason the guard bothered to look them up, never
    reached the person holding the carriage.
    Now reads both shapes, device message first.
    Fixed the other hal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
2026-09-09 A board with no id of its own owns no named bin
    localBinSystemId() answers "is this collector's bin sensor wired to THIS
    board", and its comment says the rule is NodeBus's: absent, or equal to our own
    id, means local. The code had a third clause — `own.empty()` — that the comment
    never mentioned and that does not appear in NodeBus.
    It meant a board which does not yet know its own controllerId claimed the FIRST
    bin sensor in the document, whoever it was actually wired to. Not knowing who
    you are is a reason to claim nothing, not a reason to claim everything.
    Low consequence today, since the bin is reporting rather than controlling, but
    it reports as a warning on a system whose bin nobod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
2026-09-09 Delete the v1 aliases nothing calls
    TopologyRuntime kept five "v1 spellings, kept for call sites that predate
    ports". Three of them had no call sites anywhere in the tree: hasTool(),
    toolIsManual(), and activeTools() — the last of those twice, once here and once
    on TopologyController. A comment promising compatibility with nothing.
    setToolPower, setToolManual and toolForOutlet are still called and stay; the
    comment above them now says which three it means, so the next person does not
    have to grep to find out.
    Two others went with them:
    ST3215LinearDriver::lastStopMethod() — the accessor. _lastStopMethod itself is
    live and printDriverRegs() reads it directly, which is why the acces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
2026-09-09 Don't claim nothing was switched when some of it was
    Switching a system off walks its running tools one at a time and then clears the
    hand-run. If the controller stops answering on the third of five, the first two
    are already off — but the catch said "Couldn't reach the controller — nothing
    was switched."
    That is wrong in the worse direction. Someone reading it believes the shop is as
    they left it and walks away; what is actually true is that some of the tools
    stopped and some did not. On the screen whose entire job is to say what is
    running, an error message that misreports the state is worse than no message.
    It now counts what landed and says which case it is.
    Type-checks clean.
    Re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
2026-09-09 Drop two initialisers that were quietly wrong
    Both are the same shape — code that looks deliberate and is not load-bearing in
    the way it appears — so they go together.
    routeAllShared() ended with a fallback routePass() after `if (best) return
    best`. It could never run: the loop returns early on a clean pass and assigns
    `best` on every pass that is not, so `best` is always set by then. Worth
    deleting rather than leaving, because of what it would have done if it ever HAD
    run — it reported `shared: []` unconditionally, so it would have told the
    caller a board with overlapping runs was clean, and the branch-dot menu that
    greys a splice it cannot draw reads exactly that field.
    CollectorSt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
    [TopologyRuntime.h]
2026-09-10 TasmotaOutlet, and the factory the second driver needs
    A no-relay Tasmota plug read as a power SENSOR — the Athom pass-through
    that replaces a Shelly on a big tool, and, by design, the endpoint our
    own CT board will serve so there is one driver rather than two
    (docs/tool-sensing-rfc.md §6).
    GET /cm?cmnd=Status%208 -> StatusSNS.ENERGY.Power. Structurally simpler
    than ShellyGen2Outlet: setSwitch(), configureOutboundWs(), setName(),
    releasePush() and readPushConfig() all stay at SmartOutlet's defaults,
    and that is honest rather than lazy — this driver genuinely cannot
    switch and genuinely cannot claim a device.
    A reachable plug with no ENERGY block is UNREACHABLE
    Tasmota answers Status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
    [HttpApiServer.cpp, HttpApiServer.h, SmartOutletControl.cpp, SmartOutletControl.h]
2026-09-10 Claim a Tasmota plug with Mem1, and say what that does not buy
    Answers §11's first open question, which gated discovery.
    Tasmota has no Ws.SetConfig, but it does have Mem1..Mem16: free-text
    variables that persist across reboot and are read and written over the
    same /cm?cmnd= endpoint we already poll. We write our hostname there and
    read it back — the same shape of thing a Shelly's push target is, which
    is to say device state we set and can verify, rather than a name a user
    might edit.
    The claim model gains the "second, weaker mode" §11 anticipated:
    claimOfMarker() / plugclaim::decideMarker(), same four states, paired
    across both engines with the same cases in the same order.
    WHAT IT D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
    [test_plugclaim.cpp]
2026-09-10 Discover Tasmota plugs, and be honest that it usually won't
    The ownership half was solved by Mem1. This is the mDNS half, and it is
    worse than the RFC assumed.
    There is no _tasmota._tcp to ask for. Tasmota advertises the generic
    _http._tcp — printers, NASes, the router — with a devicetype=tasmota TXT
    key. That key is what makes a hit unambiguous, which is exactly the job
    _shelly._tcp does for Shelly; without it we would be back to guessing
    from hostnames, which broke the moment anyone renamed a device.
    ⚠️ EXPECT IT TO FIND NOTHING, AND THAT IS NOT A BUG
    Tasmota's mDNS needs USE_DISCOVERY compiled in and is NOT in the
    precompiled builds — upstream left it out because "mDNS genera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
    [MdnsQuery.h, firmware.ino]
2026-09-10 Sweep the subnet for plugs that advertise nothing, and verify the driver
    Jeff confirmed the Athom is invisible to mDNS — nothing on _shelly._tcp,
    nothing on _http._tcp, nothing anywhere. That makes the sweep the only
    thing that can find one, so here it is.
    `sweep [from] [to]` on the serial console. Knocks on every address in
    the local /24 with TasmotaOutlet::probe(), skips its own, pets the
    watchdog, aborts on a keypress, prints a dot every 32 addresses. Each
    hit reports its watts and its Mem1 claim.
    SERIAL ONLY, DELIBERATELY. A full pass is about a minute — far past any
    browser's patience — so putting it behind the HTTP discover endpoint
    would mean an async job, a progress endpoint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
    [SerialDebugControl.cpp, SerialDebugControl.h]
2026-09-10 Pair a Tasmota: claim it, then make its Toggle button inert
    Confirmed on the real plug 2026-09-09: the Athom no-relay unit still
    ships firmware for its relay sibling. The web UI has a Toggle button and
    reports a Power state, and pressing it does nothing at all.
    Harmless on this hardware and confusing — the page will cheerfully say
    OFF while the tool it senses runs perfectly. On the relay SKU it is
    worse than confusing.
    So pairing now locks it: PowerOnState 1, then PowerLock 1. ORDER
    MATTERS. Locking first nails down whatever state the plug happens to be
    in, and a plug locked OFF is a tool that silently has no power — which
    is the exact failure the sequence exists to prevent. Both verif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
    [SmartOutletControl.cpp]
2026-09-10 Parse chunked replies, and bound connect — both found on hardware
    The Tasmota path now works end to end on a real plug. Two bugs stood in
    the way and neither was visible without a board.
    CHUNKED TRANSFER ENCODING
    Tasmota answers `Transfer-Encoding: chunked`. doPoll() parsed from
    http.getStream(), which hands back the raw socket WITH the chunk framing
    still in it — hex length lines and CRLFs — so ArduinoJson hit a chunk
    header where it expected `{` and every poll reported "unreachable".
    ShellyGen2Outlet streams the same way and is fine, because a Shelly
    sends Content-Length. The pattern I copied was right for the device it
    was written for and wrong for this one.
    WHY IT SURVIVED VALI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
    [SerialDebugControl.cpp, SerialDebugControl.h]
2026-09-10 Carry outlet kind through the UI, and pair a Tasmota end to end
    PAIRING IS VERIFIED ON HARDWARE. The plug at .43 took the claim and the
    lock, and the primary is polling it:
    [Outlets] Tasmota Mem1 dustgate on 192.168.87.43
    [Outlets] Tasmota 192.168.87.43 locked on — its Toggle button is inert
    [DEBOUNCE] candidate stop 1
    That was the last unproven step in the Tasmota path — provision() writes
    to the device, and nothing had exercised it.
    The UI now carries `kind`
    DiscoveredOutlet gains it, pick() reads it, ngOnInit loads it from the
    document, and save() writes it. Omitted when shelly, on purpose: absent
    already means shelly on both sides, so writing it would add a field to
    every e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
2026-09-10 Record WHY a tool is never switched: it can start unattended
    "Sensing is not switching" was already a design constraint, recorded as
    a convenience — a tool has its own switch, so we never needed to. That
    is the weak version of the reason, and a rule with a weak reason gets
    relitigated the first time someone wants remote tool control.
    The real reason, from Jeff 2026-09-09: A TOOL SWITCHED OFF AT THE OUTLET
    WITH ITS OWN SWITCH LEFT ON IS ARMED. Energise that outlet — remotely,
    on a schedule, by tapping the wrong row in an app — and a table saw
    spins up with nobody's hand on it, possibly mid blade-change. That is
    the exact hazard no-volt-release switches and magnetic starters exist to
    pr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
2026-09-10 Record the Shelly-for-collectors direction, and the load risk under it
    Jeff, leaning: stop allowing Shelly on tools entirely, keep it for
    collectors where switching is the job. §3's safety argument is about a
    table saw starting unattended and does not apply to a blower the same
    way, so a medium collector with a relay sized for its inrush is a
    legitimate use.
    The schema already encodes half of it — a tasmota under a collector's
    control.outlet is a validation error. The mirror rule is shelly under a
    tool's sensor.outlet, and it can become a hard error the same way, but
    NOT YET: every layout written so far has Shellys on tools and there is
    no migration path. Deprecate first, enforce after,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
2026-09-10 Stop deleting a file PlatformIO needs, and park two findings
    firmware.ino.cpp is GENERATED — PlatformIO writes it from firmware.ino on
    every build ("Converting firmware.ino"), into the source tree rather than the
    build dir, so it shows up as untracked and reads like a stray. It is not.
    Deleting it mid-build fails the compile at src/firmware.ino.cpp.o, which is
    exactly what happened today. Ignoring it stops the next person reaching for
    the same rm.
    The two parked items came out of measuring the board rather than reading
    about it:
    esptool: Detected flash size: 8MB, on an ESP32-C5 rev v1.0. Both partition
    tables we ship stop at 0x400000 — half the flash on every board is
    unaddressed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
2026-09-10 Record what mDNS actually does here, tested rather than reasoned
    Three things were being argued about from documentation. All three are now
    answered against the Athom plug and the shop's own network.
    MULTICAST IS NOT BLOCKED on GenericGuest. `dns-sd -B _http._tcp local.` shows
    `dustgate` immediately. This morning's conclusion that it was blocked came
    from `dustgate.local` failing to resolve — which was a POWERED-OFF BOARD, not
    a blocked network, and a whole line of reasoning got built on it before the
    board was checked. Kept as a warning, because the failure mode is a test that
    looks conclusive and measures nothing.
    TASMOTA'S mDNS IS GENUINELY ABSENT, not merely switched off. `SetOption5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
2026-09-10 Find a Tasmota without being told its address
    A no-relay Tasmota is the plug this project now prefers for a tool — it
    structurally cannot switch, which is a safety property rather than a
    preference — and until now the only way to pair one was to already know its
    IP and POST a topology by hand. mDNS finds a Shelly in three seconds and will
    never find a Tasmota (USE_DISCOVERY is absent; see the previous commit), so
    "look it up yourself" was the whole story. Two routes in, neither of which
    needs multicast:
    TYPE THE ADDRESS. /api/outlets/ping already existed and was half-built for
    this: it probed Shelly only and reported no ownership at all, so a Tasmota
    typed into it would have answered "u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
2026-09-10 Prove the collector RF path, and drop the encoder
    Two bench consoles and the findings from using them. Nothing here is
    part of the shipping firmware yet — these are tools, and the numbers
    they produced are the point.
    Everything below is MEASURED on hardware. It is the first end-to-end
    verified path in the project outside the servo work.
    ht12e_bench — keying the Rockler dust collector remote
    Standalone, like the servo bench: no WiFi, no topology, nothing
    transmits until you type a command. What it settled:
    address 0x5E (rockers 1/6/8) — the only per-device value
    data 14 — AD8 low, the other three don't-care. Every EVEN value
    keys it and nothing odd, so one b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
2026-09-10 CT bench: a diagnostic suite, and the check that caught a railed input
    NO CURRENT HAS BEEN MEASURED YET. Every number from this session — a
    0.053 A floor, a 0.020 A floor, the screen's "0.4 A", the ~2s
    excursions — came from an ADC pin sitting at ground, and is void. What
    came out of the session is the tooling that found that out.
    The check that mattered
    Print the DC operating point on every line. A railed input returns the
    same count every sample, so the variance is exactly zero and the meter
    reports a beautiful 0.000 A floor while measuring nothing at all. That
    is indistinguishable from a perfect sensor unless something says what
    the DC level is. It now flags anything outside 300-300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
2026-09-10 CT bench: the rig finally works, and the noise moved
    The wiring fault is fixed — DC sits at 1650mV, mid-rail — so for the first
    time these numbers mean something. Everything measured before 2026-09-07
    came from an ADC pin at ground and is void.
    The sensor works
    A 15 W motor reads 0.208 A of signal, about 25 VA. That is what a small
    motor with a poor power factor should look like, and it measured the same
    before and after the divider change. The CT is fine.
    The noise is no longer the ADC
    Dropping the divider 10k/10k -> 1k/1k took the board's own contribution
    from 0.228 A to 0.158 A (phase C: CT unplugged, input shorted, so
    whatever it reads is the board talking to itself). But the FLO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
    [ct_bench.cpp]
2026-09-10 An intact cord gives nothing, and the CT's real job is one bit
    Two answers from the bench, one closing a question and one shrinking it.
    §5.4 IS CLOSED, AND THE ANSWER IS NO. Clamping a whole cord shows nothing
    above noise. What makes that an answer rather than another noise-floor
    complaint is that a bench MULTIMETER could not see it either: our own board's
    floor is under suspicion (§5.5), so a null result from our rig alone would
    have proved nothing. An instrument we trust failing the same way moves the
    cause from our electronics to the physics.
    iVAC ships a product that claims to do this, so either the residual field of
    a balanced pair is smaller than that implies, or they are doing som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
2026-09-10 Athom already sells the sensor we were going to build
    §6 argued for one seam by having our own CT board impersonate a Tasmota.
    Athom's 2CH Energy Meter is that board, for $29.40 pre-flashed: ESP32-C3,
    100-250V, two split-core CT channels at 0.1-97A. TasmotaOutlet drives it with
    no new driver, no new protocol and no new node type — it turns up in the
    sweep, claims through Mem1, and pairs in the UI that already exists.
    Three things make it better than ours rather than merely cheaper.
    It measures VOLTAGE AND POWER FACTOR, so it reports real watts. Our CT
    measures current and cannot convert without them. That lets a CT-sensed tool
    share DEFAULT_THRESHOLD_W with a plug-sensed one, which reti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
2026-09-10 The array bites on the first EM2, not the first ganged pair
    The note said this was not urgent until a meter was bought and then filed it
    behind ganging two tools. Wrong emphasis: an EM2 has two channels in HARDWARE
    whether or not both carry a clamp, so it reports Power as an array either way.
    There is no single-tool configuration that avoids it — a lone tool on an EM2
    reads 0 W just as thoroughly as two would.
    And one tool per meter is the normal case, not the edge one: the CT leads are
    100 cm, so both channels have to reach from the same box, which two tools
    rarely do. That makes ~$29/tool the real price and the array the default
    reply, not a ganging concern.
2026-09-10 A servo presses the fob, because woodworkers do not solder
    Every electronic way to operate the collector's remote ends at the same step:
    open the fob and solder across its button. That is true of the HT12E injection
    path this branch's bench proved out, and equally true of the tidy $11.83
    alternative — Athom sells a dry-contact Tasmota relay for exactly this job. A
    servo arm on a printed fixture ends at "clip the fob into the holder, plug the
    servo into the labelled port".
    THE RULE UNDER IT is worth more than the decision, and two subsystems hit it
    independently before anyone wrote it down: an install step the owner cannot
    perform is not a cheaper option, it is a different product. Panel-s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
    [PowerSensor.h]
2026-09-10 Mechanical actuation, written up as a technique rather than a fix
    §4.2a decided how the collector's fob gets pressed. This is the general form,
    separated out so the next "how do we command a device we did not build"
    question starts here instead of at a soldering iron.
    The claim: when you need to operate equipment you do not own the electronics
    of, moving its existing control is often better than interfacing with its
    circuitry. Nothing is modified, so the device stays certified, warranted,
    insurable and unclippable. No reverse engineering — the HT12E path needed the
    encoder identified, the address read, the data word found by sweep, the hold
    measured and the oscillator characterised, and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
2026-09-10 A collector can be watched by a plug that doesn't switch it
    PowerSensor, and the first thing that needed it.
    THE SEAM. sensing/PowerSensor.h is the interface between the routing brain and
    however a machine's power happens to be observed. The obvious version carries
    watts and lets TopologyRuntime compare them to a threshold; that is the trap
    DEFAULT_THRESHOLD_W already fell into. A metering plug knows watts. A CT knows
    CURRENT and cannot convert without voltage and power factor, so an interface
    with watts() on it forces a current sensor to lie or return a sentinel — and a
    sentinel meaning "I can't say" is one refactor from being read as zero.
    So each sensor answers the one question every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
    [SmartOutletControl.cpp, SmartOutletControl.h, TopologyRuntime.h, firmware.ino, topology.js, topology.test.js]
2026-09-10 The device decides whether the blower actually started
    topology-device.js carried a note saying collectorPlugState was deliberately
    NOT mirrored in C++ — the firmware reports the plug's facts, the judgement
    lives once in JS — and it named the condition that would change that: "if the
    OLED ever needs to say not starting too, THAT is the moment this becomes a
    matched pair".
    This is that moment, and the real trigger is bigger than the OLED. EVERY WAY
    DUSTGATE NOW COMMANDS A COLLECTOR IS STATELESS. A servo pressing a fob button
    and an HT12E frame both send an edge and learn nothing (§4.2a/§4.2b), so what
    the device SENT proves nothing about what the blower did — only the draw does.
    A br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
2026-09-10 Press the button until the blower agrees, then stop and say so
    The retry half of the closed loop. control/CollectorPress.h is a seam for
    whatever physically sends the edge, plus the pure policy deciding when to send
    one. The policy is the dangerous half and the only half worth testing, so it
    has no hardware in it at all.
    A PRESS IS NOT A SWITCH, and that asymmetry is the whole file. setSwitch(true)
    means "be on" and asking twice is harmless. A servo pressing the Rockler fob,
    or an HT12E frame, sends an EDGE against a TOGGLE — it says "change", never
    "be on" — so nothing can be inferred from what was sent. Only the draw says.
    CollectorPresser therefore has ONE method, deliberately: a pre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
2026-09-10 Transmit the collector's own frame, and retry until it agrees
    The first CollectorPresser, and the reason it is the RF one rather than the
    servo one: RF needs no printed fixture and no mechanical alignment, so it can
    be tested tonight (Jeff, 2026-09-10). The servo path stays the SHIPPING answer
    (§4.2a — woodworkers do not solder, and a fob a servo presses stays certified);
    this is what makes the loop real on a bench first.
    RfCollectorPresser keys a 315 MHz transmitter with the same 12-bit HT12E frame
    the fob sends, so the receiver cannot tell the difference. Every number in it
    was MEASURED on this branch against the real Rockler receiver, and the header
    records which and why, because seve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
    [RfCollectorPresser.h, SerialDebugControl.cpp, SerialDebugControl.h, TopologyRuntime.h, firmware.ino, topology.js, topology.test.js]
2026-09-10 Give the collector its own board, and a way to match its remote
    TWO DECISIONS AND A MOCKUP, all from the same pin budget.
    THE COLLECTOR GETS ITS OWN HARDWARE (Jeff). Bin level, a CT clamp, the RF
    transmitter and lamps live on one board at the collector, rather than hanging
    each capability off whichever gate-driving node is nearest.
    What forced it: on a four-gate primary with a screen there is exactly ONE
    ordinary pad left. D3 is a strapping pin, D0 is the only analog pad on the edge
    and a CT wants it, which leaves D6 — and the bin sensor already had it. So
    bin-level and RF-transmit could not coexist, while obviously wanting to sit
    three feet apart, because the bin and the receiver are th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
2026-09-10 Try the four ways a DIP gets copied wrong, and keep the one that works
    Jeff's idea, and it uses the loop we just built: if the entered address does
    not work, flip it, reverse it, try both, and keep whichever the collector
    answers. We have closed-loop feedback, so a candidate can be TESTED rather than
    reasoned about.
    THE FOUR ARE NOT ARBITRARY. Reading an eight-way DIP upside down does two
    things at once — reverses the rocker order AND swaps which side is ON — so the
    plausible mistakes are exactly: as entered, inverted, reversed, both. There is
    no fifth. A user who miscounts one rocker produces an address none of these
    reach, and that is correctly a failure: guessing further would be sea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
    [RfAddressGuess.h, SerialDebugControl.cpp, SerialDebugControl.h, firmware.ino, test_rf_address.cpp, xiao_c5.h]
2026-09-10 Wire up the collector node, and correct a pad I got wrong today
    firmware/wiring/collector-node.md — the whole board as a build, not a
    schematic: a table of connections per subsystem, each with a mermaid diagram
    beside it. The table is the thing to build from; the diagram is the thing to
    check it against. That order is deliberate — an ASCII schematic in the first
    version of ct-bench.md put D0 at ground and voided a whole bench session, and
    the fix was to write connections as rows.
    ⚠️ PIN_RF_TX MOVED FROM D6 TO D9, hours after being written. It sat on D6 with
    a note claiming the clash with PIN_BIN_SENSOR was fine "because they never
    share a board". That was wrong the moment the collec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
    [firmware.ino, xiao_c5.h]
2026-09-11 Do NOT tie the two grounds — the opto was being shorted out
    Jeff asked whether both sides of the optocoupler ground to the ESP32. They do
    not, and asking exposed an instruction that had been wrong in the board header
    for weeks and which I copied into the new wiring doc yesterday without
    checking it.
    "TIE THE 12 V GROUND TO THE ESP32 GROUND" shorts across the barrier. It throws
    away the only thing an optocoupler does, while keeping every part and every
    step of installing one.
    The justification I wrote alongside it was wrong in its own right — "it does
    not give the two supplies a shared reference, and without one the input
    floats". Nothing floats. The opto module's GND pin IS the ESP32 g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
    [xiao_c5.h]
2026-09-11 A buck ties the grounds anyway, so say which build you are making
    Jeff: "how does the 12 V ground tie to a 12->5 V regulator then?" It ties
    straight through — a plain buck shares its input and output ground by
    definition — so on a single-supply build the two grounds are common UPSTREAM
    and yesterday's barrier is bypassed before the optocoupler ever sees it.
    §2 had assumed a two-brick build without ever saying it was a choice, which
    made an unconditional warning out of something conditional. Three topologies
    now, stated and picked between:
    A two bricks (12 V sensor, USB board) grounds separate opto isolates
    B one 12 V + plain buck grounds COMMON opto level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
2026-09-11 Size the isolated supply, and stop double-counting the servos
    Recommends a part for topology C and records the budget that picks it, plus
    two corrections to what I said an hour ago.
    ONLY ONE FOB SERVO EVER MOVES. Pressing ON and OFF at the same moment is
    meaningless, so a two-button fob budgets for ONE servo, not two. I doubled it
    for no reason and made isolation look twice as expensive as it is.
    AND A BUTTON PRESS IS NOT A STALL (Jeff: 9 g servos, not the metal-gear kind
    the gates need). A gate valve loads a servo continuously; a fob button is a
    short travel against a light spring, and ServoActuator already does
    move-then-detach so nothing holds torque afterwards. An SG90-class servo draw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
2026-09-11 Build B, and write down what would send us to C
    Topology B is the decision (Jeff): one 12 V supply, a plain buck to 5 V,
    grounds common through the regulator. He has the parts, and nothing has yet
    shown the CT needs better. It is also the better install regardless — one
    brick, one cord, at a machine that already has a cord and a remote and a duct.
    B IS THE LEAST FAVOURABLE ARRANGEMENT IN THE DOCUMENT and is being built first
    on purpose. A CT clamp feet from an induction motor, sharing a ground with the
    12 V supply that motor's own sensor runs on, on a board whose ADC noise floor
    was unresolved before any of this — the screen's charge pump alone put ~0.4 A
    of apparent current on a DEAD w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
2026-09-11 Build A first — one fewer variable under an already-shaky CT
    Reversed from yesterday's "build B, upgrade if it fails" (Jeff: reduce the
    number of variables we are testing up front). The old framing sounded thrifty
    and was bad diagnosis.
    A NOISY CT ON B TELLS YOU NOTHING. §3 already carries three unvalidated changes
    — 1 kΩ instead of 10 kΩ, an added 100 nF, and the whole clamp-one-conductor
    arrangement — on a board whose ADC noise floor was unresolved before any of it,
    where the screen's charge pump alone put ~0.4 A of APPARENT current on a dead
    wire. Put a shared ground underneath that and a failure has four candidate
    causes and no reference to compare against.
    A costs a second po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
2026-09-11 Say why there is no rectifier, before someone adds one
    Jeff asked whether the CT output needs rectifying to DC. It does not, and the
    reason was nowhere in the wiring doc — while the circuit as drawn looks exactly
    like half of a rectifier-and-smoother, which makes it the most misreadable part
    of the page.
    A CT puts out AC, 1 V RMS at 30 A on this one, swinging about zero, and an ADC
    cannot read a negative voltage. Two ways out, and the diode one is wrong here:
    a silicon drop is 0.7 V (0.3 V Schottky) against a signal whose FULL SCALE is
    1 V RMS, and below its forward voltage it conducts nothing at all. That deletes
    the small end — which is the entire question, since the job is telling an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
2026-09-11 Actuate the collector's own switch, not its remote
    Jeff's, and it is better than the fob path for the case that matters. A servo
    on the collector's own paddle or toggle is §4.2b's MAINTAINED row: it sets a
    POSITION rather than an edge, so it is idempotent, a missed command
    self-corrects, and the switch's physical position becomes a truthful display of
    what the system believes.
    It is allowed because §3's hard line is a TOOL's own power switch. The
    collector is the one thing DustGate may command, which is exactly why that line
    is drawn where it is.
    It deletes three dependencies the fob path carries: the fob battery (§4.2a
    records that a flat one presents as a dead servo), all of RF — ad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
2026-09-11 The collector node's firmware does not exist yet — say so
    The wiring doc opened by calling this 'an ordinary NODE build, same firmware as
    any other'. That is the intended design and is not true today, which a wiring
    doc must not imply when someone is about to build from it.
    Checked: dustgate_node.cpp has no HAS_BIN block and no presser. Both the bin
    sensor and the RF transmitter live in firmware.ino — PRIMARY ONLY. The fob-servo
    presser has never been written at all, and the CT exists only in the bench
    console.
    So a collector board built today is flashed as a PRIMARY to exercise any of it:
    fine for a bench, wrong for a shop that already has a routing brain elsewhere.
    Moving these onto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
2026-09-11 `stroke` — press a switch repeatably, and find out if a 9g servo can
    §4.2c asks whether a 9 g servo can throw a dust collector's own paddle or
    starter button, and nothing has measured it. `servo <n> <deg>` already moved a
    servo; what was missing is a repeatable PRESS, which is the actual test.
    stroke <1-4> <from> <to> [reps] [dwellMs]
    stroke 1 20 90 5 # five presses, 20 to 90 degrees, channel 1
    A servo has no torque feedback, so there is no number to read — the measurement
    is watching it try, repeatably, with the arm and angles actually intended. Jeff
    has several switch types in the shop and the answer is probably not the same for
    all of them.
    IT ALWAYS DETACHES AT THE END, i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
    [SerialDebugControl.cpp, SerialDebugControl.h, firmware.ino]
2026-09-11 dev.sh --collector, which flashes a primary and says why
    bash dev.sh flash --collector collector
    NOT a new env, and the banner is most of the change. There is no collector
    build to flash to: the bin sensor and the RF presser both live in
    firmware.ino, dustgate_node.cpp has neither, no fob-servo presser exists
    anywhere, and the CT is bench-console only. So a collector board today IS the
    primary build, and the flag exists to name that intent and print what it
    actually means rather than let someone discover it.
    TWO WARNINGS IT PRINTS, both of which cost a bench session if missed.
    What works where — the four capabilities and which build has them, because
    "flash it as a node, it is a node"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
2026-09-11 Collector is its own build, in both roles
    Jeff: "we definitely want a distinction between a primary for 4 servos/a
    slider, and a primary for a collector. likewise for nodes."
    xiao_c5_collector and xiao_c5_collector_node, selected by -DDUSTGATE_COLLECTOR,
    and `dev.sh flash --collector` / `flash-node --collector` pick them. A fourth
    carrier alongside servo and slider, for the same reason the slider is a third:
    it drives different hardware off the same pads.
    A collector board drives NO GATES, which is what frees the PWM block:
    D0 CT clamp D7 fob servo ON D9 315 MHz TX
    D6 bin sensor D8 fob servo OFF D10 spare
    SERVO_COUNT IS 2 THERE, and that is the whole difference. T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
2026-09-11 Explain the STA errors, and let the menu set WiFi
    TWO THINGS, both from watching a collector board boot.
    A) THE STA ERRORS ARE COSMETIC and now say so in the one place someone would
    look:
    [E][STA.cpp:540] disconnect(): STA disconnect failed! 0xffffffff: ESP_FAIL
    [E][STA.cpp:346] connect(): STA config failed
    They come from the Arduino core, not us, printed at ERROR level for something
    that is not one. _runPortal() is reached only after a station connect has
    already failed, so the STA was never associated — and mode(WIFI_AP) tears it
    down regardless. Disconnecting a station that never connected returns ESP_FAIL,
    and reconfiguring one mid-teardown fails for the same reason.
    The proof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
    [WiFiProvisioner.h]
2026-09-12 30s to join, and say WHY when it does not
    A brand-new C5 could not join a guest network inside 12s with correct
    credentials, then joined on a re-provision — so it was slow, not refused. 12s
    was never a deadline anything needed; it was a number.
    The C5 is DUAL BAND and scans 2.4 and 5 GHz before choosing a BSS, where the
    single-band parts that number was first picked against scanned one. Add a busy
    guest AP and a WPA2 handshake and 12s is simply tight.
    The costs are lopsided, which is the actual argument for 30. Too long, and a
    board with genuinely bad credentials takes half a minute to offer its portal.
    Too short, and a board with GOOD credentials gives up and demands the user set
    up WiF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
    [WiFiProvisioner.h]
2026-09-12 TODO: /settings still asks for a gate count
    Jeff: the count is a property of each slider now, set where the slider is, so a
    shop-wide number in Settings is redundant at best and a second answer to the
    same question at worst.
    Noted three things to check first, because it is not only a template edit. The
    input's max="16" is ALREADY WRONG — NUM_STOPS dropped to 8 on 2026-09-05 and
    this never followed, so it currently offers numbers the firmware rejects, which
    is its own argument for removing it. Whether setNumGates() and the set_num_gates
    route retire with the field or are still load-bearing for calibration
    (g_numActiveStops) needs checking before deleting either. And the field's own
    hint ad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
2026-09-12 It was the antenna, not the band scan
    Correcting a cause I asserted without testing it. The comment justifying the
    12s -> 30s change claimed the C5's dual-band scan was why a new board could not
    join in time. That is true of the C5 and was NOT what happened: the board's
    WiFi antenna was not plugged in. It associated at all only because it sat near
    the router, and slowly because it was running on almost no signal.
    The timeout change STANDS — a board with a marginal link is exactly the case a
    short timeout handles worst, whatever made the link marginal, and the lopsided
    costs argument is unaffected. What changes is that the dual-band theory is now
    labelled untested instead of being cited as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
    [WiFiProvisioner.h]
2026-09-12 Put the collector bench commands where they'll be found
    press, rfscan and stroke are new enough that nobody has them in muscle memory,
    and they lived only in the serial console's own help — which you have to
    already be connected to read. They are now in dev.sh's header comment (the
    reference, per CLAUDE.md) with the caveats attached, and abbreviated in the
    interactive menu next to the Monitor entry, which is where someone about to
    connect is looking.
    The caveats travel with them because each has bitten already: press wants a
    LAMP in the receiver's outlet rather than the blower, since a motor cannot spin
    up and coast down fast enough to read; rfscan needs the collector's SENSOR plug
    paired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
2026-09-12 Fix stroke, twice, and log the bin sensor's edges
    STROKE DID NOTHING, and there were two independent bugs in six lines.
    First, it was in the wrong branch of the if-chain — inside
    `#if CONTROL_SMART_OUTLET || ENABLE_HTTP_API`, next to press and rfscan. It is
    a SERVO command and has nothing to do with outlets; it now sits beside `servo`,
    outside that guard.
    Second, and the one that actually produced "no movement with a convincing log":
    ServoActuator is NON-BLOCKING AND EASED. moveTo() sets a target and update() —
    normally called every loop() pass — walks the shaft there. A wait made of bare
    delay() therefore logs a perfect press and moves nothing. `servo <n> <deg>`
    worked throughout, w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
    [SerialDebugControl.cpp, firmware.ino]
2026-09-12 `ct` — read the clamp on the console, screen or no screen
    The CT existed only in bench/ct_bench.cpp, so a collector build could not
    report a current at all. sensing/CtSensor.h lifts the sampler out of that
    console with the reasoning intact, and `ct [n]` prints it.
    SERIAL ONLY, AND THAT IS THE POINT. The screen is a NOISE SOURCE for this exact
    measurement — SSD1306_SWITCHCAPVCC runs a charge pump on the rail the ADC's
    bias divider shares, and it put ~0.4 A of APPARENT current on a dead wire
    (wiring/ct-bench.md §5.5). A reading you can only see by lighting the thing
    that corrupts it is not much of a reading. This one does not care whether a
    panel is fitted.
    IT REFUSES TO LET 0.000 A PAS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
    [CtSensor.h, SerialDebugControl.cpp, SerialDebugControl.h, firmware.ino, xiao_c5.h]
2026-09-12 Stop loop() running off the end of its stack
    Guru Meditation, stack protection fault, on a collector board at boot:
    Stack pointer: 0x4085d060 bounds: 0x4085d068 - 0x4085f060
    SP eight bytes BELOW the lower bound with the 0xabba1234 canary on it, and a
    half-built status JSON in the dump — which is the clue.
    THE MECHANISM, because it will recur: loop() is ONE ENORMOUS FUNCTION, so every
    StaticJsonDocument declared anywhere inside it reserves space in the SAME FRAME
    whether or not that branch ever executes. Four of them live there (2x512,
    2x256). I added two in the week before this — the sweep's row builder and the
    widened ping reply — on top of the deferred-reply handlers already p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
2026-09-12 A discrete 4N35 for the bin sensor, and lamps that stay on 12 V
    The PC817 breakout measured 4 V on its output — above the C5's absolute
    maximum on a GPIO. Those boards commonly pull the output up to the INPUT
    side's supply, which both overvolts the pin and shorts out the isolation
    the part exists to provide. A bare optocoupler has no hidden pull-up: the
    output cannot exceed whatever you pull it up to.
    Both resistors in the new build are load-bearing, and together they
    explain the earlier unusable 2 V reading. 1 kOhm gives ~10.8 mA, the
    4N35's rated test point, so the phototransistor actually saturates
    instead of sagging through its linear region; 10 kOhm from D6 to 3V3
    backs up INPUT_PULL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
    [firmware.ino, xiao_c5.h]
2026-09-13 A console that only offers what the build can actually run
    Every command was listed on every board: `calibrate` and nine stop
    positions on a collector with no rack, `press` and `rfscan` on a slider
    with no transmitter, `gconf` on all of them although the stepper was
    deleted in August and its handler is still pin-guarded. A help list that
    names commands a build cannot run is read as an inventory of the
    hardware, so it sends someone chasing a dead servo, or a silent
    transmitter, that was never fitted.
    Each line is now gated on the same capability macro its handler is gated
    on. Two new ones, HAS_CT and HAS_RF, derived from PIN_CT and PIN_RF_TX
    the way HAS_BIN already was — the pin is the fac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
2026-09-13 The CT's scale was never wrong — the arithmetic was
    Three instruments on a running 1 HP collector at the same moment: a
    handheld clamp meter at 10-11 A, a Tasmota metering plug at 10.610 A, and
    this CT at 10.71 A. Within ~1%. kAmpsPerVolt, the bias network and the
    rectifier-free RMS are all confirmed. The file had been TABLED since
    2026-09-07 with the front end under suspicion; the front end was fine.
    What was wrong was a scale factor, twice.
    First it came from ONE analogReadMilliVolts(), which multiplies every amp
    figure. Ten reads of a steady collector printed 13.100 A falling to
    8.889 A while the raw RMS held 371-375 — a 1% spread. It scaled WITH the
    signal, because a bigger AC swin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
    [CtSensor.h, firmware.ino]
2026-09-13 Every tool in the shop, measured — and one bad extrapolation
    Numbers for the whole shop, against the best floor this rig has produced
    (79.7 rmsCounts): collector 10.6 A = 4.6x, jointer 8.5 A = 3.7x, 2 HP
    220 V planer 7 A = 3.1x, SawStop 5.0 A = 2.3x. SawStop standby draws
    0.043 A and is INVISIBLE to the CT, which is the right answer rather than
    a limitation — the hazard is a false POSITIVE, and a standby 50x under
    the floor cannot produce one.
    Every tool is separable with the floor as it stands. The tightest is the
    saw, and that is a 110 V tool with a metering plug available, so the CT
    never has to carry it.
    The mistake is kept in the file because it is an easy one to make again.
    The 2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
    [RfCollectorPresser.h, SerialDebugControl.cpp, SerialDebugControl.h, firmware.ino]
2026-09-14 A collector is switched and watched by two different things
    The sheet the canvas opened for a collector could only ever say "this plug
    switches the cyclone". That is unanswerable for the collector on the bench,
    which is switched by its remote and watched by a metering plug — and the one
    gesture the canvas offered made it worse: dragging any plug onto the cyclone
    wrote control.outlet unconditionally, so dropping the shop's Tasmota there
    produced a document the model then REJECTS. A no-relay plug named as the
    switch describes a collector that can never start.
    The model has had the right shape since control and sensor were split apart,
    and the firmware has honoured it since: control.rf is ad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
2026-09-14 Knock first, then ask: the sweep's one timeout was two jobs
    The subnet sweep did a full HTTP GET with a 250 ms budget at every address, and
    that number is right for exactly one of the two things a sweep does.
    ~250 addresses have NOTHING at them. Each costs the whole timeout, and that
    product IS the runtime. The budget must be small.
    ~1 address has the plug. Answering takes a TCP handshake, a request and a
    chunked response — and Tasmota ships with `Sleep 50`, so an ESP8285 can add up
    to 50 ms of latency PER ROUND TRIP. Four to six of them lands at 200-300 ms,
    right at or past the budget. The budget must be generous.
    One number cannot be both, and the old code resolved it in f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
    [firmware.ino]
2026-09-14 Refuse a multi-channel meter instead of reading it as 0 W
    TasmotaOutlet::doPoll() filtered to StatusSNS.ENERGY.Power and called
    as<float>() on it. On a multi-channel device — the Athom EM2/EM6 — Tasmota
    reports Power as an ARRAY, and as<float>() on a JSON array yields 0.0. That is
    a working meter reported as a tool that is never on, forever, with nothing
    anywhere saying why.
    It is precisely the failure the guard directly above already exists to prevent,
    arriving through a different door. That guard catches a MISSING ENERGY block
    and says so in its comment — "`| 0.0f` would make a tool never on, forever" —
    and it does not fire here, because ENERGY is present and well-formed. Only the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
2026-09-14 _nodeLinkClients was never atomic, and volatile said otherwise
    The only two warnings in an otherwise clean build were pointing at a real bug:
    264: '++' expression of 'volatile'-qualified type is deprecated [-Wvolatile]
    269: '--' expression of 'volatile'-qualified type is deprecated [-Wvolatile]
    volatile was never a threading primitive. It stops the compiler caching the
    value and does nothing else, so `_nodeLinkClients++` stayed a non-atomic
    read-modify-write. The counter is written from AsyncWebServer's own task, in
    the WS_EVT_CONNECT and WS_EVT_DISCONNECT callbacks, and read from loop() — so
    two events landing together could lose one, leaving the board believing a
    primary is connect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
    [HttpApiServer.cpp, HttpApiServer.h]
2026-09-14 Settings no longer asks how many gates the shop has
    The count is a property of each SLIDER, set where that slider is calibrated —
    so a shop-wide "Number of gates" in Settings was a second answer to a question
    that already had one, and the two were free to disagree.
    Its max was 16. NUM_STOPS dropped to 8 on 2026-09-05 and this input never
    followed, so it cheerfully offered numbers the firmware rejects. That alone
    made it worth removing rather than leaving.
    THE DESTRUCTIVE PROMISE IT CARRIED IS NOT LOST. The hint said "Lowering this
    clears trained positions beyond the new count", and that guarantee matters —
    silently orphaned stops are worse than a redundant field. The calibration sweep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
2026-09-14 Say, on every screen, when it is not anyone's dust collector
    "Oh, am I controlling your shop?" — asked more than once by people shown the
    public deployment. The app is indistinguishable from the real thing by design,
    which is what makes it a good demo and exactly what makes the question
    necessary. Now it answers itself before anyone taps anything.
    Sticky at the top rather than a dismissible toast: someone landing mid-scroll
    on a shared link has to be able to see it, and a banner that can be dismissed
    is one that gets dismissed once and never seen by the next person handed the
    phone. It costs a line of height and is never in the way of a control, because
    every screen's own chrome starts be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
2026-09-14 TODO: four off the list, and one that was already done
    Three landed in this batch — the multi-channel Tasmota refusal, the volatile
    counter, and the gate count in Settings — plus the demo banner.
    The Tasmota item is narrowed rather than deleted: detecting the array and
    refusing loudly is done, and picking a CHANNEL is the actual feature, which
    still needs sensor.outlet.channel, a UI for it, and the model/firmware pair to
    carry it. The line worth keeping is that it bites on the first EM2 rather than
    the first ganged pair, because that is what makes it not a nice-to-have.
    "Expose the /boards page" is deleted as ALREADY DONE, and worth a note because
    the TODO was simply stale: live.compon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
2026-09-14 Take a kilobyte of JSON off loop()'s frame, and start measuring
    loop() is a single function, so every StaticJsonDocument declared anywhere
    inside it reserves space in the SAME frame whether or not that branch ever
    runs. That is what put a half-built status JSON on the stack when a collector
    board panicked at boot on 2026-09-12.
    Raising the task to 16 KB and extracting sweepProbeOne() were the belt. This is
    the fix: ping, rename and release move into their own functions, taking a <512>
    and two <256>s off the frame — documents that were resident on every pass to
    serve requests that arrive a handful of times in a shop's life. loop() now
    declares no StaticJsonDocument at all; the four that re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
    [firmware.ino]
2026-09-17 Say what the parts actually look like, and which divider to build
    Every wiring page named passives by value, which is no help facing a drawer of
    unlabelled components. passives.md now carries the EIA cap codes (101-107) and
    both 4- and 5-band resistor colours for every value this folder uses — ONE page,
    linked from the others, because a colour code restated five times is five places
    to get it wrong.
    Both CT rigs stop calling the bias node "that row". It is CT wire 1, in the
    table, the diagram and the prose, so there is nothing to hold in your head while
    counting holes.
    Three things that were wrong rather than merely unsaid:
    - The pages specify 10k/10k. §5.5 diagnosed that as the noise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
2026-09-17 A node can report what it senses, and a CT can start a collector
    NodeLink only ever spoke outward: HELLO, SET, PING and the replies to them.
    Every frame was the primary commanding a board, and a board that SENSED
    something had no way to say so. Bin sensing never exposed this because it runs
    on the primary. A clamp on a 240 V tool cannot — a NEMA 6-20 has no neutral and
    consumer metering plugs for it barely exist, so the sensor lives where the tool
    is and the brain does not.
    CONFIG (P->S) and SENSE (S->P), added WITHOUT bumping NODELINK_VERSION: both
    ends ignore a frame type they do not know, so all four old/new combinations
    degrade to something safe, and a bump would force a flash of ever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
2026-09-17 A clamp you can drag, on a board you can name
    UNTESTED ON HARDWARE. No board has ever sent a SENSE, kTripRatio (4x) and
    kMinTripCounts (8) are guesses flagged as such in the source, and the drag
    gesture is unproven either way — the browser harness does not produce the
    pointer events this canvas listens for, and dragging an existing PLUG chip
    fails identically. Tap-to-pair and both setup sheets are confirmed on screen.
    A clamp breaks the assumption every sensing device before it satisfied: that it
    sits AT the thing it watches and is FOUND by sweeping the network. It has no
    address and never will — somebody soldered it to a board — so the board is the
    only thing that can say it exists.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
    [HttpApiServer.cpp, NodeLink.h, RemoteActuatorBus.cpp, RemoteActuatorBus.h, TopologyRuntime.h, dustgate_node.cpp, firmware.ino, nodelink.js]
2026-09-17 The noise floor is the ADC, and a CNC router idles too loudly
    Two hours on a bench, and both results invert something written down.
    §5.5 IS CLOSED, and 1k/1k was never the problem it was accused of being. The
    floor on the rebuilt divider came in at 0.195 A against the old rig's 0.053 —
    four times WORSE — and it took four measurements to find out why that reading
    was misleading:
    primary, screen on 6.68 counts
    primary, screen off 6.03 <- the screen is now 11%, was ~80%
    bench build, NO WiFi 5.80 <- the radio is innocent
    CT SHORTED OUT no change <- so are the clamp, the cable, the braid
    The laptop had been on battery throughout, so mains earth was n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
    [ct_bench.cpp]
2026-09-17 Defer the CNC threshold — no tool in this shop idles loudly
    Not a change of mind about §5.4d, which stands as written. A priority call:
    nothing in it blocks a working shop, and a threshold is better built against a
    real machine than imagined.
2026-09-17 The sweep was fine — the canvas never asked
    jeff: the same sweep run from the CLI found the plug the GUI could not. That
    exonerates the entire firmware side, and curling the plug confirms it would have
    parsed: a clean 200, chunked as expected, with a scalar StatusSNS.ENERGY.Power.
    The canvas kicked a sweep only when something was unpaired:
    if (this.unpairedTargets().length) void this.scanOutlets();
    and showTray() hid the tray under the SAME condition — with the "Look for new"
    button inside it. So a shop with nothing unpaired had no way to run a sweep at
    all, and that is exactly the shop where someone has just bought another plug. A
    fully-wired layout is the reason to look for a ne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
2026-09-17 A claimed plug is shown, greyed, with what has it
    Hiding it was the other half of yesterday's sweep mystery. The plug WAS found;
    freeOutlets() filtered it; the tray said "all paired" — so the reasonable next
    move was to sweep again for something that was never lost. Showing it with the
    machine that has it answers the question instead of raising it.
    Greyed, inert, no grip, no pointer events. It is already somewhere, and moving
    it is a re-pairing that belongs on the machine it is on rather than on a chip in
    a tray.
    claimedIps() became claimedBy(): a Map of address -> what claimed it. A Set was
    enough to hide a plug and not enough to explain one.
    AND IT WAS MISSING A COLLECTOR'S SENSE-ONLY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
2026-09-17 One pin map for every PWM board
    There were three pin personalities on the C5 — gate, collector, slider — and
    the collector existed for one reason: a CT, a 315 MHz transmitter and two fob
    servos would not fit beside four servo channels. So it cost an env pair, a
    second carrier, and one genuine hazard: D9 was SERVO_PWM_PIN_3 *and* PIN_RF_TX
    on the same build, defined deliberately so the bench `press` command worked,
    with a comment warning that a board driving four gates would fight channel 3
    and that nothing checked for it.
    Drop to THREE servo channels and the transmitter moves to D10. Every pad then
    has exactly one owner on every build, PIN_CT is fitted everywhere, and the board
    at the c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
    [SerialDebugControl.cpp, config.h, ct_bench.cpp, topology.js, topology.test.js, xiao_c5.h]
2026-09-17 A node has a serial reader, so its hostname can actually be set
    `dev.sh flash-node <name>` prompted for a hostname, printed "Flashing as:
    <name>", and then sent `provision {"ssid":…,"host":"<name>"}` down the cable to
    a program with nothing listening. The node kept whatever NVS it had from
    whenever it was last a primary — SSID and password intact, hostname never
    written — so getHostname() fell through to DEFAULT_HOSTNAME and the board came
    up as `dustgate.local`, fighting the brain for its own name. Navigating to
    dustgate.local then 404s about half the time, from a board with no web UI.
    The reader existed; it was inline inside the captive-portal loop, which only
    runs when there are NO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
2026-09-17 A clamp paired in the app reaches the board it is wired to
    Three separate reasons it could not, and the first one is the whole story.
    A TOOL'S CLAMP LIVES ON ITS MACHINE. TopologyRuntime read element.sensor.ct,
    which is null for every tool the configurator writes — so CONFIG went out empty,
    the node never sampled, and the chain was silent with nothing anywhere reporting
    a fault. `sensor.outlet` has always resolved through machineDoc(); `sensor.ct`
    never did. The conformance suite passed throughout because its fixture uses
    twoGates, a v1 document where a tool element IS its own machine, which is a
    shape the UI cannot produce. There is now a v2 case asserting the CONFIG names
    the MACHINE an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
    [CtTrip.h, LocalActuatorBus.h, NodeLink.h, NodeRegistry.h, RemoteActuatorBus.cpp, RemoteActuatorBus.h, SenseReport.h, Shop.h]
2026-09-17 The app can say whether a clamp is talking, and stops calling clamped tools manual
    Boards screen shows each clamp's live state, which is the answer to "is this
    node talking back?" and was otherwise only visible on a serial cable. Four
    states, three of which look identical if you only render `on`:
    no clamp declared nothing at all
    declared, unassigned the layout has not put a tool on it yet — where a
    bench test lands after pairing and before drawing
    assigned, never heard CONFIG went out, no SENSE came back
    reporting proves the link, whether the tool is on or off
    The `x trip` figure makes a quiet clamp readable — 0.1x is a c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
2026-09-17 Three boards, one mDNS querier — serialise it, and stop losing a node to a quiet one
    A shop that paired perfectly at BOOT and lost its nodes afterwards, recovering
    only on a reboot. The asymmetry is the whole diagnosis and it is not a
    coincidence: syncPairedNodes() calls begin() for each node in a loop, and
    begin() resolves SYNCHRONOUSLY before it creates the task — so the boot-time
    resolves are serialised by construction. Every resolve after that happens on N
    parallel tasks on the same cadence, in lockstep.
    ESP-IDF has ONE mDNS querier. Two searches at once do not queue; the second
    comes back empty, and every caller here reads empty as "nothing answered".
    Three independent things query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
    [MdnsLock.h, MdnsQuery.h, NodeRegistry.h, RemoteActuatorBus.cpp, RemoteActuatorBus.h, firmware.ino]
2026-09-17 Seven wiring files into one
    There was a shop-wide reference plus a file per board personality and one per
    bench rig, and the split made sense while a gate board, a collector board and a
    slider board had three different pin maps. They have had ONE since yesterday, so
    the files had begun describing the same pads three times — and disagreeing:
    - the bin sensor was documented twice with DIFFERENT OPTO PARTS. xiao-c5.md
    still specified the PC817 breakout, which measured 4 V on its output — above
    a C5 GPIO's absolute maximum — while collector-node.md carried the discrete
    4N35 that actually works and is proven on hardware. Two documents, one of
    which tells you to destroy a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
2026-09-17 TODO: the UI is asking one question in two vocabularies, and other bench findings
    Bugs found while commissioning: the outlet sheet asks "How does DustGate know
    it's running?" over a Yes/No control — a question its own control cannot answer,
    because the label was reworded to cover clamps while the control stayed
    plug-only. Plus a doubled "Scanning…" in outlet-picker.
    And a UI audit for the same class of problem, since that one turned out to be a
    symptom. Five findings, worst first:
    - a TOOL's sensing is configured in TWO sheets and only one knows clamps exist
    - half of element-outlet-config is unreachable: build.component routes the
    'switch' mode to app-collector-setup, so isSwi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
2026-09-18 A jog resolves its board the same way a move does
    The gate configurator could not drive a servo on a node. It resolved its own
    board — a literal == against each bus's nodeId(), in the sketch, beside its own
    primary/remote branch — while every gate MOVE went through
    NodeBus::busForController(), which maps the topology's controllerId through the
    ALIAS table and normalises with bareHost() (".local", trailing dot, case).
    The two agree only while a controllerId is spelled exactly like its paired host.
    Rename a board and they diverge: gates keep moving and every jog lands on
    "[UI] Jog for unknown controller". From the shop floor that reads as "the
    configurator is broken on nodes", which sends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
    [ActuatorBus.h, LocalActuatorBus.h, RemoteActuatorBus.cpp, RemoteActuatorBus.h, firmware.ino, test_nodebus.cpp]
2026-09-18 Two more copies of a rule that already had one home
    Both are the shape that keeps costing us days: a second implementation of
    something with an owner, where the copy is subtly weaker and nothing compares
    them.
    **The node resolver stripped ".local" by hand.** RemoteActuatorBus::
    resolveAndDial() had its own suffix strip — a strcasecmp against the last six
    characters — while NodeBus::bareHost() has existed the whole time and does more:
    it drops the trailing dot on a fully-qualified "host.local." and lower-cases the
    result. So a board entered either of those two ways resolved here and then failed
    to match in NodeBus, which normalises properly. Dialled but never routed, which
    looks like a d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
    [RemoteActuatorBus.cpp, ct_bench.cpp]
2026-09-18 Finished work moves to DONE.md
    The Done section at the bottom of TODO.md had reached 144 lines — longer than
    most of the active sections above it, which is how a parked item stops being
    read. Jeff works from that file at the bench; one that is half finished work is
    one he skims.
    TODO.md's header now says finished items go across rather than to the bottom,
    and repeats the rule it already had: most of them can just be DELETED. What
    earns a place in DONE.md is an item whose reasoning was contested, or that a
    still-open item leans on. git log is the record for everything else.
    Carried today's GUI-servo-control bug across with it, since ae5d3e4 closed it.
2026-09-18 TODO: node OTA is nearly free, and here are the measured numbers
    Jeff's goal for the real shop: flash the nodes once and maintain only the
    primary. Measured rather than guessed, because the answer turns on partition
    arithmetic:
    - a NODE's image is 1.35 MB and huge_app.csv gives it ONE 3 MB slot plus
    896 KB of spiffs it never mounts. Two 1.6 MB slots fit the same 4 MB with
    room to spare — dual-slot OTA for the cost of a partition CSV.
    - the PRIMARY is 1.88 MB in a 2.62 MB slot beside a 1.44 MB ffat. Two app
    slots plus the filesystem is 6.7 MB, and the table currently fills 4 MB
    exactly on a chip that reports 8.
    otadata is already in both tables, which is the rollback h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
2026-09-18 The primary owns the CT trip numbers, and the decision grew a release point
    Three changes to one decision — "is the clamped motor running" — and they
    belong together because each one is the reason the next was worth making.
    THE NUMBERS MOVE TO THE PRIMARY. kTripRatio and kMinTripCounts were labelled
    PROVISIONAL, are known to need re-deriving, and lived on whichever board happened
    to hold the clamp. They now ride the CONFIG frame's SensorSpec, with the node's
    compiled-in values as the fallback when a frame is silent — so an older primary
    still works, and retuning a shop is a reflash of the BRAIN rather than a ladder
    at every node. That is the last thing on a node that was policy rather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
2026-09-18 The Boards page says what a clamp actually reads, in amps
    "Nobody but you and I care about counts" — so the wire carries amps and this
    renders them. The firmware keeps working in counts, because the trip is a ratio
    and because the amps scale has been wrong before, but that is a bench concern and
    the bench rule (log rmsCounts, not amps) is about the serial console.
    A clamp line now reads:
    Clamp on the Planer - drawing 4.99 A, 6.0x trip, 3s ago
    baseline 0.20 A - trips above 0.83 A
    The calibration sits on its own muted line because it only changes at boot, and
    putting it beside a number that moves four times a second makes the live reading
    harder to find rather than easier.
    A FIFTH ST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
2026-09-18 A bill of materials, and the measurements that decided what is on it
    BOM.md is new and starts where it became worth having: the power question is
    settled, so there is a stable thing to build on perfboard. Boards, modules,
    sensors and the passives whose VALUE matters, per board — wire and connectors are
    consumables and listing them buries the parts you actually have to choose.
    Two sections earn their keep beyond the shopping list. "Deliberately NOT on this
    list" records the HUSB238, the Traco isolated DC-DC, the CT burden resistor, the
    PC817 breakout, the 100 A clamp, the TMC2209 and the Shelly — each with the
    reason, so none of them get re-bought. And "Open" carries the inrush clamp, wh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
2026-09-18 Two servo channels, and D9 becomes a button pad
    The third PWM channel was the fob servo's OFF arm and was never built — "we
    haven't touched the third servo at all". Giving it up frees the only spare pad on
    the board for a SECOND BUTTON, which manual control at the machine needs and the
    wake button cannot provide: its short press works the screen and its one-second
    hold is already spoken for, and oled-status.html's log records that the second
    gesture was contentious when it landed.
    The cost is a fob presser with an arm per button. A two-button fob now wants one
    arm that travels between them, or the RF path on D10 — which was always the
    alternative, is already proven on the bench, and nee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
    [config.h, dustgate_node.cpp, topology.js, topology.test.js, xiao_c5.h]
2026-09-18 One band for every board, and say which radio each one joined
    "Same SSID" is not the same thing as "same network path". These boards are
    dual-band, and a primary that associates on 5 GHz with nodes on 2.4 shares an
    SSID and a subnet with them and still may not be able to open a TCP connection:
    plenty of consumer APs, and most guest networks, bridge between bands and between
    mesh radios inconsistently or not at all.
    The evidence, from `probe` on the primary to the same node address minutes apart:
    1. TCP :80 NO ROUTE / refused (3002ms)
    1. TCP :80 connected (10ms) ← then HTTP 404, which is CORRECT:
    a node serves only /nodelink
    Two boa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
    [WiFiProvisioner.h]
2026-09-18 A reconnect that backs off, because the storm was ours
    kReconnectMaxMs was declared, documented in nodelink.js as "reconnect backoff for
    a primary that can't reach a secondary", listed in CLAUDE.md's pair table — and
    read by nothing. setReconnectInterval() was called once with the MINIMUM and
    never again, so the library retried every second, forever.
    What that costs is not politeness. ESPAsyncWebServer on a node does not reap dead
    WebSocket clients on its own; a connection per second burns its client slots
    faster than cleanupClients() frees them, and a node with no slots left RESETS
    every incoming connection. Observed on a real board as an endless "Link lost"
    loop with errno 104, recovera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
    [MdnsQuery.h, RemoteActuatorBus.cpp, RemoteActuatorBus.h]
2026-09-18 A board that cannot work says why, on the glass
    An audit asked which failures a person standing at a board can actually SEE. The
    answer was: almost none of them. Everything below was recorded, acted on, and
    then reported as a coloured LED or a line on a serial cable nobody has attached
    in a shop.
    A REFUSED LAYOUT IS ITS OWN STATE. LAYOUT_BAD — blue, BLINKING. Blue because
    nothing is wrong with the hardware; blinking because, unlike ONLINE, it will
    never clear on its own. Solid blue already meant "no layout drawn yet", and the
    two send a person to opposite places: one is normal on a fresh board, the other
    means something already built is broken and the shop will not route until it is
    fixed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
    [StatusLed.h, StatusScreen.h, StatusScreenModel.h, StatusVocab.h, WakeButton.h, firmware.ino]
2026-09-18 Refuse a schemaVersion-1 layout, and stop testing against one
    Nothing has been able to PRODUCE a v1 document for a long time — the configurator
    writes v2 shops with systems[] and machines[]. What kept v1 alive was the test
    fixtures, and they did active harm.
    In a v1 topology a tool element IS its own machine, so `element.sensor.ct` reads
    correctly there and is null for every document the UI writes. That is precisely
    how the conformance suite stayed green on 2026-09-15 while no clamp paired in the
    app ever reached its node. A v1 fixture does not merely test a dead shape: it
    SATISFIES READS THAT NO REAL DOCUMENT CAN, and hides bugs in the live one.
    So twoGates.json is a v2 shop now, and co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
    [TopologyRuntime.h, test_nodebus.cpp, test_topology_router.cpp]
2026-09-18 Stop the bench tooling wasting minutes and losing layouts
    THE ANGULAR BUILD RAN ON EVERY PRIMARY FLASH. It is the slow step — the firmware
    is cached per-env by PlatformIO and rebuilds in 4-17s when untouched — so
    reflashing to change one line of C++ paid for a full UI rebuild producing
    byte-identical output. Skipped now when nothing it depends on has changed,
    fingerprinted in 55ms over dustgate-ui/src, angular.json, the lockfile AND
    shared/device-model, because the app imports the model directly and hashing only
    the obvious directory is how that goes wrong silently. --force-ui overrides.
    THE CORE DIR IS PINNED IN platformio.ini, not only exported by the scripts. A
    bare `pio run` typed i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
2026-09-18 CT to servo, end to end, on real hardware
    THE FIRST TIME THIS SHOP HAS BEEN DRIVEN BY ANYTHING OTHER THAN A SMART PLUG. A
    clamp on a NODE reads a running tool, the node decides the bit from its own 60 Hz
    RMS loop, SENSE reaches the primary, the routing brain treats it as a machine
    drawing power, and the gate moves. Three boards, all green. That is what the CT
    work since 2026-09-13 was for, and it retroactively confirms clampOf() reading
    the clamp off the MACHINE, CONFIG actually reaching a node, the SENSE frame, and
    a gate moving on a node through the alias map — all compile-and-host-tested only
    until now.
    ⚠️ IT TAKES TWO GATES TO OBSERVE, and that is not a bug (jeff: "otherwise the
    s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
2026-10-03 A link task is stopped, not killed, and never re-points a live socket
    Four ways the primary's NodeLink code could lose a node, or the whole board,
    found reading it end to end on 2026-09-27. None is proven on hardware yet; the
    primary now runs this and has linked to a node through it.
    end() gave the link task 500 ms and then vTaskDelete()d it. For a dark node that
    task lives inside an mDNS query holding the shop-wide mdnslock, or a blocking TCP
    connect — and a deleted task never releases either. The lock then stays held for
    good: every later mDNS search on the board waits 8 s and prints "[mDNS] busy —
    skipped". It now asks the task to leave and waits it out (bounded, petting the
    watchdog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
    [MdnsLock.h, RemoteActuatorBus.cpp, RemoteActuatorBus.h, firmware.ino]
2026-10-03 A jog says whether it happened
    POST /api/servo/jog answered {"ok":true} before anything was attempted, so an
    unpaired board, a node that isn't answering and a refused channel all looked,
    from the travel-limits dialog, like a gate that moved — and its "Couldn't reach
    the gate" could never fire for any of them. Which board a controllerId means is
    a question only the main loop can answer, so the route is now a Deferred reply:
    the loop tries the jog and answers {"ok":true} or {"error":"<reason>"}, in words
    for the person at the valve, since the three failures have three fixes.
    ApiService.jogServo() turns a reason into a JogRefusedError, which the dialog
    and the gate list's Test both show. The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
    [HttpApiServer.cpp, HttpApiServer.h, firmware.ino]
2026-10-03 The travel-limits dialog starts mid-travel and never drives to a guess
    An UNCALIBRATED gate opened with its dial at 0° — the model defaults an
    unmeasured referenceAngle to 0 — and the first tap commanded 3° or 15° absolute,
    snapping the valve from wherever it was to the end of its travel: the hard stop
    the dialog's own instruction asks people to avoid. Seen on the planer node on
    2026-09-27 as a first jog to 3°. It now starts at 90° and drives there, so the
    dial and the valve agree from the start.
    Capture then pre-drove the next position to its seed's ABSOLUTE angle, ignoring
    the position just captured (capture Left at 60° and Right went to 161°). An
    uncalibrated gate's next posit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
2026-10-03 The plug sweep runs only when asked for
    Opening the canvas scanned for plugs whenever anything lacked one, and every
    scan chained into the 254-address subnet sweep. On 2026-09-27 the primary lost
    its node the moment a sweep ran — `probe` showed TCP to the node timing out
    while a laptop reached it in 10 ms, and only rejoining WiFi cleared it. The
    suspect is the guest network penalising a client that scans the subnet;
    unproven, but a sweep nobody asked for is not worth the shop.
    Opening the canvas now does the three-second mDNS scan only. The sweep runs from
    "Find plugs" or the tray's "Look for Tasmota plugs", which is now shown before
    any sweep has run, since nothing else would start one.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
2026-10-03 Say which pin-12 LEDC error is harmless
    ESP32Servo attaches a pin twice on the first attach of a boot (setup() then
    attachPin()), and the core logs 'already attached' for the second — the same two
    lines ServoActuator.h quotes as the symptom of the real core-3.x detach bug. Seen
    on the planer node's first move on 2026-09-27, with every later jog clean. Say
    how to tell them apart: once on a boot's first move is this; after a
    de-energise, with the gate then dead, is the bug.
    [ServoActuator.h]
2026-10-03 Watch two boards at once, and never flash under a monitor
    `monitor` and `monitor node` could not run together: a pin naming a board no
    longer attached fell through to "first board enumerated" for BOTH roles, so the
    two monitors fought over one port. A pinned-but-absent role now fails and says
    so, and an unpinned role never takes the board pinned to the other one.
    `dev.sh ports` names each board — `dustgate.local (192.168.87.49)` beside its
    serial — by matching the USB serial (the chip's base MAC) to the MAC behind each
    _dustgate._tcp host. A convenience only: a board off the network is listed
    without a name, and DUSTGATE_PORTS_NO_NET=1 skips the lookup.
    `monitor both` (tools/monitor-bo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
    [monitor-both.py]
2026-10-03 A retried flash offers back the layout the failed one erased
    A filesystem flash that dies part-way has already erased topology.json, having
    backed it up first. The retry then finds the board empty — 404, the ordinary
    "never set up" case — takes no backup, and restores nothing. Both flashes of the
    primary on 2026-09-27 hit this; the layout came back only by hand.
    Each backup now records the host it came from (topology-*.host). On a 404, the
    newest backup of THIS board, if under two hours old, is offered for restore at
    the end — asked, never assumed, since a board wiped on purpose looks the same.
    With no terminal to ask on it is left alone and the manual command is printed.
    Backups olde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
2026-10-03 TODO: close every gate a tool doesn't need, and weigh ESP-NOW
    Two items from 2026-09-27. Routing trusts its belief about which gates are shut,
    so a gate opened by hand is never re-closed — make-before-break, then command
    CLOSED on everything else; and the shop-wide one-servo rule can become per
    board. And ESP-NOW for primary↔node, undecided: every link failure so far was
    the AP breaking a TCP path between two boards.
2026-10-03 Provision the board that was flashed, not the first port ls lists
    The post-flash provision step re-found its serial port with
    `ls /dev/cu.usbmodem* | head -1`, and its Python fallback globbed the same way
    while the port re-enumerated. With a primary and a node both plugged in,
    usbmodem1101 (the node) sorts ahead of usbmodem1401 (the primary), so every
    PRIMARY flash wrote the primary's WiFi and hostname into the NODE — renaming it
    `dustgate`, the brain's own name — and printed "✓ credentials saved". Seen on
    2026-09-27; a node flash straight after renamed it back only because 1101 happened
    to be the node.
    dev.sh already resolves the board by pinned serial and hands it over as
    PLATFORMIO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
2026-10-03 Rejoin WiFi when the network, not the node, is the problem
    Twice on 2026-09-27 the shop's guest network stopped forwarding from the primary
    to a node that was plainly alive — a laptop reached it in 10 ms, the primary's
    own `probe` timed out — and only a RESET, the primary rejoining WiFi, cleared
    it. The first time followed a subnet sweep, the second a node reboot, so the
    sweep was not the whole story.
    The primary now does that rejoin itself, but only for a node that is evidently
    alive: down a full minute, and either its mDNS name answered in that minute or
    sockets to it keep opening and dying before the WebSocket upgrade ("hollow"
    drops — a switched-off node makes the connect fail sil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
    [RemoteActuatorBus.cpp, RemoteActuatorBus.h, firmware.ino]
2026-10-03 A node says why it last booted, in every WELCOME
    A primary sees a node vanish and come back and cannot tell a planer switched off
    at the wall (normal — a CT node is powered by its tool) from a node that crashed.
    The node knows which. WELCOME now carries `upS` (seconds since boot) and `rst` (a
    reset-reason word: poweron, brownout, panic, task_wdt, usb, …), both optional —
    absent means unknown, so every older board answers as before, and nothing routes
    on either. It feeds the primary's link log.
    withBootInfo() in nodelink.js and addBootInfo() in NodeLink.h, paired tests in the
    same order. MAX_RST_LEN / kMaxRstLen is a new row in CLAUDE.md's pair table: the JS
    validator refuses a longer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
    [NodeLink.h, ResetReason.h, dustgate_node.cpp, nodelink.js, nodelink.test.js, test_nodebus.cpp]
2026-10-03 A link log on the primary, for a shop with no laptop attached
    The link was debugged all evening from serial logs, which exist only while a
    laptop is plugged into a board. The shop is about to run for days with none, and
    the question that decides what comes next — ESP-NOW or not — is how often the
    guest network cuts a node off and how long it takes to come back.
    utils/LinkLog.h keeps that on flash as JSON Lines: boot (with reset reason and a
    boot counter), wifi_up (with the access point, channel, RSSI), wifi_down (with the
    reason), link_up (how long it was down, hollow drops, and the node's own boot info,
    so "the node rebooted: brownout" reads differently from "the network dropped it"),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
    [HttpApiServer.cpp, LinkLog.h, RemoteActuatorBus.cpp, RemoteActuatorBus.h, firmware.ino, linklog-summary.py]
2026-10-03 A flash blocked by an open port says how to free it
    The guard offered '--take', which is a monitor option that flash does not have.
    It now says to Ctrl+C the holder — usually the monitor the previous flash opened
    at its end — or names the kill command.
2026-10-03 flash-node takes the one unpinned board when the pinned node is absent
    A shop has many nodes and one 'node' pin, so the pinned node being unplugged is
    the ordinary state while adding boards — and the strict pin rule from 2026-09-27
    answered a healthy new board with 'no board for node is attached'. When exactly
    one attached board is not the pinned primary, the node role now uses it; two or
    more still refuse, which is the collision the strict rule was written for.
2026-10-03 Every build says what it is: commit and build time
    "What did I flash last?" had no answer. Every board said version 1.0.0, and
    `built` was __DATE__/__TIME__ of whichever file last recompiled — stale whenever
    that file was not the one that changed.
    extra_script.py now stamps each build with the short commit ("+" when firmware/ or
    platformio.ini has uncommitted changes) and the build time, into
    utils/BuildStamp.cpp ONLY, via a build middleware — so a fresh stamp recompiles
    one small file (a rebuild measured 10 s) rather than every translation unit, which
    a global define that changed every build would have forced.
    It surfaces where the question gets asked: the boot banner on both roles; `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
    [BuildStamp.cpp, BuildStamp.h, HttpApiServer.cpp, LinkLog.h, StatusScreen.h, dustgate_node.cpp, firmware.ino]
2026-10-03 Pass the upload port on the command line, so flashing stops wiping the build
    Every node flash recompiled the framework, every library and the bootloader.
    PlatformIO wipes .pio.nosync/build for ALL envs when its project checksum
    changes, and that checksum hashes the resolved project config — into which it
    folds PLATFORMIO_UPLOAD_PORT, the variable dev.sh handed the board's port over
    in. So a flash to a different port than the last build (primary on 1401, a node
    on 1101, another USB socket, or any compile with no port) was a full rebuild.
    Checksums measured 2026-09-28: no port 7dffb9b8, 1101 c1e4fc42, 1401 c6559be2.
    dev.sh now hands the port over as DUSTGATE_UPLOAD_PORT and deploy.sh passes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
2026-10-03 provision node says it is provisioning a node
    deploy.sh --provision-only fell back to the primary env for its description, so
    provisioning the planer printed 'Target: xiao_c5_primary'. Same C5 part, so it
    wrote correctly, but the log claimed a node was a brain. dev.sh now passes the
    node env. Also: the password prompt says the kept password is tools/.env's, not
    the device's.
2026-10-03 A machine switching on re-closes every gate it doesn't need
    A gate somebody opened by hand stayed "closed" in our books and was never closed
    again, so the collector pulled through two tools (jeff, 2026-09-27). Routing
    already asked for CLOSED on every off-path gate; planTransition() skipped any
    gate BELIEVED to be at its target, and servos are open-loop, so belief is all
    there is.
    On a machine's RISING EDGE, every servo gate in its systems is now re-asserted:
    commanded whether or not we think it is already right, still make-before-break
    (the re-sent open is a make, the re-closes are breaks). Only on the edge — ingest()
    runs every poll tick, and re-asserting there would move every gate sev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
    [Shop.h, TopologyController.h, TopologyRuntime.h, TopologySequencer.h, test_nodebus.cpp, test_topology_controller.cpp]
2026-10-03 Name the C5's power-glitch reset, and read node reboots correctly
    The router-table-jointer rebooted on every servo jog and reported 'unknown': the
    C5 adds EFUSE, PWR_GLITCH and CPU_LOCKUP to the reset reasons, and ResetReason.h
    listed only the classic ESP32's. They are named now (a node needs a reflash to
    report them).
    linklog-summary.py judged 'did the node reboot?' against downMs, which is only
    the ~2 s after the primary's heartbeat noticed — a node that rebooted 10 s ago
    read as 'down 2 s' and every brownout was labelled 'the network dropped it'. It
    now compares the node's uptime with the time since the link was last good, and
    treats 'unknown' from older node firmware as a likely power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
    [ResetReason.h, linklog-summary.py]
2026-10-03 TODO: ramp servo moves, and what the drum-sander board's pwr_glitch said about the MPM3610 at 6 V
2026-10-03 TODO: servo moves are already ramped; the gap is the first move of each boot
2026-10-03 WiFi failure names status 0: joined, but DHCP gave no address
    [WiFiProvisioner.h]
2026-10-03 The brain keeps its serial output and serves it over WiFi
    Every Serial print on a primary, and every library log_e, also lands in a
    32 KB PSRAM ring. GET /api/serial?from=N serves it with cursor headers that
    say when bytes were missed or the board restarted. bash dev.sh log follows it
    from a laptop with no cable and saves it to .monitor-logs/. The mock serves its
    own console the same way. Mockup for the app screen: docs/mockups/brain-log.html.
    The ROM log hook is unverified on a board.
    [HttpApiServer.cpp, SerialCapture.h, SerialLog.cpp, SerialLog.h, brain-log.py, firmware.ino]
2026-10-03 Brain log screen: the brain's serial output and commands, in the app
    Your boards → the brain's Log button opens it. Lines stream in once a second,
    with chips for Boards / Network / Problems, text search, pause, and copy;
    missed bytes and restarts are marked. A command line underneath runs any
    serial command through the same reader the USB monitor feeds (POST
    /api/serial), echoed as "> cmd". Works against the mock and the browser demo.
    Decision D-73; mockup docs/mockups/brain-log.html.
    [HttpApiServer.cpp, SerialLog.cpp, SerialLog.h]
2026-10-03 Serial log: ROM hook runs from IRAM, and a panic reports itself next boot
    The first build carrying the log capture panicked once on the bench, about 107 s
    into a boot, cause not captured. The ROM print hook ran from flash and wrote
    to PSRAM, which crashes the chip if anything prints while the flash cache is off.
    It now runs from IRAM into a 1 KB internal-RAM buffer, and the PSRAM ring is
    filled from that buffer by the next ordinary write.
    A panic now records its reason, PC and stack addresses in .noinit RAM through
    the core's panic hook (linked with -Wl,--wrap=esp_panic_handler). The next boot
    prints them as [CRASH] lines, so GET /api/serial and the Log screen carry them,
    and a shop board w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
    [SerialLog.cpp, SerialLog.h, firmware.ino]
2026-10-03 A collector the layout watches with a clamp is judged by the clamp
    Two stale-plug faults kept an RF-pressed, clamp-watched collector from ever
    starting (bench, 2026-10-03):
    - Slot 0 kept whatever collector plug it had stored when the layout named none,
    a rule from before layouts. The stored plug's IP was long gone, so its
    'unreachable' became the collector's reading, and the press policy, which
    never presses blind, refused to press at all. The layout now decides
    slot 0 like every other slot.
    - The main loop wrote any configured plug's watts over the reading
    pollSensors() takes from the collector's clamp, so the press policy got
    whichever sensor wrote last. A clamp's reading now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
2026-10-03 The Live view lists what was asked for and isn't happening
    One problems list in /api/status, worded by the device: collector not
    starting or unreadable, RF gave up or could not send, a board offline,
    a plug unreachable, failed gate moves. A failed tap now says why, and an
    unreachable brain is shown as such. The two plug-derived codes are a
    matched JS/C++ pair (problems.test.js / test_nodebus.cpp).
    [TopologyRuntime.h, firmware.ino, test_nodebus.cpp, test_shop.cpp]
2026-10-03 Collector press: the first press comes, a failed OFF is reported, failures stick
    Found reading the live layout against the press policy:
    - a clamp-fed collector's age was how long the CLAMP had read on (0 when
    nothing runs), so the state read 'starting' for ever: never judged
    not-starting, never retried, and the first press after boot never came.
    The runtime now times how long it has COMMANDED the blower on, and the
    first press of an intent no longer waits out a grace nobody started.
    - an OFF that doesn't take is reported (collector-wont-stop) rather than
    invisible.
    - a failed gate move used to live on the status for one re-decision; it now
    stays until that gate next moves, and a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
    [CollectorPress.h, RemoteActuatorBus.cpp, RemoteActuatorBus.h, TopologyRuntime.h, firmware.ino, test_collector_press.cpp, test_nodebus.cpp]
2026-10-03 WiFi failure: check the antenna when no AP is seen
    [WiFiProvisioner.h]
2026-10-03 Collector: stop toggling a running blower, no false dead-head, no switch on the card
    Read off the bench log:
    - a changed want pressed the remote even when the clamp already showed the
    wanted state. A press is a toggle, so ON-OFF-ON in quick succession stopped
    the blower and the retries then chased it. A reading that agrees now wins,
    and an OFF is judged by the real draw (pressObservation).
    - idle reported dead-head risk from the plan's all-closed destination, which
    idle never executes (it holds the gates). Now judged against the gates as
    they stand.
    - the poll task re-read _collectors[i] after the main loop had removed it:
    Load access fault at boot, found by decoding the new cras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
2026-10-03 The device's MAC survives the app's discovery and ping mapping
2026-10-03 Tasmota stored as a Shelly corrects itself; status document moves to PSRAM
    - the sheets refresh kind and MAC from the latest probe on save (a plug
    already paired at an address never went through pick() again)
    - the brain asks a silent no-kind plug whether it is a Tasmota and fixes the
    layout itself
    - the status document is built in PSRAM: a browser loading the app drove the
    internal heap to 3.5 KB and the page would not load
    [firmware.ino]
2026-10-03 Watch the internal heap: log dips, and report it on /api/info
    The board aborted creating a lock (out of internal heap) while a browser
    loaded the app. The dip lasts a second or two, so it is sampled every 250 ms
    and the lowest value plus the largest free block is logged when under 20 KB.
2026-10-03 Never let a page load take the board down
    A cold load asks for six files at once and each open file costs ~10 KB of
    internal RAM; that aborted the board in a crash loop (lock creation failing
    inside fopen) and dropped every gate link with it. Hashed files are now cached
    for good, static serving refuses with 503 below 28 KB free or beyond three at
    once, and index.html reloads itself a few times when a script is refused.
    [HttpApiServer.cpp]
2026-10-03 The app is one bundle, gzipped: four files instead of seventeen
    Lazy screens made the build emit a file per screen and a cold load asked the
    board for six at once, ~10 KB of RAM each. On a LAN lazy loading saves nothing.
    Routes are eager, the scripts are gzipped at deploy (the server already hands
    .gz to browsers that accept it): index + main + polyfills + styles, ~230 KB
    over the wire instead of ~810 KB.
2026-10-04 Pairing a node no longer drops the others
    syncPairedNodes() stopped every link and dialled them all again on any change
    to pairing: the 3rd and 4th node each dropped every linked node, took the heap
    to ~2 KB while tasks and sockets were rebuilt, and left no gate commandable.
    Only the link that changed moves now: kept, stopped or started per
    control/NodeLinkPlan.h (pure, host-tested). A link task is never moved in
    memory, so removal leaves a free slot the next pairing reuses; every loop over
    the pool skips unused slots.
    [NodeLinkPlan.h, RemoteActuatorBus.h, firmware.ino, test_nodelinkplan.cpp]
2026-10-04 Saving a layout no longer takes 24 KB of the board's scarce RAM
    TopologyStore::save() built a fixed 24 KB document to validate a ~3 KB layout
    on every save, and the runtime then held a second copy while the first was
    freed. Each save in the app dipped the internal heap 10-20 KB (the [HEAP] LOW
    lines sit right after 'topology saved'). Documents are now sized to the body and
    live in PSRAM (utils/JsonAlloc.h); the layout the runtime keeps, the layout
    rewrite and the status document too.
    [HttpApiServer.cpp, JsonAlloc.h, TopologyRuntime.h, TopologyStore.h, firmware.ino]
2026-10-04 Which board polls a plug: the one that controls its tool
    shop.js plugOwners() / Shop.h plugOwnerOf(), a matched pair driven from one
    fixture (plugOwners.json): the board driving the selector a tool's port hangs
    from, a manifold/slider node for every tool behind it, the brain for a tool
    with no node of its own. Nothing uses it yet; the CONFIG plug sensor and the
    node poller come next.
    [Shop.h, test_plugowner.cpp]
2026-10-04 The primary can update itself over WiFi, and rolls back if the new image is no good
    POST /api/ota writes an image into the other app slot, verifies it, and reboots;
    the new image is on probation until it has held WiFi for 30 s (utils/OtaGuard),
    and rolls back by itself if it has not by 3 minutes. dev.sh ota builds, posts and
    waits for the verdict.
    Both partition tables gain a second app slot: the primary's moves to the 8 MB the
    chip always had (2.5 MiB x2 + a 2.94 MiB filesystem that will also hold the node
    image), the node's to two 1.9 MiB slots inside the same 4 MB. Each needs ONE cable
    flash to install; nothing has been flashed or run on hardware.
    [partitions-xiao-c5-node.csv, partitions-xiao-c5-primary.csv]
2026-10-04 A node can be told to pull a new firmware image from the primary, and the Boards screen has an Update button
    The OTA / OTASTATE NodeLink frames (JS + C++, paired and tested), the node's
    HTTP pull with MD5 check and probation, POST /api/node-image to stage node images
    in the primary's filesystem, POST /api/nodes/update (refused while any collector
    runs), update fields on GET /api/nodes, and dev.sh ota now builds all three
    programs from one commit, flashes the primary and stages the node images.
    Manual and one node at a time, by decision. Nothing here has run on a board; the
    partition tables need one cable flash per board first.
    [partitions-xiao-c5-primary.csv]
2026-10-04 The board that controls a tool polls its plug, and the brain reads what the board reports
    CONFIG sensors gain kind plug (ip, protocol, threshold), SENSE gains watts and plug,
    WELCOME gains caps.plug; all paired JS/C++ and tested. The node polls on a task of
    its own and sends on change plus every 5 s. The primary hands a board its plugs only
    if the board said it can (older nodes stay brain-polled), stops polling those
    outlets, and treats a stale or faulted report as off and unreachable. Plugs past a
    node's four sensor slots stay with the brain.
    Not run on any board.
2026-10-04 Settings > Danger zone: Reset layout, and Reset everything
    Reset layout deletes the stored layout (boards and plugs stay paired). Reset
    everything also forgets every paired board and plug; WiFi, the API key and gate
    calibration stay. Not run on a board.
    [HttpApiServer.cpp, HttpApiServer.h, TopologyStore.h, firmware.ino]
2026-10-04 dev.sh ota: resolve the board's address once, so a flaky mDNS lookup cannot hide a successful update
2026-10-04 The Boards page shows the brain's own firmware version
2026-10-04 The page-load guard can no longer wedge: file requests take expiring slots instead of a counter that leaked
    [HttpApiServer.cpp]
2026-10-04 A node's OTA download feeds the watchdog and gives up after 8 s of silence, instead of resetting the node when the primary vanishes
    [dustgate_node.cpp]
2026-10-04 /api/info reports image and filesystem fill; dev.sh ota prints them
2026-10-04 TODO: a tool switched off by hand stays green for several seconds
2026-10-04 TODO: a collector cannot run as a node yet (RF and bin sensor are primary-only)
2026-10-04 CLAUDE.md: say that the collector's RF remote and bin sensor are primary-only today
2026-10-04 CLAUDE.md status: the bin sensor was proven on a primary
2026-10-04 The page-load guard no longer counts WebSocket upgrades as static files (they stay open, so a slot taken was never really free)
    [HttpApiServer.cpp]
2026-10-04 Ws.GetConfig read from the brain timed out at 0 ms (a virtual's default argument binds to the static type), so no Gen4 plug could be taken over, renamed or paired; and every logged line now carries i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
    [SerialLog.cpp, brain-log.py]
2026-10-04 NodeLink: JOIN, REFUSE and WHERE frames and caps.join (node-initiated links); additive, version stays 1; paired JS/C++ tests
2026-10-04 docs: nodes-dial-the-brain plan — phase 1 built, not yet on hardware
2026-10-04 Pump node-initiated links from loop(): the routing runtime returns early with no layout, so nothing pinged them and every node read offline
2026-10-04 Refuse a node's JOIN as busy when internal RAM is short, so a primary reboot's redial herd cannot starve the app
    [firmware.ino]
2026-10-04 Pause/resume and unpair now close and forget a node's own socket (the stale one kept the bus from ever dialling or re-sending HELLO); a refused node backs off instead of redialling every 1.5 s; caps 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
2026-10-04 Node: a socket only counts as the link once the primary has answered with a HELLO (the sweep was 'linking' to other nodes); a fresh beacon wakes a node out of its backoff; boot grace 10 s
2026-10-04 docs: where does the brain live? Options compared; the ESP32 brain and a hosted brain must be one codebase (the existing C++ core, native build behind a platform interface)
2026-10-04 The collector's jobs on a node: a PRESS frame keys the node's RF transmitter once, a bin sensor kind in CONFIG reports the beam as a SENSE bit, caps.rf and caps.bin; RemoteRfPresser, control.rf.contr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
2026-10-04 One rule for 'which board is this id' (control/BoardId.h, board-id.js): NodeBus, the sensor push, the bin sensor and the RF presser all call it; the exact-compare outliers are gone, and the two JS co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
2026-10-04 The layout's sensors resolve ONCE (control/SensorPlan.h): the push serialises the plan per board and the poll reads readings back by the same ids, instead of two walks that each had to learn every ne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
    [SensorPlan.h, TopologyRuntime.h, test_sensorplan.cpp]
2026-10-04 Split RemoteActuatorBus: the protocol half is a pure NodeSession (frames in, frames out, a clock it is given, no socket, task or mutex) with 71 host tests; the bus keeps the transport and serialises 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
    [NodeSession.h, RemoteActuatorBus.cpp, RemoteActuatorBus.h, test_nodesession.cpp]
2026-10-05 native/: dustgate-brain step 1 — a Boost.Beast shell that runs the shared NodeSession against real nodes (JOIN, HELLO/WELCOME, ping, beacon, GET /api/nodes). All five bench nodes found it by beacon a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
2026-10-05 native brain: the shared TopologyRuntime drives node gates (SessionBus, layout adopt/status routes, fakenode, end-to-end test: a tool drawing power opens its gate on the node that owns it)
2026-10-05 The collector's press loop is shared (control/CollectorDriver.h, 22 host tests) and runs on the native brain too. Two latent bugs found by driving it: an open-loop collector (no plug, sensor or clamp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
    [CollectorDriver.h, CollectorPress.h, TopologyRuntime.h, fakenode.cpp, firmware.ino, main.cpp, test_collector_driver.cpp, test_collector_press.cpp]
2026-10-05 Smart-plug drivers run natively: every HTTP call in the Shelly and Tasmota drivers goes through one seam (outlets/PlugHttp.h; HTTPClient+ESPmDNS on the ESP32, Boost.Beast on the native brain). The na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
2026-10-05 Node plug poller: 10 KB stack, created from setup() and retried from loop() (a node that booted with a fragmented heap had no poller and every plug read unreachable), and GET /api/plugs says whether 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
    [HttpApiServer.cpp, dustgate_node.cpp, main.cpp]
2026-10-05 Shared API core (api/ApiCore.h, 27 host tests) and the native brain's side of it: manual tool and collector switches, servo jog, board pairing/pausing/discovery (a board nobody paired announces itsel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
    [ApiCore.h, Log.h, Md5.h, NodeHub.h, PlugHttpNative.cpp, main.cpp, test_apicore.cpp]
2026-10-05 Plug operations are shared (outlets/OutletOps.h): probe/describe, rename, release now live once and the ESP32 sketch calls them. Native brain: the plug screens (ping, rename, release, subnet sweep, d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
2026-10-05 Board and plug problems are shared (control/DeviceProblems.h, 11 host tests) and raised on the native brain; the ESP32 sketch uses the shared rules. TODO and README brought up to date
    [DeviceProblems.h, firmware.ino, main.cpp, test_deviceproblems.cpp]
2026-10-05 native brain: Cache-Control: no-store on every API reply (a browser kept showing a layout error the brain had already fixed)
    [main.cpp]
2026-10-05 A collector DustGate cannot switch is asked for, not accused: collector-needs-start ('A tool is running and the dust collector isn't - please turn it on') replaces 'commanded on but drawing nothing' 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
    [NodeSession.h, TopologyRuntime.h, main.cpp, test_nodebus.cpp, test_nodesession.cpp]
2026-10-05 Native brain: board scan by mDNS (dns-sd/avahi) so a fresh unclaimed board can be found and paired, /ws push socket (the app logged a failed socket every 3 s), harmless Settings resets, port 80 by de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
    [ApiCore.h, main.cpp, test_apicore.cpp]
2026-10-05 native test: a board scan asks mDNS first, so its check waits for it
2026-10-05 Native brain: default state dir (~/.dustgate), warn when no --www, escape layout errors; tests export DUSTGATE_STATE
    [main.cpp]
2026-10-05 Fix the desk-pass findings: no update offered to a node whose build is newer, transmitter board picker in the collector sheet, 'switched by its remote' on the Tools screen, ESP dustcollector/switch t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
    [NodeStatus.h, firmware.ino, main.cpp, test_nodesession.cpp]
2026-10-05 Native brain: Shelly push and takeover. A Gen2 plug is pointed at /shelly-rpc and read off its socket (not polled), a plug someone else owns is polled until a person approves a takeover, release hand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
2026-10-05 Using a tool ends a hand-switched one: switching a tool on, by hand or when its sensor sees it start, releases the other manual tools in its systems (a manual claim no longer outlives the person's at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
    [TopologyRuntime.h, test_nodebus.cpp]
2026-10-06 Layout parse pool sized for 64-bit pointers: a real six-board layout answered NoMemory on the native brain and the app could not save a tool (fixture + test)
    [TopologyRuntime.h, test_nodebus.cpp]
2026-10-06 TEMPORARY: collector running threshold 25 W (bench desk fan draws ~38 W); TODO to put it back
2026-10-06 collector driver test: a blower we started vs one a person started
2026-10-06 Press policy: wait 20 s after an OFF press before judging it (a Tasmota's power reading held the old value 13 s; retries inside that window toggled the blower three times). ON timing measured fast an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
2026-10-06 A node that re-dials after resetting mid-move no longer leaves the shop's servo mutex held: onAttach drops the dead board's outstanding move (every gate froze for 210 s)
    [NodeSession.h, test_nodesession.cpp]
2026-10-06 TODO: re-send a gate move interrupted by a board reset
2026-10-06 A gate-move warning clears when the board's link is re-established; a collector a person started is never reported as 'won't stop'; TODO: slow collector start, find plugs, plug rename/release, CT col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
    [CollectorDriver.h, NodeSession.h, test_collector_driver.cpp, test_nodesession.cpp]
2026-10-06 Live screen: the collector card is a tap-to-run / tap-to-stop button again (approved mockup); decision D-75
2026-10-06 Raspberry Pi: setup/deploy/update scripts, systemd unit and README (run the shop without the Mac); the brain reports its commit, waits for a network address at boot, spells out its std includes for G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
2026-10-06 nodelink conformance: 'bin' is a real sensor kind now, so the refused-kind case needs a kind that is not
2026-10-06 Constants: a checked manifest of every shared number (35 checks, run by model:test), the servo-bank and stop budgets across JS/C++/UI included; the tool and outlet sheets share one default threshold
2026-10-06 Firmware: delete the legacy single-system routes (estop, config/gates, config/port-role, config/idle-timeout, PUT/DELETE outlets/:slot and dustcollector) and their consumers
2026-10-06 Mock, model, conformance, UI: delete the legacy single-system API (estop, numgates, port-role, idle-timeout, outlet slot PUT/DELETE, dustcollector config) and the conformance cases that exercised it
2026-10-06 Firmware: stop reading schemaVersion 1 — validateMinimal refuses it with the runtime's sentence, Shop.h has no v1 branches, the controller tests use shop fixtures
    [Shop.h, TopologyController.h, TopologyRouter.h, TopologyRuntime.h, TopologySequencer.h, TopologyStore.h, firmware.ino, test_shop.cpp]
2026-10-06 TODO: legacy API, schemaVersion 1, shared constants and the doubled Scanning are done (DONE.md); CI checks the built app carries the current model
2026-10-06 Firmware: an interrupted gate move is sent again — DeviceProblems acts on the board's move-fault edge and TopologyRuntime::reassertBoard() re-commands the selector last sent there
2026-10-06 TODO/audit: slow collector start measured on the software side; calibrate entry exists on /gates; audit status
2026-10-06 TODO: a Plugs page like /boards replaces the 'Find plugs does not load' report
2026-10-06 Boards: a current clamp is switched ON per board (clamp:true on the controller in the layout); the clamp pickers offer only switched-on boards; layouts that already sense with a clamp are healed on r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
2026-10-06 Plugs page (/plugs), laid out like /boards: live draw, ownership, rename, release, take over, pair, scan, sweep and add by address; the canvas menu's Find plugs becomes Plugs
2026-10-06 Decisions D-76..D-78 and TODO: clamp switch, delete system, Clear shop and the Plugs page
2026-10-06 README: rewrite for the current architecture (boards, node-initiated links, the native brain, the optional Raspberry Pi) and add rough limits for a small shop on a C5
2026-10-06 Native brain: follow its own address (no fixed IP): beacon, plug push target and the sweep track it, with an e2e test; Pi README drops the DHCP reservation; TODO: Pi bring-up steps
    [PlugPoller.h, main.cpp]
2026-10-08 A layout save is not a reboot; the slider can be set up on a node; fixes from the 2026-10-06 bug search
    - TopologyRuntime::adopt (and createTopologyDevice with prev) carry over readings, blowers, press bookkeeping and the position
    of every gate the save left alone (sameHardware); a save mid-cut no longer orphans the collector. New pair
    layout-save.test.js <-> test_layout_save.cpp; e2e.sh saves mid-run and expects the OFF press
    - Slider on a node: POST /api/linear/goto, GET /api/linear/state (ApiCore), TopologyRuntime::driveLinearTo; SET.home (additive,
    paired tests) makes the node find its datum again; the slider page and the Gates list's Test drive a node's slider; stops
    seeded from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
    [ApiCore.h, HttpApiServer.cpp, NodeLink.h, Sweep.h, TopologyController.h]
2026-10-08 Servo pulse range on Settings; optional boards; per-board moves, quick blower start, boot settle, [TOOL] log
    - Servos: one shop-wide PWM pulse range (default 400-2600 us, bounds 300-2800, span >= 500) set on Settings,
    kept in the layout's servo block and sent on every servo SET. The pulse is written to the LEDC channel
    directly, and on core 3.x the channel is attached directly too: ESP32Servo clamped to 500-2500 and its
    double attach printed a false "Pin 12 is already attached" on every boot's first move.
    - Optional boards: a board with no gate and none of a collector's jobs raises no board-offline and does not
    hurry the beacon (isOptionalBoard, shop.js <-> Shop.h). Replaces the unre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
    [ActuatorBus.h, DeviceProblems.h, LocalActuatorBus.h, NodeBus.h, NodeHub.h, NodeLink.h, NodeSession.h, RemoteActuatorBus.cpp]
2026-10-09 Wiring docs match the board header; sourcing guide merged into the BOM; carrier wiring diagrams for perfboard and PCB
    - WIRING.md: the pin drawing and pad table showed four servo channels on D7-D10 and D0/D6 unused; it is
    gate D7, fob D8, CT D0, bin D6, transmitter D10, D9 free. Section 10 had the RF module on D9 (the header
    says D10). Section 3 still described the stepper board; sections 6 and 11 described four servos and two
    fob servos. The servo rail (a second buck) is now in the power section.
    - WIRING.md section 8: the switched jack (Adafruit TRRS #5764 labels on perfboard, SJ1-3525N pins on the
    PCB), a plug-detect pull-up through its switch, and a 1k + Schottky clamp on D0 for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
2026-10-09 BOM: one PCB order list with a buy link, KiCad symbol and footprint for every part
    Links and prices from the sourcing guide; every symbol and footprint name checked against KiCad 10's
    own library, the Seeed OPL library for the XIAO. The three modules (MPM3610 breakout, Pololu D24V22F6,
    SparkFun 10535) have no published footprints and sit in plain 0.1-inch sockets.
2026-10-09 BOM: the three modules use the DustGate KiCad library; servo header is breakaway male; TVS parts approved
2026-10-09 Wiring page: schematic close-ups of the CT clamp circuit and the bin sensor, every part named; WIRING.md: the CT shield is left off on a jack build
2026-10-09 Native brain: fixes from the 2026-10-06 bug search
    - A network handler that throws no longer ends the brain: io.run() is retried with the error logged, and the two
    remote_endpoint() calls and the beacon's make_address() use their non-throwing overloads.
    - The knock list is touched only on the network thread; the Boards scan gets a copy. Entries expire after 2 min and
    are capped at 32, so made-up JOINs cannot grow it without bound.
    - A collector's control plug is re-sent its state until it takes it (the ESP32's rule). It was sent once and
    forgotten, so a plug unreachable at that moment, or a slot recreated by a layout save, stayed wrong.
    - NodeWs::write() moves the frame into _hold befo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
    [AtomicFile.h, Log.h, PlugPoller.h, main.cpp]
2026-10-09 Pi deploy: a failed cross-build can no longer install the old binary as the new one
    - deploy.sh deletes the old arm64 binary first and checks make's own exit status (it was piped through grep || true,
    and "does the file exist" was satisfied by the previous build). --state now runs ssh -t, so sudo can ask.
    - Makefile: one dependency list by directory (it missed utils/JsonAlloc.h and sensing/PowerSensor.h), and a
    per-commit stamp so a new commit with no source change rebuilds and /api/info stops reporting the old id. The
    obscure $(BIN:...) substitution in the arm64 rule is gone.
    - setup.sh suggests deploy.sh with $SUDO_USER rather than root, and says its swap block only matters for --on-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
2026-10-09 CT bias bulk cap is a 10 uF electrolytic, as the planer-sensor node runs (BOM, WIRING.md, the wiring page)
2026-10-10 A board says whether a clamp is plugged into its jack; the per-board clamp switch is gone
    - Node and ESP32 primary probe D0 once a second, averaged over a mains cycle (sensing/ClampJack.h, shared):
    railed high is an empty jack (the jack switch's 10k, and D0's own pull-up for a bare pad), mid-rail is a clamp.
    Sent as a new CLAMP {in} frame on a change, on a new link and every SENSE_REPEAT_MS, whether or not the layout
    uses the clamp. nodelink.js clamp() <-> NodeLink.h buildClamp, paired tests.
    - NodeSession keeps it per board (-1 = not said, never read as unplugged; forgotten on a link drop) and both
    brains serve it as clampIn on /api/nodes. DeviceProblems raises clamp-unplugged for a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
2026-10-10 Bin diagram: the green pilot and red strobe on a 6-way terminal, with their measured currents against the QS18's sink budget
2026-10-10 One board per collector; a full bin blinks every board on its system red
    A collector's transmitter, clamp and bin beam are now all on ONE board, the
    collector's own controllerId; none of the three names a board of its own
    (topology.js refuses it). A bin wired to one board with the transmitter on
    another was a bin nobody watched. A native brain has no pads, so a collector
    with jobs and no board raises collector-no-board, and the setup sheet offers
    only boards that report rf, bin or a clamp (caps.rf/caps.bin on /api/nodes).
    The board picker is first on the collector's sheet.
    A full bin is now seen across the shop (RFC "binNearFull", system scope):
    - an ALERT {bin} frame (nodelink.js <-> NodeL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
2026-10-10 Collector sheet: the clamp's live reading under its option, and a clamp is also for a motor whose start-up surge trips a plug; Boards: the bin beam gets its own line instead of reading as a clamp
2026-10-11 A clamp watches one thing; a jack that reads wrong is no clamp; three unseen presses say the blower is probably on
    - One clamp, one owner: validateShop refuses two claims on a board's clamp, the
    tool sheet greys out a taken one and the collector sheet warns. The collector
    and the planer once shared planer-sensor's jack.
    - ClampJack: a clamp is a mean of 950..2350 mV, not merely "not railed". The
    collector board read 2971 mV (a reversed clamp diode, which also cost its XIAO)
    and reported a clamp that never saw the blower. clamp-unplugged now says the
    jack's wiring may be off.
    - Three ON presses the reading never confirmed latch "collector-may-be-on", which
    only a reading of the bl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
2026-10-16 A calibration jog waits for the servo to land; every request waits for the API key; degrees and Go-to on the servo widget
    - NodeSession tracks a jog until the node reports it arrived (jogging(), 6 s timeout), kept apart from busy() so it
    never blocks routing. The native brain's GET /api/linear/state now answers moving for it. Without it the widget's
    one-move-at-a-time pump never waited, and taps reversed a loaded servo mid-sweep. Jogs are logged with their angle.
    - The app's request helpers wait for /api/info before sending. Settings opened cold got a 401 and showed the
    400-2600 us defaults over a shop running 300-2800, one Save from writing them back; Save now stays off until the
    re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
2026-10-16 The v1 layout is gone: aliases, fixtures, the refusal sentence and the port-is-its-own-machine rule
    - The tool-for-machine aliases (setToolPower, setToolManual, toolForOutlet, toolThreshold) are renamed to the machine
    names at every caller and deleted. The /api/tool route keeps its name.
    - systemView() stops stamping schemaVersion 1 and validateTopology() stops asking for it; validateShop() requires 2.
    - A tool element carrying a sensor is refused: its plug or clamp is on its machine. The element-level tool clamp and
    plug-kind checks move to machines in shop.js, which also refuses a machine sharing a collector's plug. adoptOutlets()
    reads only machines and collectors.
    - No special sent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
2026-10-16 A slider says why it did not get there: STATE.err, the driver's fault, the page shows it; a settled move is not a jam
    - STATE gains an optional `err` (moving:false only; MAX_STATE_ERR_LEN <-> kMaxStateErrLen, a new pair with paired tests):
    the move ended without arriving, and why.
    - The slider node sends it for a failed home with a move waiting on it (each way a sweep fails, in words), a SET with no
    servo answering on the bus, and a move its driver ended rather than finished (ST3215LinearDriver::fault(): a jam, a
    timeout, a stop with no readable count). It used to say so on serial only, while the brain waited 210 s.
    - The brain makes it the board's move fault (move-failed, in the node'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
2026-10-16 BOM: the KiCad columns come out; the RF socket is counted, the MPM3610 pins read from pad 1, one fuse part
    The order list named KiCad symbols and footprints, some of them by a path on one Mac. The board
    design is kept outside this repo now, so those columns pointed nowhere a reader could follow. What
    stays is what to buy. The design keys on the row NUMBERS here, so the intro asks for rows to be
    appended rather than reordered.
    Three corrections the cross-check found:
    - Row 3 counted two 4-pin sockets; a collector board's 315 MHz transmitter needs a third.
    - Row 5 read the MPM3610 header from the far end (1 EN ... 4 GND). It is GND, VOUT, VIN, EN from
    pad 1 - the same physical order, now nu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
2026-10-17 The status pixel is the Treedix WS2812B board on both builds, and was never an Adafruit breakout
    The perfboard's pixel is one board snapped off a Treedix 48-board WS2812B panel (Amazon
    B09FSTT43H). The docs called it an Adafruit NeoPixel breakout, which it never was.
    The PCB now uses the same board instead of a bare 5050 (SparkFun COM-16347): it is the pixel that
    has run since 2026-08-23, it carries its own decoupling, and dozens are on hand. BOM row 20 becomes
    the Treedix board, and row 15's 0.1 uF count drops from 5 to 4 because the pixel no longer needs
    one. WIRING.md section 4 and both tabs of carrier-wiring.html follow; the PCB tab names pins by
    number (1-3 = 5V, DIN, GND; 4-6 = 5V, DO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
2026-10-17 StatusLed: PIN_PIXEL_EXT comes out; the across-the-shop flag will be a chain off DOUT
    The second pixel pin, at 4x gain, was for a remote pixel read from across the shop. No board
    ever defined it, and on the XIAO it would cost a pad there is none of to spare. The job it was
    meant for - a bin-level flag at the collector, replacing the red strobe and the "collector
    running" pilot - is planned as pixels chained off the board pixel's DOUT, which costs no pad but
    needs a multi-pixel write in place of _write(). The header says so where the pin used to be.
    PIXEL_GAIN stays. Host tests pass; xiao_c5_primary and xiao_c5 both compile.
2026-10-17 The slider page: Try again after a failed move, and its arrows and Capture locked until the slider has found home
    A failed home left the page with nothing to press but Back, and a stale move-failed problem that only a move that gets
    there can clear (a board cannot tell a switch was plugged back in). Try again sends the same outlet, finding home first.
    Until a move has found home this session, or after one that did not, the arrows and Capture are locked: a jog would set
    off a home of its own, and a capture would save a position measured from no datum. DONE.md: the failure reporting seen
    on the slider.
2026-10-17 Where air leaves a gate it is a port, not an outlet; outlet means only the smart plug
    Jeff: "outlet" for both was confusing. The slider and valve calibration, the canvas (port count, cap, tee, the
    shared-port warning), the Live screen, tool setup and Settings now say port. The plug screens keep outlet, and code
    identifiers keep their names. Decision register: D-83.
2026-10-17 A collector switched by a smart plug can be watched by a clamp: the plug may switch a contactor
    Jeff's contactor build (2026-10-17): a Shelly 1 Mini switches the contactor's coil, so the plug's own power is the coil's,
    a few watts whether or not the blower started, and the clamp on the blower's feed has to be the feedback. The sheet
    locked "Watched by" to the switching plug; it now offers that plug (the default) or a clamp, and collector-doc's
    fused() no longer swallows a clamp chosen beside a switching plug. Both brains already read the clamp over the plug
    (collectorHasClamp). TODO: the slider page's Try again and lock, untested — a limit-switch wire broke first.
2026-10-17 A board not heard from since the brain started reports no caps, so a switched-off slider stays a slider
    /api/nodes wrote every cap as 0 before a board's first WELCOME. The app read linear: 0 as "a servo board", stripped
    drives: linear off the slider (powered off after a Pi deploy), and then refused its own save: "dustgate-slider is a
    servo board". Caps are now omitted until the board has said, and the app keeps what the layout already holds
    (drivesFromCaps returns null). Also: "leaking port", not outlet, on the canvas.
2026-10-18 The undrawn Pi brain stops holding its cell: nothing is blocked, routed round or sized for a board that isn't on the canvas
    Since 2026-10-11 a Pi brain is not drawn, but its board kept its saved cell (A-3 in the shop's layout) in the occupancy,
    the duct router's obstacles, the drag check and the extent: an invisible square the canvas still behaved around. One
    rule (isHiddenBoard) now decides it, and everything that treats a board as standing somewhere reads placedBoardCells().
    The cell itself is kept, so a gate that names the brain by mistake still shows it where it was.
2026-10-18 Docs audit: one current source per topic, history archived, CLAUDE.md split by directory and kept small by a check
    - Archived to docs/archive/ (each with a banner, and an index): firmware/WIRING.md, REQUIREMENTS.md, the tool-sensing
    and shop-schema RFCs, the architecture RFC, topology-schema.md (it called itself the source of truth; the validators
    are), the UI and plug-discovery designs, the calibration spec, node-vs-brain, five built plans, the cleanup audit,
    the 2026-09-08 review (its 12 open findings moved into TODO.md, re-checked) and tools/provision.html. Deleted
    .pr-body.md. Eleven mockups for shipped screens moved to docs/mockups/archived/. Every reference rewritten.
    - Current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
2026-10-18 BOM: the KEMET C320 0.1 uF has 2.54 mm lead spacing, not 5.08
    Read off KEMET's datasheet (GoldMax 300 X7R, C1050, 2025-08-05): the C320 style is 0.100 in
    (2.54 mm) lead spacing with a 5.08 x 3.18 mm maximum body. Section 1 said "radial 5.08 mm", and the
    board was being laid out to match, which the part would not have fitted. 5.08 mm is the C322. Row 15
    and section 1 now say so; a footprint with holes at both spacings takes either part.
2026-10-18 BOM: a 2.1 mm barrel jack has a 2.0 mm pin - the PJ-063AH is right, and so are its siblings
    The traps list said the PJ-002AH and PJ-102AH were wrong because they are "2.0 mm" and the
    adapter is 2.1 mm. Jack datasheets give the PIN, and the pin has to be smaller than the plug's
    2.1 mm hole: the PJ-063AH is itself a 2.0 mm pin (Same Sky datasheet, 2025-09-30), and KiCad's
    PJ-102AH footprint cites Adafruit's 2.1 mm jack. All three take our adapters; they differ in
    current (8 A, 5 A, less). The real mismatch is a 2.5 mm pin. Rows 7 and the two-builds table
    now say so, and row 7 gives the pinout (1 centre, 2 sleeve, MS legs mechanical).
2026-10-18 Bench 2026-10-18: the slider homes and sweeps through the Pi after an endstop rewire, and Try again re-homes it
    README's hardware list records both. The Try again test moves to DONE.md; the slider bench entry is
    down to the one-second button hold, deferred until a slider board has a button. Two bench items that
    had already run (the slider through the native brain, the beam seeing FULL) are dropped.
2026-10-18 Plugs known by MAC on both brains; drift between the brains guarded; ESP32 brain frozen
    A plug is identified by its MAC, not just its lease. control/OutletRelocate.h's PlugRelocator is the
    one policy both brains run: a plug with a MAC on file is checked before it is polled or claimed, a
    plug paired without one gets it recorded (Shelly too, via Shelly.GetDeviceInfo), a different plug at
    a saved address is never read or claimed as that tool (problem: plug-replaced), and a lost plug is
    found again by MAC or, with no MAC, by elimination within its own kind. The app agrees through the
    shared plug-identity.js (matched with test_relocate.cpp's S block): the canvas tray and the Plugs
    page show a rep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
2026-10-20 Fail closed, pieces 1 and 2: a shop setting for the delay, and a node that closes its gates without its brain (D-85)
    The layout's failsafe.closeAfterMs (default 30 s, 10 s to 10 min, Settings: "If a board loses the
    brain") rides each board's CONFIG with the resolved close command for every gate on it, so the node
    still interprets nothing. A node that hears nothing from its brain for that long closes its gates
    once; a link back sooner moves nothing; an unhomed slider is left where it is. Bounds and default are
    a new JS/C++ pair (nodelink.js <-> NodeLink.h, constant-pairs.json), with matched tests F1-F13 and the
    timer's own tests in test_nodebus.cpp, and the runtime test that each node is sent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
2026-10-20 Fail closed, piece 3: the brain routes around a board that has lost its link (D-85)
    From the moment a link drops, that board's gates no longer count as gates the brain can see open,
    and they are believed closed kPongTimeoutMs before the node closes them, so the brain never trusts
    a gate already shut. A running or wanted blower with no visible gate gets one opened on a live board
    (toward the first machine wholly on linked boards); the last visible gate of a running system is
    never closed under it; a failed make no longer holds the blower off when a visible gate is open;
    nothing starts into a sealed system and a running blower with no open gate stops. A board that comes
    back has its gates sent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
2026-10-20 The 12 V pilot lamp and red strobe come out: the shop light on the board pixel replaces them
    D-86 puts a full bin, running suction and "needs a person" on a light chained off the collector
    board's pixel, which two lamps on the Banner's 12 V could not show. So nothing but the Banner lands
    on the collector's terminal any more.
    - BOM: row 28 is a 3-way MKDS 1,5/3 (Banner brown, black, blue); the two lamp rows are gone, the
    input-protection notes stop citing lamp leads, and the lamps are listed under "Deliberately NOT
    on this list" with the reason.
    - carrier-wiring.html: the bin close-up draws a 3-way terminal and no lamps; its paragraph and
    part table follow.
    Docs only. Nothing here has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
2026-10-20 Fail closed, pieces 4 and 5: the collector stops when the brain is gone, and the problem says what happens (D-85)
    The collector's board, when its transmitter and the blower's clamp are both on it, is sent a stop
    in CONFIG.failsafe. When its timer fires it presses the remote off if the clamp says the blower
    runs, re-checks after the brain's own off-press cooldown and tries up to the brain's attempt limit
    (control/FailsafeStop.h), and never presses without a clamp reading, because a press is a toggle.
    A plug-switched collector's ON now carries a 60 s dead-man (Shelly toggle_after), renewed every
    20 s by the native poller, so a dead brain leaves a plug that switches the blower off by itself.
    bo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
2026-10-20 The Banner gets its own fuse, F2, between F1's output and its 12 V lead
    The Banner's lead is the one that leaves the board and runs into the collector, the likeliest to
    be pinched. On F1 alone a short there takes the whole board down; behind F2 (Bourns MF-RHT050,
    0.5 A hold, against ~35 mA of Banner and opto LED) it trips F2 and the board stays up to say so.
    - BOM: new row 35 (appended, so no row renumbers) and a line in section 4. Rating and stock not
    looked up.
    - carrier-wiring.html: the bin close-up draws F2 above the Banner's 12 V node, labelled "12 V after
    F1", with a note and a part-table row; "recommended" on the perfboard tab.
2026-10-20 Status lights (D-86): every board shows the suction and a full bin, and an optional shop light shows the collector
    ALERT now carries bin, suction and an optional shop light (pixel count and a colour and blink the
    brain resolved), matched JS/C++ with a new bound pair (MAX_SHOP_PIXELS / kMaxShopPixels, also in
    topology.js). TopologyRuntime::boardLight() decides: a full bin on a system the board serves (red
    blinking on every such board), suction when one of its gates is open and its collector runs (the
    collector's own board when its blower runs), and the shop light: red blinking for a full bin, amber
    blinking when the shop needs a person, green while a collector it serves runs, off otherwise. T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
2026-10-20 The Shelly dead-man renews: a repeated toggle_after restarts the countdown (tried on a Plug US Gen4)
    Recorded in OutletTimeouts.h and TODO; the merge blocker is cleared. Still to bench: a node unplugged
    mid-cut, and the brain stopped with the collector running.
2026-10-20 No WiFi is blue blinking, not orange: one category per pixel colour (D-86)
    Red needs a person (a fault pulses, a full bin blinks), orange is busy and will pass (starting up, a
    gate moving), blue is cut off from the shop (solid: no brain, blinking: no WiFi), green has the
    suction, dim white is idle. No WiFi used to be orange like motion; red would have lit every board on
    a router reboot and diluted the bin alarm. The register entry and StatusLed.h's colour key say so.
2026-10-20 The screen says what the lights mean: BIN FULL, NO BRAIN with its close countdown, SUCTION, READY (D-86)
    A node's screen now reads BIN FULL ("Empty the dust bin", the band blinking), NO BRAIN ("WiFi ok,
    brain silent", "gates close in Ns" then "gates closed", and on the collector's board what it did
    about the blower), SUCTION ("gate open", "collector running") and READY ("waiting for a tool"),
    replacing UNLINKED / LINKED and "servos held", which fail closed made untrue. A fault and then a full
    bin now outrank a moving gate on both the pixel and the screen. test_statusscreen.cpp covers each.
    Compiled and host-tested only.
2026-10-20 Every board drives a 16-pixel shop light, always; no per-board setting (D-86)
    jeff: assume a 16-LED strip on every board and drive it at all times. On a board with no strip the
    data clocks into nothing, and a shorter strip passes the rest off its end, so the layout's
    controllers[].shopLight, its validation, the bound pair and the planned Boards-page control are gone.
    ALERT always carries the shop light's colour and blink; the brain decides it for every board. The
    chain is written only when a colour changes (and once a second), since 17 pixels take about half a
    millisecond to clock out.
    Every board's pixel now goes through the new chain writer, which has never driven a real LED: flash
    one bo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
2026-10-20 A node's frame document holds the largest CONFIG, and a frame that does not fit is logged
    The fail-closed plan made the collector board's CONFIG too big for the node's 1024-byte parse
    document: it failed to parse and was dropped with no ACK and nothing logged, leaving the board
    without its sensors (bench, 2026-10-20 — the brain re-sent "CONFIG (again, no ACK)"). Now
    kNodeFrameDoc (3072, on the heap), a log line for any frame that cannot be read, and a host test
    that builds the largest CONFIG and ALERT and fails if they do not fit (it fails at the old 1024).
    Also, for the shop light that stayed dark on the bench: the board serves /api/light (what its lights
    were told, and what the chain wr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
2026-10-20 The ring is 12 RGBW pixels; the collector plug's dead-man ends before the gates close
    The shop light is an Adafruit 2851: 12 RGBW pixels, four bytes each. Sent RGB data for 16, each
    pixel's bytes landed shifted into the next, and the bench saw a ring of steady random colours. It is
    now driven as 12 x G,R,B,W with white off, after the board pixel's three bytes.
    The plug's off-timer was a fixed 60 s against the gates' 30 s default: up to 30 s of a blower
    against gates already closed. It now follows the layout's gate delay (outletDeadmanSec: 10 s less,
    never under 5 s; 20 s by default), renewed three times a period, and test_failsafestop.cpp asserts
    the blower stops before any gate can close a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
2026-10-22 Lights blink only while the collector runs, and hold solid while it is idle (D-86)
    jeff, 2026-10-22: a ring blinking all evening at a shop with nobody in it would drive anyone mad.
    The shop light's red (full bin) and amber (needs a person) now blink only while a collector the board
    serves runs, and hold solid otherwise; the board pixels' full-bin red follows the same flag, so the
    whole shop blinks together and only while someone is working. A full bin stays solid red while
    idle. Tests L6-L10.
2026-10-22 Boards: Update all, one board at a time; the shop light seen working on a real ring
    Update all (shown when a linked board runs older firmware than the brain has staged) runs each
    row's update in turn: it starts one, waits for that board to come back linked on the new firmware
    (or to fail, or 4 minutes), then the next, with "Stop after this one" and a closing note naming
    any board not updated (details to the console). Tried in the demo against its simulated update.
    The single-board update's words no longer promise half a minute of held gates (fail closed).
    README: the cyclone node's pixel and its 12-LED RGBW ring ran through the new chain writer on
    2026-10-22, showing the brain's solid amber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
2026-10-29 BOM row 16: the 3V3 10 uF is a KEMET C322C106K3R5TA, a non-polarized ceramic
    Row 16 said only "10 uF radial X7R, >=25 V; check its body against the footprint", so there was no
    footprint to choose. It is now the GoldMax 300 part from the same family as row 15's 0.1 uF, in the
    C322 style: KEMET's datasheet puts 10 uF at a 4.07 mm-thick body, too wide for the C320's 2.54 mm
    pitch, and the C322 is the same body on 5.08 mm leads. Stock and price are not confirmed.
2026-10-29 BOM and wiring page for the V1 PCB, in the board's own designators
    The PCB column now describes V1 as laid out, and both tabs of the wiring page
    use its reference designators, so a part on the page is the part on the board
    (the CT jack is J2, the main fuse F2, the Banner's fuse F1, the 4N35 U2 ...).
    BOM order list: rows keep their numbers; new rows 36-42 for what V1 adds -
    the DROK as the PCB's servo buck too (the Pololu, row 6, becomes the
    alternative on the same wire pads), the Qwiic socket, the shop light's XH
    3-pin, optional XH 2-pin sockets for panel buttons, a 100 uF on the 12 V
    input, a GND test loop and a 2-pin header for D3. J1 is a 4-way terminal so
    the Banner's unused white lead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
2026-10-29 No carrier tag: a board senses its CT and OLED, assumes the ring, and the bin is a setting in the app
    The TODO item recommended a 24C02 or DS2431 on the carrier for its identity.
    Jeff, 2026-10-29: not needed - what a board has is sensed or assumed, and the
    one undetected part, the Banner bin sensor, stays configurable in the app.
    Stage 1 (capabilities as a runtime struct) is still open.
